Adampaleski/AmperaBattery/README.md

# Ampera BICM — Teensy 4.1

Clean restart for **Chevy Volt / Opel Ampera Gen1** BICM bench work on a **24S (4×6S)** pack.

Based on [Tom-evnut/AmperaBattery](https://github.com/Tom-evnut/AmperaBattery) documentation and lessons from prior Teensy 4.1 ports.

## Hardware

| Signal | Connection |
|---|---|
| BICM CAN | Teensy 4.1 **CAN3** — pin 30 RX, pin 31 TX @ 125 kbps |
| BICM transceiver | 3.3V SN65HVD230 (or TJA1051 / MCP2562) |
| Pack bus | K16 **X2**: pin 10 GND, 11 CAN_L, 12 CAN_H |
| Elcon CAN | Teensy 4.1 **CAN2** — pin 0 RX, pin 1 TX @ 250 kbps (29-bit) |
| Elcon transceiver | **Second** SN65HVD230 (required; CAN1 22/23 collides with OUT5/OUT6) |
| Kelly KLS8080 NPS | **Same CAN2** @ 250 kbit — IDs `0x0CF11E05` / `0x0CF11F05` (RX; see docs/KELLY_CAN.md) |
| Hub UART (ESP32) | **Serial4** pin 17 TX / 16 RX — not pins 0/1 |
| Contactors | OUT1/pin11 = main+, OUT2/pin12 = Volt AEV14012 precharge, OUT4/pin21 = main− (FET gates) |
| Termination | 120 Ω at one end of each bus |

Do **not** connect pack 5V (X2 pin 9) to Teensy I/O.

## Build / flash

```bash
cd ~/Documents/PlatformIO/Projects/ampera-bicm-teensy41
pio run -e teensy41_sniffer
pio run -e teensy41_sniffer -t upload
pio device monitor -b 115200
```

BMS build: the old `teensy41_bms` env was deleted (chief review #1: it closed Main+ on a blind precharge timer).
Vehicle builds are `teensy41_dual_a` / `teensy41_dual_b` (telemetry-only by default; every output off).

## Serial commands

| Key | Action |
|-----|---|
| `c` | Toggle candump (every frame: `ms,id,dlc,bytes...`) |
| `s` | Print CAN ID histogram |
| `r` | Reset sniffer counters |
| `k` | Toggle keep-alive TX (`0x200` @ 1 Hz) |
| `d` | Print decoded module/cell voltages |
| `b` | Print would-be balance `0x300`/`0x310` |
| `e` | Toggle dead-man (starts/aborts contactor sequence; dry-run when flag=0) |
| `p` | Print contactor state + intended vs driven pins |
| `g` | Toggle charge request (prints would-be Elcon `0x1806E5F4`) |
| `y` | Kelly CAN2 RX status (frame counts + raw; unpack FLAG=0) |
| `j` | Print one STATUS_SCHEMA v1 JSON frame on USB (Serial4 also emits ~1 Hz) |
| `h` / `?` | Key summary page |

Hub link: **Serial4** emits STATUS_SCHEMA v1 JSON @ 115200 (~1 Hz) for the teryx-ev-hub ESP32 gateway. USB stays quiet except boot note and optional `j`.

## Saturday bench (36S)

See **[`docs/BENCH.md`](docs/BENCH.md)** — flash `teensy41_k112_36s`, wiring minimum, expected caps, `b`/`e`/`p`/`g` print-only, Serial4 hub JSON. Do not flip capability flags (still 0).

## Bench validation

With BICMs powered on X2:

1. Flash `teensy41_sniffer`, open monitor — expect JSON lines with `last_rx_age_ms` &lt; 500 within a few seconds.
2. Press `S` — expect IDs in `0x460–0x47F`, `0x470–0x47F`, `0x7E0–0x7EF`.
3. Press `K` to turn keep-alive **OFF** — traffic should stop within a few seconds; `K` again to restore.
4. Press `d` — expect `modules=4 cells=24 stable=Y` after ~3 s of good traffic.

Scripts: `scripts/monitor.sh`, `scripts/bench_checklist.md`.

## Reference

- [`docs/Volt_BMS.dbc`](docs/Volt_BMS.dbc) — cell/temp scaling
- [`docs/WIRING.md`](docs/WIRING.md) — CAN2 Elcon 250k + contactor FET map
- [`docs/SAFETY.md`](docs/SAFETY.md) — capability flags stay 0
- [`docs/KELLY_CAN.md`](docs/KELLY_CAN.md) — KLS8080 NPS on shared CAN2 (not serial)
- Upstream wiring: AmperaBattery README (K16 X1 = 500k BECM, X2 = 125k BICM)

## Vehicle hub / install docs

Tablet PWA, install wiring, and status schema v1 live in a separate repo: [`Adampaleski/teryx-ev-hub`](https://github.com/Adampaleski/teryx-ev-hub) (not merged into this firmware tree).

## Factory-bus build and assumptions

- **[`docs/FACTORY_BUS.md`](docs/FACTORY_BUS.md)**: the `teensy41_factory_bus` env, its map and flags, the LOW-LIVE diagnostic, the hub JSON additions and the bench checklist (watchdog stall, temp warm-brick, Elcon 1 A test).
- **[`docs/ASSUMPTIONS.md`](docs/ASSUMPTIONS.md)**: everything assumed so far (Elcon range, M2 = 12S, temps unverified, 2 s watchdog, 3 s stale, 4.10/4.12 V, balance map unverified).
