Adampaleski/AmperaBattery/BACKLOG.md

# Backlog

## Path to first drive (crew review 2026-10-22) — the ONLY CRITICAL items; everything else is LATER
Tag `[CRITICAL sN]` = CRITICAL, checklist section N (0 gates, 2 shop, 3 buy, 4 firmware/design, 5 bench). Chief: trim CRITICAL to ≈20 that truly block first drive. Moved to LATER: brake-to-wake, phone-key lock, synthetic neutral, Snow/Mud/Sand modes, proportional (analog) regen.
- [ ] [CRITICAL s0] Gate 0 — 12 V bench (chief): flash on 12 V only; link fault < 200 ms; Kelly config readback: Boost OFF, High Pedal Disable ON, Foot_SW + 3-gear (F/N/R) behaviour, OV cutoff ≈160 V (PROPOSED value, read back and record).
- [ ] [CRITICAL s0] Gate 1 — sensors (chief): BICM cells within 10 mV of a meter; temp / ID mapping; LEM zero at 2.5 V + dead-LEM detect; pedal tracks; park contacts; e-stop NC2; brake override; clamp kill-A / kill-B test with the Kid (Low) cap engaging when unpowered.
- [ ] [CRITICAL s0] Gate 2 — one string, wheels up (chief): precharge to 95 %; e-stop; weld check; precharge timeout; turn the safety flags on one at a time. First HV power-up one string at a time (Sparky). Wheels-up bench tests on 1 string with Kelly #11 Battery_Current at 25 % of 550 A (≈138 A, ≈3C on one ~45 Ah string) — DECIDED (chief 2026-10-23; % re-based to the 550 A KLS8080 NPS by Sparky 2026-10-23, was 22 % of 600 A).
- [ ] [CRITICAL s0] Gate 3 — strings (chief): add strings one at a time; each string must be within 0.5 V of the bus before its fuse goes in (DECIDED chief 2026-10-23, supersedes the earlier 1 V figure). 2 strings for first drive, strings 3 and 4 one at a time after Gate 4; spin; regen direction; coolant flow; fan at 40 °C; 12 V alarm; HV leak detection.
- [ ] [CRITICAL s0] Gate 4 — first drive (chief): on 2 strings with Kelly #11 Battery_Current at 49 % of 550 A (≈270 A) — DECIDED (chief 2026-10-23; % re-based by Sparky 2026-10-23, was 45 % of 600 A); Kid / Low mode, 10 mph, flat ground, spotter. Then add strings 3 and 4 one at a time (0.5 V rule).
- [ ] [CRITICAL s3] Mechanic shop order 1: 1/0 HV leads + crimper (needs Adam OK, never buy).
- [ ] [CRITICAL s3] Mechanic shop order 2: bus bar + insulated standoffs + tool-to-remove cover with captive screws; 4 A6T200 bolt direct (no fuse holders), all reachable from one side; any holder at pack voltage > 160 VDC (needs Adam OK).
- [ ] [CRITICAL s3] Mechanic shop order 3: EV200 mounts + HV component plate (needs Adam OK).
- [ ] [CRITICAL s3] Mechanic shop order 4: e-stop parts: Harmony XB4/XB5 40 mm twist-release head (XB4BS8442 includes 1 NC) + 2 extra Schneider ZBE102 NC blocks + IP65 guarded box (needs Adam OK). Block 1 SOURCED/OK; block 2 pending KSI draw.
- [ ] [CRITICAL s3] Mechanic shop order 5: Kelly coolant loop + fan relay (needs Adam OK).
- [ ] [CRITICAL s3] Mechanic shop order 6: chain guard + tensioner (needs Adam OK).
- [ ] [CRITICAL s3] Mechanic shop order 7: pack tie-downs, grommets / loom, ground straps (needs Adam OK).
- [ ] [CRITICAL s3] Mechanic shop order 8: sealed Teensy enclosure + Hall pedal bracket (needs Adam OK).
- [ ] [CRITICAL s2] Measure before ordering (Adam): 1/0 lead run lengths (string → A6T200 on the bus bar → EV200 → Kelly), bus bar span + stud size, EV200 / HV plate footprint, chain line + guard clearance, tie-down points, grommet hole diameters, ground-strap runs, Teensy enclosure size, Hall pedal mounting / travel. List per Mechanic's hardware; dimensions UNVERIFIED until measured.
- [ ] [CRITICAL s4] Branch fuses (Sparky): DC-DC branch fuse 15–20 A; Elcon output fuse 1.25 × max charger current, ≥ 250 VDC rated.
- [ ] [CRITICAL s4] LEM zero offset (Sparky): store the zero-current offset; fault if the reading is > 5 A off at zero current. Zero stored by `Z` (Settings); > 5 A check = LemHealth ZERO self-test (logic done 2026-10-22, not wired).
- [ ] [CRITICAL s4] HV leak / isolation detection (Sparky): add before Gate 3.
- [ ] [CRITICAL s3] Insulated wrench for pulling the string fuses (crew 2026-10-22; needs Adam OK).
- [ ] [CRITICAL s4] E-stop latch (crew 2026-10-22): when block 3 (NC to Teensy B) reports open, drop every coil driver and latch until a key-cycle reset; releasing never closes anything. Logic + test done (include/EstopLatch.h, scripts/test_estop_latch.cpp 7/7); wire into the coil gate when BMS_CAP_CONTACTOR_DRV is enabled, then bench: press, release, unplug block 3 wire. Adam meters Kelly KSI draw (expected < 0.2 A).
- [ ] [CRITICAL s3] Insulated boots / covers on every HV terminal (Sparky): the string side of each A6T200 stays LIVE with the fuses pulled.

- [ ] [CRITICAL s2] Wire S42/S43 KEY-ON -> A:34 / B:34 (opto, 10k pull-up, LOW = key on; PROPOSED, Sparky 2026-10-22) and S41/S44 plug-in detect -> A:33 / B:33 from the ONE shared LM339 (see the next lines; LM339 DECIDED chief 06:57 #1). Key source = stock key switch output (colour UNVERIFIED). Bench: idle 3.3 V, active <0.4 V.
- [ ] [CRITICAL s2] Backprobe the stock Teryx key switch switched output (S42/S43 source, fed from the TDC-JH 12 V bus): 0 V key off, 12 V key on; record the wire colour (UNVERIFIED) in PINMAP. Fuse it with its own 1 A fuse (Sparky 2026-10-22) before tapping it to the optos.
- [ ] [CRITICAL s2] Wire the plug-in + release detect with ONE LM339 for both boards (Adam t284; LM339 re-pin DECIDED chief + Sparky 2026-10-23 06:57; wiring page "Charge plug-in + release detect"): NACS inlet proximity (S45; ~150 Ω latched or ~480 Ω button pressed = plugged, open = not plugged) -> one network: 330 Ω pull-up to the shared 5 V and 2.7k to GND -> one 10k/20k divider (S46) -> IN+ of all four channels (pins 5, 7, 9, 11). Plug: 2.5 V reference to IN1−/IN2− (pins 4 and 6, S48); OUT1 (pin 2) -> A:33 with its own 10k pull-up to A 3.3 V (S41); OUT2 (pin 1) -> B:33 with its own 10k pull-up to B 3.3 V (S44). Release: 1.40 V reference (10k/3.9k, S53) to IN3−/IN4− (pins 8 and 10); OUT3 (pin 14) -> 1k -> A:2 (S51), OUT4 (pin 13) -> 1k -> B:35 (S52), each with its own 10k pull-up + 100 nF. LM339 VCC (pin 3) from the shared 5 V (S47), GND (pin 12) to the single-point ground (S49). No hysteresis resistors: 100 nF + 20 ms debounce (DECIDED Sparky 06:57 #3). Plugged = A:33 and B:33 LOW = drive blocked on BOTH boards, like park; plugged but not latched = stop charger over CAN + open AC contactor. Firmware: set A:2 INPUT (boots as output) — later commit, no flashing.
- [ ] [CRITICAL s3] BUY — pending purchase approval (Adam), NOT owned: 1x LM339 + the network parts for ONE plug + release detect circuit: 330 Ω, 2.7k, 10k + 20k divider, 2.5 V reference (10k/10k), 1.40 V reference (10k/3.9k), 4x 10k output pull-ups, 2x 1k release series, 100 nF decoupling + 4x 100 nF at A:33/B:33/A:2/B:35. No hysteresis resistor (DECIDED Sparky 06:57 #3). Nothing is bought without Adam's OK.
- [ ] [CRITICAL s2] Bench: plug and unplug the NACS connector (latched and button pressed) and confirm drive is blocked on BOTH boards; then an open-wire test on the proximity line.
- [ ] [CRITICAL s2] Mechanic: mount the 50 Ω/100 W precharge resistor (H08) on the HV panel aluminum backplate with thermal paste, away from the loom.
- [ ] [CRITICAL s4] Firmware: read KEY-ON (A:34/B:34) and plug-in (A:33/B:33) into BmsCore wake/plugIn (plugged = no drive on both boards, like park), replacing the serial `e` dead-man (chief #4). Pins only in PINMAP so far.
- [ ] [CRITICAL s4] Precharge + weld check via Kelly CAN B+ (room DECIDED 2026-10-23: chief + Sparky + crew; replaces the isolated HV_SENSE on A:24, AMC1311 DROPPED for now; docs only, firmware NOT changed in Build 18): bus side = Kelly CAN B+, pack side = BICM cell sum. (a) Close Main+ only when Kelly B+ >= 95% of the BICM sum AND the minimum precharge time has passed; time alone never closes it. (b) A stale (>200 ms) or missing Kelly frame = precharge FAIL: mains open, fault. (c) Sequence (chief DECIDED 2026-10-23; KSI open item RESOLVED: e-stop block 2 only passes power, the Teensy drives the precharge coil separately, so KSI comes on first): 1) key on, KSI on; 2) a fresh Kelly B+ frame reads ~0 V (else Main+ welded); 3) close Main- alone, B+ still ~0 V (else Main+ welded); 4) precharge; 5) close Main+ only when B+ >= 95% of the BICM sum AND the minimum time has passed (a Main- weld shows up when Main+ closes). Second layer: key-off check (open Main+, hold KSI ~3 s; B+ still tracking the BICM sum = welded). Firmware TODO (needs chief + Sparky + Mechanic): PrechargeGate already has the 95% + min-time rule, but its bus input is HV_SENSE (HV_ANALOG_ENABLE=0 -> always FAIL today); it must take Kelly B+ with the 200 ms staleness rule. All UNVERIFIED until the bench gate below.
- [ ] [CRITICAL s4] Kelly B+ bench gate (room DECIDED 2026-10-23, all UNVERIFIED): (1) B+ is reported within ~1 s of KSI even while the Kelly low-voltage error is active; (2) frames arrive at least every 100 ms; (3) B+ within ~2% of a meter across a 0-150 V precharge ramp; (4) B+ reads ~0 with the mains open, not a held stale value. (5) the Kelly boots and sends frames on 12 V KSI with HV absent. If ANY check fails, the isolated sensor comes back: AMC1311EVM (~$50, purchase needs Adam OK). A:24 = reserved spare until then. Isolation monitoring stays its own separate CRITICAL item.
- [ ] [CRITICAL s4] Contactor coil gate-drive bench gate (crew 2026-10-23, UNVERIFIED): each contactor coil — AEV14012 precharge, EV200 main+ and EV200 main− — must pull in fully when its IRLB8721 low-side FET is driven straight from a Teensy 3.3 V pin (the IRLB8721 datasheet only rates RDS(on) at VGS 4.5 V and above). Measure coil voltage / FET drop at pull-in on 12 V. If any coil fails to pull in fully, add a gate driver or logic-level FET rated at 2.5-3.3 V (PROPOSED, no purchase without Adam's OK). IRLB8721 count owned: UNVERIFIED until Adam answers.
- [ ] [CRITICAL s2] Kelly programming check (Adam): controller model SOURCED (Adam 2026-10-23) from his purchase email = KLS8080 NPS, 168 V, 550 A, all add-ons incl. high-speed and anti-slip — no Kelly nameplate photo needed (closes chief review gap 9; Sparky re-based #7/#10/#11). READ back and confirm before writing: #60 sensor type = 4 sin/cos (motor sensor sin/cos SOURCED; setting UNVERIFIED), #7, #10, #11. Motor nameplate still OPEN for Adam: pole count (#59) and thermistor type (#63).
- [ ] [CRITICAL s5] Manual megger / insulation check HV-to-chassis on every string before its first HV power-up (chief full review gap 8): the insulation tester is not chosen; this is the minimum until isolation monitoring is fitted.
- [ ] [CRITICAL s4] Plug detect second source (chief full review gap 11): Elcon charger CAN status alive = drive blocked, so one LM339 losing 5 V (reads "unplugged") can't allow a drive-away. No new parts.
- [ ] [CRITICAL s4] Design the K02 Foot_SW "both Teensys alive" relay (chief full review gap 13): Kelly pin 11 is 40 mA max, so the series heartbeat contacts need a relay/driver; e-stop block 3 pin (B:9) is PROPOSED only.
- [ ] [CRITICAL s4] Written safety-flag flip order (chief full review gap 19): one flag at a time (CONTACTOR_DRV, KELLY_LIMIT_DRV, KELLY_RX, TEMPS_VERIFIED, CURRENT_SENSE …), each with its own bench test + key-cycle test, before TELEMETRY_ONLY goes to 0.

## CRITICAL: chief firmware review cd7027f (2026-10-22) — TODO, NOT implemented in this task
Source: /workspace/teryx/review/firmware_review_chief.md (the review lists 10 CRITICAL items; the request said 9, all are carried here).
- [x] [CRITICAL s0] Chief review #1: ContactorSeq.cpp:367 single-string env with HV_ANALOG_ENABLE=0 closes Main+ on a blind 5 s precharge timer: must fault; fence/delete `teensy41_bms` env. (env DELETED 2026-10-22; ContactorSeq.cpp:367 timer-close path still to make a fault.) DONE 2026-10-22: timer path removed; include/PrechargeGate.h (bus >= 95% of valid pack after 200 ms, else fail at 5 s -> RetryWait 30 s, 2 retries, Lockout); scripts/test_precharge_gate.cpp.
- [x] [CRITICAL s0] Chief review #2: ContactorSeq.cpp:226 + Settings.cpp:170/165: serial `U` / `I` sim inputs feed the real precharge gate / force currentValid; compile out when TELEMETRY_ONLY=0. (DONE 2026-10-22: BENCH_SIM_INPUTS=0 default, bench_30s/2x30s only, #error with TELEMETRY_ONLY=0; scripts/test_review_fixes.py.)
- [ ] [CRITICAL s0] Chief review #3: ContactorSeq.cpp:288-312: lemA/lemB/valid never set; BmsCore.h:186-189 defaults valid=true, so dead-LEM, >60 A disagree and 400 A per-sensor trip can never fire. Default valid=false. PARTLY DONE 2026-10-22 7 PM: BmsCore Inputs lemAValid/lemBValid now default false; ContactorSeq sets lemAValid/lemBValid/lemSplitValid=false explicitly (fail closed: with CURRENT_SENSE_ENABLE=1 the Low cap holds until real per-LEM health is wired); 3 checks in scripts/test_review_fixes.py. Still open: feed LemHealth per Teensy + LEM B over the link so the checks can actually fire.
- [ ] [CRITICAL s0] Chief review #4: ContactorSeq.cpp:302: key-on is serial `e` only; no KSI, e-stop NC2, park or plug-in input fed to BmsCore.
- [ ] [CRITICAL s0] Chief review #5: EstopLatch.h not called anywhere in src/.
- [ ] [CRITICAL s0] Chief review #6: Brake-overrides-throttle >0.5 s not in firmware (sim only).
- [ ] [CRITICAL s0] Chief review #7: KellyLink.h / LemHealth.h not wired (BMS_CAP_KELLY_RX 0); non-Kid modes uncapped when speed lost.
- [ ] [CRITICAL s0] Chief review #8: TEMPS_VERIFIED=0: drive has no overtemp, derate or TEMP-STALE. Verify temps, set 1 before first HV drive.
- [ ] [CRITICAL s0] Chief review #9: ThrottleTrim.cpp:76 + Config.h:213: raw ADC/1023 pedal, no travel calibration, half-scale track 2 would trip DISAGREE, no open/short detect, 4.5 V reads ~88 %.
- [ ] [CRITICAL s0] Chief review #10: ThrottleTrim.cpp:5-6: MCP4131 digipot powers up at mid-scale (50 %) until begin(), and coil gate pins float from reset until setup() (main.cpp:233-240): the 74HC4066 clamp + 100k Kelly pull-down (Gate 1) and the 10k gate pull-downs on pins 11/12/21 + pin 20 relay driver (Gate 0) MUST be bench-proven.
- [ ] Chief review should-fix (before flags go to 1): ADC re-entrancy (ThrottleTrim ISR vs CurrentSense loop analogRead); ThrottleCross 5 %/50 ms vs agreed 10 %/100 ms; `MX` clears latched throttle fault without key cycle; corrupt DriveStore drops out of Kid / loses PIN (fail to Kid/Low); no 12 V low alarm; tickDual skips enter() (partial bench logs); pin 4 = B_FAULT_OUT on B and A_THR_ALIVE on A (stated in docs/PINMAP.md); commit the BMS-settings edits (done, Build 10) — THR2 resets saved thresholds on first boot.

## Priority list (standing dev routine)

1. [x] Tesla-style restyle + live Diagram tab in tools/bms_sim.html (034a3ae).
2. [ ] Kelly power/regen cutback wiring design + simulator controls.
   - [x] 2026-10-19 7 PM: Drive tab (allowance, limiter, regen, OUT3/OUT5/OUT6 lines, three cutback curves, sliders), BmsCore kellyWhy/regenWhy, 6 Kelly cutback checks in sim_bms, docs/KELLY_CUTBACK.md.
   - [x] DECISION (Adam, 2026-10-20): hard trip at 650 A for 100 ms or 750 A instantly on LEM A + LEM B, replacing 300 A/500 ms and the 250 A derate. Kelly phase + battery limits 550 A.
   - [x] 2026-10-20 7 AM: trip in BmsCore (overcurrentA 650 / 100 ms, new instantTripA 750, logs `OC instant`); 250 A discharge derate off (maxDischargeA 0). Scenarios: 700 A trips at 110 ms, 800 A spike trips in one 10 ms step (18/18). 6 boundary checks (600 A 3 s, -640 A, 700 A 80 ms, 745 A 90 ms stay closed). Drive tab: current-trip chart with 550/650/750 lines, sliders to 800 A. Sim only; CURRENT_SENSE_ENABLE 0.
   - [x] 2026-10-20 10 AM: derates in BmsCore: LEM imbalance |A − B| > 100 A for 1 s → warn + cap at imbalancePct (50 %, PLACEHOLDER), clears under 100 A; cell sag 3.2 → 3.0 V linear ("cell sag"); heat unchanged (only with valid temps). Inputs lemSplitValid/lemA/lemB, outputs lemImbalance/lemDiffA. 9 derate checks. Drive tab: LEM split slider, what-if low-cut slider, combined low-cell + sag chart, LEM imbalance chart. Sim only.
   - [x] DECISION (Adam, 2026-10-21): cell sag is relative (weak cell vs pack average), whole-pack sag judged against load, only a low hard floor that trips if voltage stays down briefly.
   - [x] 2026-10-21 7 AM (b2ba63c): in BmsCore. Weakest cell 0.15 → 0.40 V below pack average = "cell sag" 100 → 0 % (any load). Under load (|I| > 20 A) a uniform sag skips the low cut; pack-average taper 3.10 → 3.00 V ("pack sag"). Hard floor 3.00 V for 500 ms → CELL-LOW. 3.30 V low cut only at rest, debounced 1 s (no instant fixed cut; no current reading = rest). All PLACEHOLDER in Config. Drive tab: relative-sag chart + pack-sag/rest chart. 12/12 derate checks; cell-low scenario now 1 s. Gist rev b5b0cfe8.
   - [ ] Adam/Sparky: confirm the placeholder numbers (0.15/0.40 V below avg, 3.00 V floor 500 ms, 1 s rest debounce, 20 A rest) against Volt cell data; pick the imbalance cut level (placeholder 50 %).
   - [x] 2026-10-21 10 AM: derate events. BmsCore DerateCode (low cell / pack sag / cell sag / pack hot / LEM imbalance / discharge amps), debounced events (hold 100 ms to log, 1 s full power to clear, reason changes logged; PLACEHOLDER), outputs derateCode/lastDerate/derateMinPct/derateEvents. FaultLog kinds 4/5 (DerateSet value = power %, DerateClear value = lowest %), derates capped 12/boot so faults keep room. Sim: Fault log card shows DERATE rows (amber), Drive tab shows count + last reason. 3 derate-event checks (15/15), 2 FaultLog host checks (12/12), 2 faultlog-page wasm checks (8/8). docs/FAULT_LOG.md. Firmware still doesn't write FaultLog. Commit "derates logged as events", gist rev a505e09a.
   - [x] 2026-10-21 1 PM: thresholds adjustable over serial. include/Thresholds.h: 20 keys (trip, temps, sag, LEM imbalance, derate logging), `T` list / `T<key> <v>` / `T<key> -` / `TX`, bounded, trips + temp cuts tighten-only, order rules, EEPROM 1216 after FaultLog with CRC. Applied in configureCore (role A). Fixed: P80/Z/I never started a settings line. 9 host checks (scripts/test_thresholds.cpp), docs/THRESHOLDS.md. Not bench-tested; sim page unchanged.
   - [x] 2026-10-21 4 PM (62db3e9): Simulator: same threshold table editable in bms_sim.html (wasm), so Adam can try values; dash "last derate" in the fault/trip panel. Settings tab "BMS thresholds" card: all 20 keys with value, default, allowed range, lower-only/raise-only, SET, PLACEHOLDER; type + Enter to apply, per-key Reset, Reset all (TX). Validation is the real include/Thresholds.h in wasm (sim_thr_set -> handleLine), refused edits show the firmware's reason (+ tighten-only note). Applied live into the sim BmsCore like configureCore, saved on simulated EEPROM 1216-1305 + localStorage (survives Reset/Power cycle/reload); warns if L is later moved below floorV. Faults tab + dash Faults & log: derate now, last derate (reason + lowest %), count this boot. 8 thresholds-page wasm checks, 8 UI checks (57/57). Firmware unchanged. Gist rev 036ca1aa.
   - [ ] Temperature limits: use the more conservative of Chevy's or the EV community's numbers (Adam 2026-10-21); ask Sparky.
   - [x] 2026-10-21 7 PM: docs mismatch reconciled. TERYX_MAIN_POWER_PATH.md now says 50 °C start / 55 °C cut (matches BmsCore, KELLY_CUTBACK.md, TEMPS.md; the cut can only be tightened, max 55), both PLACEHOLDER pending the conservative Chevy-vs-community pick; its stale cell-sag line updated to the 2026-10-21 relative-sag design. Docs only; 12/12 envs build, 31/31 scenarios + trip/derate/soc checks pass.
   - [ ] Derate hardware: pick CD4066 vs MCP4131 and RC values; confirm KLS low-speed and regen input pins/polarity from Adam's harness (UNVERIFIED).
3. [ ] State of charge from the split Volt LEM DHAB S/44 pair.
   - [x] 2026-10-19 10 PM: include/SocEstimator.h coulomb counter (LEM A + B sum, + = discharge), full-charge anchor from Core "at charge limit" (P<100 tagged not true 100 %), restore hook, 2 s current-loss -> unknown, low-cut drift flag, learnCapacity(); 10 SoC host checks; docs/SOC.md. No OCV table (none verified).
   - [ ] Bank capacity Ah UNVERIFIED (capAh 0 = unknown): measure with one full -> low-cut run, then learnCapacity().
   - [x] 2026-10-20 1 PM: simulator SoC readout. sim/wasm_api.cpp runs the real BmsCore::Soc on the sim's LEM A + B each 10 ms tick (anchor from Core "at charge limit", 2 s current loss -> unknown, low-cut drift flag). Cluster tab Battery gauge shows the estimate + state (unknown/anchored/counting) + Ah used, "unknown until full-charge anchor" when unanchored, and sim truth vs estimate error. Buttons: Charge to limit (anchor), LEM dropout 3 s; cell drain toggle. Capacity 180 Ah labelled SIM-ASSUMED (real capAh still UNVERIFIED). 8 socpage wasm checks. Firmware unchanged.
   - [ ] Wire into BmsApp + STATUS_SCHEMA socPct (needs CURRENT_SENSE_ENABLE + split-LEM read).
     - [x] 2026-10-23 4 PM: LEM B link frame 0x6A5 (include/LemLink.h, B sends, A decodes fail-closed, `Link::remoteLemB()`), not consumed yet. Next: SocRun uses it (kHaveLemB) and ContactorSeq lemBValid, then bench.
     - [x] 2026-10-23 7 PM: SocRun sums LEM A + LEM B (both valid + fresh or the tick is current-lost, fail closed). Next: ContactorSeq lemBValid from the link, then bench.
   - [x] Persist used Ah + anchor at power-off (ties to item 5). Store DONE 2026-10-23 10 AM; wired into SocRun 2026-10-23 1 PM (see Done notes). Remaining gap: real KEY-ON / 12 V power-loss save (needs A:34 read + a loss detect).
4. [ ] Full drive-cycle mode in the simulator.
   - [x] 2026-10-20 4 PM (10ba99e): Drive cycle card on the Cluster tab. sim/drive_cycles.js profiles (SIM PROFILES, not logged data): Trail loop 125 s, Hard launches 5x, Long climb 10 min. Plays throttle/brake/gear into the existing driver-input model on any tab, auto key-on, stops early if mains open; live step + summary (distance from toy speed model, Wh out/regen, Wh/mi, peak discharge/regen A vs 650/750 trip, lowest cell, lowest power allowed + why, SoC change). 5 drivecycle wasm checks; headless page run of Trail loop completes. Gist rev 0f905bd5.
   - [ ] Next: record a real Teryx drive (Kelly CAN speed/current) as a replayable profile; add a heat/temps-valid profile once temps are verified; cycle results into the dash trip panel.
   - Note: in the Hard launches run regen showed 0 A near full charge (BMS blocks regen near the charge ceiling, expected); trail loop regen hit 60 A.
5. [ ] Fault log that survives power-off.
   - [x] 2026-10-20 7 PM: include/FaultLog.h (header-only, not wired into firmware). 48 x 20-byte records at EEPROM 256..1215 (Settings stays at 0; Teensy 4.1 EEPROM 4284 B per installed core). Seq + CRC-16 per record, no header: torn write skipped, blank = empty. Fault set/clear edges with boot no., uptime ms, one value. Wear limits: same edge max 1/s, 24 records per boot then 'log limit reached'. 10 host checks (scripts/test_fault_log.cpp), ARM compile check. docs/FAULT_LOG.md. Flash endurance UNVERIFIED.
   - [x] 2026-10-20 10 PM: simulator Fault log card on the Faults tab. Real FaultLog.h in wasm on a simulated EEPROM that survives Reset, Power cycle and page reload (localStorage); Power cycle / Pull power mid-write (torn record skipped) / Clear log buttons; records newest first with boot, time, set/clear, value (cell V or amps). 6 faultlog-page wasm checks. Firmware unchanged. be2106d, gist rev 8c570165.
   - [x] 2026-10-21 10 PM: wired into firmware. src/FaultLogRun.{h,cpp} (role A dual only, no-ops elsewhere): EEPROM.read/update store, BmsCore fault + derate edges each loop (same value rules as the sim), `f` prints newest first, `FCLEAR` + Enter erases. No pins touched. 12/12 envs build, 31/31 scenarios, trip 6/6, derate 15/15, soc 10/10, faultlog 12/12, thresholds 9/9. docs/FAULT_LOG.md. Sim page unchanged. NOT bench-tested.
   - [x] 2026-10-22 7 AM: STATUS_SCHEMA fault-log summary. Optional `faultLog` key in every hub frame (FaultLogRun::printJson from HubStatus): available/count/slots/boot/limited/deratesDropped + `last` (kind, name, boot, sec, value, unit) or null; `available:false` off role A. Read-only, no pins, no EEPROM writes. JSON host-checked (empty/fault/derate). docs/FAULT_LOG.md. 12/12 envs, 31/31 scenarios, trip 6/6, derate 15/15, soc 10/10. Sim page unchanged.
   - [ ] Next: add `faultLog` to teryx-ev-hub docs/STATUS_SCHEMA.md + mock + dash card (hub repo, feature branch only); bench power-pull test on a Teensy (Adam, when benching).
6. [ ] Tesla-style dash on the ESP32 hub (teryx-ev-hub, never main).
   - [x] 2026-10-20 (parent chat, 43a7c0c + c76fee2): standalone tools/dash.html + sim/dash.js (Digital/Analog/Minimal/Night, "—" + amber when no source, range/Wh/mi/trip, tell-tales, seat heater buttons, cooling PROPOSED). Simulator-side only; ESP32 hub port still to do.

## Other

- [ ] TODO (current sense sign): DHAB S/44 to be mounted so discharge reads in the −420 A direction, with regen/charge on the +230 A side. Firmware must flip the sign so discharge shows positive. Not done yet; CURRENT_SENSE_ENABLE stays 0. Range unverified until we have the datasheet. If it can't be mounted that way, fall back to a ≥500 A single-range LEM (e.g. HASS 500-S).
- [x] 2026-10-21: charge mode separate from key-on (BmsCore Mode/plugIn/chargerPath/chargeStop, 5 plug scenarios, crew review pending), sim vehicle model (sim/vehicle.js: throttle/brake/grade, wheel speed, motor RPM, brake = regen up to PROPOSED 60 A, fade < ~3 mph), dash charging screen with sleep/wake.
- [ ] Pick a proximity / charger-present input pin and wire `plugIn` in ContactorSeq (crew).
- [ ] (Optional) IVT-S 1000 A integration — dual LEM A + B is the primary sensing; ISA IVT-S is optional only: decide own CAN bus vs reconfigure to 250k; parser + DHAB cross-check (sim scenario 14 models it).
- [ ] Split-LEM firmware: read LEM A on Teensy A and LEM B on Teensy B, sign flip (discharge on −420 A side), share B's reading over the A–B link, port sim lemPair() pair-imbalance and sensor-fault checks into BmsCore. Thresholds (30%, 40 A, 100 A) are placeholders.
- [ ] HV path (2026-10-20, see docs/TERYX_MAIN_POWER_PATH.md): two main contactors, used TE EV200 on pack + and pack −. Volt AEV14012s only on charger/DC-DC/precharge branches.
- [x] String fuses: 4× Mersen A6T200 200 A Class T — FINAL, bought 2026-10-20 (shop log 10/20; docs/TERYX_MAIN_POWER_PATH.md). Supersedes the 10/17 A6T150 proposal.
- [ ] Strings: 36S each, built from 24S + 18S BICM boards (no 30S).

## Safety gaps (crew 2026-10-21) — TODO, NOT BUILT
Pack protection today uses the **BICMs (cell V/temps) and LEMs (pack A) only**. The Kelly CAN is telemetry, not protection.
- [ ] **REQUIRED BEFORE FIRST DRIVE:** charge-plug interlock. No drive while plugged in, and no charging below 0 °C or with stale/unverified temps (TEMPS_VERIFIED=0 today).
- [ ] **REQUIRED BEFORE FIRST DRIVE:** contactor weld check. Bus voltage vs pack with mains commanded open at key-off and before precharge (sim has a welded-contactor toggle; firmware not built).
- [ ] **REQUIRED BEFORE FIRST DRIVE:** isolation monitoring (HV to chassis). Part not chosen.
- [ ] **REQUIRED BEFORE FIRST DRIVE:** 12 V low alarm at 11.5 V (PROPOSED). Needs a 12 V sense divider pin.
- [ ] Service disconnect (crew 2026-10-22, replaces the Volt MSD): **pull all 4 Mersen A6T200 string fuses**. Key off, e-stop pressed, wait for the Kelly caps, remove the tool-only cover (captive screws), pull fuses 1–4 with the insulated wrench, meter bus B+ to B− = 0 V, boot the string-side studs (still LIVE). Volt MSD removed from the current path. **DECIDED (room: Sparky + chief, 2026-10-23 06:11 CT): no MSD in this build.** Fuse location label for the top-down layout view: "reachable from above, tool-only cover".

## Mechanical (Mechanic 2026-10-21) — TODO
- [ ] **REQUIRED BEFORE FIRST DRIVE:** Chain guard + chain tensioner (#50 chain, 16/32T).
- [ ] **REQUIRED BEFORE FIRST DRIVE:** Pack retention / tie-downs (straps/brackets), HV cable clamps, grommets at every pass-through.
- [ ] Enclosure sealing with a breather and a drain.
- [ ] Chassis ground straps: 12 V negative to frame, Kelly case to frame.

## 2026-10-21 park / Kelly / Low cap (this commit, CREW REVIEW)
- [x] Clamp review fixes: A heartbeat pin 4 (not CS), 4066 on shared 5 V, Kelly pull-down 100k + bench curve recheck.
- [x] Park detection: ParkState.h + sim; Foot_SW NC hardware interlock documented (docs/PARK_BRAKE.md).
- [x] Kelly CAN/regen research: docs/KELLY_CAN_ROLES.md; sim analog Brake_AN regen.
- [x] Kelly ECO fail-safe Low cap (OUT3 inverted: HIGH = release); Kid + both-Teensys-dead sim.
- [ ] Next: B → A park contact bit on the link; wire ParkState into ContactorSeq (precharge gate) and Selector (Kid); bench the Foot_SW / ECO behaviour.

- [x] 2026-10-21 crew review of b629bcf: park on direct pin 32 (A needs BODY_IO_EXPANDER), Brake_AN DEFERRED (switch regen default), Low cap only on hard faults with a 1 s ramp, docs/ESTOP.md + wiring aid e-stop page fixed, WIRING.md CAN_LAYOUT_V2 map.
- [ ] Before Brake_AN: read back the Kelly config (Brake Type, Boost OFF, BRK_AD/BRK_SW, Foot Switch, Three Gears/Speed) and save it in docs/.
- [ ] E-stop block 2 (pending): Adam meters the Kelly KSI draw (expected < 0.2 A); block 2 breaks ≈0.35 A AEV14012 + KSI. Block 1 SOURCED/OK (chief 2026-10-22: 0.26 A measured break < 0.5 A @24 V; 7.6 A inrush carried < 10 A Ith).

- [ ] REQUIRED BEFORE FIRST DRIVE: firmware dead-LEM detection. 2026-10-22 1 PM: logic + host test done (include/LemHealth.h, scripts/test_lem_health.cpp 18/18, docs/LEM_HEALTH.md): RAIL (within 0.2 V of 0/Vc or Vc bad, 100 ms), RANGE (>450 A), AGREE (<15 A, ch1 vs ch2 >5 A, 500 ms), ZERO key-on self-test (>5 A), latched until key cycle; all PROPOSED. Not wired (CURRENT_SENSE_ENABLE 0); next: run in CurrentSense::tick per Teensy, B's code over the link, set lemAValid/lemBValid, ZERO before precharge. Original: Read each LEM separately and flag one reading nothing or out of range (>450 A, PROPOSED) as a hard fault that engages the 10 mph cap. Today this check runs only in the sim. (chief, 2026-10-21)
- [ ] Dead-LEM detail (Sparky): each output should sit near 2.5 V at 0 A; within about 0.2 V of 0 V or 5 V = dead or disconnected (hard fault). Key-on self-test: below about 15 A, the low-range and high-range channels must agree.

## VCU safety items (Sparky VCU compare, 2026-10-21)
- [ ] **REQUIRED BEFORE FIRST DRIVE:** two-track pedal. Today ONE pedal wiper is read by both Teensys (A pin 40, B pin 41, same signal through two dividers; docs/THROTTLE_CLAMP.md), so a pedal fault looks identical on both. Fit a dual-output Hall pedal (two independent tracks, e.g. one track ×½): Teensy A reads track 1 and Teensy B reads track 2, each on its own pin (PROPOSED: keep A pin 40 / B pin 41, no shared wiper), with a plausibility check between the tracks (PROPOSED: > 10 % for 100 ms → throttle 0 + fault). Part not chosen.
- [ ] **REQUIRED BEFORE FIRST DRIVE:** brake overrides throttle: brake and throttle both pressed > 0.5 s → throttle cut to 0 until the pedal returns to 0 (PROPOSED). Partly covered: sim brake switch cuts throttle (sim/vehicle.js); Kelly "Brake H-Pedal" option (docs/KELLY_CAN_ROLES.md) is a config check. Firmware Teensy rule not built.
- [x] Precharge timeout — COVERED: dual-string precharge (Config.h kPcDualMinMs 300 / kPcDualTimeoutMs 3000 / ONE fail → PRECHARGE-FAIL lockout until key cycle, no auto retry (chief 2026-10-22; single-string aligned to 300 ms / 3 s); ContactorSeq, BmsCore F_PRECHARGE): main never closes unless the bus ≥ 95 % of the lowest string. Bench-verify on the Kelly (docs/BENCH.md).
- [ ] Direction change only at 0 RPM with the brake on (PROPOSED). Sim refuses R above 1 mph; no firmware rule yet (Kelly F/N/R readback on CAN 0x0CF11F05 b5, docs/KELLY_CAN_ROLES.md).
- [ ] **REQUIRED BEFORE FIRST DRIVE:** Kelly CAN timeout (> 200 ms, PROPOSED) → derate + fault (KELLY-CAN-LOST). Today stale Kelly CAN only makes Park false (include/ParkState.h); BMS_CAP_KELLY_RX=0. 2026-10-22 4 PM: logic + host test done (include/KellyLink.h, scripts/test_kelly_link.cpp 18/18, docs/KELLY_LINK.md): NEVER-SEEN (no frame 2 s after KSI), LOST (either frame > 200 ms stale, not hidden by boot grace), Low cap until both fresh 1 s, latched + loss count, parkTrusted() for ParkState; all PROPOSED. Not wired; next: hook into KellyDecode when BMS_CAP_KELLY_RX=1, FaultLog edges, sim "Kelly CAN unplugged" toggle.
- [x] EV200 coil economizer — COVERED by hardware: EV200HAANA has a built-in economizer + suppression (shop log 2026-10-20 06:31; docs/ESTOP.md hold ≈0.26 A). No extra circuit.
- [ ] **REQUIRED BEFORE FIRST DRIVE:** Kelly/motor cooling. First drive (chief full review 2026-10-23): hardwire the pump to key-switched 12 V and the fan to a thermoswitch or always-on, NO Teensy logic. Firmware cooling control (after first drive, LATER) from Kelly controller + motor temps (Kelly CAN): pump on with key (COOL_PUMP pin 8), radiator fan relay at ~40 °C (RAD_FAN pin 7), PROPOSED pins reserved in Config.h, not built; Kelly derates itself at 90 °C case (SOURCED manual).
- [ ] Brake-to-wake (PROPOSED, sim Build 2): brake held at full travel ≈1 s = key on (replaces a separate On switch); e-stop NC1 and the precharge/park rule still gate it. Needs a brake-position input that works while asleep (pin/part not chosen).
- [ ] Decide: PIN to drive (UNDECIDED; sim option, off by default; uses the Kid PIN hash).
- [ ] Hall pedal spec (Sparky): track 2 at half scale (e.g. 0.5-4.5 V and 0.25-2.25 V). Both tracks go through 10k/18k dividers (4.5 V reads 2.89 V at the pin). Compare the tracks as % of travel, not raw volts.

## Build 4 (Adam's Build 2 testing, 2026-10-22) — sim/dash only, firmware unchanged
- [x] Brake-to-wake feedback: "Hold brake… waking", then "Waking — precharging"; a refusal names the reason (parking brake released / park contact fault). Root cause: every sim toast went to an undefined `dashToast`, so refusals were silent. UI test drags the dash brake slider.
- [x] Kid: entering asks no PIN (parked only); first time with no PIN set, a one-time "Set Kid exit PIN" pad (keeps firmware NO_PIN_SET rule). Leaving Kid = modal PIN pad (digits, ⌫, Cancel, Enter, keyboard, wrong-PIN shake). Old text box removed.
- [ ] Phone-as-key (PROPOSED): no Bluetooth phone key → PIN pad before any drive setting (modes, thresholds, limits); key off → drive settings locked; Night/dim stay unlocked. Sim toggle "Phone key present". Decide: BLE module + pairing, which PIN (sim reuses the Kid PIN hash), firmware mirror.
- [ ] Synthetic neutral: N = Kelly zero throttle + no regen (freewheel), no mechanical decoupling; motor still spins, so back-EMF and overspeed limits still apply. Kelly "Three Gears Switch: Forward, Neutral, Reverse" (item 90) and NTL Brk default 0 (item 45) SOURCED; "neutral = FWD and REV pins both open" UNVERIFIED, bench it on the Kelly before relying on it. Sim + dash show N; Parked = park brake + 0 RPM + N.

- [ ] Bench IRLB3813 coil drivers at the Teensy gate level: datasheet specifies RDS(on) at 4.5 V and 10 V only (VGS(th) 1.35–2.35 V, Ciss 8420 pF); confirm the EV200/AEV14012 coils pull in fully. IRLB8721 is discontinued.

## Later
- [ ] [LATER] Spare inputs IN2/IN3/IN4 (Config.h Pins, all -1 today): deferred until after first drive (chief 2026-10-22). Checked: none of chief review CRITICAL #1-#10 or the Path-to-first-drive items needs IN2-IN4 (key-on / plug-in / e-stop / park get their own pins). Needs pins freed first (no free GPIO on A).
- [ ] Odometer that survives power-down (EEPROM, wear-leveled) plus hour counter (key-on hours and drive hours). Requested by Adam; do not implement until after first drive. (LATER / after first drive)
- [ ] [LATER] Guided Install mode on the wiring page (queued right after Build 18; Adam approved 2026-10-23): a step-by-step bench guide driven by docs/PINMAP.yaml. Back and Next steps, the active wire highlighted and everything else dimmed to about 15 %, auto-zoom to that wire, a step card (gauge, color, ends, fuse, datasheet link, photo slot), inline PASS/FAIL meter checks where a test belongs, resume progress, and an exported log. Low-voltage first; high voltage only after the crew signs off on the order. Physical routing notes come from Mechanic. (LATER, not built)
- [ ] [LATER] Guided Install, queued item — Coil-driver board section: diagram of the FETs (IRLB8721 x3 on A:11/A:12/A:21, S01-S03), flyback = ONE 1N4007 (D-PRE) at the AEV14012 coil only, cathode to +12 V, no zener; EV200 coils get NO external diode (DECIDED Sparky 2026-10-23 05:41), 100 Ω gate resistors and 10k pull-downs, F-COIL; parts from docs/PARTS.yaml part id coil_driver (clickable in the wiring diagram); step-by-step perfboard/PCBWay build per Sparky; PASS/FAIL checks. Guide now in the repo: docs/guided_install/coil_driver.md (Build 19); perf-board layout docs/boards/coil_driver.layout.json (Build 20, PROPOSED). Still open: wire the guide into Guided Install mode.
- [ ] [LATER] Electric park brake actuator on the park-brake cable (crew design in progress; NO pins reserved, chief 2026-10-23). Actuator Glideforce LACT4P-12V-20 (110 lb), PROPOSED, sized after Adam's luggage-scale pull test on the park cable, which is the gate (step up if the pull is more than about 60 lb). Self-locking lead screw: bench-verify it holds with power cut. Foot pedal kept, linked in parallel via a slotted link or cable splitter. A third BTS7960 driver on Teensy B or an expander, 10 A fuse, 14 AWG; current stall detection plus a position pot on 3.3 V. Sparky's rules: apply only at about 0 mph, throttle 0 and key on; release only with key on, no fault, plug disconnected and brake pressed; it never moves on its own at key-off or on Teensy death; the park switch stays the source of truth. Key-off auto-apply DECIDED (chief 2026-10-23): it auto-applies at key-off only while still powered, with 0 mph and Kelly 0 RPM confirmed before and during the move, never on a Teensy failure, and it only chimes if those conditions are not met. Phone walk-away auto-apply is LATER (separate decision). The Build 18 sim forgot-Park light + chime is unaffected (warning only, never moves anything). (LATER/PROPOSED, not built)
- [ ] [LATER] MOTOR_FAN (Build 18 pin reservation only, no logic): 12 V fan across the air-cooled Zero 75-7R via relay coil, low-side IRLB8721 + 10k gate pull-down + 1N4007 (same style as RAD_FAN on A:7). Reserved on the MCP23017 body expander bit 14 (GPB6), PROPOSED: Teensy A has no free edge pin. Future trigger: Kelly CAN 0x0CF11F05 byte 2 motor temp (KTY into Kelly Temp pin 1); on-threshold TBD. (LATER/PROPOSED)
- [ ] [LATER] PACK_HEAT — NOT reserved in Build 18 (chief full review 2026-10-23: it adds a new HV circuit, drop it from Build 18 entirely; MCP23017 bit 15 stays free). Design notes kept for after first drive: Idea: reuse the stock Volt heater (≈360 V part, ≈15 % of rated heat at ≈140 V, UNVERIFIED); heater type/part TBD. Future logic: only while plugged in and below a set temperature, never while driving; PROPOSED hardware interlock so its 12 V coil feed exists only when plugged in. HV fuse + contactor rating TBD with Sparky. (LATER/PROPOSED)
- [ ] [LATER] BUZZER (Build 18 placeholder): real 12 V buzzer/chime for the dash master alert. No free Teensy A pin; reserved on MCP23017 bit 13 (GPB5), PROPOSED, only if Adam counts expander bits as A outputs. Today the alert chime is WebAudio on the dash only. (LATER/PROPOSED)
- [ ] [LATER] Firmware PIN to Drive (after first drive; sim-only in Build 18, firmware NOT changed): port the Build 18 gate (drive allowed = PIN to Drive off OR phone nearby now OR PIN entered this key cycle, live, never latched). Default PIN: DECIDED (Adam 2026-10-23) = 0000 with a "change your PIN" reminder, NO forced first-time setup; supersedes the firmware NO_PIN_SET rule (include/DriveProfile.h). Needs chief + Sparky + Mechanic agreement and Adam's OK to flash. (LATER, rule DECIDED)
- [ ] Creep + hill hold for Kid mode (PROPOSED): low creep torque from 0 and hold at 0 RPM on a slope (Kelly Anti-Slip item 97 SOURCED as an option, UNVERIFIED on his unit) — not built.

- [ ] [LATER] Tool-free service disconnect (Sparky), does not block first drive. Room 2026-10-23 06:11 CT: this build has no MSD; the service disconnect is pulling all 4 A6T200 string fuses with the insulated wrench under a tool-only cover.
## Done notes (appended so open-item line numbers above stay stable)
- [x] 2026-10-22 10 AM (item 3, wiring step): src/SocRun.{h,cpp} runs the real SocEstimator in firmware (role A dual only, no pins, no EEPROM): CurrentSense amps + Core "at charge limit" anchor + Settings P/L. `p` prints a SOC line. Hub frame: `socPct` now comes from SocRun (still null: LEM B not shared over the link, so the count is half the bank, and capAh 0 UNVERIFIED) plus an optional read-only `soc` object (known/state/usedAh/pct/drift/why/halfBank/capAh). 5 host checks (scripts/test_soc_run.cpp + scripts/hoststub). 12/12 envs, 31/31 scenarios, trip 6/6, derate 15/15, soc 10/10. Sim page unchanged. Still open (line 24): CURRENT_SENSE_ENABLE + LEM B over the link, then socPct goes live.
- [x] 2026-10-22 7 PM (chief #3, fail-closed step): LEM A/B validity defaults false in BmsCore and is set false explicitly in ContactorSeq until LemHealth is wired. Firmware behaviour today unchanged (CURRENT_SENSE_ENABLE 0). 11/11 envs build, 31/31 scenarios, trip 6/6, derate 15/15, soc 10/10, all host tests + wasm 88 + pinmap pass. Sim page unchanged (no gist update). Note: sim_bms prints 2 pre-existing 'kelly' check FAILs (3.375 V half, 52.5 C halfway) that also fail on the prior commit; expectations look stale vs current derate curves, needs a look next run.
- [x] 2026-10-22 10 PM (test hygiene): fixed the 2 stale sim_bms 'kelly' check FAILs flagged at 7 PM. Firmware was right; the test still assumed pre-Build-10 curves (derateLowV 0.15, derateTempC 50). Midpoints now come from the live Config (3.400 V low-cell half, 47.5 C pack-hot half) so they can't go stale again. sim_bms was not in scripts/run_all_tests.sh, so its non-zero exit was invisible; it now gates the suite. 11/11 envs build, 31/31 scenarios, kelly 6/6, trip 6/6, derate 15/15, soc 10/10, full run_all_tests green (wasm 104, ui 124, iphone 49). No firmware or sim page change (no gist update).
- [x] 2026-10-23 6 AM (git history, DECIDED Adam 05:41/05:54): commit 4535341 (sim Kelly card, pre-Build 19) is kept exactly as pushed and will NOT be rewritten — any author/message rewrite would need a force-push, which is banned. `git log --format=fuller 4535341` shows Author and Commit both `Gilfoyle <gilfoyle@box>`, 2026-10-23 05:40:28 CT, so no identity fix is needed; it was committed before Adam's explicit commit approval (approved after the fact 05:41). All later commits use `-c user.name=Gilfoyle -c user.email=gilfoyle@box`.
- [x] 2026-10-23 10 AM (item 3, persist step): include/SocStore.h, header-only, NOT wired. SoC count (usedAh, anchorPct, learned capAh, known/drift) in EEPROM 1469..1514 after DriveStore, two ping-pong slots with seq + CRC-16. Torn write -> previous count restored; blank/bad CRC/out-of-range -> stays UNKNOWN (fail closed); count going UNKNOWN writes known=0 so a stale count can't return. Wear PLACEHOLDER: force on key-off edge, else >= 0.5 Ah and >= 60 s, max 120/boot. 16 host checks (scripts/test_soc_store.cpp, in run_all_tests.sh), docs/SOC.md. No unmetered off-state Ah assumed (UNVERIFIED). 11/11 envs build, 31/31 scenarios, all host tests pass. Sim page unchanged (no gist update).
- [x] 2026-10-23 1 PM (item 3, persist wiring): src/SocRun.cpp now uses include/SocStore.h. Boot restores the newest valid count (blank / bad CRC / known=0 = stays UNKNOWN, fail closed; learned capAh restored, else 0). Saves by the PLACEHOLDER wear rules plus a forced save on BmsCore's DRIVE/CHARGE -> IDLE edge; a never-known boot writes nothing; current loss saved as known=0. `p` shows EEPROM range / restored / saves; hub `soc` object adds `restored` + `saves`. scripts/hoststub/EEPROM.h added; test_soc_run 14/14 (was 5). No pins, safety flags unchanged. 11/11 envs build, 31/31 scenarios, all host tests pass. docs/SOC.md. NOT bench-tested. Sim page unchanged (no gist update). Next for item 3: KEY-ON / power-loss save, LEM B over the link, measured capAh.
- [x] 2026-10-23 4 PM (item 3, LEM B over the link): include/LemLink.h + CAN2 frame 0x6A5 B -> A every 50 ms ([0-1] amps x10 i16 LE, [2] valid, [7] hb). B sends CurrentSense amps/valid (CURRENT_SENSE_ENABLE 0 = always valid=0). A accepts only valid + fresh heartbeat within linkMs + in range (fail closed); frozen hb, missing, NaN, saturated = no LEM B. `Link::remoteLemB()` + `REMOTE LEM B` line in the link print. NOT consumed: SocRun kHaveLemB and ContactorSeq lemBValid still false. 12 host checks (scripts/test_lem_link.cpp, in run_all_tests.sh). 11/11 envs build, 31/31 scenarios, full FAST suite green. Safety flags unchanged. docs/SOC.md. NOT bench-tested. Sim page unchanged (no gist update).
- [x] 2026-10-23 7 PM (item 3, LEM B consumed by SoC): src/SocRun.cpp drops `kHaveLemB`; bank amps = CurrentSense (LEM A) + `Link::remoteLemB()` (LEM B). Counts only when both are valid + fresh, else current-lost -> UNKNOWN after 2 s (no half-bank count). `p` line shows LEM A/B ok; hub `soc` adds `lemA`/`lemB`, `halfBank` always false. socPct still null (capAh UNVERIFIED, CURRENT_SENSE_ENABLE 0 = both invalid, behaviour unchanged). test_soc_run 17/17 (was 14). 11/11 envs build, 31/31 scenarios, full FAST suite green. docs/SOC.md. NOT bench-tested. Sim page unchanged (no gist update). Next: ContactorSeq lemBValid from the link (chief #3).
