Adampaleski/AmperaBattery/docs/TIERS.md

# CRITICAL / LATER tiers (generated by tools/build_checklist.py — do not edit)

CRITICAL = truly blocks first drive (chief, crew review 2026-10-22: gates + Mechanic hardware + Sparky). LATER = refine over time.

## 0. Path to first drive — chief's gates (in order)
- **CRITICAL** · Gate 0 — 12 V bench (chief): flash on 12 V only; link fault < 200 ms; Kelly config readback: Boost OFF, High Pedal Disable ON, Foot_SW + 3-gear (F/N/R) behaviour, OV cutoff ≈160 V (PROPOSED value, read back and record). (Chief; BACKLOG.md:5)
- **CRITICAL** · Gate 1 — sensors (chief): BICM cells within 10 mV of a meter; temp / ID mapping; LEM zero at 2.5 V + dead-LEM detect; pedal tracks; park contacts; e-stop NC2; brake override; clamp kill-A / kill-B test with the Kid (Low) cap engaging when unpowered. (Chief; BACKLOG.md:6)
- **CRITICAL** · Gate 2 — one string, wheels up (chief): precharge to 95 %; e-stop; weld check; precharge timeout; turn the safety flags on one at a time. First HV power-up one string at a time (Sparky). Wheels-up bench tests on 1 string with Kelly #11 Battery_Current at 25 % of 550 A (≈138 A, ≈3C on one ~45 Ah string) — DECIDED (chief 2026-10-23; % re-based to the 550 A KLS8080 NPS by Sparky 2026-10-23, was 22 % of 600 A). (Chief; BACKLOG.md:7)
- **CRITICAL** · Gate 3 — strings (chief): add strings one at a time; each string must be within 0.5 V of the bus before its fuse goes in (DECIDED chief 2026-10-23, supersedes the earlier 1 V figure). 2 strings for first drive, strings 3 and 4 one at a time after Gate 4; spin; regen direction; coolant flow; fan at 40 °C; 12 V alarm; HV leak detection. (Chief; BACKLOG.md:8)
- **CRITICAL** · Gate 4 — first drive (chief): on 2 strings with Kelly #11 Battery_Current at 49 % of 550 A (≈270 A) — DECIDED (chief 2026-10-23; % re-based by Sparky 2026-10-23, was 45 % of 600 A); Kid / Low mode, 10 mph, flat ground, spotter. Then add strings 3 and 4 one at a time (0.5 V rule). (Chief; BACKLOG.md:9)
- **CRITICAL** · Chief review #3: ContactorSeq.cpp:288-312: lemA/lemB/valid never set; BmsCore.h:186-189 defaults valid=true, so dead-LEM, >60 A disagree and 400 A per-sensor trip can never fire. Default valid=false. PARTLY DONE 2026-10-22 7 PM: BmsCore Inputs lemAValid/lemBValid now default false; ContactorSeq sets lemAValid/lemBValid/lemSplitValid=false explicitly (fail closed: with CURRENT_SENSE_ENABLE=1 the Low cap holds until real per-LEM health is wired); 3 checks in scripts/test_review_fixes.py. Still open: feed LemHealth per Teensy + LEM B over the link so the checks can actually fire. (Chief; BACKLOG.md:46)
- **CRITICAL** · Chief review #4: ContactorSeq.cpp:302: key-on is serial e only; no KSI, e-stop NC2, park or plug-in input fed to BmsCore. (Chief; BACKLOG.md:47)
- **CRITICAL** · Chief review #5: EstopLatch.h not called anywhere in src/. (Chief; BACKLOG.md:48)
- **CRITICAL** · Chief review #6: Brake-overrides-throttle >0.5 s not in firmware (sim only). (Chief; BACKLOG.md:49)
- **CRITICAL** · Chief review #7: KellyLink.h / LemHealth.h not wired (BMS_CAP_KELLY_RX 0); non-Kid modes uncapped when speed lost. (Chief; BACKLOG.md:50)
- **CRITICAL** · Chief review #8: TEMPS_VERIFIED=0: drive has no overtemp, derate or TEMP-STALE. Verify temps, set 1 before first HV drive. (Chief; BACKLOG.md:51)
- **CRITICAL** · Chief review #9: ThrottleTrim.cpp:76 + Config.h:213: raw ADC/1023 pedal, no travel calibration, half-scale track 2 would trip DISAGREE, no open/short detect, 4.5 V reads ~88 %. (Chief; BACKLOG.md:52)
- **CRITICAL** · Chief review #10: ThrottleTrim.cpp:5-6: MCP4131 digipot powers up at mid-scale (50 %) until begin(), and coil gate pins float from reset until setup() (main.cpp:233-240): the 74HC4066 clamp + 100k Kelly pull-down (Gate 1) and the 10k gate pull-downs on pins 11/12/21 + pin 20 relay driver (Gate 0) MUST be bench-proven. (Chief; BACKLOG.md:53)

## 1. Other first-drive prep
- **CRITICAL** · Install the e-stop: XB4/XB5 40 mm twist-release (XB4BS8442 head has 1 NC) + 2 extra ZBE102, direct (no relay): block 1 both EV200 coils (OK, 0.26 A break), block 2 precharge coil + Kelly KSI, block 3 Teensy B latch input; IP65 guarded box (Adam; shop log 2026-10-21 17:45 · docs/ESTOP.md)
- **CRITICAL** · Nothing flashed until the BICM temperature formula and the BICM ID mapping are verified on the bench (Gilfoyle; chief standing rule)
- **CRITICAL** · DC-DC TDC-JH isolation test (power off: pack ± to 12 V− open / ≥1 MΩ) before bonding 12 V− to the chassis (Adam; shop log 2026-10-15 20:46)
- **CRITICAL** · Chain guard + chain tensioner / chain line with the motor up front (#50, 16/32T) (Adam; shop log 2026-10-21 18:00 · BACKLOG Mechanical)
- **CRITICAL** · Pack mounts / cage / tie-downs, HV cable clamps, grommets at every pass-through (Adam; shop log Drivetrain tasks · BACKLOG Mechanical)
- **CRITICAL** · Charge-plug interlock. No drive while plugged in, and no charging below 0 °C or with stale/unverified temps (TEMPS_VERIFIED=0 today). (Gilfoyle; BACKLOG.md:105)
- **CRITICAL** · Contactor weld check. Bus voltage vs pack with mains commanded open at key-off and before precharge (sim has a welded-contactor toggle; firmware not built). (Gilfoyle; BACKLOG.md:106)
- **CRITICAL** · Isolation monitoring (HV to chassis). Part not chosen. (Sparky; BACKLOG.md:107)
- **CRITICAL** · 12 V low alarm at 11.5 V (PROPOSED). Needs a 12 V sense divider pin. (Gilfoyle; BACKLOG.md:108)
- **CRITICAL** · Firmware dead-LEM detection. 2026-10-22 1 PM: logic + host test done (include/LemHealth.h, scripts/test_lem_health.cpp 18/18, docs/LEM_HEALTH.md): RAIL (within 0.2 V of 0/Vc or Vc bad, 100 ms), RANGE (>450 A), AGREE (<15 A, ch1 vs ch2 >5 A, 500 ms), ZERO key-on self-test (>5 A), latched until key cycle; all PROPOSED. Not wired (CURRENT_SENSE_ENABLE 0); next: run in CurrentSense::tick per Teensy, B's code over the link, set lemAValid/lemBValid, ZERO before precharge. Original: Read each LEM separately and flag one reading nothing or out of range (>450 A, PROPOSED) as a hard fault that engages the 10 mph cap. Today this check runs only in the sim. (chief, 2026-10-21) (Gilfoyle; BACKLOG.md:128)
- **CRITICAL** · Two-track pedal. Today ONE pedal wiper is read by both Teensys (A pin 40, B pin 41, same signal through two dividers; docs/THROTTLE_CLAMP.md), so a pedal fault looks identical on both. Fit a dual-output Hall pedal (two independent tracks, e.g. one track ×½): Teensy A reads track 1 and Teensy B reads track 2, each on its own pin (PROPOSED: keep A pin 40 / B pin 41, no shared wiper), with a plausibility check between the tracks (PROPOSED: > 10 % for 100 ms → throttle 0 + fault). Part not chosen. (Gilfoyle; BACKLOG.md:132)
- **CRITICAL** · Brake overrides throttle: brake and throttle both pressed > 0.5 s → throttle cut to 0 until the pedal returns to 0 (PROPOSED). Partly covered: sim brake switch cuts throttle (sim/vehicle.js); Kelly "Brake H-Pedal" option (docs/KELLY_CAN_ROLES.md) is a config check. Firmware Teensy rule not built. (Gilfoyle; BACKLOG.md:133)
- **CRITICAL** · Kelly CAN timeout (> 200 ms, PROPOSED) → derate + fault (KELLY-CAN-LOST). Today stale Kelly CAN only makes Park false (include/ParkState.h); BMS_CAP_KELLY_RX=0. 2026-10-22 4 PM: logic + host test done (include/KellyLink.h, scripts/test_kelly_link.cpp 18/18, docs/KELLY_LINK.md): NEVER-SEEN (no frame 2 s after KSI), LOST (either frame > 200 ms stale, not hidden by boot grace), Low cap until both fresh 1 s, latched + loss count, parkTrusted() for ParkState; all PROPOSED. Not wired; next: hook into KellyDecode when BMS_CAP_KELLY_RX=1, FaultLog edges, sim "Kelly CAN unplugged" toggle. (Gilfoyle; BACKLOG.md:136)
- **CRITICAL** · Kelly/motor cooling. First drive (chief full review 2026-10-23): hardwire the pump to key-switched 12 V and the fan to a thermoswitch or always-on, NO Teensy logic. Firmware cooling control (after first drive, LATER) from Kelly controller + motor temps (Kelly CAN): pump on with key (COOL_PUMP pin 8), radiator fan relay at ~40 °C (RAD_FAN pin 7), PROPOSED pins reserved in Config.h, not built; Kelly derates itself at 90 °C case (SOURCED manual). (Gilfoyle; BACKLOG.md:138)

## 2. Shop tasks
- **LATER** · Confirm the custom axle pinions are still OEM 8T/35T (4.375) (Adam; shop log Drivetrain tasks)
- **LATER** · Custom axle: shaft, bearings, how it meets the F/R diffs (Adam; shop log Drivetrain tasks)
- **LATER** · Tape / scan the under-seat and tunnel cavities (seats down) (Adam; shop log Drivetrain tasks)
- **LATER** · Place the 36S strings under the seats (power off before any harness change) (Adam; shop log First drive)
- **LATER** · Motor temp sensor into the Kelly (Temp pin 1, KTY84/83 per manual) (Adam + Sparky; shop log Drivetrain tasks)
- **LATER** · Kelly cooling loop: reservoir/fill → pump → Kelly W3-GT2 → stock radiator → back, no thermostat; measure hose sizes (Mechanic; shop log 2026-10-20 15:44)
- **LATER** · Free + lube the 4WD and diff-lock cables; measure cable pull force (scale) and travel (Adam; shop log 2026-10-21 09:18/09:25)
- **LATER** · Mount the 2 BTS7960 H-bridges inside the sealed enclosure (Adam; shop log 2026-10-21 09:28)
- **LATER** · Dash tablet mount + vibration isolators, soft-mount, strain-relieve the charge cable (Adam; shop log Dash EV hub)
- **LATER** · Enclosure sealing with a breather and a drain (Mechanic; BACKLOG Mechanical)
- **LATER** · Chassis ground straps: 12 V− to frame, Kelly case to frame (Mechanic; BACKLOG Mechanical)
- **LATER** · Read the seat heater type (single/two-stage) (Adam; shop log 2026-10-20 15:45)
- **CRITICAL** · Measure before ordering (Adam): 1/0 lead run lengths (string → A6T200 on the bus bar → EV200 → Kelly), bus bar span + stud size, EV200 / HV plate footprint, chain line + guard clearance, tie-down points, grommet hole diameters, ground-strap runs, Teensy enclosure size, Hall pedal mounting / travel. List per Mechanic's hardware; dimensions UNVERIFIED until measured. (Mechanic; BACKLOG.md:18)
- **CRITICAL** · Wire S42/S43 KEY-ON -> A:34 / B:34 (opto, 10k pull-up, LOW = key on; PROPOSED, Sparky 2026-10-22) and S41/S44 plug-in detect -> A:33 / B:33 from the ONE shared LM339 (see the next lines; LM339 DECIDED chief 06:57 #1). Key source = stock key switch output (colour UNVERIFIED). Bench: idle 3.3 V, active <0.4 V. (Sparky; BACKLOG.md:26)
- **CRITICAL** · Backprobe the stock Teryx key switch switched output (S42/S43 source, fed from the TDC-JH 12 V bus): 0 V key off, 12 V key on; record the wire colour (UNVERIFIED) in PINMAP. Fuse it with its own 1 A fuse (Sparky 2026-10-22) before tapping it to the optos. (Sparky; BACKLOG.md:27)
- **CRITICAL** · Wire the plug-in + release detect with ONE LM339 for both boards (Adam t284; LM339 re-pin DECIDED chief + Sparky 2026-10-23 06:57; wiring page "Charge plug-in + release detect"): NACS inlet proximity (S45; ~150 Ω latched or ~480 Ω button pressed = plugged, open = not plugged) -> one network: 330 Ω pull-up to the shared 5 V and 2.7k to GND -> one 10k/20k divider (S46) -> IN+ of all four channels (pins 5, 7, 9, 11). Plug: 2.5 V reference to IN1−/IN2− (pins 4 and 6, S48); OUT1 (pin 2) -> A:33 with its own 10k pull-up to A 3.3 V (S41); OUT2 (pin 1) -> B:33 with its own 10k pull-up to B 3.3 V (S44). Release: 1.40 V reference (10k/3.9k, S53) to IN3−/IN4− (pins 8 and 10); OUT3 (pin 14) -> 1k -> A:2 (S51), OUT4 (pin 13) -> 1k -> B:35 (S52), each with its own 10k pull-up + 100 nF. LM339 VCC (pin 3) from the shared 5 V (S47), GND (pin 12) to the single-point ground (S49). No hysteresis resistors: 100 nF + 20 ms debounce (DECIDED Sparky 06:57 #3). Plugged = A:33 and B:33 LOW = drive blocked on BOTH boards, like park; plugged but not latched = stop charger over CAN + open AC contactor. Firmware: set A:2 INPUT (boots as output) — later commit, no flashing. (Sparky; BACKLOG.md:28)
- **CRITICAL** · Bench: plug and unplug the NACS connector (latched and button pressed) and confirm drive is blocked on BOTH boards; then an open-wire test on the proximity line. (Adam; BACKLOG.md:30)
- **CRITICAL** · Mechanic: mount the 50 Ω/100 W precharge resistor (H08) on the HV panel aluminum backplate with thermal paste, away from the loom. (Mechanic; BACKLOG.md:31)
- **CRITICAL** · Kelly programming check (Adam): controller model SOURCED (Adam 2026-10-23) from his purchase email = KLS8080 NPS, 168 V, 550 A, all add-ons incl. high-speed and anti-slip — no Kelly nameplate photo needed (closes chief review gap 9; Sparky re-based #7/#10/#11). READ back and confirm before writing: #60 sensor type = 4 sin/cos (motor sensor sin/cos SOURCED; setting UNVERIFIED), #7, #10, #11. Motor nameplate still OPEN for Adam: pole count (#59) and thermistor type (#63). (Sparky; BACKLOG.md:36)
- **LATER** · Service disconnect (crew 2026-10-22, replaces the Volt MSD): pull all 4 Mersen A6T200 string fuses. Key off, e-stop pressed, wait for the Kelly caps, remove the tool-only cover (captive screws), pull fuses 1–4 with the insulated wrench, meter bus B+ to B− = 0 V, boot the string-side studs (still LIVE). Volt MSD removed from the current path. DECIDED (room: Sparky + chief, 2026-10-23 06:11 CT): no MSD in this build. Fuse location label for the top-down layout view: "reachable from above, tool-only cover". (Mechanic; BACKLOG.md:109)

## 3. Buy list — needs Adam OK (never buy)
- **LATER** · 2× M4 18S BICM (VTSM#4, used Gen1 pulls, ~$50-70 ea) (Mechanic; shop log 2026-10-21 17:20)
- **LATER** · 2× SN65HVD230 transceivers for Gate 3 (need 6; the 4 owned cover the one-string bench). No purchase now. (Mechanic; shop log 2026-10-21 17:20)
- **LATER** · Throttle clamp parts: CD74HCT123E, CD74HC4066E, SN74AHCT125N, MCP4131-103E/P + 100k/10k/1 µF/100 nF (Mechanic; docs/THROTTLE_CLAMP.md BOM)
- **LATER** · E-stop: Schneider XB4 metal (or IDEC) mushroom, 2 NC blocks, guard ring, IP65 box + bracket, Deutsch connector (Mechanic; shop log 2026-10-21 17:45)
- **LATER** · REQUIRED BEFORE FIRST DRIVE — dual-output Hall throttle pedal (2 independent tracks, A reads track 1, B reads track 2). Part TBD (Mechanic; shop log 2026-10-21 20:03 · BACKLOG VCU)
- **LATER** · 3-pole parking-brake switch (2 NO + 1 NC) + 12 V SPDT relay for the Kelly ECO Low cap + FET + 1N4007 (Mechanic; docs/COMPONENTS.md)
- **LATER** · 2× Glideforce LACT4P-12V-10 actuators (-20 if cable > 30 lb) + 2× BTS7960 H-bridge modules (Mechanic; shop log 2026-10-21 09:25/09:28)
- **LATER** · Cooling: Bosch 0392022010 12 V pump (~$162), hose reducers, hose + clamps, 50/50 coolant, fan relay + fuse (Mechanic; shop log 2026-10-20 15:44/15:45)
- **LATER** · HV build: 1/0 + 3/0 tinned lugs + hydraulic crimper, copper bus bar + insulated standoffs + clear cover, 1/0 string leads, HV orange loom + clamps/grommets (Mechanic; shop log 2026-10-20 05:42)
- **LATER** · Branch fuses: charger 60-70 A ≥250 VDC, DC-DC 15-20 A; any holder at pack voltage rated > 160 VDC (string A6T200s need no holders) (Mechanic; shop log 2026-10-20 05:42)
- **LATER** · 12 V side: key switch, 12 V battery, fused distribution block, 16-20 AWG TXL, Deutsch DT pins/seals + crimper, 3 inline mini-blade holders, 3 TVS, IRLB3813 FETs (IRLB8721 discontinued), panel-mount USB extension (Mechanic; shop log 2026-10-20 05:42 / 10-19 20:04)
- **LATER** · NACS AC inlet (into the Elcon) (Mechanic; shop log 2026-10-20 05:42)
- **LATER** · Insulation tester (or borrow) + isolation monitor (part not chosen) (Mechanic; shop log 2026-10-20 05:42 · BACKLOG Safety)
- **LATER** · Dash: Android tablet 10-11" ≥8 GB, rugged case, fused 12 V → USB-C PD ~45 W, phone cradle, ESP32 enclosure + buck + fuse (Adam; shop log Dash EV hub)
- **CRITICAL** · Mechanic shop order 1: 1/0 HV leads + crimper (needs Adam OK, never buy). (Mechanic; BACKLOG.md:10)
- **CRITICAL** · Mechanic shop order 2: bus bar + insulated standoffs + tool-to-remove cover with captive screws; 4 A6T200 bolt direct (no fuse holders), all reachable from one side; any holder at pack voltage > 160 VDC (needs Adam OK). (Mechanic; BACKLOG.md:11)
- **CRITICAL** · Mechanic shop order 3: EV200 mounts + HV component plate (needs Adam OK). (Mechanic; BACKLOG.md:12)
- **CRITICAL** · Mechanic shop order 4: e-stop parts: Harmony XB4/XB5 40 mm twist-release head (XB4BS8442 includes 1 NC) + 2 extra Schneider ZBE102 NC blocks + IP65 guarded box (needs Adam OK). Block 1 SOURCED/OK; block 2 pending KSI draw. (Mechanic; BACKLOG.md:13)
- **CRITICAL** · Mechanic shop order 5: Kelly coolant loop + fan relay (needs Adam OK). (Mechanic; BACKLOG.md:14)
- **CRITICAL** · Mechanic shop order 6: chain guard + tensioner (needs Adam OK). (Mechanic; BACKLOG.md:15)
- **CRITICAL** · Mechanic shop order 7: pack tie-downs, grommets / loom, ground straps (needs Adam OK). (Mechanic; BACKLOG.md:16)
- **CRITICAL** · Mechanic shop order 8: sealed Teensy enclosure + Hall pedal bracket (needs Adam OK). (Mechanic; BACKLOG.md:17)
- **CRITICAL** · Insulated wrench for pulling the string fuses (crew 2026-10-22; needs Adam OK). (Adam; BACKLOG.md:22)
- **CRITICAL** · Insulated boots / covers on every HV terminal (Sparky): the string side of each A6T200 stays LIVE with the fuses pulled. (Sparky; BACKLOG.md:24)
- **CRITICAL** · BUY — pending purchase approval (Adam), NOT owned: 1x LM339 + the network parts for ONE plug + release detect circuit: 330 Ω, 2.7k, 10k + 20k divider, 2.5 V reference (10k/10k), 1.40 V reference (10k/3.9k), 4x 10k output pull-ups, 2x 1k release series, 100 nF decoupling + 4x 100 nF at A:33/B:33/A:2/B:35. No hysteresis resistor (DECIDED Sparky 06:57 #3). Nothing is bought without Adam's OK. (Sparky; BACKLOG.md:29)

## 4. Firmware / design TODO
- **CRITICAL** · Branch fuses (Sparky): DC-DC branch fuse 15–20 A; Elcon output fuse 1.25 × max charger current, ≥ 250 VDC rated. (Sparky; BACKLOG.md:19)
- **CRITICAL** · LEM zero offset (Sparky): store the zero-current offset; fault if the reading is > 5 A off at zero current. Zero stored by Z (Settings); > 5 A check = LemHealth ZERO self-test (logic done 2026-10-22, not wired). (Sparky; BACKLOG.md:20)
- **CRITICAL** · HV leak / isolation detection (Sparky): add before Gate 3. (Sparky; BACKLOG.md:21)
- **CRITICAL** · E-stop latch (crew 2026-10-22): when block 3 (NC to Teensy B) reports open, drop every coil driver and latch until a key-cycle reset; releasing never closes anything. Logic + test done (include/EstopLatch.h, scripts/test_estop_latch.cpp 7/7); wire into the coil gate when BMS_CAP_CONTACTOR_DRV is enabled, then bench: press, release, unplug block 3 wire. Adam meters Kelly KSI draw (expected < 0.2 A). (Adam; BACKLOG.md:23)
- **CRITICAL** · Firmware: read KEY-ON (A:34/B:34) and plug-in (A:33/B:33) into BmsCore wake/plugIn (plugged = no drive on both boards, like park), replacing the serial e dead-man (chief #4). Pins only in PINMAP so far. (Adam; BACKLOG.md:32)
- **CRITICAL** · Precharge + weld check via Kelly CAN B+ (room DECIDED 2026-10-23: chief + Sparky + crew; replaces the isolated HV_SENSE on A:24, AMC1311 DROPPED for now; docs only, firmware NOT changed in Build 18): bus side = Kelly CAN B+, pack side = BICM cell sum. (a) Close Main+ only when Kelly B+ >= 95% of the BICM sum AND the minimum precharge time has passed; time alone never closes it. (b) A stale (>200 ms) or missing Kelly frame = precharge FAIL: mains open, fault. (c) Sequence (chief DECIDED 2026-10-23; KSI open item RESOLVED: e-stop block 2 only passes power, the Teensy drives the precharge coil separately, so KSI comes on first): 1) key on, KSI on; 2) a fresh Kelly B+ frame reads ~0 V (else Main+ welded); 3) close Main- alone, B+ still ~0 V (else Main+ welded); 4) precharge; 5) close Main+ only when B+ >= 95% of the BICM sum AND the minimum time has passed (a Main- weld shows up when Main+ closes). Second layer: key-off check (open Main+, hold KSI ~3 s; B+ still tracking the BICM sum = welded). Firmware TODO (needs chief + Sparky + Mechanic): PrechargeGate already has the 95% + min-time rule, but its bus input is HV_SENSE (HV_ANALOG_ENABLE=0 -> always FAIL today); it must take Kelly B+ with the 200 ms staleness rule. All UNVERIFIED until the bench gate below. (Mechanic; BACKLOG.md:33)
- **CRITICAL** · Kelly B+ bench gate (room DECIDED 2026-10-23, all UNVERIFIED): (1) B+ is reported within ~1 s of KSI even while the Kelly low-voltage error is active; (2) frames arrive at least every 100 ms; (3) B+ within ~2% of a meter across a 0-150 V precharge ramp; (4) B+ reads ~0 with the mains open, not a held stale value. (5) the Kelly boots and sends frames on 12 V KSI with HV absent. If ANY check fails, the isolated sensor comes back: AMC1311EVM (~$50, purchase needs Adam OK). A:24 = reserved spare until then. Isolation monitoring stays its own separate CRITICAL item. (Adam; BACKLOG.md:34)
- **CRITICAL** · Contactor coil gate-drive bench gate (crew 2026-10-23, UNVERIFIED): each contactor coil — AEV14012 precharge, EV200 main+ and EV200 main− — must pull in fully when its IRLB8721 low-side FET is driven straight from a Teensy 3.3 V pin (the IRLB8721 datasheet only rates RDS(on) at VGS 4.5 V and above). Measure coil voltage / FET drop at pull-in on 12 V. If any coil fails to pull in fully, add a gate driver or logic-level FET rated at 2.5-3.3 V (PROPOSED, no purchase without Adam's OK). IRLB8721 count owned: UNVERIFIED until Adam answers. (Adam; BACKLOG.md:35)
- **CRITICAL** · Plug detect second source (chief full review gap 11): Elcon charger CAN status alive = drive blocked, so one LM339 losing 5 V (reads "unplugged") can't allow a drive-away. No new parts. (Adam; BACKLOG.md:38)
- **CRITICAL** · Design the K02 Foot_SW "both Teensys alive" relay (chief full review gap 13): Kelly pin 11 is 40 mA max, so the series heartbeat contacts need a relay/driver; e-stop block 3 pin (B:9) is PROPOSED only. (Adam; BACKLOG.md:39)
- **CRITICAL** · Written safety-flag flip order (chief full review gap 19): one flag at a time (CONTACTOR_DRV, KELLY_LIMIT_DRV, KELLY_RX, TEMPS_VERIFIED, CURRENT_SENSE …), each with its own bench test + key-cycle test, before TELEMETRY_ONLY goes to 0. (Adam; BACKLOG.md:40)
- **LATER** · Wire into BmsApp + STATUS_SCHEMA socPct (needs CURRENT_SENSE_ENABLE + split-LEM read). (Gilfoyle; BACKLOG.md:77)
- **LATER** · Persist used Ah + anchor at power-off (ties to item 5). DONE 2026-10-23 1 PM (SocStore wired into SocRun); remaining: KEY-ON / 12 V power-loss save. (Gilfoyle; BACKLOG.md:78)
- **LATER** · Next: record a real Teryx drive (Kelly CAN speed/current) as a replayable profile; add a heat/temps-valid profile once temps are verified; cycle results into the dash trip panel. (Gilfoyle; BACKLOG.md:81)
- **LATER** · TODO (current sense sign): DHAB S/44 to be mounted so discharge reads in the −420 A direction, with regen/charge on the +230 A side. Firmware must flip the sign so discharge shows positive. Not done yet; CURRENT_SENSE_ENABLE stays 0. Range unverified until we have the datasheet. If it can't be mounted that way, fall back to a ≥500 A single-range LEM (e.g. HASS 500-S). (Gilfoyle; BACKLOG.md:94)
- **LATER** · Split-LEM firmware: read LEM A on Teensy A and LEM B on Teensy B, sign flip (discharge on −420 A side), share B's reading over the A–B link, port sim lemPair() pair-imbalance and sensor-fault checks into BmsCore. Thresholds (30%, 40 A, 100 A) are placeholders. (Gilfoyle; BACKLOG.md:98)
- **LATER** · HV path (2026-10-20, see docs/TERYX_MAIN_POWER_PATH.md): two main contactors, used TE EV200 on pack + and pack −. Volt AEV14012s only on charger/DC-DC/precharge branches. (Gilfoyle; BACKLOG.md:99)
- **LATER** · Strings: 36S each, built from 24S + 18S BICM boards (no 30S). (Gilfoyle; BACKLOG.md:101)
- **LATER** · Before Brake_AN: read back the Kelly config (Brake Type, Boost OFF, BRK_AD/BRK_SW, Foot Switch, Three Gears/Speed) and save it in docs/. (Gilfoyle; BACKLOG.md:125)
- **LATER** · E-stop block 2 (pending): Adam meters the Kelly KSI draw (expected < 0.2 A); block 2 breaks ≈0.35 A AEV14012 + KSI. Block 1 SOURCED/OK (chief 2026-10-22: 0.26 A measured break < 0.5 A @24 V; 7.6 A inrush carried < 10 A Ith). (Gilfoyle; BACKLOG.md:126)
- **LATER** · Dead-LEM detail (Sparky): each output should sit near 2.5 V at 0 A; within about 0.2 V of 0 V or 5 V = dead or disconnected (hard fault). Key-on self-test: below about 15 A, the low-range and high-range channels must agree. (Sparky; BACKLOG.md:129)
- **LATER** · Direction change only at 0 RPM with the brake on (PROPOSED). Sim refuses R above 1 mph; no firmware rule yet (Kelly F/N/R readback on CAN 0x0CF11F05 b5, docs/KELLY_CAN_ROLES.md). (Gilfoyle; BACKLOG.md:135)
- **LATER** · Brake-to-wake (PROPOSED, sim Build 2): brake held at full travel ≈1 s = key on (replaces a separate On switch); e-stop NC1 and the precharge/park rule still gate it. Needs a brake-position input that works while asleep (pin/part not chosen). (Gilfoyle; BACKLOG.md:139)
- **LATER** · Decide: PIN to drive (UNDECIDED; sim option, off by default; uses the Kid PIN hash). (Gilfoyle; BACKLOG.md:140)
- **LATER** · Hall pedal spec (Sparky): track 2 at half scale (e.g. 0.5-4.5 V and 0.25-2.25 V). Both tracks go through 10k/18k dividers (4.5 V reads 2.89 V at the pin). Compare the tracks as % of travel, not raw volts. (Sparky; BACKLOG.md:141)
- **LATER** · Phone-as-key (PROPOSED): no Bluetooth phone key → PIN pad before any drive setting (modes, thresholds, limits); key off → drive settings locked; Night/dim stay unlocked. Sim toggle "Phone key present". Decide: BLE module + pairing, which PIN (sim reuses the Kid PIN hash), firmware mirror. (Gilfoyle; BACKLOG.md:146)
- **LATER** · [LATER] Spare inputs IN2/IN3/IN4 (Config.h Pins, all -1 today): deferred until after first drive (chief 2026-10-22). Checked: none of chief review CRITICAL #1-#10 or the Path-to-first-drive items needs IN2-IN4 (key-on / plug-in / e-stop / park get their own pins). Needs pins freed first (no free GPIO on A). (Gilfoyle; BACKLOG.md:152)
- **LATER** · Odometer that survives power-down (EEPROM, wear-leveled) plus hour counter (key-on hours and drive hours). Requested by Adam; do not implement until after first drive. (LATER / after first drive) (Gilfoyle; BACKLOG.md:153)
- **LATER** · [LATER] Guided Install, queued item — Coil-driver board section: diagram of the FETs (IRLB8721 x3 on A:11/A:12/A:21, S01-S03), flyback = ONE 1N4007 (D-PRE) at the AEV14012 coil only, cathode to +12 V, no zener; EV200 coils get NO external diode (DECIDED Sparky 2026-10-23 05:41), 100 Ω gate resistors and 10k pull-downs, F-COIL; parts from docs/PARTS.yaml part id coil_driver (clickable in the wiring diagram); step-by-step perfboard/PCBWay build per Sparky; PASS/FAIL checks. Guide now in the repo: docs/guided_install/coil_driver.md (Build 19); perf-board layout docs/boards/coil_driver.layout.json (Build 20, PROPOSED). Still open: wire the guide into Guided Install mode. (Gilfoyle; BACKLOG.md:155)
- **LATER** · [LATER] MOTOR_FAN (Build 18 pin reservation only, no logic): 12 V fan across the air-cooled Zero 75-7R via relay coil, low-side IRLB8721 + 10k gate pull-down + 1N4007 (same style as RAD_FAN on A:7). Reserved on the MCP23017 body expander bit 14 (GPB6), PROPOSED: Teensy A has no free edge pin. Future trigger: Kelly CAN 0x0CF11F05 byte 2 motor temp (KTY into Kelly Temp pin 1); on-threshold TBD. (LATER/PROPOSED) (Gilfoyle; BACKLOG.md:157)
- **LATER** · [LATER] PACK_HEAT — NOT reserved in Build 18 (chief full review 2026-10-23: it adds a new HV circuit, drop it from Build 18 entirely; MCP23017 bit 15 stays free). Design notes kept for after first drive: Idea: reuse the stock Volt heater (≈360 V part, ≈15 % of rated heat at ≈140 V, UNVERIFIED); heater type/part TBD. Future logic: only while plugged in and below a set temperature, never while driving; PROPOSED hardware interlock so its 12 V coil feed exists only when plugged in. HV fuse + contactor rating TBD with Sparky. (LATER/PROPOSED) (Gilfoyle; BACKLOG.md:158)
- **LATER** · [LATER] BUZZER (Build 18 placeholder): real 12 V buzzer/chime for the dash master alert. No free Teensy A pin; reserved on MCP23017 bit 13 (GPB5), PROPOSED, only if Adam counts expander bits as A outputs. Today the alert chime is WebAudio on the dash only. (LATER/PROPOSED) (Gilfoyle; BACKLOG.md:159)
- **LATER** · [LATER] Firmware PIN to Drive (after first drive; sim-only in Build 18, firmware NOT changed): port the Build 18 gate (drive allowed = PIN to Drive off OR phone nearby now OR PIN entered this key cycle, live, never latched). Default PIN: DECIDED (Adam 2026-10-23) = 0000 with a "change your PIN" reminder, NO forced first-time setup; supersedes the firmware NO_PIN_SET rule (include/DriveProfile.h). Needs chief + Sparky + Mechanic agreement and Adam's OK to flash. (LATER, rule DECIDED) (Gilfoyle; BACKLOG.md:160)
- **LATER** · Creep + hill hold for Kid mode (PROPOSED): low creep torque from 0 and hold at 0 RPM on a slope (Kelly Anti-Slip item 97 SOURCED as an option, UNVERIFIED on his unit) — not built. (Gilfoyle; BACKLOG.md:161)
- **LATER** · [LATER] Tool-free service disconnect (Sparky), does not block first drive. Room 2026-10-23 06:11 CT: this build has no MSD; the service disconnect is pulling all 4 A6T200 string fuses with the insulated wrench under a tool-only cover. (Sparky; BACKLOG.md:163)

## 5. Bench verifications
- **LATER** · Recheck the pedal curve with the 100k Kelly-side pull-down fitted (0/25/50/75/100 % × wiper, ±2 %) (Adam; docs/THROTTLE_CLAMP.md)
- **LATER** · Scope the 74HCT123 one-shot pulse width (target 3-8 ms) and check the 4066 leakage at 5 V (Sparky; docs/THROTTLE_CLAMP.md)
- **LATER** · Park interlock: brake set + throttle = 0 RPM (Kelly Foot Switch checked); photo of the parking-brake lever for switch fit (Adam; docs/PARK_BRAKE.md)
- **LATER** · Kelly ECO Low cap: relay off → full pedal stays ≤ cap RPM; confirm ECO pin on the harness (Adam; docs/DRIVE_MODES.md)
- **LATER** · Kelly CAN candump matches 0x0CF11E05 / 0x0CF11F05 layout before BMS_CAP_KELLY_RX=1 (Gilfoyle; docs/KELLY_CAN.md)
- **LATER** · BICM temps vs a thermometer on the bricks (then TEMPS_VERIFIED=1) (Adam; shop log 2026-10-15 06:08 · docs/TEMPS.md)
- **LATER** · Elcon stop/timeout test on a real string at ~1 A, V set a few volts under string total (clamp meter) (Adam; shop log 2026-10-15 06:08)
- **LATER** · Meter transceiver/DROK pin order and the Kelly input polarity before soldering the perfboards (Adam; shop log 2026-10-20 21:27)
- **LATER** · Clamp-meter the radiator fan inrush; meter the actuator pots (Adam; shop log 2026-10-21 09:28)
- **LATER** · Silent-string fault 2000 ms vs the bench 'd' max gap on first run (Gilfoyle; shop log 2026-10-17 17:21)
- **LATER** · 1 kHz ISR: maxPeriodUs < 2000 on the Teensy (Gilfoyle; docs/DRIVE_MODES.md)
- **CRITICAL** · Manual megger / insulation check HV-to-chassis on every string before its first HV power-up (chief full review gap 8): the insulation tester is not chosen; this is the minimum until isolation monitoring is fitted. (Adam; BACKLOG.md:37)
- **LATER** · Chief review should-fix (before flags go to 1): ADC re-entrancy (ThrottleTrim ISR vs CurrentSense loop analogRead); ThrottleCross 5 %/50 ms vs agreed 10 %/100 ms; MX clears latched throttle fault without key cycle; corrupt DriveStore drops out of Kid / loses PIN (fail to Kid/Low); no 12 V low alarm; tickDual skips enter() (partial bench logs); pin 4 = B_FAULT_OUT on B and A_THR_ALIVE on A (stated in docs/PINMAP.md); commit the BMS-settings edits (done, Build 10) — THR2 resets saved thresholds on first boot. (Gilfoyle; BACKLOG.md:54)
- **LATER** · Bank capacity Ah UNVERIFIED (capAh 0 = unknown): measure with one full -> low-cut run, then learnCapacity(). (Gilfoyle; BACKLOG.md:75)
- **LATER** · Next: add faultLog to teryx-ev-hub docs/STATUS_SCHEMA.md + mock + dash card (hub repo, feature branch only); bench power-pull test on a Teensy (Adam, when benching). (Gilfoyle; BACKLOG.md:88)
- **LATER** · Next: B → A park contact bit on the link; wire ParkState into ContactorSeq (precharge gate) and Selector (Kid); bench the Foot_SW / ECO behaviour. (Gilfoyle; BACKLOG.md:122)
- **LATER** · Synthetic neutral: N = Kelly zero throttle + no regen (freewheel), no mechanical decoupling; motor still spins, so back-EMF and overspeed limits still apply. Kelly "Three Gears Switch: Forward, Neutral, Reverse" (item 90) and NTL Brk default 0 (item 45) SOURCED; "neutral = FWD and REV pins both open" UNVERIFIED, bench it on the Kelly before relying on it. Sim + dash show N; Parked = park brake + 0 RPM + N. (Gilfoyle; BACKLOG.md:147)
- **LATER** · Bench IRLB3813 coil drivers at the Teensy gate level: datasheet specifies RDS(on) at 4.5 V and 10 V only (VGS(th) 1.35–2.35 V, Ciss 8420 pF); confirm the EV200/AEV14012 coils pull in fully. IRLB8721 is discontinued. (Gilfoyle; BACKLOG.md:149)
- **LATER** · [LATER] Guided Install mode on the wiring page (queued right after Build 18; Adam approved 2026-10-23): a step-by-step bench guide driven by docs/PINMAP.yaml. Back and Next steps, the active wire highlighted and everything else dimmed to about 15 %, auto-zoom to that wire, a step card (gauge, color, ends, fuse, datasheet link, photo slot), inline PASS/FAIL meter checks where a test belongs, resume progress, and an exported log. Low-voltage first; high voltage only after the crew signs off on the order. Physical routing notes come from Mechanic. (LATER, not built) (Gilfoyle; BACKLOG.md:154)
- **LATER** · [LATER] Electric park brake actuator on the park-brake cable (crew design in progress; NO pins reserved, chief 2026-10-23). Actuator Glideforce LACT4P-12V-20 (110 lb), PROPOSED, sized after Adam's luggage-scale pull test on the park cable, which is the gate (step up if the pull is more than about 60 lb). Self-locking lead screw: bench-verify it holds with power cut. Foot pedal kept, linked in parallel via a slotted link or cable splitter. A third BTS7960 driver on Teensy B or an expander, 10 A fuse, 14 AWG; current stall detection plus a position pot on 3.3 V. Sparky's rules: apply only at about 0 mph, throttle 0 and key on; release only with key on, no fault, plug disconnected and brake pressed; it never moves on its own at key-off or on Teensy death; the park switch stays the source of truth. Key-off auto-apply DECIDED (chief 2026-10-23): it auto-applies at key-off only while still powered, with 0 mph and Kelly 0 RPM confirmed before and during the move, never on a Teensy failure, and it only chimes if those conditions are not met. Phone walk-away auto-apply is LATER (separate decision). The Build 18 sim forgot-Park light + chime is unaffected (warning only, never moves anything). (LATER/PROPOSED, not built) (Gilfoyle; BACKLOG.md:156)

## 6. Decisions needed from Adam
- **LATER** · MCP23017 expander (BODY_IO_EXPANDER=1, frees pin 32 for park A) vs jumpers (Adam; docs/BODY_IO.md · Config.h)
- **LATER** · Precharge requires the parking brake (PROPOSED on) (Adam; docs/PARK_BRAKE.md)
- **LATER** · Low cap numbers: 1 s ramp, 30 % end, 10 mph; LEM disagreement 60 A / 50 % (Adam; docs/DRIVE_MODES.md)
- **LATER** · Zero 75-7R (used, sin/cos, spin test DONE) ratings (kW, torque, max RPM, voltage) for the motor model; motor nameplate pole count + thermistor OPEN (Adam; COMPONENTS.md)
- **LATER** · Push + flash OK (in the 1:1) once the bench gates pass (Adam; standing rule)
- **LATER** · Adam/Sparky: confirm the placeholder numbers (0.15/0.40 V below avg, 3.00 V floor 500 ms, 1 s rest debounce, 20 A rest) against Volt cell data; pick the imbalance cut level (placeholder 50 %). (Adam + Sparky; BACKLOG.md:66)
- **LATER** · Temperature limits: use the more conservative of Chevy's or the EV community's numbers (Adam 2026-10-21); ask Sparky. (Sparky; BACKLOG.md:70)
- **LATER** · Derate hardware: pick CD4066 vs MCP4131 and RC values; confirm KLS low-speed and regen input pins/polarity from Adam's harness (UNVERIFIED). (Adam; BACKLOG.md:72)
- **LATER** · Pick a proximity / charger-present input pin and wire plugIn in ContactorSeq (crew). (Adam; BACKLOG.md:96)
- **LATER** · (Optional) IVT-S 1000 A integration — dual LEM A + B is the primary sensing; ISA IVT-S is optional only: decide own CAN bus vs reconfigure to 250k; parser + DHAB cross-check (sim scenario 14 models it). (Adam; BACKLOG.md:97)
