Adampaleski/AmperaBattery/docs/DRIVE_MODES.md

# Drive modes = pedal-map profiles (Adam approved 2026-10-21) — CREW REVIEW before any flash

Source of truth: `include/DriveProfile.h` (firmware, wasm sim, tests); `sim/vehicle.js` mirrors it (parity-checked).
Every value is **PROPOSED** and adjustable (firmware: `MP <key> expo|cur|ramp|top|regen <v>`, RAM only; sim: Settings → Drive modes).

| Mode | Curve (expo) | Current (pedal cap) | Ramp A/s | Top mph | Regen % |
|---|---|---|---|---|---|
| High H | 0 linear | 100 % | 2000 | 49 (= Kelly 6000 RPM cap) | 100 |
| Medium M | 0.3 | 70 % | 1000 | 36 | 80 |
| Low L | 0.5 | 45 % | 600 | 22 | 60 |
| Snow | 0.8 soft | 40 % | 150 slow | 25 | 25 gentle |
| Mud | 0 (strongest the trim allows) | 90 % | 2500 fast | 30 | 20 light |
| Sand | 0 | 100 % | 3000 fast | 35 | 15 light |
| Kid | 0.7 | 20 % | 60 very soft | 10 | 30 |
| Reverse (sim) | 0.3 | 25 % | 500 | 15 (10 from Low/Kid; never above the mode's forward top) | 30 |

## Reverse cap per mode (PROPOSED, Adam request 2026-10-22, was 9 mph)
| Reverse from | Cap (mph) | Where it comes from |
|---|---|---|
| High, Medium | 15 | Kelly Max / MidSpeed Rev 31 % of 6000 = 1860 RPM ≈ 15.2 mph |
| Low, Kid | 10 | sim cap; Kid also via the Kelly ECO LowSpeed Rev 20 % = 1200 RPM ≈ 9.8 mph |
| Snow, Mud, Sand | min(15, mode top) = 15 | today all three tops are ≥ 25, so 15 |
- The gentle reverse feel is unchanged: expo 0.3, 25 % current, 500 %/s ramp, Kelly TPS Rev MAP stays 20 %.
- The sim remembers which mode you shifted into R from. Kid → R → Kid needs no PIN; reverse from Kid keeps Kid rules (10 mph cap, ECO Low cap held). R (from Kid) → any other mode still asks for the Kid PIN.
- Firmware has no separate reverse profile: the trim applies the current mode's top speed to |mph|. The 15 / 10 mph reverse caps are owned by the Kelly (docs/KELLY_SETTINGS.md #25–30). **Kelly side UNVERIFIED** until those parameters are read back from the controller.
- With no pedal, a forward gear rolling backwards downhill is held by Kelly overspeed regen at the reverse cap, so that roll-back limit also goes from about 9 to about 15 mph in the sim.
- Checks: scripts/test_controls.js (cap table per mode, full-pedal reverse speed per mode, Kid reverse with both Teensys dead, gentle launch) and scripts/test_dash_ui.py (Kid → R without the PIN).

## Firmware: reduce-only throttle trim (`src/ThrottleTrim.*`, `THROTTLE_TRIM_ENABLE=0`)
- MCP4131 as a divider in the throttle wiper: Kelly sees pedal × wiper/128, so the trim can only **lower** the pedal. Wiper rounds down.
- 1 kHz IntervalTimer: pedal ADC on pin 40 A16 (A) / 41 A17 (B), 5 ms one-pole filter, curve y=(1−e)x+e·x³, × cap, × BMS allowance (kellyPct), top-speed taper over the last 2 mph (speed from Kelly RPM 0x0CF11E05 × 0.008161 mph/RPM), ramp-limited rise, instant release, clamp ≤ filtered and ≤ raw pedal.
- Output 0 (wiper 0): contactors not Closed, any drive fault, Kid without a valid speed, trim disabled. `begin()` is the first line of `setup()`, so after a watchdog reset the wiper is written 0 before anything else.
- Kid: can't be entered until a PIN is set (`MPIN 0 <1000-9999>`, change: `MPIN <old> <new>`, not while in Kid); leaving needs `M <key> <pin>`.
- EEPROM (chief 2026-10-21, `include/DriveStore.h`): profiles + current mode + Kid PIN hash at 1318–1470 (moved 8 bytes by THR2 in Build 10; an older save reads as blank), CRC-16; boot restores the last mode (Kid stays Kid). Blank/corrupt/out-of-bounds → PROPOSED defaults, High, no PIN. The PIN is stored only as a salted, iterated FNV-1a hash and never printed (`d` shows `kidPin=set/none`). A 4-digit PIN can still be brute-forced from the EEPROM bytes (10^4 values).
- Two-Teensy clamp + cross-check (crew approved 2026-10-21): docs/THROTTLE_CLAMP.md. Pedal now on A pin 40 / B pin 41 (not 24). Pedal-direct-to-Kelly fallback documented there. HPD: KELLY_HPD.md.
- `d` prints mode, pedal, output, wiper, max ISR period and compute µs.

## Hardware Low cap: Kelly ECO (Adam's final call + crew, 2026-10-21) — fail-safe
Kid's normal limit is **10 mph forward, enforced by the Teensy** (software). One Kelly speed switch is kept as a hardware Low-only cap so Kid stays slow even if **both Teensys die**: the Kelly then holds Kid at **about 15 mph forward and 10 mph reverse** (DECIDED, Adam 2026-10-23). That backstop is 5 mph faster forward than the software cap, on purpose:
```
Kelly 12 V out (pin 11) --- relay NC contact --- Kelly ECO (pin 22, low-speed switch)
Teensy A OUT3 (pin 20) --- logic FET low-side --- relay coil (12 V) + 1N4007 flyback
```
- Relay **de-energized = NC closed = ECO at 12 V = LOW cap** (SW Level default = high-level enable, SOURCED KLS-8080N V2.11 item 93). So Teensy unpowered, reset, hung or flashing → capped.
- Teensy A must actively drive OUT3 **HIGH** to energize the relay and **release** the cap. `src/KellyLimit.cpp`: cap held (OUT3 LOW) when BMS limp **or Kid mode**. Boot writes OUT3 LOW. Pins are driven only with `BMS_CAP_KELLY_LIMIT_DRV=1` + `TELEMETRY_ONLY=0` (both still off). **Firmware semantics changed** (OUT3 was "HIGH = limp"): CREW REVIEW.
- Kelly config PROPOSED: Three Speed = 1 or 2 with ECO = low speed. **LowSpeed DECIDED (Adam 2026-10-23): Fwd 30 % of Max Speed 6000 RPM ≈ 1800 RPM ≈ 15 mph, Rev 20 % ≈ 1200 RPM ≈ 10 mph** (122.5 RPM/mph SOURCED gearing; docs/KELLY_SETTINGS.md #29/30; the SOURCED Kelly default for Rev is 30 %). Three Gears (F/N/R) shares FWD pin 12 with the high-speed switch, so use ECO + max only (SOURCED note 4).
- **UNVERIFIED:** relay part (12 V automotive SPDT, e.g. Bosch-style 30/87a — not chosen), whether Adam's harness brings ECO out, the exact ECO pin on his connector, and that ECO really caps speed on his firmware (bench: ECO 12 V → RPM ≤ cap at full pedal).
- **Limp threshold (crew 2026-10-21, `BmsCore::kellyLogic`, PROPOSED + adjustable):**
  - **Soft derates only scale current smoothly**, with no Low cap: pack hot, low-ish cells at rest, pack/cell sag, discharge amps.
  - **Hard faults engage the Kelly Low cap** (≈ 15 mph forward / 10 mph reverse at the Kelly): current sensor lost (only when `CURRENT_SENSE_ENABLE=1`), **one LEM reading nothing or out of range** (|half| > `lemRangeA` 450 A, PROPOSED), temps stale (only when `TEMPS_VERIFIED=1`), any cell < `limpCellV` 3.00 V.
  - **LEM A vs B disagreeing** by > `imbalanceA` **60 A** for 1 s (crew 2026-10-21, was 100 A) = **SOFT** `imbalancePct` 50 % derate (PROPOSED, adjustable on the Thresholds page). It never triggers the Low cap.
  - Teensy A vs B disagreeing is handled by the throttle clamp (docs/THROTTLE_CLAMP.md), not here.
  - On a hard fault, power ramps from 100 % to `limpRampPct` 30 % over `limpRampMs` 1000 ms, then ECO asserts. It releases when the fault clears.
  - Note: a cell < 3.00 V for 500 ms also trips the existing hard-floor fault (mains open), so the cap only shows its ramp start there.
  - Tests: scripts/test_limp.cpp (11) + 3 wasm checks.
- Sim: Kid engages the cap. The "Both Teensys dead" toggle uses pedal-direct, so the relay drops and the Kelly holds Low (scripts/test_controls.js: forward capped at ≤ 1800 RPM ≈ 14.7 mph, about 14.3 mph at full pedal, vs uncapped > 3600 RPM; Kid with the Teensys alive still tops out under 10 mph; Kid reverse with both dead ≤ 1200 RPM ≈ 9.8 mph). A saved old 1225 RPM Low cap setting migrates to 1800.

## Limits / UNVERIFIED (crew)
- MCP4131 powers up at mid-scale (50 %) and holds its last wiper if a Teensy hangs: covered by the two-Teensy clamp (THROTTLE_CLAMP.md); sim scenario "digipot stuck 50% + A fault".
- Wiper topology (pot across pedal signal / ground) and the Kelly throttle input range are UNVERIFIED on the harness.
- Bit-banged on LIGHT_DATA/LIGHT_CLK with own CS: future 595 light code must not shift while the ISR writes (`g_busLock`).
- "Strong low end" cannot be added by a reduce-only trim; Mud/Sand are linear. Real boost would be a Kelly throttle-curve setting.
- Current limit is a pedal cap (torque request proxy), not measured amps; regen strength is sim-only (firmware does not drive Brake_AN yet).
- Top speed needs Kelly RPM (`BMS_CAP_KELLY_RX=0` today): without it, only Kid is enforced (output 0).
- Latency: host test 0.01 µs/tick; on the Teensy, analogRead ~17 µs + bit-bang ~4 µs (estimate) — measure `maxPeriodUs` < 2000 on the bench.

Tests: `scripts/test_drive_profile.cpp` (30 checks: curves, top speeds, trim ≤ pedal over 1.4 M random steps, wiper, fault → 0, ramps, Kid PIN, bounds, latency), wasm parity + sim top speed + Kid PIN in `check_bms_sim_wasm.js`, UI checks in `test_dash_ui.py`.
