Adampaleski/AmperaBattery/docs/schematic/teryx-system.png

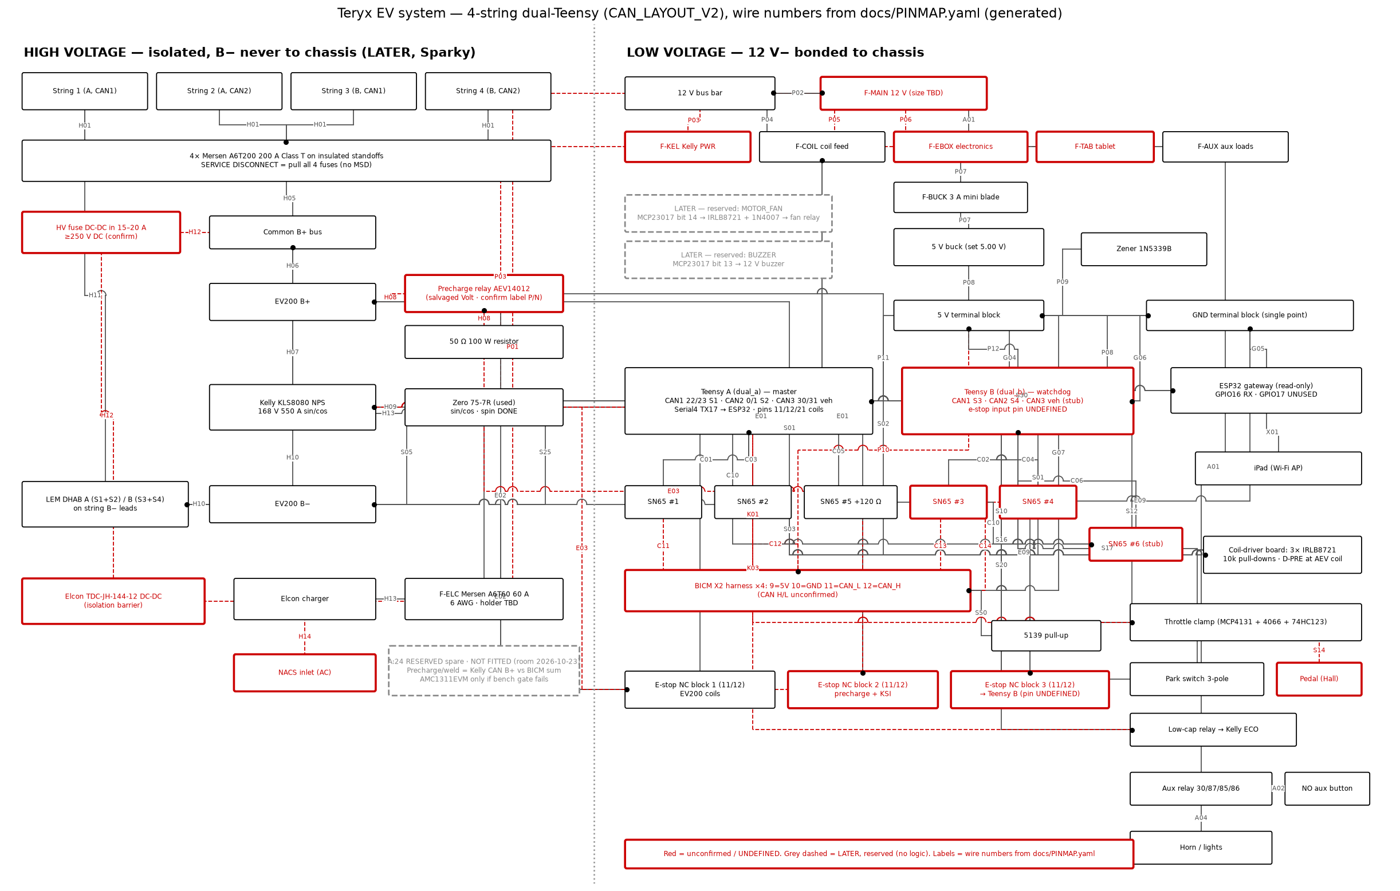
docs/schematic/teryx-system.png
