Adampaleski/AmperaBattery/docs/PARTS.md

# Teryx EV — Parts List (canonical)

Single source of truth: AmperaBattery `docs/PARTS.yaml` (this page is generated from it by `/workspace/teryx/tools_parts/build_parts.py`). Updated 2026-10-23 (America/Chicago).

## What Adam still needs to supply (no file answers these)

**Before first drive**
1. **Do you have these?** how many IRLB8721 FETs (coil driver needs 3, + 3 for Q4-Q6 outputs); DROK 5-pack bucks. _(LEMs answered 2026-10-23: 2× stock Volt DHAB S/44 owned.)_
2. **Labels**: 2nd owned M4 BICM (22880272?); precharge resistor (should read 50 Ω 100 W).
3. **Measurements**: chain length + center distance; 1/0 string-lead and 3/0 run lengths, 3/0 length on hand; Kelly coolant fitting size.
4. **Key switch** switched-output wire colour (find with a meter).
5. **'TNC' ×2** in cash's ledger: what is it?
6. **BICM M1 count**: how many 30S M1 boards are on the shelf (spares, not in the build).

_Answered 2026-10-23: Kelly = KLS8080 NPS 168 V 550 A with all add-ons (purchase email); motor = used Zero 75-7R, old-style flat-sided adapter, sin/cos sensor, bench-spun._

**LATER**: seat heater type; what park brake the Teryx has (photo); which tablet you'll use; tire sidewall size; actuator cable pull force.

_Crew decisions (not Adam): e-stop head XB4BS8442 (PROPOSED) vs XB5AS8442 — chief to confirm; pedal pick; fuse holders (F-MAIN, F-ELC, precharge, DC-DC); inlet model. DECIDED 2026-10-23: LM339, F-MAIN 150 A, F-ELC A6T60, AEV14012 coil 0.35 A, DC-DC TDC-JH-144-12, MCP4131-103E/P, CD74HCT123E._

## Active parts

| id | Part | Maker | Model | Qty | Status | Verified | Key specs | Open / conflict | PINMAP |
|---|---|---|---|---|---|---|---|---|---|
| vehicle | Base vehicle | Kawasaki | Teryx 750 4x4 (2008, KRF750A8F/B8F) | 1 | owned | yes | Final reduction 4.375:1 (35/8, front = rear) per 2008 owner's manual; 4WD engage = 12 V solenoid valve -> vacuum actuator 16172-0014 -> shift cable; diff lock = progressive lever + cable |  |  |
| motor | Traction motor | Zero Motorcycles | Zero 75-7R (used) | 1 | owned (bench-spun) | yes | Z-Force 75-7 family, R = high-temp magnets, passively air-cooled; OEM 28S (~116 V max); this build runs 36S (~148 V); Pole count UNVERIFIED (Kelly #59 assumes 8); temp sensor KTY84 UNVERIFIED; $1,004.38; Position sensor: sin/cos (Adam 2026-10-23); Shaft/sprocket adapter: old-style, plain cylinder with one flat side; Bench-spun on the Kelly before 2026-10-23 | RESOLVED: SOURCED (Adam 2026-10-23): used Zero 75-7R, old-style sprocket adapter (plain cylinder with one flat side), sin/cos position sensor (why the Kelly KLS8080 NPS was chosen); bench spin test DONE. Pole count and thermistor type still UNVERIFIED (Kelly #59 assumes 8 poles; KTY84 assumed): confirm on the bench/autotune, not a photo ask | H09 |
| controller | Motor controller | Kelly Controls | KLS8080 NPS, 168 V, 550 A (+ high-speed option, anti-slip, all add-ons) | 1 | owned | yes | Order #81746 (2025-05-03): 'KLS-8080N 144V 550A', NPS sin/cos, W3-GT2 liquid heatsink, 35-pin cable, USB cable, KLS test box; Adam 2026-10-17: '168 V version'; order listing range 72–168 V; KELLY_SETTINGS assumes KLS14601 (24–144 V nominal, 173 V max); Kelly catalog has no 550 A or 168 V/550 A SKU; PWR pin 7: 8–20 V isolated logic, ~30 mA; Firmware KELLY_MAX_V 168 V (Config.h:144) vs 173 V max in KELLY_SETTINGS; manual Rev 2.1.1 vs 2.1.0; Cost $1,407.97 all-in ($1,214.90 unit+test box) | RESOLVED: SOURCED (Adam 2026-10-23, Kelly purchase email screenshot): KLS8080 NPS, 168 V, 550 A, all add-ons incl. high-speed and anti-slip; no nameplate photo needed. Replaces KLS14551/KLS14601/KLS16xxx candidates; KELLY_SETTINGS (KLS14601 assumption) needs re-check for #7 overvoltage and #11 battery-current %. Sparky: re-check KELLY_SETTINGS #7 overvoltage and #11 battery-current % for the 168 V / 550 A unit | KELLY-J; H07; H09; H10; K01; K02; K03; P03; G02; F-KEL |
| kelly_test_box | Kelly KLS test box | Kelly Controls | KLS test box | 1 | owned | yes | $29.00 |  |  |
| kelly_prog_cable | Kelly programming USB cable | Kelly Controls | UNKNOWN (USB cable came with order #81746; CH341SER driver) | 1 | owned | no | Order #81746 lists a USB cable; Sparky lists it as NOT bought (~$19) | RESOLVED: Owned: Kelly order #81746 lists the USB cable (ledger; cash_parts_full KELLY-USB); Sparky 'not bought' is unsupported (was CONFLICT: ['owned (order #81746)', 'not bought (Sparky)']). Check it is in the Kelly box |  |
| kelly_heatsink | Kelly liquid-cooled heatsink | Kelly Controls | W3-GT2 | 1 | owned | yes | Came with order #81746 |  |  |
| axle | Custom drive axle | Perfection Driveline | UNKNOWN (custom) | 1 | owned | no | $975.35 (card stmt Nov 10); Feeds stock F/R diffs; pinions assumed OEM 8T/35T | Confirm axle pinions are still OEM 8T/35T (not recut) |  |
| sprocket_motor | Motor sprocket 16T | UNKNOWN | 50B16 (1" finished bore) | 1 | installed | yes | #50 pitch |  |  |
| sprocket_shaft | Shaft sprocket 32T + bushing | UNKNOWN | 50BTB32 + 2012 taper bushing 1-1/4" | 1 | installed | yes | 2:1 ratio; total 8.75:1 with 4.375 diffs |  |  |
| chain | Drive chain | NICHE | NICHE Gold 530 (on #50 / 50B sprockets) | 1 | owned | no | 530 and #50 share 5/8" pitch; roller width differs — fit on 50B sprockets to confirm; $53.45 eBay 09-13491-63261 | RESOLVED: Owned chain = NICHE Gold 530 (ledger receipt eBay 09-13491-63261) run on the #50 50B sprockets ('Chain is locked as 530 on the 50B 16T/32T sprockets', Mechanic memory profile:17); 'ANSI #50, not 530' (shop log:19) is the older sprocket-of-record note (was CONFLICT: ['NICHE Gold 530', 'ANSI #50 (50B)']). Length / link count and center distance not measured |  |
| chain_guard | Chain guard + tensioner | UNKNOWN | UNKNOWN (not chosen) | 1 | to-buy | no | Adam fab; CRITICAL before first drive | Choose part / fab design |  |
| tires | Tires | UNKNOWN | UNKNOWN (24 in measured) | 4 | owned | yes | 24 in measured 2026-10-21 (~49 mph @ 6000 rpm); older note said 27 in | RESOLVED: 24 in measured 2026-10-21 (shop log) supersedes 27 in 'locked' and 26x8-12/26x10-12 memory values (cash_parts_full TIERS). Tire + wheel model/size code (sidewall) — LATER |  |
| diffs | Front/rear differentials | Kawasaki | stock 2008 Teryx (8T/35T, 4.375:1) | 2 | installed | yes |  |  |  |
| pack | Traction pack (4 strings) | LG Chem (GM Chevy Volt Gen1) | 2014 Volt Gen1 modules, 36S4P (4× 36S strings) | 1 | owned | yes | Cells: 15 Ah pouches, 3P = 45 Ah groups; 6S (~22 V) and 12S (~44 V) bricks; Layout: 10×12S + 4×6S; 4 strings × 36S × 45 Ah = 180 Ah; ~148 V full @4.10 V/cell; ~24 kWh nominal; From 2 owned Volt packs (~$650 each, no receipt) | RESOLVED: cash_parts_full PACK-CELLS agrees. |  |
| bicm_m1 | Volt BICM M1 (30S) | GM | UNKNOWN GM P/N | 2 | UNVERIFIED spare (not in build) | no | 30S, 6/8/8/8 groups; NOT in the build (build = 2× M2 + 2× M3 + 4× M4); Qty 2 UNVERIFIED: no receipt (ledger) and no purchase in cash_parts_full; bench log shows an M1 (30 cells, 110.7 V) on 2026-10-14/15 | RESOLVED: M1 (30S) not used: strings are 24S (M2/M3) + 18S (M4, 12 ch used); kept as UNVERIFIED spares (Gilfoyle 2026-10-23 per crew). How many M1s are actually on the shelf (count + GM P/N label) |  |
| bicm_m2m3 | Volt BICM M2/M3 (24S) | GM | UNKNOWN GM P/N | 4 | owned | no | 2× M2 + 2× M3 owned; strings A2/B2 use 1 each, 2 spare; Per string: 1× 24S (M2/M3) + 1× M4 18S (12 of 18 ch) | RESOLVED: All 4 used: one 24S BICM (M2 or M3) per string. | X2-S1..S4 |
| bicm_m4 | Volt BICM M4 / VTSM#4 (18S) | GM | 22880272 (VTSM#4; buy-alternates 22885657 / 20955253 UNVERIFIED) | 4 | owned 2 / to-buy 2 | yes (1 unit) | ST L9763 monitor chips inside; one per string; Need 4, own 2 (1 label-confirmed) -> buy 2 used Gen1 pulls ~$50–70 ea | RESOLVED: GM P/N 22880272 read from label 2026-10-15 19:49 (shop log:275); 22885657/20955253 are unverified search alternates. Confirm 2nd owned M4 label says VTSM#4; Exact listing / part # to buy for 2 more | X2-S1..S4 |
| bicm_total | BICM count (summary) | GM | 2× M2 24S + 2× M3 24S + 4× M4 18S (22880272) | 8 | 6 owned (in-use mix) + 2 to-buy | yes | 2 BICMs per 36S string, 4 strings, 4 separate CAN buses | RESOLVED: 8 = 2× M2 + 2× M3 + 4× M4 (6 owned, 2 M4 to buy); ledger 'two TNCs + two BICMs total' superseded by cash correction 2026-10-21. | X2-S1..S4 |
| tnc | TNC (cash ledger item) | UNKNOWN | UNKNOWN | 2 | owned | no | cash ledger: 'Two TNCs + two BICMs total across whole build' (2026-10-21, later corrected for BICMs) | What is a 'TNC' here and its part #? (not in any crew doc) |  |
| lem | Hall current sensor | LEM | DHAB S/44 (stock Chevy Volt / Opel Ampera Gen1 HV pack current sensor, GM SI ref B30) | 2 | owned | yes (datasheet); GM P/N UNVERIFIED | One per string pair (A: S1+S2, B: S3+S4) on B−; Open-loop Hall, dual channel, analog ONLY (no CAN). Supply Vc 5.0 V (4.5-5.5 V), 15 mA typ / 20 mA max, 40 mA power-up inrush; abs max 8.5 V (14 V 1 min); Ch1 (LOW/fine range): -20..+20 A, Vo 2.50 V, 100 mV/A @Vc=5 V -> 0.5..4.5 V; global error ±0.25 A offset / ±0.45 A @20 A (25 °C); Ch2 (HIGH/coarse range): ASYMMETRIC -420..+230 A, Vo 3.08 V, 6.15 mV/A @Vc=5 V -> 0.497 V @-420 A .. 4.49 V @+230 A; global error ±3.5 A offset / ±8.5 A @-420 A (25 °C); Both outputs fully ratiometric (offset, gain, clamps): I = (Vout*5/Vc - Vo)/G. Output clamps 0.25 V / 4.75 V @Vc=5 V (DERIVED: Ch2 clamps ≈ -460 A / +271 A; Ch1 ≈ ±22.5 A); Load: RL >= 10 kΩ, CL 1-100 nF, Rout 1-10 Ω. Bandwidth 80 Hz (-3 dB) both channels; power-up 25 ms typ / 110 ms max; recovery after overload 25 ms; Current direction: datasheet arrow = POSITIVE primary current (Vout > Vo along arrow). Ch2 has 420 A on the NEGATIVE side, so the big (discharge) direction must flow AGAINST the arrow; Sensor connector pins (moulded A-D, datasheet): A = Ch2 high range, B = Vc +5 V, C = GND, D = Ch1 low range. GM harness: B/+5 V VT/RD (2965, 'pin 1' in SimpBMS/Vero tables), C/GND BK/GY (2963, 'pin 2'), A/high BU/YE (2962 coarse, 'pin 3'), D/low GN/BN (2961 fine, 'pin 4'); Mating connector TE 1-1456426-5 (4-way), terminals 1418850-1, seals 964972-1 (openinverter wiki); Teensy 4.1 (3.3 V ADC, NOT 5 V tolerant): divide both outputs (e.g. 10k/20k = 0.667 -> 4.75 V clamp = 3.17 V), 10-47 nF at ADC pin, measure Vc on a 3rd ADC via same divider for ratiometric correction; Teryx use: one per string pair (A: S1+S2, B: S3+S4) on B-; ~275 A each at 550 A Kelly peak -> within Ch2 discharge side ONLY if mounted with discharge against the arrow (backwards = clamps at +271 A) | RESOLVED: VERIFIED 2026-10-23 (Sparky) from LEM DHAB S/44 datasheet + SimpBMS/Vero harness tables + GM SI circuits. Ownership: Adam 2026-10-23 via chief: 2 stock Volt pack current sensors at his bench (was CONFLICT: ['owned (Sparky, COMPONENTS.md)', "ownership UNCONFIRMED (cash, shop log 'if owned')"]). GM part number UNVERIFIED: not found in GM parts catalogs (B30 appears serviced with the A28 contactor assembly — also UNVERIFIED); read the label on the sensor if ever needed (not an Adam ask); Volt Gen1 in-car orientation (discharge = against arrow / negative) is INFERRED from the -420/+230 range and builder notes, not from a GM document; bench-confirm: small known discharge must pull Ch1 below 2.50 V; Response time tr: datasheet defines it but gives no number; only BW 80 Hz (≈4-5 ms 10-90% rise, DERIVED) — fuses, not this sensor, must clear shorts; SimpBMS/Vero 'pin 1-4' numbering is harness-side order, not the moulded A-D letters; wire by letter/colour | S05; S06; S07; S25; S26; S27; H11; G09; G10 |
| teensy | Microcontroller (BMS A + B) | PJRC | Teensy 4.1 | 2 | owned | yes | 3 native CAN; 3.3 V I/O only; cut VIN/VUSB pad | RESOLVED: 2 owned: 1 receipt in ledger ($45.77) + 2nd bought 2026-10-17 (shop log:279); cash_parts_full TEENSY qty 2 owned (was CONFLICT: ['2 owned (COMPONENTS, shop log 10/17 2nd bought)', "shop-log:294 '1st Teensy' only (older)"]). 2nd Teensy receipt/price not on file | P11; P12; G04; G06; C01; C02; C03; C04; C05 |
| teensy_breakout | Teensy breakout | Treedix | UNKNOWN (Treedix Teensy breakout) | 1 | owned | no | $14.97 |  |  |
| sn65 | CAN transceiver | TI (Waveshare / WaterLong modules) | SN65HVD230 (Waveshare SN65HVD230 CAN Board) | 6 | owned 4 / to-buy 2 | yes | 3.3 V; 4 BICM buses + 2 vehicle bus |  | C01; C02; C03; C04; C05; C10; C11; C12; C13; C14 |
| mcp2515 | CAN controller module | Microchip (module) | MCP2515 | 1 | owned (not used) | yes | Bought with 2× ESP32 + LM2596 kit $54.39; current CAN_LAYOUT_V2 uses Teensy native CAN (role UNVERIFIED) | RESOLVED: Owned but NOT needed: 2 Teensys give 5 native CAN buses (cash_parts_full MCP2515-KIT). |  |
| esp32 | ESP32 gateway | Espressif (DevKit) | ESP32 DevKit (exact board UNKNOWN) | 2 | owned | partial | Serial4 from Teensy A @115200; first drive uses laptop USB instead (LATER) |  | S30; G05; X01 |
| buck_lm2596 | Buck converter | UNKNOWN | LM2596 module | 1 | owned | yes | bench power — see docs/BENCH.md §2 (BENCH_POWER, DECIDED chief 06:57 #7) |  |  |
| buck_drok | Mini buck 12->5 V | DROK | UNKNOWN (DROK mini buck, 4.5–20 V in, 3 A) | 5 | owned (5-pack, considering) | no | 1 used on the first-drive board (bms_master PS1: Teensy A + B, LEM, pedal, clamp); the rest are spares (chief 06:57 #4) | Confirm 5-pack is owned — pending Adam (chief 06:57 #4) | P07; P08; G03; F-BUCK; TB-5V |
| contactor_main | Main contactors B+ / B− | TE Connectivity (KILOVAC) | EV200HAANA (1-1618002-8) | 2 | owned | yes | 500 A carry, 12–900 VDC, 12–24 V economized coil (3.8 A inrush 130 ms, 0.13 A hold), aux NO; Open-box, eBay ecrunch $31.65 ea, bought 2026-10-20 | RESOLVED: Qty 2: ledger shows 2 bought 10/20 (cash_parts_full EV200); no file records a 3rd — Sparky's spare is unbought/optional (was CONFLICT: [2, '3 incl spare (Sparky)']). NO 3rd EV200 to buy (Adam 2026-10-23): spare role covered by owned Volt AEV14012 (aev_spare) | H06; H07; H10; E02; S01; S03 |
| precharge_relay | Precharge relay | Panasonic | AEV14012 (salvaged Volt Gen1 main) | 1 | owned | yes | Coil 0.35 A @12 V / ~0.41 A @14.0 V, 34 Ω, 4.2 W, no economizer; 120 A cont / 225 A 3 min / 450 VDC | RESOLVED: Coil 0.35 A @12 V (34 Ω, 4.2 W, NOT economized), ~0.41 A @14.0 V DC-DC; no 3 A peak (EV200 carry-over). Source: Panasonic EV relay catalog (Sparky decision 2026-10-23) (was CONFLICT: ['~0.35 A not economized (ESTOP.md:38, cutsheet)', '~3 A peak (PINMAP, Config.h:192)']). Confirm label P/N | H08; E03; S02; S08 |
| aev_spare | Spare Volt contactor (branch/spare) | Panasonic | AEV14012 | 1 | owned | partial | Volt Gen1 main contactor, 120 A cont / 225 A 3 min / 450 VDC: OK for precharge, charger or DC-DC branch, or as a spare precharge relay. NOT a main contactor (Kelly battery limit ~270 A on 2 strings, 550 A rated) |  |  |
| precharge_res | Precharge resistor | UNKNOWN | UNKNOWN (50 Ω 100 W, came with Kelly) | 1 | owned | no | Kelly input capacitance (~2 mF) UNVERIFIED | Read resistor label to confirm 50 Ω 100 W | H08 |
| fuse_a6t200 | String fuses (Class T 200 A) | Mersen | A6T200 | 4 | owned | yes | 200 A Class T, 300 VDC; bolt to bus bar on standoffs; bought 2026-10-20 $36.20 ea | No spare bought | F-S1..S4; H01; H05 |
| precharge_fuse | Precharge fuse | Littelfuse | KLKD-005 | 1 | to-buy | no | 5 A 600 VDC midget, $10.84 |  |  |
| charger_fuse | Charger branch fuse | Mersen | A6T60 | 1 | to-buy | no | 60 A 300 VDC Class T, $36.69; holder UNKNOWN; Wire 6 AWG; For Elcon HK-LF-144-46 (46 A max) | RESOLVED: Mersen A6T60 60 A (1.25 × 46 A Elcon max) on 6 AWG (Sparky decision 2026-10-23; cash buylist); PINMAP F-ELC '~40-60 A' is stale (was CONFLICT: ['60 A A6T60 (cash)', '60-70 A >=250 VDC (TIERS:68)', '~40-60 A (PINMAP F-ELC)', '1.25x46 = 57.5 A (BACKLOG:19)']). Fuse holder not chosen | F-ELC; H13 |
| dcdc_fuse | DC-DC branch fuse | Littelfuse | KLKD-020 | 1 | to-buy | no | 20 A 600 VDC midget, $10.84; holder (e.g. USM1) UNVERIFIED | Holder part | F-DCDC; H12 |
| cable_3_0 | HV main cable 3/0 | TEMCo | 3/0 welding cable (WC0263 for 10 ft add-on) | 1 | owned + to-buy | no | $137.83 owned (length UNKNOWN); +10 ft WC0263 $70.34 out of stock | Length on hand | H05; H06; H07; H10 |
| cable_1_0 | String leads 1/0 | UNKNOWN | UNKNOWN | 1 | to-buy | no | 1/0 from each A6T200 (~138 A at 550 A launch) | Run lengths (Adam measure) | H01; H11 |
| lugs | Tinned ring lugs 3/0 + 1/0 | TEMCo | 3/0 3/8" tinned 10-pk (1/0 UNKNOWN) | 1 | to-buy | no | $18.80 |  |  |
| splices | 2 AWG butt splices | TEMCo | 2 AWG butt splices | 1 | owned | yes | $12.79 |  |  |
| busbar | Bus bar, standoffs, clear cover | UNKNOWN | UNKNOWN (fab) | 1 | to-buy | no | Tool-only cover, captive screws |  |  |
| insul_wrench | Insulated wrench | UNKNOWN | UNKNOWN | 1 | to-buy | no | For pulling bolt-in string fuses |  |  |
| hv_loom | HV orange loom, clamps, grommets | UNKNOWN | UNKNOWN | 1 | to-buy | no | Clamp every ~12 in |  |  |
| coil_fet | Output FETs Q4-Q6 (LIMP/ECO relay A:20, DERATE A:2, REGEN A:3) | Infineon | CONFLICT: IRLB8721PbF (owned per Sparky) vs IRLB3813PbF (to-buy per cash; 8721 discontinued) | 3 | CONFLICT | no | Logic-level @3.3 V gate; 6 on outputs board; Contactor-coil FETs Q-B+/Q-PRE/Q-B− moved to coil_driver/cd_fet 2026-10-23 (qty 6 -> 3; do not double-buy) | **CONFLICT** IRLB8721 OWNED (Sparky); IRLB3813PBF to-buy ×2 ~$2.81 (cash). Are IRLB8721s in hand? | S20 |
| estop_head | E-stop mushroom head (1 NC incl.) | Schneider Electric (Harmony) | XB4BS8442 (PROPOSED; alternate XB5AS8442) | 1 | to-buy (PROPOSED) | no | 40 mm red twist-release, 1 NC included, ~$28.89 | RESOLVED: PROPOSED (not chief-confirmed): XB4BS8442 metal = Mechanic's pick, matches shop log; XB5AS8442 plastic = alternate (Mechanic 2026-10-23) (was CONFLICT: ['XB4BS8442', 'XB5AS8442']). chief confirm XB4BS8442 vs XB5AS8442 | ESTOP; E01; E02; E03; E09; F-COIL |
| estop_blocks | E-stop extra NC blocks | Schneider Electric | ZBE102 | 2 | to-buy | no | 1 NC each; 0.55 A @125 V DC-13; 3 NC total with head ($9.89 ea) |  | ESTOP; E01; E02; E03; E09 |
| estop_box | E-stop guarded IP65 box + guard | Schneider (guard ZBZ1604 option) | UNKNOWN | 1 | to-buy | no | Sealed, guarded box deep enough for 3 stacked ZBE102 blocks | Box model; ZBE102 qty here says 3 stacked vs estop_blocks qty 2 (+ head's built-in NC): confirm block count |  |
| isolation_tester | Insulation (megger) tester | UNKNOWN | UNKNOWN | 1 | to-buy / borrow | no | 500 V, ≥1 MΩ check before HV |  |  |
| hv_sense | Isolated HV voltage sensor | Texas Instruments | AMC1311EVM | 1 | LATER (dropped) | yes | Only if Kelly CAN B+ bench gate fails (~$50); room decision 2026-10-23 |  | S08 |
| charger | On-board charger | Elcon (TC Charger) | HK-LF-144-46 (config CAN3865) | 1 | owned | yes | Label read 2026-10-15: in 90–264 VAC 45–65 Hz 32 A; out 100–202 VDC 46 A; SN23100137B; CAN 250 kbps, IDs 0x1806E5F4 / 0x18FF50E5; 'E5' was the CAN-ID sticker, not the model; older 'HK-MF-xxx' notes are SUPERSEDED |  | CAN-V; F-ELC; C10; H13; H14 |
| dcdc | DC-DC converter HV -> 12 V | Elcon (TC Charger) | TDC-JH-144-12 (CAN5100, S/N 220301526) | 1 | owned | yes | Per 10/15 label read: in 88–195 VDC, out 14.0 V 110 A, CAN5100, S/N 220301526; Isolation input↔12 V− UNVERIFIED (test before chassis bond); Rated output amps set F-MAIN fuse and P01 gauge; 1.5 kW; out 14.0 V 110 A (sets F-MAIN ≈1.25×110 A and P01 gauge) | RESOLVED: RESOLVED: TDC-JH-144-12 per label read 2026-10-15 20:44 (shop log:236 'NOT the TDC-IY in prior notes'; also shop log:64,294; cash_parts_full DCDC); TDC-IY = stale (was CONFLICT: ['TDC-JH-144-12', 'TDC-IY']). Isolation test (HV in to 12 V−) before 12 V− chassis bond; price not on file | P01; F-MAIN; H12; F-DCDC |
| lv_battery | 12 V buffer battery | UNKNOWN | UNKNOWN | 1 | to-buy | no | Keeps contactors fed if DC-DC drops (review 2026-10-23); + post -> F-BATT 150 A (≤ 7 in) -> 12 V bus + (P13/P14, 2 AWG, PROPOSED); - post -> TB-GND/chassis (G13, 2 AWG, PROPOSED) — Sparky 2026-10-23 07:34 CT (DECIDED) |  | F-BATT; P13; P14; G13; F-AUX |
| ac_inlet | AC inlet | UNKNOWN | UNKNOWN (NACS / J3400 AC inlet, model not chosen) | 1 | LATER | no | Simple NACS: fixed resistors + diode on pilot caps Elcon ~12 A | RESOLVED: NACS AC inlet only, no J1772 (Adam 9/25 via Sparky; shop log:77,201); older 'NACS or J1772' (shop log:296) stale. Specific inlet model not chosen.. Adam: home outlet / plug types; choose NACS vs NEMA | S45; H14 |
| ac_contactor | AC contactor (BMS-controlled) + 2-pole breaker | UNKNOWN | UNKNOWN | 1 | to-buy (PROPOSED) | no | Stays CRITICAL for charging path | Pick parts after inlet choice |  |
| lm339 | Plug + latch detect quad comparator | TI (or any) | LM339 | 1 | to-buy | no | Quad comparator for NACS AC inlet (Adam chose NACS 9/25); Pinout (TI LM339 datasheet, SOURCED): 1 OUT2, 2 OUT1, 3 VCC, 4/5 IN1−/IN1+, 6/7 IN2−/IN2+, 8/9 IN3−/IN3+, 10/11 IN4−/IN4+, 12 GND, 13 OUT4, 14 OUT3; ch1 OUT1 (2) -> A:33 plug A (S41), ch2 OUT2 (1) -> B:33 plug B (S44): 2.5 V ref (S48); ch3 OUT3 (14) -> 1k -> A:2 release A (S51), ch4 OUT4 (13) -> 1k -> B:35 release B (S52): 1.40 V ref = 10k/3.9k from 5 V (S53); own 10k pull-up + 100 nF per output; No hysteresis resistors: 100 nF at each pin + 20 ms firmware debounce (DECIDED Sparky 06:57 #3); VCC 5 V pin 3, GND pin 12 (S47/S49) | RESOLVED: DECIDED 2026-10-23 (crew): LM339 replaces LM393; re-pinned + release detect on A:2/B:35 DECIDED chief + Sparky 06:57 (Build 24). Not owned: purchase pending (no purchases by Gilfoyle); Firmware must set A:2 INPUT and read plug/release with 20 ms debounce (not implemented; no flashing) | S41; S44; S46; S47; S48; S49; S51; S52; S53 |
| lv_fuses | Mini-blade fuses + holders | Nilight / VANSIHO | Amazon B0B24YYYCF / B0C15H3F9M | 1 | to-buy | no | Shop-kit list 2026-10-11 |  |  |
| deutsch | Deutsch DT kit + crimper | ALFOCI | Amazon B0DZ331GDL (217 pc) | 1 | to-buy | no | $38.99 |  |  |
| txl | TXL wire 16–20 AWG | crimpzone | UNKNOWN | 1 | to-buy | no | $15–70 |  |  |
| heat_shrink | Adhesive heat shrink 3:1 | Wirefy | Amazon B084GDLSCK | 1 | owned | yes | $14.99 |  |  |
| pedal | Dual-track Hall throttle pedal | Subaru (via EV West) recommended | UNKNOWN (not chosen): Subaru WRX/STI 2008–14 used (rec, $119) / Toyota Prius 78120-47050 ($139) | 1 | to-buy | no | Track 1 to Kelly, track 2 to Teensy | Adam pick; must fit floor/travel with return spring + hard stop | S14; S15; P20; G11 |
| digipot | Throttle clamp digipot | Microchip | MCP4131-103E/P | 2 | to-buy | no | 10 k, 7-bit, SPI, DIP-8; DECIDED 2026-10-23 (crew): firmware ThrottleTrim, perfboard U3 and wiring_data all use MCP4131; MCP41010 needs a different SPI command byte; Buy from Digikey/Mouser (Tayda does not stock it) |  | S10; B02 |
| analog_switch | Throttle clamp analog switch | TI | CD74HC4066E (cash: generic CD4066) | 2 | to-buy | no | Quad bilateral switch |  | B02; K01 |
| oneshot | Throttle clamp one-shot | TI | CD74HCT123E | 2 | to-buy | no | Dual retriggerable monostable, DIP-16; DECIDED 2026-10-23 (crew): clamp runs at 5 V (ASSUMED); HCT TTL input threshold accepts the Teensy 3.3 V alive outputs, HC at 5 V needs 3.5 V VIH and fails; Buy from Digikey/Mouser (not Tayda) |  | S11; S12 |
| buffer | Throttle clamp buffer | TI | SN74AHCT125N | 1 | to-buy | no |  |  | S10; S11 |
| io_expander | Body I/O expander | Microchip | MCP23017 | 1 | to-buy (PROPOSED) | no | LATER — footprint only on bms_master (U6, not fitted); 0x20 (A0-A2 to GND), 4.7k SDA/SCL pull-ups to 3.3 V, RESET high via 10k (DECIDED chief 06:57 #3) |  |  |
| key_switch | Key switch | Kawasaki | stock Teryx key switch | 1 | installed | no | Switched output wire colour UNKNOWN | Backprobe wire colour | S42; S43 |
| park_switch | Park-brake switch | Potter Amseco | PSW-2B (1 NO + 1 NC) placeholder | 1 | LATER | no | Sealed UTV-grade part UNKNOWN |  | S16; S17; K02; X02 |
| radiator | Radiator + fan | Kawasaki | stock Teryx radiator + fan | 1 | owned | yes | Fan always-on/thermoswitch for first drive |  |  |
| pump | 12 V coolant pump | Bosch | 0392022010 (candidate) | 1 | to-buy | no | ~$161.99, 5/8" ports | Kelly fitting + radiator neck OD (measure) |  |
| actuators | 4WD + diff-lock linear actuators | Glideforce | LACT4P-12V-10 (or -20 if pull >30 lb) | 2 | LATER | no | Cables pinned 2WD/open for first drive; Stall 7 A @12 V; alt Firgelli 4in 150 lb $149.99 | Cable pull force + travel |  |
| hbridge | Actuator H-bridge drivers | UNKNOWN | BTS7960 module (alt VNH5019) | 2 | LATER | no | 3 if e-park |  |  |
| heater | Battery coolant heater | Hotstart | CB115110-200 (deferred) | 1 | LATER | no |  |  |  |
| seat_heaters | Seat heaters | UNKNOWN | UNKNOWN | 2 | LATER | no |  | Adam: seat heater type |  |
| tablet | Dash display | UNKNOWN | CONFLICT: Surface 3 (COMPONENTS) vs iPad (schematic/gen.py:39) vs Android 10-11in to buy (TIERS:72) | 1 | LATER | no |  | **CONFLICT** Surface 3; iPad; Android tablet. | P06; F-TAB; X01 |
| contactor_upgrade | Main contactor optional upgrade | Gigavac | GX14BA | 2 | PROPOSED (optional, undecided) | no | 525 A / 10 s; $205 ea |  |  |
| ivt_s | Optional CAN current sensor | Isabellenhuette | IVT-S-1K-U3-I-CAN1-12/24 (alt CAB300, no full model) | 1 | PROPOSED (optional) | no | 1000 A, 500 kbps CAN; not owned |  |  |
| clr_diode | Throttle clamp /CLR diode D5 | UNKNOWN | 1N4148 | 1 | to-buy (PROPOSED) | no | across R5 10k with C5 1 uF |  |  |
| kelly_cutback_iface | Kelly limp/regen-inhibit interface | UNKNOWN | PC817 opto or 2N7000 + 1k | 3 | PROPOSED | no | OUT3 limp / OUT6 regen inhibit; KLS regen input UNVERIFIED |  |  |
| eco_relay | Kelly ECO Low-cap relay | UNKNOWN | UNKNOWN (12 V SPDT Bosch-style 30/87a, not chosen) + FET + 1N4007 | 1 | PROPOSED | no |  |  | S20; K03 |
| hbridge_alt | H-bridge alternative | ST | VNH5019 | 0 | alternative only | no | If BTS7960 3.3 V logic fails |  |  |
| perfboard_kit | Perfboard/bulkhead parts | various | SMBJ18A TVS; JST-XH; DT04/DT06; 120 Ω; 100 uF; 10k/18k 1%; 100 nF; 90x150 perfboard; 100 Ω/10k gate R; 1N4007; inline holders + 1 A fuses; panel micro-USB; M3 standoffs | 1 | to-buy | no | open checklist |  |  |
| tvs | TVS diode | UNKNOWN | SMBJ18A | 3 | to-buy | no | 12 V rail protection |  |  |
| can_term | CAN terminators | UNKNOWN | 120 Ω 1/4 W | 5 | to-buy | no |  | Final count | C05; C06; C10 |
| key_opto | Key-on optocoupler | Sharp | PC827 (PROPOSED) | 1 | to-buy | no | 2-ch, 1k5 LED resistor |  | S42; S43 |
| zener_5v | 5 V rail zener clamp | UNKNOWN | 1N5339B | 1 | to-buy | no |  |  | P09; TB-5V |
| usb_ext | Panel-mount USB extension | UNKNOWN | UNKNOWN | 2 | to-buy | no |  |  |  |
| ebox_enclosure | Electronics enclosure | UNKNOWN | UNKNOWN | 1 | to-buy | no |  |  |  |
| estop_guard | E-stop guard ring | Schneider Electric | ZBZ1604 | 1 | LATER | no | ~£48.48 |  |  |
| iso_monitor | Isolation monitor (on-board) | UNKNOWN | UNKNOWN (not chosen) | 1 | LATER | no |  |  |  |
| lugs_1_0 | 1/0 lugs + hydraulic crimper | UNKNOWN | UNKNOWN | 1 | to-buy | no |  |  |  |
| ac_breaker | AC 2-pole breaker | UNKNOWN | UNKNOWN | 1 | LATER (PROPOSED) | no |  |  |  |
| park_actuator | Electric park-brake actuator | Glideforce | LACT4P-12V-20 (PROPOSED) | 1 | LATER | no | 110 lb; needs 3rd BTS7960 |  |  |
| lights | Lights + relays | UNKNOWN | UNKNOWN | 1 | LATER | no | head lo/hi, tail, brake, turn, reverse, bar, work |  |  |
| rad_fan_relay | Radiator fan relay + 15 A fuse | UNKNOWN | UNKNOWN | 1 | LATER | no | stock fan reused |  |  |
| motor_fan | Motor cooling fan | UNKNOWN | UNKNOWN | 1 | LATER | no | MCP23017 bit 14 via FET + relay |  |  |
| iso_audio | Ground-loop isolator | UNKNOWN | UNKNOWN | 1 | LATER | no | $10.00 |  |  |
| bt_key | Bluetooth phone key | Walfront | Walfront BT proximity relay (or spare ESP32) | 1 | LATER | no | $17.16 |  |  |
| aux_button | Aux push button (horn / lights), normally open | Schneider Electric | ZBE101 (1 NO contact block; operator/head model not named) | 1 | LATER (PROPOSED) | no | NO contact switches only the relay coil (86); small fuse 2 A PROPOSED; Qty per aux load not fixed (horn, lights) | Button head/operator model and how many buttons (horn, lights) | A02 |
| aux_relay | Aux load relay | UNKNOWN | UNVERIFIED (12 V automotive relay 30/87/85/86, part not chosen) | 1 | LATER (PROPOSED) | no | Coil 85/86 switched by aux button; load via 30/87 through F-AUX (PROPOSED 10-15 A, size to load) | Relay model/rating once loads are chosen | A01; A02; A03; A04; F-AUX |
| fuse_main | Main 12 V fuse F-MAIN (DC-DC out, bus end: P01 -> F-MAIN -> P02) | UNKNOWN | 150 A MIDI/MEGA bolt-down fuse (exact P/N + holder not chosen) | 1 | to-buy | no | 150 A MIDI/MEGA bolt-down (DECIDED Sparky 07:34; TDC-JH-144-12 = 110 A out, SOURCED); At the DC-DC 12 V output, bus end, as drawn (DECIDED Sparky 07:34); P01 + P02 = 2 AWG 105 °C copper (DECIDED Sparky 07:34); P01 run under 5 ft (DECIDED) | Fuse P/N and holder (TBD) | F-MAIN; P01; P02 |
| coil_driver | Contactor coil-driver board (3 ch low-side: Q-B+ Main+, Q-PRE precharge, Q-B− Main−) | self-built | Perfboard build (PROPOSED; PCBWay 2-layer only after the circuit is proven, per Sparky) | 1 | to-build (PROPOSED) | no | ASSEMBLY. Children: cd_fet ×3, cd_rgate ×3, cd_rpull ×3, cd_flyback ×1, cd_board ×1, cd_term ×1; Q-B+ <- Teensy A:11 (S01) -> EV200 B+ coil −; Q-PRE <- A:12 (S02) -> AEV14012 coil −; Q-B− <- A:21 (S03) -> EV200 B− coil − (SOURCED PINMAP); LOW SIDE ONLY (DECIDED room 2026-10-23 06:11, Sparky + chief): the board switches coil − to ground only; coil + is fed off-board from F-COIL (10 A PROPOSED) through the e-stop NC blocks (E01-E03); no 12 V on the board (J-12V deleted); Grounding (DECIDED room 06:11): FET sources + pull-downs + Teensy signal ground (J-SIG.1, in the gate cable) meet at ONE star hole V22; the only other ground lead is the coil return: doubled 20 AWG solid bus on board -> J-GND.2 5.08 mm screw terminal rated ≥10 A -> TB-GND 16 AWG (G08; DECIDED Sparky 06:57 #5); no Teensy GND wire at TB-GND (G04 dropped); Loads: AEV14012 0.35 A @12 V / ~0.41 A @14 V, not economized (SOURCED Panasonic via Sparky); EV200HAANA 3.8 A inrush max 130 ms, 0.13 A hold @12 V (SOURCED TE datasheet); Replaces Q1-Q3 (MAIN+/MAIN−/PRECHG) of the perfboard/BOM.md outputs daughterboard; Q4-Q6 stay on coil_fet; Install: guided_install/coil_driver.md (draft, after Build 18) | Board size/layout not fixed (perfboard first; PCBWay later per Sparky 05:36) | S01; S02; S03; F-COIL; E01; E02; E03; G08 |
| cd_fet | Coil-driver N-FETs (TO-220, G-D-S) | Infineon | IRLB8721PbF | 3 | UNVERIFIED (asked Adam if on hand) — to-buy if not | no | Q-B+ = Teensy A:11 (S01) -> EV200 B+ coil −; Q-PRE = Teensy A:12 (S02) -> AEV14012 coil −; Q-B− = Teensy A:21 (S03) -> EV200 B− coil −; RDS(on) is only rated at VGS ≥ 4.5 V; 3.3 V gate drive must be bench-checked (coil pulls in fully from the Teensy pin) — Sparky 05:31; No heatsink needed at these currents (Sparky 05:35) | How many IRLB8721 does Adam actually have? (coil_fet CONFLICT: cash lists IRLB3813PBF to-buy, 8721 discontinued) | S01; S02; S03 |
| cd_rgate | Coil-driver gate series resistors | UNKNOWN | 100 Ω through-hole (power rating not in sources; 1/4 W PROPOSED) | 3 | to-buy (or from perfboard_kit stock) | yes | One per gate: Teensy pin -> 100 Ω -> FET gate (S01-S03) |  | S01; S02; S03 |
| cd_rpull | Coil-driver gate pull-down resistors | UNKNOWN | 10 kΩ through-hole (power rating not in sources; 1/4 W PROPOSED) | 3 | to-buy (or from perfboard_kit stock) | yes | One per FET, gate to source/GND: keeps the FET off while the Teensy boots (check: gate-GND ≈10 kΩ, chief review #10) |  | S01; S02; S03 |
| cd_flyback | Coil flyback diode — AEV14012 precharge coil only, mounted AT THE COIL | UNKNOWN | 1N4007 (plain, no zener) — DECIDED | 1 | to-buy (DECIDED) | no | DECIDED (Sparky 2026-10-23 05:41 CT, confirmed room 06:11): plain 1N4007 directly across the AEV14012 coil terminals, cathode (band) to coil +, anode to coil − / Q-PRE drain; no zener; Mounted at the coil, not on the driver board; Why no zener: IRLB8721 is only rated 30 V; the slower release is fine because Main+ carries the current and the 50 Ω precharge resistor limits a fault to ≈3 A (Sparky 05:41); EV200 B+ / B− coils: NO external diode — TE datasheet built-in economizer 'limits back EMF to 0V' (DECIDED Sparky 05:41; perfboard/BOM.md:36,54 agrees) |  | S02; E03 |
| cd_board | Coil-driver board stock | UNKNOWN | Plated-through, double-sided perfboard (size not chosen) — Sparky 05:35 | 1 | to-buy (PROPOSED) | partial (guidance only) | Coil-current paths (coil −, FET, ground return) in solid-core 18-20 AWG or solder-filled trace, not thin jumper wire; Low side only (DECIDED room 06:11): all FET sources to one star hole; coil return (doubled 20 AWG on board, J-GND.2 5.08 mm ≥10 A screw terminal, 16 AWG G08 to TB-GND; Sparky 06:57 #5) is the only ground lead besides the Teensy signal ground J-SIG.1 (G04 dropped); Standoffs in a sealed box; conformal coat or hot glue on heavy parts after the bench test; Alternative: PCBWay/JLCPCB 2-layer ≤100×100 mm, ~$5 for 5 + ~$15-30 DHL, ~$20-40 all-in, 1-2 weeks (Sparky typical figures, no live quote); ≥1 mm traces, 1 oz Cu, back ground pour, through-hole only | Board size and enclosure (shares ebox_enclosure?) |  |
| cd_term | Coil-driver off-board terminals + strain relief | UNKNOWN | UNKNOWN (screw terminals or locking JST, Sparky 05:35) | 1 | to-buy (PROPOSED) | no | Low side only (DECIDED room 06:11): J-SIG 4 pos (signal GND + 3 gates from Teensy A, S01-S03); 3 coil − outputs; J-GND coil return = 5.08 mm screw terminal rated ≥10 A taking 16 AWG to TB-GND (G08, DECIDED Sparky 06:57 #5; model UNVERIFIED); no 12 V terminal (J-12V deleted); Leads tied down; never a bare solder joint holding a wire (Sparky 05:35) | Terminal type/count once layout is fixed | S01; S02; S03; G08 |
| lv_tb | LV distribution terminal blocks — 5 V rail (TB-5V) + single-point GND (TB-GND) | UNKNOWN | UNKNOWN (type/position count not chosen; barrier or DIN terminal block PROPOSED) | 2 | UNVERIFIED (not on any cash ledger; may be in perfboard_kit stock) | no | TB-5V: Teensy A VIN, Teensy B VIN, LEM 5 V, pedal 5 V, clamp chips (SOURCED docs/PINMAP.yaml TB-5V; fed from buck_drok via F-BUCK); TB-GND: single-point ground for all LV grounds (SOURCED docs/PINMAP.yaml TB-GND; tools/schematic/gen.py 'gnd'); TB-GND = LV STAR: G03 (bms_master J-PWR.2, the ONE board link), G07, G08 (coil_driver return) — DECIDED chief 06:57 #5; Position count = rows in PINMAP TB-5V/TB-GND plus spares (PROPOSED) | Which terminal block, how many positions, already on hand? | TB-5V; TB-GND; G03; G07; G08 |
| bms_master | BMS master board (Teensy A + B, 6× SN65HVD230, 5 V buck, LEM/pedal dividers, throttle clamp, LM339 plug/release detect, MCP23017 footprint LATER) | self-built | Perfboard build (PROPOSED) | 1 | to-build (PROPOSED) | no | ASSEMBLY. Children (new parts): bm_board ×1, bm_term ×13, bm_hdr ×2, bm_res ×11, bm_cap ×3; uses existing parts: teensy, sn65, buck_drok, lv_fuses, zener_5v, can_term, oneshot, analog_switch, digipot, buffer, lm339, io_expander, clr_diode, perfboard_kit; Every pin and net from docs/PINMAP.yaml (wire ids in each net desc) + docs/THROTTLE_CLAMP.md (SOURCED); layout PROPOSED; One signal-ground star bar; each ground group joins it once (S49 single-point ground, same rule as coil_driver V22); ESP32 is off-board (J-ESP terminal); coil_driver is a separate board (J-DRV -> J-SIG, S01-S03); Build 24 (bms_master_answers.md (chief + Sparky 2026-10-23 06:57 CT, DECIDED)): LM339 ch1-4 -> A:33/B:33/A:2/B:35; release outputs via 1k + own 10k pull-up + 100 nF (S51/S52, ref S53); J-REL removed; MCP23017 U6 footprint only; LEM A/B, pedal, Kelly RTN each own star hole (G09-G12); J-PWR.2 the ONE link to TB-GND (G03) | SN65 modules: wire by SILKSCREEN (pin order varies by vendor); keep R2 '121' only at a physical bus end; CANH-CANL ≈60 Ω powered off (DECIDED Sparky 06:57 #2); Firmware must set A:2 INPUT (boots as output); plug/release not read yet — later commit, no flashing | C01; C02; C03; C04; C05; C06; C10; C11; C12; C13; C14; P07; P08; P09; P10; P11; P12; S05; S06; S07; S10; S11; S12; S14; S15; S25; S26; S27; S30; S41; S44; S45; S46; S47; S48; S49; S51; S52; S53; G03; G09; G10; G11; G12; K01 |
| bm_board | BMS master board stock | UNKNOWN | UNKNOWN (plated-through double-sided perfboard, 0.1 in; size from the layout notes) | 1 | UNVERIFIED (to-buy, PROPOSED) | no | Size: see docs/boards/bms_master.layout.json notes (fit to parts + 2-hole margin); M3 mounts at the four corners (PROPOSED) | Board stock model / whether perfboard_kit's 90x150 board is big enough |  |
| bm_term | BMS master screw terminals, 5.08 mm pitch (2/3/4 pos) | UNKNOWN | UNKNOWN (5.08 mm PCB screw terminal blocks) | 13 | UNVERIFIED (to-buy, PROPOSED) | no | 2-pos ×4 (J-PWR, J-CANV, J-PROX, J-KEL; J-REL removed Build 24), 3-pos ×5 (J-S1..J-S4, J-ESP), 4-pos ×4 (J-DRV, J-THR, J-LEMA, J-LEMB) — count from the layout | Terminal model; wire range must take 16-22 AWG | C11; C12; C13; C14; C10; S01; S02; S03; S30; K01; G09; G10; G11; G12 |
| bm_hdr | BMS master body I/O pin headers 1×8, 2.54 mm | UNKNOWN | UNKNOWN (1×8 male header, 2.54 mm) | 2 | UNVERIFIED (to-buy, PROPOSED) | no | J-BODYA = MCP23017 GPA0-7, J-BODYB = GPB0-7 (expander block in PINMAP) |  |  |
| bm_res | BMS master resistors not in perfboard_kit (100k ×3, 330 Ω, 2.7k, 20k, 3.9k, 1k ×2, 4.7k ×2) | UNKNOWN | UNKNOWN (1/4 W through-hole; 1 % metal film PROPOSED) | 11 | UNVERIFIED (to-buy, PROPOSED) | no | R1 100k (KELLY_THR to GND), RX1/RX2 100k 1% (one-shot timing), RP1 330 Ω / RP2 2.7k (PROX, S45), RD2 20k (PROX divider, S46), RL2 3.9k (release ref 1.40 V, S53 DECIDED Sparky 06:57 #1), RSA/RSB 1k (release series to A:2/B:35, S51/S52), RSDA/RSCL 4.7k (I2C, DECIDED chief 06:57 #3; LATER); 10k pull-ups RRA/RRB/RRST and 100 nF CRA/CRB come from perfboard_kit |  | S45; S46; S51; S52; S53 |
| bm_cap | BMS master capacitors not in perfboard_kit (1 µF, 100 nF C0G/film ×2) | UNKNOWN | UNKNOWN (through-hole, 5 mm lead pitch PROPOSED) | 3 | UNVERIFIED (to-buy, PROPOSED) | no | C5 1 µF (/CLR power-on reset), CX1/CX2 100 nF C0G or film (one-shot timing; X7R drifts) |  |  |
| fuse_batt | Buffer battery fuse F-BATT (battery + post -> 12 V bus +, P13/P14) | UNKNOWN | 150 A MIDI/MEGA bolt-down fuse (P/N + holder TBD) | 1 | to-buy (PROPOSED) | no | 150 A MIDI/MEGA (DECIDED Sparky 07:34); Within 7 in of the buffer battery + post (DECIDED Sparky 07:34); P13 battery + -> F-BATT, P14 F-BATT -> 12 V bus +: both 2 AWG (DECIDED); wire ids PROPOSED | Fuse P/N and holder (TBD) | F-BATT; P13; P14 |

## Superseded / dropped (do not buy)

| id | Was | Model | Why |
|---|---|---|---|
| msd | Manual service disconnect | Volt Gen1 MSD (P/N UNKNOWN) | ~350 A UNVERIFIED; now OUT of current path (pull string fuses = disconnect) |
| lm393 | Plug-detect comparator | LM393 | Dual comparator; superseded 2026-10-23 by LM339 (needs 4 channels: plug-present ×2 + release-button ×2) |
| inlet_switch | Inlet-cover microswitch | UNKNOWN (sealed roller-lever, 2 contacts) | Only for NEMA dumb inlet; to A:33/B:33 |
| x_ev11 | Precharge relay (old plan) | Mini-K / EV11 2-1904058-7 | Replaced by AEV14012 (not pack-voltage rated) |
| x_ev100 | Precharge relay alt | LEV100A4ANG (EV100) | Replaced by AEV14012 |
| x_ev200aaana | Main contactor alt | EV200AAANA / Gigavac GV200BA-1 | Replaced by EV200HAANA |
| x_a6t150 | String fuse A6T150 (superseded) | A6T150 | 150 A Class T; replaced 2026-10-20 by A6T200 (bought) |
| x_classt300 | String fuse (old) | JJN-300 / JJS-300 |  |
| x_bluesea | Class T holders | 5007100 / 5502 | Fuses bolt to bus bar |
| x_a6t600 | Bus fuse fallback | A6T600 | MSD out of path |
| x_coil_relay | E-stop coil-feed relay | Bosch-style 40 A SPDT |  |
| x_jkbms | JK BMS / DALY BMS | JK-B2A24S30P / DALY Smart BMS | Golf cart / other |
| x_mcp41010 | Throttle clamp digipot (rejected alternate) | MCP41010-I/P | Rejected 2026-10-23 (crew DECIDED): needs a different SPI command byte than firmware ThrottleTrim / perfboard U3 / wiring_data, which use MCP4131-103E/P |
| x_cd74hc123e | Throttle clamp one-shot (rejected alternate) | CD74HC123E | Rejected 2026-10-23 (crew DECIDED): HC at 5 V needs VIH 3.5 V, fails with the Teensy 3.3 V alive outputs; use CD74HCT123E (TTL threshold) |
| x_hkmf | Charger 'Elcon E5 / HK-MF-xxx' | HK-MF-xxx / 'E5' | E5 = CAN sticker; real model HK-LF-144-46 |
| x_tdc_iy | DC-DC (stale model) | TDC-IY | Label read 10/15 says TDC-JH-144-12 |
| x_misc_dropped | Other dropped/never-owned | Bussmann T30200-1C; Littelfuse JLLS150/JLLN200; IRLZ44N; Hella UP28 vac pump; Carlinkit CPC200-CCPA; Brusa NLG5x1; Eltek; SK Pang triple-CAN carrier |  |

Sources: cash ledgers `/workspace/cash-spend/teryx-spend.md`, `teryx-first-drive-buys.md`, `teryx-main-power-path.md`, `teryx/cash_models.md`; Mechanic `teryx/teryx-shop-log.md` + `parts_input_mechanic.md`; Sparky `parts_input_sparky.md`; repo docs COMPONENTS.md, cutsheets/INDEX.md, KELLY_SETTINGS.md, CONNECTIONS.md, TIERS.md, BACKLOG.md; perfboard/BOM.md. Per-part sources are in PARTS.yaml.
