Adampaleski/AmperaBattery/docs/guided_install/coil_driver.md

# Guided Install — Contactor coil-driver board (Build 19; room decisions Build 21)

Status: in the AmperaBattery repo since Build 19 (2026-10-23, Gilfoyle). Flyback decision: Sparky DECIDED 2026-10-23 05:41. Low side only + grounding: room DECIDED (Sparky + chief) 2026-10-23 06:11 CT. Build steps are still PROPOSED until Sparky signs off the board.
Part ids come from `docs/PARTS.yaml` (the one parts list; generated by `/workspace/teryx/tools_parts/build_parts.py`, never hand-edited). Wire ids come from `docs/PINMAP.yaml`. On the wiring diagram, the precharge page `drv` node opens these parts.
Labels:
- **SOURCED**: a file or datasheet says it.
- **PROPOSED**: crew suggestion, not yet decided.
- **UNVERIFIED**: unknown or unconfirmed.
- **DERIVED**: computed from sourced values.
- **DECIDED**: the crew/room made the call.

> **LOW VOLTAGE ONLY.** Everything here is 12 V coil power and 3.3 V logic. The pack stays disconnected: all 4 A6T200 string fuses pulled, nothing on B+/B−. The contactor main terminals stay unwired. Do not connect anything HV in this section.

## What it is
The board has three low-side N-FET channels (SOURCED, PINMAP S01–S03). Each FET switches one contactor coil's **−** lead to ground:

| Channel | Teensy A pin | Wire | Coil | Coil load |
|---|---|---|---|---|
| Q-B+ (Main+) | A:11 | S01 | EV200HAANA B+ | 3.8 A max inrush for 130 ms, then 0.13 A hold @12 V (SOURCED, TE datasheet) |
| Q-PRE (precharge) | A:12 | S02 | AEV14012 | 0.35 A @12 V, ~0.41 A @14 V, not economized (SOURCED, Panasonic via Sparky) |
| Q-B− (Main−) | A:21 | S03 | EV200HAANA B− | as Q-B+ |

Coil **+** does not come from this board: it switches the low side only (**DECIDED**, room 2026-10-23 06:11). F-COIL feeds coil + off-board (10 A, PROPOSED, PINMAP:177) through the e-stop NC blocks (E01 feed, E02 to both EV200 coils, E03 to the AEV14012 + Kelly KSI).

## 1. Parts pull (check off from PARTS ids)
- [ ] `coil_driver`: the assembly itself (this section)
- [ ] `cd_fet` ×3: IRLB8721PbF, TO-220, pins G-D-S
  - Owned: **UNVERIFIED**. Adam has been asked; buy if not on hand.
  - Labels: Q-B+, Q-PRE, Q-B−.
- [ ] `cd_rgate` ×3: 100 Ω gate series resistors (value **SOURCED**, S01–S03; 1/4 W through-hole **PROPOSED**). Labels: RG-B+, RG-PRE, RG-B−.
- [ ] `cd_rpull` ×3: 10 kΩ gate pull-downs (value **SOURCED**, S01–S03). Labels: RP-B+, RP-PRE, RP-B−.
- [ ] `cd_flyback` ×1: plain 1N4007, no zener (**DECIDED**, Sparky 2026-10-23 05:41 CT). Label: D-PRE. It mounts **at the AEV14012 coil terminals**, not on the board.
- [ ] `cd_board` ×1: plated-through, double-sided perfboard (**SOURCED**, Sparky 2026-10-23 05:35 CDT). Size not chosen (**UNVERIFIED**).
- [ ] `cd_term` ×1 set: screw terminals or locking JST (**PROPOSED**, Sparky 05:35). Count not fixed (**UNVERIFIED**).
- [ ] From `perfboard_kit`: M3 standoffs; solid-core 18–20 AWG for drain/coil − paths (**SOURCED**, Sparky 05:35); **16 AWG or heavier** for the coil return (sources → star → TB-GND) (**DECIDED**, room 06:11).
- [ ] Meter with Ω and diode mode; bench 12 V supply with current readout, current-limited; flashed Teensy A (`teensy`).

**Flyback (DECIDED, Sparky 2026-10-23 05:41 CT).**
- **AEV14012 (Q-PRE):** plain 1N4007 directly across the coil terminals at the coil, cathode (band) to +12 V. No zener.
  - Why: the IRLB8721 is only rated 30 V. The slower release is acceptable because Main+ already carries the current, and the 50 Ω precharge resistor limits a fault to ≈3 A.
- **EV200HAANA coils (Q-B+ / Q-B−):** **no external diode.** The TE datasheet says the built-in economizer "limits back EMF to 0V" (**SOURCED**; /workspace/teryx/perfboard/BOM.md:36,54 agrees).

## 2. Board layout
**Perfboard (default, Sparky 05:35/05:36).** Three identical channels side by side:
- Gate input → RG (100 Ω) → FET gate.
- RP (10k) from gate to the FET source.
- FET drain → coil-out terminal.
- All three FET sources join one ground bus. That bus leaves on ONE ground terminal back to TB-GND, in 16 AWG or heavier. It carries the coil return only (**DECIDED**, room 06:11).
- Keep the gate/logic side on one edge and the coil terminals on the opposite edge.

**PCBWay (alternative, only once the circuit is proven, Sparky 05:36).**
- 2-layer, ≤100×100 mm, through-hole parts only.
- Coil traces ≥1 mm at 1 oz copper, with a back-layer ground pour.
- Mounting holes and screw terminals.
- Print the layout 1:1 and check it against the real parts. Run the board house's design check before you pay.
- Cost (typical, not a live quote): ~$20–40 all-in, 1–2 weeks.

## 3. Build — step by step
1. **Board prep** (`cd_board`). Mark three channel columns: B+, PRE, B−. Mark the ground bus along one edge. Leave room for 4 M3 standoffs.
2. **FETs** (`cd_fet`, S01/S02/S03). Fit Q-B+, Q-PRE and Q-B−, flat face up, pins **G-D-S** left to right as printed on the IRLB8721 datasheet. Check the pin order before soldering (**SOURCED** /workspace/teryx/perfboard/BOM.md:33 "G-D-S").
3. **Gate resistors** (`cd_rgate`, S01–S03). Put each 100 Ω in series between that channel's gate-input terminal and the FET **G** pin, close to the pin.
4. **Pull-downs** (`cd_rpull`, S01–S03). Put each 10 kΩ between the FET **G** pin and that FET's **S** pin, on the FET side of the 100 Ω. This keeps the FET off while the Teensy boots (Sparky 05:35; chief review #10).
5. **Ground bus.** Join all three **S** pins to the star with solid-core **16 AWG or heavier** (coil return, **DECIDED** room 06:11), not thin jumper wire. Run one lead to the board's GND terminal. If 16 AWG solid will not enter the holes, lap it along the pads and solder-fill (**UNVERIFIED**, ask Sparky).
6. **Coil outputs** (`cd_term`, S01/S02/S03). Each FET **D** pin goes to its coil-out terminal with solid-core 18–20 AWG:
   - Q-B+ → EV200 B+ coil − (S01, RD/BU coil lead)
   - Q-PRE → AEV14012 coil − (S02, RD/GN)
   - Q-B− → EV200 B− coil − (S03, RD/BK) — coil-lead colors from PINMAP S01–S03 (PROPOSED)
7. **Gate inputs** (`cd_term`, S01–S03). Three gate-input terminals plus one signal-GND terminal from Teensy A:
   - Teensy A:11 → B+ input (S01)
   - A:12 → PRE input (S02)
   - A:21 → B− input (S03)
8. **Flyback diode at the coil** (`cd_flyback`, S02/E03). Fit D-PRE (1N4007) **across the AEV14012 coil terminals, at the relay**, not on this board (**DECIDED**, Sparky 05:41):
   - **Band (cathode) to coil + / +12 V terminal** (E03 feed from e-stop block 2).
   - Anode to the coil − terminal (S02 lead to the Q-PRE drain).
   - A reversed diode shorts F-COIL when Q-PRE turns on.
   - No diode on the EV200 coils.
   - Insulate the leads (heat shrink) and strain-relieve them so vibration can't break the leads at the terminals.
9. **Single-point ground.**
   - Board GND terminal (J-GND.2) → TB-GND, 16 AWG or heavier. It carries **only the coil return** from the FET sources (**DECIDED**, room 2026-10-23 06:11).
   - Teensy signal ground arrives on **J-SIG.1**, in the same cable as the three gate signals, and joins the board star (V22).
   - There is **no** Teensy GND wire at TB-GND any more: PINMAP G04 is dropped (**DECIDED**, room 06:11). On the BMS master board, Teensy A's ground goes to that board's star, and J-SIG.1 leaves from there.
10. **Coil + feed** (F-COIL, E01–E03). This is not on the board. Confirm the coil + leads come from the e-stop NC blocks fed by F-COIL. For the bench, use a current-limited 12 V supply in place of F-COIL.
11. **Strain relief and mounting.** Tie every off-board lead down; never let a bare solder joint hold a wire. Mount on standoffs in a sealed box. Conformal coat or hot glue goes on **after** the PASS checks below (Sparky 05:35).

## 4. PASS / FAIL checks (12 V bench only, pack disconnected)
| # | Check | How | PASS | FAIL → fix |
|---|---|---|---|---|
| 1 | Gate pull-down present (S01–S03) | Unpowered, meter Ω from each gate input terminal to board GND | ≈10.1 kΩ (10k + 100 Ω, DERIVED); PINMAP check "gate-GND ≈10 kΩ" | Open or 0 Ω: RP missing, wrong pad, or a solder bridge |
| 2 | D-PRE orientation (at the AEV14012 coil) | Meter diode mode across D-PRE, coil leads disconnected from the board, red on the anode (coil −), black on the band | ~0.5–0.7 V one way, OL reversed (typical silicon diode, UNVERIFIED for your meter) | Reads 0 V → shorted; reads backwards → diode reversed. Fix before applying 12 V |
| 3 | Fail-safe OFF | 12 V coil supply on, Teensy unpowered or gate inputs unplugged | All 3 coils stay OFF (no click; supply current ≈0 A) | A coil pulls in: pull-down missing or FET D-S shorted |
| 4 | Drive from the Teensy at 3.3 V | Power Teensy A, then drive A:11, A:12, A:21 HIGH one at a time (bench sketch/command per firmware, UNVERIFIED) | Each coil pulls in fully (solid click, stays in) | Chatter or weak pull-in: IRLB8721 RDS(on) is only rated at ≥4.5 V gate. Stop and report to Sparky (Sparky 05:31) |
| 5 | Coil current | Supply readout (or meter in series) per channel at 12 V | AEV14012 ≈0.35 A (≈0.41 A @14 V); EV200 ≈0.13 A hold after the 130 ms inrush (≤3.8 A peak) (SOURCED) | Far off spec: wrong coil, wrong channel, or a bad joint |
| 6 | FET temperature | Finger-touch after 1 min hold, all on | Barely warm (Sparky 05:35, no heatsink) | Hot: FET not fully on (see #4) |
| 7 | Release | Drive each gate LOW | Coil drops out | Stays in: FET shorted. PRE drops slower than the EV200s with a plain diode (expected) |
| 8 | E-stop cut | All three on, push the e-stop | All three coils drop (E02/E03 cut coil +) | Any stays in: e-stop wiring (ESTOP.md) |

## Open before this ships
- Adam: how many IRLB8721s are on hand (`cd_fet`; `coil_fet` CONFLICT vs IRLB3813PBF).
- Board size and enclosure. Terminal type and count.
- Sparky: does 16 AWG solid fit the perfboard holes (≈1.29 mm wire vs ≈1.0 mm holes on many boards)? **UNVERIFIED**.
- Diagram: done. The precharge page has a `drv` node (part `coil_driver`); clicking it opens the PROPOSED perf-board layout `tools/perfboard.html?board=coil_driver` (`docs/boards/coil_driver.layout.json`, checked by `scripts/check_boards.py`). Board size in that layout: 26 × 36 holes (PROPOSED).
- **DECIDED** (room: Sparky + chief, 2026-10-23 06:11 CT, Build 21):
  - J-12V is deleted. The board switches the low side only, and step 10 stands.
  - Keep J-SIG.1 (Teensy signal GND, in the gate cable). Drop the Teensy GND wire at TB-GND (G04). TB-GND carries only the coil return, 16 AWG+.
