Adampaleski/AmperaBattery/docs/schematic/teryx-system.pdf

HIGH VOLTAGE — isolated, B− never to chassis (LATER, Sparky) | LOW VOLTAGE — 12 V− bonded to chassis

Teryx EV system — 4-string dual-Teensy (CAN_LAYOUT_V2), wire numbers from docs/PINMAP.yaml (generated)

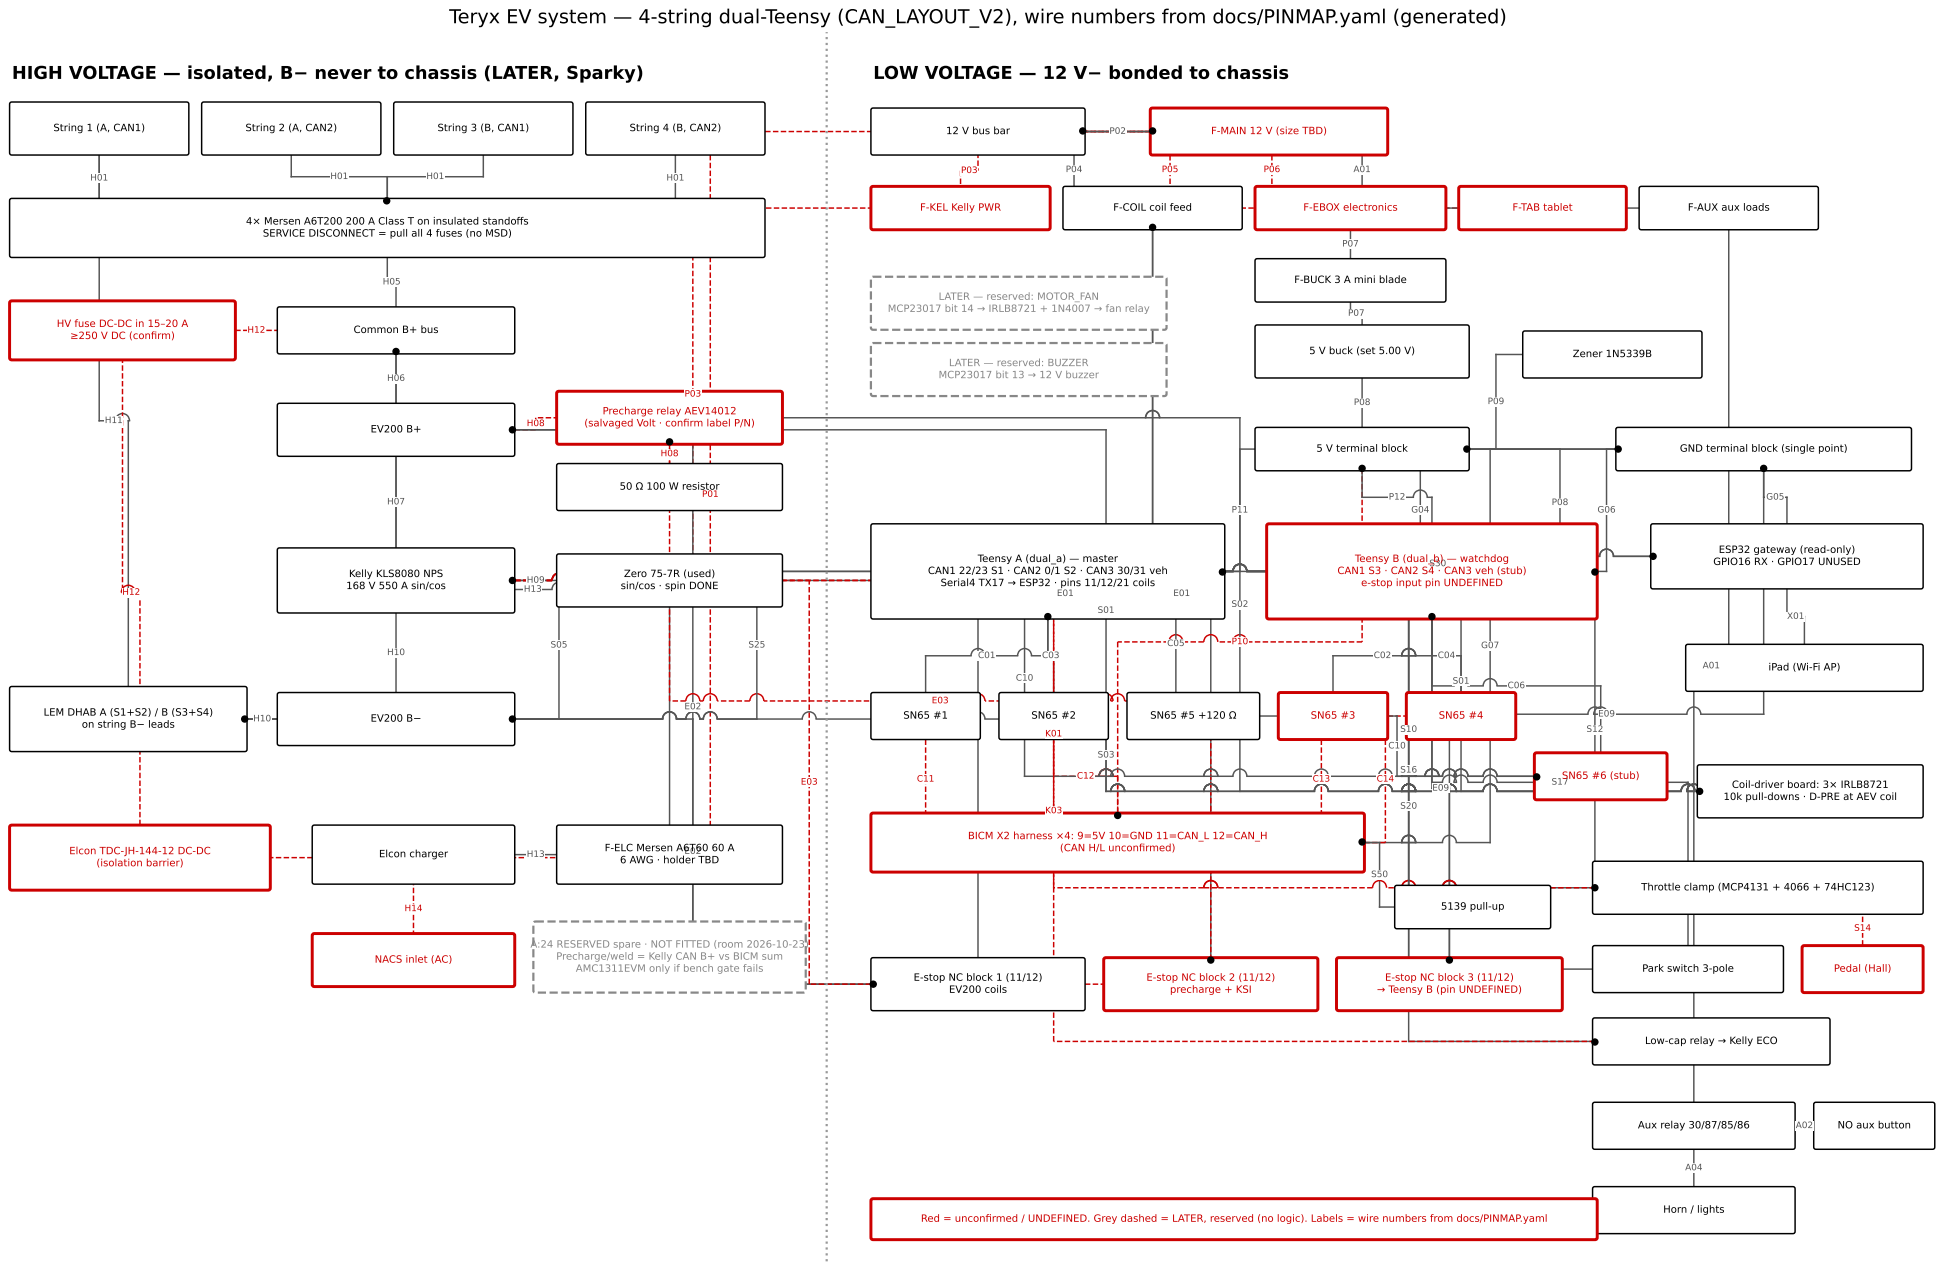
[picture p2: page 1]

4× Mersen A6T200 200 A Class T on insulated standoffs
SERVICE DISCONNECT = pull all 4 fuses (no MSD)

Precharge relay AEV14012
(salvaged Volt · confirm label P/N)

Teensy B (dual_b) — watchdog
e-stop input pin UNDEFINED

Zero 75-7R (used)
sin/cos · spin DONE

iPad (Wi-Fi AP)

Coil-driver board: 3× IRLB8721
10k pull-downs · D-PRE at AEV coil

Elcon TDC-JH-144-12 DC-DC
(isolation barrier)

A:24 RESERVED spare · NOT FITTED (room 2026-10-23)
Precharge/weld = Kelly CAN B+ vs BICM sum
AMC1311EVM only if bench gate fails

Low-cap relay → Kelly ECO

Red = unconfirmed / UNDEFINED. Grey dashed = LATER, reserved (no logic). Labels = wire numbers from docs/PINMAP.yaml
