Adampaleski/AmperaBattery/docs/PARTS.yaml

# Teryx EV — CANONICAL PARTS LIST (GENERATED — never hand-edit). Edit /workspace/teryx/tools_parts/build_parts.py and rerun; PINMAP/diagram tooling can key on parts[].id
meta:
  title: Teryx EV canonical parts list (single source of truth)
  generated: 2026-10-23 America/Chicago
  generator: /workspace/teryx/tools_parts/build_parts.py (writes AmperaBattery/docs/PARTS.yaml + PARTS.md)
  source_root: /workspace (paths relative to /workspace or /workspace/teryx)
  rules:
  - Never invent a model number; unknown = UNKNOWN
  - Conflicts list all values under 'conflict' and the field says CONFLICT
  - 'verified: yes = label/receipt/datasheet seen; partial; no'
  status_values: owned | installed | to-buy | PROPOSED | LATER | superseded | dropped | CONFLICT
  merged_inputs:
  - cash ledgers x3
  - teryx/cash_models.md
  - parts_input_sparky.md
  - parts_input_mechanic.md
  - parts_input_gilfoyle.md
  - teryx-shop-log.md
  - AmperaBattery docs (read-only)
  also_merged:
  - teryx/cash_parts_full.yaml (86 parts, 2026-10-23)
  keying: 'parts is a mapping keyed by stable snake_case id; diagram_ids = DERIVED from the explicit part: tags in the repo tooling (wiring:<page>/<node> = tools/wiring_data.js node {part:}, schem:<block>
    = tools/schematic/gen.py PART, pinmap:connector/<id> and pinmap:fuse/<id> = docs/PINMAP.yaml part:, cutsheet:<sheet> = tools/cutsheets.json id/also_parts, board:<board>[/<refdes>] = docs/boards/<board>.layout.json
    board_part/parts/offboard); pinmap_refs = docs/PINMAP.yaml wire/fuse/connector/bus ids; checked both ways by scripts/check_parts.py'
parts:
  vehicle:
    category: vehicle
    name: Base vehicle
    maker: Kawasaki
    model: Teryx 750 4x4 (2008, KRF750A8F/B8F)
    qty: 1
    status: owned
    specs:
    - Final reduction 4.375:1 (35/8, front = rear) per 2008 owner's manual
    - 4WD engage = 12 V solenoid valve -> vacuum actuator 16172-0014 -> shift cable; diff lock = progressive lever + cable
    source:
    - teryx/teryx-shop-log.md 2026-10-21 09:16/09:17/09:53
    - teryx/parts_input_mechanic.md
    - 'teryx/parts_input_gilfoyle.md #36'
    verified: 'yes'
    open_questions: []
    diagram_ids: []
    pinmap_refs: []
    superseded_by: null
    owned: 'yes'
    cost: null
    tier: null
  motor:
    category: drive
    name: Traction motor
    maker: Zero Motorcycles
    model: Zero 75-7R (used)
    qty: 1
    status: owned (bench-spun)
    specs:
    - Z-Force 75-7 family, R = high-temp magnets, passively air-cooled
    - OEM 28S (~116 V max); this build runs 36S (~148 V)
    - 'Pole count UNVERIFIED (Kelly #59 assumes 8); temp sensor KTY84 UNVERIFIED'
    - $1,004.38
    - 'Position sensor: sin/cos (Adam 2026-10-23)'
    - 'Shaft/sprocket adapter: old-style, plain cylinder with one flat side'
    - Bench-spun on the Kelly before 2026-10-23
    source:
    - teryx/teryx-shop-log.md Drivetrain (Adam 2026-08-29)
    - cash-spend/teryx-spend.md line 10
    - teryx/cash_models.md
    - AmperaBattery/docs/KELLY_SETTINGS.md
    - Adam 2026-10-23
    verified: 'yes'
    open_questions:
    - 'Pole count and thermistor type still UNVERIFIED (Kelly #59 assumes 8 poles; KTY84 assumed): confirm on the bench/autotune, not a photo ask'
    resolution: 'SOURCED (Adam 2026-10-23): used Zero 75-7R, old-style sprocket adapter (plain cylinder with one flat side), sin/cos position sensor (why the Kelly KLS8080 NPS was chosen); bench spin test
      DONE'
    diagram_ids:
    - wiring:overview/mot
    - schem:mot
    pinmap_refs:
    - H09
    superseded_by: null
    owned: 'yes'
    cost: $1,004.38
    tier: null
  controller:
    category: drive
    name: Motor controller
    maker: Kelly Controls
    model: KLS8080 NPS, 168 V, 550 A (+ high-speed option, anti-slip, all add-ons)
    qty: 1
    status: owned
    specs:
    - 'Order #81746 (2025-05-03): ''KLS-8080N 144V 550A'', NPS sin/cos, W3-GT2 liquid heatsink, 35-pin cable, USB cable, KLS test box'
    - 'Adam 2026-10-17: ''168 V version''; order listing range 72–168 V'
    - KELLY_SETTINGS assumes KLS14601 (24–144 V nominal, 173 V max); Kelly catalog has no 550 A or 168 V/550 A SKU
    - 'PWR pin 7: 8–20 V isolated logic, ~30 mA'
    - Firmware KELLY_MAX_V 168 V (Config.h:144) vs 173 V max in KELLY_SETTINGS; manual Rev 2.1.1 vs 2.1.0
    - Cost $1,407.97 all-in ($1,214.90 unit+test box)
    source:
    - cash-spend/teryx-spend.md line 26
    - teryx/teryx-shop-log.md 2026-08-29, 2026-10-17 17:43, 2026-10-20 15:40
    - AmperaBattery/docs/KELLY_SETTINGS.md
    - teryx/cash_models.md
    - teryx/parts_input_sparky.md
    - 'teryx/parts_input_gilfoyle.md #3-4'
    - Adam 2026-10-23 (Kelly purchase email screenshot)
    verified: 'yes'
    open_questions:
    - 'Sparky: re-check KELLY_SETTINGS #7 overvoltage and #11 battery-current % for the 168 V / 550 A unit'
    resolution: 'SOURCED (Adam 2026-10-23, Kelly purchase email screenshot): KLS8080 NPS, 168 V, 550 A, all add-ons incl. high-speed and anti-slip; no nameplate photo needed. Replaces KLS14551/KLS14601/KLS16xxx
      candidates; KELLY_SETTINGS (KLS14601 assumption) needs re-check for #7 overvoltage and #11 battery-current %'
    diagram_ids:
    - wiring:overview/kel
    - wiring:clamp/kt
    - wiring:enables/k
    - wiring:park/k12
    - wiring:park/fs
    - wiring:precharge/kel
    - wiring:estop/c2
    - wiring:bms/kel
    - wiring:kelly/k12
    - wiring:kelly/eco
    - schem:kel
    - pinmap:connector/KELLY-J
    - cutsheet:kelly
    pinmap_refs:
    - KELLY-J
    - H07
    - H09
    - H10
    - K01
    - K02
    - K03
    - P03
    - G02
    - F-KEL
    superseded_by: null
    owned: 'yes'
    cost: $1,407.97
    tier: null
  kelly_test_box:
    category: drive
    name: Kelly KLS test box
    maker: Kelly Controls
    model: KLS test box
    qty: 1
    status: owned
    specs:
    - $29.00
    source:
    - cash-spend/teryx-spend.md
    verified: 'yes'
    open_questions: []
    diagram_ids: []
    pinmap_refs: []
    superseded_by: null
    owned: 'yes'
    cost: $29.00
    tier: null
  kelly_prog_cable:
    category: drive
    name: Kelly programming USB cable
    maker: Kelly Controls
    model: 'UNKNOWN (USB cable came with order #81746; CH341SER driver)'
    qty: 1
    status: owned
    specs:
    - 'Order #81746 lists a USB cable; Sparky lists it as NOT bought (~$19)'
    source:
    - cash-spend/teryx-spend.md
    - teryx/parts_input_sparky.md
    - teryx/cash_parts_full.yaml
    verified: 'no'
    open_questions:
    - Check it is in the Kelly box
    resolution: 'Owned: Kelly order #81746 lists the USB cable (ledger; cash_parts_full KELLY-USB); Sparky ''not bought'' is unsupported (was CONFLICT: [''owned (order #81746)'', ''not bought (Sparky)''])'
    diagram_ids: []
    pinmap_refs: []
    superseded_by: null
    owned: 'yes'
    cost: null
    tier: null
  kelly_heatsink:
    category: cooling
    name: Kelly liquid-cooled heatsink
    maker: Kelly Controls
    model: W3-GT2
    qty: 1
    status: owned
    specs:
    - 'Came with order #81746'
    source:
    - cash-spend/teryx-spend.md
    - teryx/parts_input_mechanic.md
    verified: 'yes'
    open_questions: []
    diagram_ids: []
    pinmap_refs: []
    superseded_by: null
    owned: 'yes'
    cost: null
    tier: null
  axle:
    category: drive
    name: Custom drive axle
    maker: Perfection Driveline
    model: UNKNOWN (custom)
    qty: 1
    status: owned
    specs:
    - $975.35 (card stmt Nov 10)
    - Feeds stock F/R diffs; pinions assumed OEM 8T/35T
    source:
    - cash-spend/teryx-spend.md
    - teryx/teryx-shop-log.md
    verified: 'no'
    open_questions:
    - Confirm axle pinions are still OEM 8T/35T (not recut)
    diagram_ids: []
    pinmap_refs: []
    superseded_by: null
    owned: 'yes'
    cost: $975.35
    tier: null
  sprocket_motor:
    category: drive
    name: Motor sprocket 16T
    maker: UNKNOWN
    model: 50B16 (1" finished bore)
    qty: 1
    status: installed
    specs:
    - '#50 pitch'
    source:
    - cash-spend/teryx-spend.md line 25
    - teryx/teryx-shop-log.md
    verified: 'yes'
    open_questions: []
    diagram_ids: []
    pinmap_refs: []
    superseded_by: null
    owned: 'yes'
    cost: null
    tier: null
  sprocket_shaft:
    category: drive
    name: Shaft sprocket 32T + bushing
    maker: UNKNOWN
    model: 50BTB32 + 2012 taper bushing 1-1/4"
    qty: 1
    status: installed
    specs:
    - 2:1 ratio; total 8.75:1 with 4.375 diffs
    source:
    - cash-spend/teryx-spend.md line 25
    - teryx/teryx-shop-log.md
    verified: 'yes'
    open_questions: []
    diagram_ids: []
    pinmap_refs: []
    superseded_by: null
    owned: 'yes'
    cost: null
    tier: null
  chain:
    category: drive
    name: Drive chain
    maker: NICHE
    model: 'NICHE Gold 530 (on #50 / 50B sprockets)'
    qty: 1
    status: owned
    specs:
    - '530 and #50 share 5/8" pitch; roller width differs — fit on 50B sprockets to confirm'
    - $53.45 eBay 09-13491-63261
    source:
    - cash-spend/teryx-spend.md line 19
    - teryx/teryx-shop-log.md
    - teryx/parts_input_mechanic.md
    - teryx/cash_models.md
    - teryx/cash_parts_full.yaml
    - projects/teryx-ev/memory/by-agent/0cad8077…/profile.md:17
    verified: 'no'
    open_questions:
    - Length / link count and center distance not measured
    resolution: 'Owned chain = NICHE Gold 530 (ledger receipt eBay 09-13491-63261) run on the #50 50B sprockets (''Chain is locked as 530 on the 50B 16T/32T sprockets'', Mechanic memory profile:17); ''ANSI
      #50, not 530'' (shop log:19) is the older sprocket-of-record note (was CONFLICT: [''NICHE Gold 530'', ''ANSI #50 (50B)''])'
    diagram_ids: []
    pinmap_refs: []
    superseded_by: null
    owned: 'yes'
    cost: $53.45
    tier: null
  chain_guard:
    category: drive
    name: Chain guard + tensioner
    maker: UNKNOWN
    model: UNKNOWN (not chosen)
    qty: 1
    status: to-buy
    tier: CRITICAL
    specs:
    - Adam fab; CRITICAL before first drive
    source:
    - teryx/parts_input_mechanic.md
    - AmperaBattery/docs/TIERS.md
    verified: 'no'
    open_questions:
    - Choose part / fab design
    diagram_ids: []
    pinmap_refs: []
    superseded_by: null
    owned: 'no'
    cost: null
  tires:
    category: drive
    name: Tires
    maker: UNKNOWN
    model: UNKNOWN (24 in measured)
    qty: 4
    status: owned
    specs:
    - 24 in measured 2026-10-21 (~49 mph @ 6000 rpm); older note said 27 in
    source:
    - teryx/teryx-shop-log.md 2026-10-21 17:07
    - teryx/parts_input_mechanic.md
    verified: 'yes'
    open_questions:
    - Tire + wheel model/size code (sidewall) — LATER
    resolution: 24 in measured 2026-10-21 (shop log) supersedes 27 in 'locked' and 26x8-12/26x10-12 memory values (cash_parts_full TIERS)
    diagram_ids: []
    pinmap_refs: []
    superseded_by: null
    owned: 'yes'
    cost: null
    tier: null
  diffs:
    category: drive
    name: Front/rear differentials
    maker: Kawasaki
    model: stock 2008 Teryx (8T/35T, 4.375:1)
    qty: 2
    status: installed
    specs:
    - ''
    source:
    - teryx/teryx-shop-log.md 2026-10-21 09:53
    verified: 'yes'
    open_questions: []
    diagram_ids: []
    pinmap_refs: []
    superseded_by: null
    owned: 'yes'
    cost: null
    tier: null
  pack:
    category: battery
    name: Traction pack (4 strings)
    maker: LG Chem (GM Chevy Volt Gen1)
    model: 2014 Volt Gen1 modules, 36S4P (4× 36S strings)
    qty: 1
    status: owned
    specs:
    - 'Cells: 15 Ah pouches, 3P = 45 Ah groups; 6S (~22 V) and 12S (~44 V) bricks'
    - 'Layout: 10×12S + 4×6S; 4 strings × 36S × 45 Ah = 180 Ah'
    - ~148 V full @4.10 V/cell; ~24 kWh nominal
    - From 2 owned Volt packs (~$650 each, no receipt)
    source:
    - teryx/teryx-shop-log.md CURRENT BOM 2026-10-17
    - cash-spend/teryx-spend.md Pack layout RESOLVED 2026-10-21
    - AmperaBattery/docs/COMPONENTS.md
    - teryx/parts_input_sparky.md
    - teryx/cash_parts_full.yaml
    verified: 'yes'
    open_questions: []
    resolution: cash_parts_full PACK-CELLS agrees
    diagram_ids:
    - wiring:overview/s1
    - wiring:overview/s2
    - wiring:overview/s3
    - wiring:overview/s4
    - schem:s1
    - schem:s2
    - schem:s3
    - schem:s4
    - cutsheet:bicm
    pinmap_refs: []
    superseded_by: null
    owned: 'yes'
    cost: null
    tier: null
  bicm_m1:
    category: bms
    name: Volt BICM M1 (30S)
    maker: GM
    model: UNKNOWN GM P/N
    qty: 2
    status: UNVERIFIED spare (not in build)
    specs:
    - 30S, 6/8/8/8 groups; NOT in the build (build = 2× M2 + 2× M3 + 4× M4)
    - 'Qty 2 UNVERIFIED: no receipt (ledger) and no purchase in cash_parts_full; bench log shows an M1 (30 cells, 110.7 V) on 2026-10-14/15'
    source:
    - cash-spend/teryx-spend.md:76,79 (no M1 line; 'two BICMs total' superseded by 8-BICM correction)
    - teryx/cash_parts_full.yaml:29 (BICM-M1 qty 2 'owned', cost 0, source shop log 10/17, no receipt)
    - teryx/teryx-shop-log.md:230,249,261
    verified: 'no'
    open_questions:
    - How many M1s are actually on the shelf (count + GM P/N label)
    tier: LATER
    resolution: 'M1 (30S) not used: strings are 24S (M2/M3) + 18S (M4, 12 ch used); kept as UNVERIFIED spares (Gilfoyle 2026-10-23 per crew)'
    diagram_ids: []
    pinmap_refs: []
    superseded_by: null
    owned: 'no'
    cost: null
  bicm_m2m3:
    category: bms
    name: Volt BICM M2/M3 (24S)
    maker: GM
    model: UNKNOWN GM P/N
    qty: 4
    status: owned
    specs:
    - 2× M2 + 2× M3 owned; strings A2/B2 use 1 each, 2 spare
    - 'Per string: 1× 24S (M2/M3) + 1× M4 18S (12 of 18 ch)'
    source:
    - teryx/teryx-shop-log.md 2026-10-17 17:14
    - AmperaBattery/docs/COMPONENTS.md
    verified: 'no'
    open_questions: []
    resolution: 'All 4 used: one 24S BICM (M2 or M3) per string'
    diagram_ids:
    - cutsheet:bicm
    pinmap_refs:
    - X2-S1..S4
    superseded_by: null
    owned: 'yes'
    cost: null
    tier: null
  bicm_m4:
    category: bms
    name: Volt BICM M4 / VTSM#4 (18S)
    maker: GM
    model: 22880272 (VTSM#4; buy-alternates 22885657 / 20955253 UNVERIFIED)
    qty: 4
    status: owned 2 / to-buy 2
    tier: CRITICAL
    specs:
    - ST L9763 monitor chips inside; one per string
    - Need 4, own 2 (1 label-confirmed) -> buy 2 used Gen1 pulls ~$50–70 ea
    source:
    - teryx/teryx-shop-log.md 2026-10-16 19:49, 2026-10-17 12:31
    - AmperaBattery/docs/COMPONENTS.md
    - cash-spend/teryx-first-drive-buys.md item 15
    - teryx/teryx-shop-log.md:275
    - teryx/cash_parts_full.yaml
    verified: yes (1 unit)
    open_questions:
    - Confirm 2nd owned M4 label says VTSM#4
    - 'Exact listing / part # to buy for 2 more'
    resolution: GM P/N 22880272 read from label 2026-10-15 19:49 (shop log:275); 22885657/20955253 are unverified search alternates
    diagram_ids:
    - cutsheet:bicm
    pinmap_refs:
    - X2-S1..S4
    superseded_by: null
    owned: partial
    cost: null
  bicm_total:
    category: bms
    name: BICM count (summary)
    maker: GM
    model: 2× M2 24S + 2× M3 24S + 4× M4 18S (22880272)
    qty: 8
    status: 6 owned (in-use mix) + 2 to-buy
    specs:
    - 2 BICMs per 36S string, 4 strings, 4 separate CAN buses
    source:
    - cash-spend/teryx-spend.md BICM correction 2026-10-21
    - teryx/cash_models.md
    verified: 'yes'
    open_questions: []
    resolution: 8 = 2× M2 + 2× M3 + 4× M4 (6 owned, 2 M4 to buy); ledger 'two TNCs + two BICMs total' superseded by cash correction 2026-10-21
    diagram_ids:
    - wiring:overview/s1
    - wiring:overview/s2
    - wiring:overview/s3
    - wiring:overview/s4
    - wiring:bms/s1
    - wiring:bms/s2
    - wiring:bms/b1
    - wiring:bms/b2
    - schem:s1
    - schem:s2
    - schem:s3
    - schem:s4
    - schem:bo
    - pinmap:connector/X2-S1..S4
    - cutsheet:bicm
    pinmap_refs:
    - X2-S1..S4
    superseded_by: null
    owned: partial
    cost: null
    tier: null
  tnc:
    category: bms
    name: TNC (cash ledger item)
    maker: UNKNOWN
    model: UNKNOWN
    qty: 2
    status: owned
    specs:
    - 'cash ledger: ''Two TNCs + two BICMs total across whole build'' (2026-10-21, later corrected for BICMs)'
    source:
    - cash-spend/teryx-spend.md line 76
    - teryx/cash_models.md
    verified: 'no'
    open_questions:
    - 'What is a ''TNC'' here and its part #? (not in any crew doc)'
    diagram_ids: []
    pinmap_refs: []
    superseded_by: null
    owned: 'yes'
    cost: null
    tier: null
  lem:
    category: bms
    name: Hall current sensor
    maker: LEM
    model: DHAB S/44 (stock Chevy Volt / Opel Ampera Gen1 HV pack current sensor, GM SI ref B30)
    qty: 2
    status: owned
    specs:
    - 'One per string pair (A: S1+S2, B: S3+S4) on B−'
    - Open-loop Hall, dual channel, analog ONLY (no CAN). Supply Vc 5.0 V (4.5-5.5 V), 15 mA typ / 20 mA max, 40 mA power-up inrush; abs max 8.5 V (14 V 1 min)
    - 'Ch1 (LOW/fine range): -20..+20 A, Vo 2.50 V, 100 mV/A @Vc=5 V -> 0.5..4.5 V; global error ±0.25 A offset / ±0.45 A @20 A (25 °C)'
    - 'Ch2 (HIGH/coarse range): ASYMMETRIC -420..+230 A, Vo 3.08 V, 6.15 mV/A @Vc=5 V -> 0.497 V @-420 A .. 4.49 V @+230 A; global error ±3.5 A offset / ±8.5 A @-420 A (25 °C)'
    - 'Both outputs fully ratiometric (offset, gain, clamps): I = (Vout*5/Vc - Vo)/G. Output clamps 0.25 V / 4.75 V @Vc=5 V (DERIVED: Ch2 clamps ≈ -460 A / +271 A; Ch1 ≈ ±22.5 A)'
    - 'Load: RL >= 10 kΩ, CL 1-100 nF, Rout 1-10 Ω. Bandwidth 80 Hz (-3 dB) both channels; power-up 25 ms typ / 110 ms max; recovery after overload 25 ms'
    - 'Current direction: datasheet arrow = POSITIVE primary current (Vout > Vo along arrow). Ch2 has 420 A on the NEGATIVE side, so the big (discharge) direction must flow AGAINST the arrow'
    - 'Sensor connector pins (moulded A-D, datasheet): A = Ch2 high range, B = Vc +5 V, C = GND, D = Ch1 low range. GM harness: B/+5 V VT/RD (2965, ''pin 1'' in SimpBMS/Vero tables), C/GND BK/GY (2963,
      ''pin 2''), A/high BU/YE (2962 coarse, ''pin 3''), D/low GN/BN (2961 fine, ''pin 4'')'
    - Mating connector TE 1-1456426-5 (4-way), terminals 1418850-1, seals 964972-1 (openinverter wiki)
    - 'Teensy 4.1 (3.3 V ADC, NOT 5 V tolerant): divide both outputs (e.g. 10k/20k = 0.667 -> 4.75 V clamp = 3.17 V), 10-47 nF at ADC pin, measure Vc on a 3rd ADC via same divider for ratiometric correction'
    - 'Teryx use: one per string pair (A: S1+S2, B: S3+S4) on B-; ~275 A each at 550 A Kelly peak -> within Ch2 discharge side ONLY if mounted with discharge against the arrow (backwards = clamps at +271
      A)'
    source:
    - AmperaBattery/docs/cutsheets/INDEX.md
    - teryx/parts_input_sparky.md
    - teryx/cash_models.md
    - teryx/teryx-shop-log.md 2026-10-20 05:42
    - 'teryx/parts_input_gilfoyle.md #11'
    - http://www.thunderstruck-ev.com/images/companies/1/Display-Sensor/DHAB-S-44.pdf (LEM DHAB S/44 datasheet 091120/0)
    - 'https://communityarchive.victronenergy.com/storage/attachments/simp-bms-setup-manual-v025.pdf (SimpBMS manual: Volt Gen1 DHAB S/44 harness pins/colours)'
    - 'https://www.fuel2electric.com/files/vendor953/attachments/697/Vero%20BMS%20V2%20Setup%20Manual%20V0.19.pdf (Vero BMS V2 manual: same harness table, 20 A changeover)'
    - 'https://tis-volt.by/volt2/sm/part69.htm (GM SI connector X359/X360: ckts 2961 fine GN/BN, 2962 coarse BU/YE, 2965 5 V ref VT/RD, 2963 low ref BK/GY) + part85.htm (B30 HV pack current sensor, rear
      of A28 contactor assy)'
    - 'https://leafdriveblog.wordpress.com/2020/06/03/volt-ampera-bms/ (Volt/Ampera BMS teardown: DHAB S-44 in Gen1 pack)'
    - https://openinverter.org/wiki/Connector_Part_Numbers (DHAB mating connector TE 1-1456426-5, terminals 1418850-1, seals 964972-1)
    - Adam 2026-10-23 via chief (2 stock Volt sensors owned, on bench)
    verified: yes (datasheet); GM P/N UNVERIFIED
    open_questions:
    - 'GM part number UNVERIFIED: not found in GM parts catalogs (B30 appears serviced with the A28 contactor assembly — also UNVERIFIED); read the label on the sensor if ever needed (not an Adam ask)'
    - 'Volt Gen1 in-car orientation (discharge = against arrow / negative) is INFERRED from the -420/+230 range and builder notes, not from a GM document; bench-confirm: small known discharge must pull
      Ch1 below 2.50 V'
    - 'Response time tr: datasheet defines it but gives no number; only BW 80 Hz (≈4-5 ms 10-90% rise, DERIVED) — fuses, not this sensor, must clear shorts'
    - SimpBMS/Vero 'pin 1-4' numbering is harness-side order, not the moulded A-D letters; wire by letter/colour
    resolution: 'VERIFIED 2026-10-23 (Sparky) from LEM DHAB S/44 datasheet + SimpBMS/Vero harness tables + GM SI circuits. Ownership: Adam 2026-10-23 via chief: 2 stock Volt pack current sensors at his
      bench (was CONFLICT: [''owned (Sparky, COMPONENTS.md)'', "ownership UNCONFIRMED (cash, shop log ''if owned'')"])'
    note: stock Volt, at Adam's bench
    diagram_ids:
    - wiring:overview/lem
    - wiring:bms/lem
    - schem:lem
    - cutsheet:dhab
    pinmap_refs:
    - S05
    - S06
    - S07
    - S25
    - S26
    - S27
    - H11
    - G09
    - G10
    superseded_by: null
    owned: 'yes'
    cost: null
    tier: null
  teensy:
    category: bms
    name: Microcontroller (BMS A + B)
    maker: PJRC
    model: Teensy 4.1
    qty: 2
    status: owned
    specs:
    - 3 native CAN; 3.3 V I/O only; cut VIN/VUSB pad
    source:
    - cash $45.77 (teryx-spend.md); 2nd bought 2026-10-17
    - teryx/teryx-shop-log.md
    - AmperaBattery/docs/COMPONENTS.md
    - teryx/parts_input_gilfoyle.md conflict 11
    - teryx/cash_parts_full.yaml
    verified: 'yes'
    open_questions:
    - 2nd Teensy receipt/price not on file
    resolution: '2 owned: 1 receipt in ledger ($45.77) + 2nd bought 2026-10-17 (shop log:279); cash_parts_full TEENSY qty 2 owned (was CONFLICT: [''2 owned (COMPONENTS, shop log 10/17 2nd bought)'', "shop-log:294
      ''1st Teensy'' only (older)"])'
    diagram_ids:
    - wiring:overview/ta
    - wiring:overview/tb
    - wiring:overview/can
    - wiring:overview/en
    - wiring:clamp/ta
    - wiring:clamp/tb
    - wiring:enables/ta
    - wiring:enables/tb
    - wiring:enables/bf
    - wiring:park/a
    - wiring:park/b
    - wiring:precharge/hvs
    - wiring:estop/tb
    - wiring:bms/ta
    - wiring:bms/tb
    - wiring:kelly/a
    - wiring:gateway/ta
    - wiring:plug/a
    - wiring:plug/b
    - wiring:plug/a2
    - wiring:plug/b35
    - schem:ta
    - schem:tb
    - schem:hvs
    - cutsheet:teensy
    - board:bms_master/TA
    - board:bms_master/TB
    pinmap_refs:
    - P11
    - P12
    - G04
    - G06
    - C01
    - C02
    - C03
    - C04
    - C05
    superseded_by: null
    owned: 'yes'
    cost: null
    tier: null
  teensy_breakout:
    category: bms
    name: Teensy breakout
    maker: Treedix
    model: UNKNOWN (Treedix Teensy breakout)
    qty: 1
    status: owned
    specs:
    - $14.97
    source:
    - cash-spend/teryx-spend.md
    verified: 'no'
    open_questions: []
    diagram_ids: []
    pinmap_refs: []
    superseded_by: null
    owned: 'yes'
    cost: $14.97
    tier: null
  sn65:
    category: bms
    name: CAN transceiver
    maker: TI (Waveshare / WaterLong modules)
    model: SN65HVD230 (Waveshare SN65HVD230 CAN Board)
    qty: 6
    status: owned 4 / to-buy 2
    tier: CRITICAL
    specs:
    - 3.3 V; 4 BICM buses + 2 vehicle bus
    source:
    - cash-spend/teryx-spend.md lines 15-16
    - cash-spend/teryx-first-drive-buys.md item 2
    - AmperaBattery/docs/COMPONENTS.md
    - teryx/teryx-shop-log.md 2026-10-21 17:20
    verified: 'yes'
    open_questions: []
    diagram_ids:
    - wiring:overview/xc
    - wiring:bms/a1
    - wiring:bms/a2
    - wiring:bms/veh
    - schem:x1
    - schem:x2
    - schem:x3
    - schem:x4
    - schem:x5
    - schem:x6
    - cutsheet:sn65
    - board:bms_master/SN2
    - board:bms_master/SN1
    - board:bms_master/SN5
    - board:bms_master/SN3
    - board:bms_master/SN4
    - board:bms_master/SN6
    pinmap_refs:
    - C01
    - C02
    - C03
    - C04
    - C05
    - C10
    - C11
    - C12
    - C13
    - C14
    superseded_by: null
    owned: partial
    cost: null
  mcp2515:
    category: bms
    name: CAN controller module
    maker: Microchip (module)
    model: MCP2515
    qty: 1
    status: owned (not used)
    specs:
    - Bought with 2× ESP32 + LM2596 kit $54.39; current CAN_LAYOUT_V2 uses Teensy native CAN (role UNVERIFIED)
    source:
    - cash-spend/teryx-spend.md
    - cash-spend/teryx-first-drive-buys.md
    verified: 'yes'
    open_questions: []
    resolution: 'Owned but NOT needed: 2 Teensys give 5 native CAN buses (cash_parts_full MCP2515-KIT)'
    diagram_ids: []
    pinmap_refs: []
    superseded_by: null
    owned: 'yes'
    cost: $54.39
    tier: null
  esp32:
    category: bms
    name: ESP32 gateway
    maker: Espressif (DevKit)
    model: ESP32 DevKit (exact board UNKNOWN)
    qty: 2
    status: owned
    tier: LATER
    specs:
    - Serial4 from Teensy A @115200; first drive uses laptop USB instead (LATER)
    source:
    - cash-spend/teryx-spend.md
    - teryx/teryx-shop-log.md
    - AmperaBattery/docs/COMPONENTS.md
    verified: partial
    open_questions: []
    diagram_ids:
    - wiring:overview/esp
    - wiring:gateway/esp
    - schem:esp
    - board:bms_master/ESP32
    pinmap_refs:
    - S30
    - G05
    - X01
    superseded_by: null
    owned: 'yes'
    cost: null
  buck_lm2596:
    category: lv
    name: Buck converter
    maker: UNKNOWN
    model: LM2596 module
    qty: 1
    status: owned
    specs:
    - 'bench power — see docs/BENCH.md §2 (BENCH_POWER, DECIDED chief 06:57 #7)'
    source:
    - cash-spend/teryx-spend.md
    - AmperaBattery/docs/BENCH.md
    verified: 'yes'
    open_questions: []
    diagram_ids: []
    pinmap_refs: []
    superseded_by: null
    owned: 'yes'
    cost: null
    tier: null
  buck_drok:
    category: lv
    name: Mini buck 12->5 V
    maker: DROK
    model: UNKNOWN (DROK mini buck, 4.5–20 V in, 3 A)
    qty: 5
    status: owned (5-pack, considering)
    specs:
    - '1 used on the first-drive board (bms_master PS1: Teensy A + B, LEM, pedal, clamp); the rest are spares (chief 06:57 #4)'
    source:
    - teryx/teryx-shop-log.md 2026-10-19 19:25/20:04
    - teryx/perfboard/BOM.md
    - bms_master_answers.md (chief + Sparky 2026-10-23 06:57 CT, DECIDED)
    verified: 'no'
    open_questions:
    - 'Confirm 5-pack is owned — pending Adam (chief 06:57 #4)'
    diagram_ids:
    - wiring:gateway/buck
    - wiring:power12/buck
    - schem:conv
    - board:bms_master/PS1
    pinmap_refs:
    - P07
    - P08
    - G03
    - F-BUCK
    - TB-5V
    superseded_by: null
    owned: 'yes'
    cost: null
    tier: null
  contactor_main:
    category: hv
    name: Main contactors B+ / B−
    maker: TE Connectivity (KILOVAC)
    model: EV200HAANA (1-1618002-8)
    qty: 2
    status: owned
    specs:
    - 500 A carry, 12–900 VDC, 12–24 V economized coil (3.8 A inrush 130 ms, 0.13 A hold), aux NO
    - Open-box, eBay ecrunch $31.65 ea, bought 2026-10-20
    source:
    - cash-spend/teryx-spend.md line 68
    - AmperaBattery/docs/cutsheets/INDEX.md
    - teryx/teryx-shop-log.md
    - teryx/parts_input_sparky.md
    - Adam 2026-10-23 via chief
    verified: 'yes'
    open_questions:
    - 'NO 3rd EV200 to buy (Adam 2026-10-23): spare role covered by owned Volt AEV14012 (aev_spare)'
    resolution: 'Qty 2: ledger shows 2 bought 10/20 (cash_parts_full EV200); no file records a 3rd — Sparky''s spare is unbought/optional (was CONFLICT: [2, ''3 incl spare (Sparky)''])'
    diagram_ids:
    - wiring:overview/evp
    - wiring:overview/evn
    - wiring:precharge/evp
    - wiring:precharge/evn
    - wiring:precharge/cevn
    - wiring:precharge/cevp
    - wiring:estop/c3
    - wiring:estop/c4
    - schem:evp
    - schem:evn
    - cutsheet:ev200
    pinmap_refs:
    - H06
    - H07
    - H10
    - E02
    - S01
    - S03
    superseded_by: null
    owned: 'yes'
    cost: $31.65
    tier: null
  precharge_relay:
    category: hv
    name: Precharge relay
    maker: Panasonic
    model: AEV14012 (salvaged Volt Gen1 main)
    qty: 1
    status: owned
    specs:
    - Coil 0.35 A @12 V / ~0.41 A @14.0 V, 34 Ω, 4.2 W, no economizer
    - 120 A cont / 225 A 3 min / 450 VDC
    source:
    - AmperaBattery/docs/cutsheets/INDEX.md
    - cash-spend/teryx-spend.md
    - teryx/parts_input_sparky.md
    - Panasonic EV relay catalog via Sparky 2026-10-23
    - crew decision 2026-10-23
    verified: 'yes'
    open_questions:
    - Confirm label P/N
    resolution: 'Coil 0.35 A @12 V (34 Ω, 4.2 W, NOT economized), ~0.41 A @14.0 V DC-DC; no 3 A peak (EV200 carry-over). Source: Panasonic EV relay catalog (Sparky decision 2026-10-23) (was CONFLICT: [''~0.35
      A not economized (ESTOP.md:38, cutsheet)'', ''~3 A peak (PINMAP, Config.h:192)''])'
    diagram_ids:
    - wiring:overview/pre
    - wiring:precharge/pre
    - wiring:precharge/cpre
    - wiring:estop/c1
    - schem:pre
    - cutsheet:aev
    pinmap_refs:
    - H08
    - E03
    - S02
    - S08
    superseded_by: null
    owned: 'yes'
    cost: null
    tier: null
  aev_spare:
    category: hv
    name: Spare Volt contactor (branch/spare)
    maker: Panasonic
    model: AEV14012
    qty: 1
    status: owned
    specs:
    - 'Volt Gen1 main contactor, 120 A cont / 225 A 3 min / 450 VDC: OK for precharge, charger or DC-DC branch, or as a spare precharge relay. NOT a main contactor (Kelly battery limit ~270 A on 2 strings,
      550 A rated)'
    source:
    - AmperaBattery/docs/COMPONENTS.md
    - cash-spend/teryx-spend.md:21,70; teryx-main-power-path.md:23,98; Adam 2026-10-23
    verified: partial
    open_questions: []
    diagram_ids:
    - cutsheet:aev
    pinmap_refs: []
    superseded_by: null
    owned: 'yes'
    cost: null
    tier: null
  precharge_res:
    category: hv
    name: Precharge resistor
    maker: UNKNOWN
    model: UNKNOWN (50 Ω 100 W, came with Kelly)
    qty: 1
    status: owned
    specs:
    - Kelly input capacitance (~2 mF) UNVERIFIED
    source:
    - cash-spend/teryx-spend.md
    - teryx/teryx-shop-log.md
    - teryx/parts_input_mechanic.md
    verified: 'no'
    open_questions:
    - Read resistor label to confirm 50 Ω 100 W
    diagram_ids:
    - wiring:overview/pre
    - wiring:precharge/pre
    - schem:pres
    pinmap_refs:
    - H08
    superseded_by: null
    owned: 'yes'
    cost: null
    tier: null
  fuse_a6t200:
    category: hv
    name: String fuses (Class T 200 A)
    maker: Mersen
    model: A6T200
    qty: 4
    status: owned
    specs:
    - 200 A Class T, 300 VDC; bolt to bus bar on standoffs; bought 2026-10-20 $36.20 ea
    source:
    - cash-spend/teryx-spend.md line 69
    - AmperaBattery/docs/cutsheets/INDEX.md
    - teryx/parts_input_sparky.md
    verified: 'yes'
    open_questions:
    - No spare bought
    diagram_ids:
    - wiring:overview/f
    - schem:f
    - pinmap:fuse/F-S1..S4
    - cutsheet:a6t
    pinmap_refs:
    - F-S1..S4
    - H01
    - H05
    superseded_by: null
    owned: 'yes'
    cost: $36.20
    tier: null
  precharge_fuse:
    category: hv
    name: Precharge fuse
    maker: Littelfuse
    model: KLKD-005
    qty: 1
    status: to-buy
    tier: CRITICAL
    specs:
    - 5 A 600 VDC midget, $10.84
    source:
    - cash-spend/teryx-first-drive-buys.md item 11
    verified: 'no'
    open_questions: []
    diagram_ids: []
    pinmap_refs: []
    superseded_by: null
    owned: 'no'
    cost: $10.84
  charger_fuse:
    category: hv
    name: Charger branch fuse
    maker: Mersen
    model: A6T60
    qty: 1
    status: to-buy
    tier: CRITICAL
    specs:
    - 60 A 300 VDC Class T, $36.69; holder UNKNOWN
    - Wire 6 AWG
    - For Elcon HK-LF-144-46 (46 A max)
    source:
    - cash-spend/teryx-first-drive-buys.md item 12
    - Sparky 2026-10-23
    - crew decision 2026-10-23
    verified: 'no'
    open_questions:
    - Fuse holder not chosen
    resolution: 'Mersen A6T60 60 A (1.25 × 46 A Elcon max) on 6 AWG (Sparky decision 2026-10-23; cash buylist); PINMAP F-ELC ''~40-60 A'' is stale (was CONFLICT: [''60 A A6T60 (cash)'', ''60-70 A >=250
      VDC (TIERS:68)'', ''~40-60 A (PINMAP F-ELC)'', ''1.25x46 = 57.5 A (BACKLOG:19)''])'
    diagram_ids:
    - schem:fel
    - pinmap:fuse/F-ELC
    pinmap_refs:
    - F-ELC
    - H13
    superseded_by: null
    owned: 'no'
    cost: $36.69
  dcdc_fuse:
    category: hv
    name: DC-DC branch fuse
    maker: Littelfuse
    model: KLKD-020
    qty: 1
    status: to-buy
    tier: CRITICAL
    specs:
    - 20 A 600 VDC midget, $10.84; holder (e.g. USM1) UNVERIFIED
    source:
    - cash-spend/teryx-first-drive-buys.md item 13
    verified: 'no'
    open_questions:
    - Holder part
    diagram_ids:
    - schem:fdi
    - pinmap:fuse/F-DCDC
    pinmap_refs:
    - F-DCDC
    - H12
    superseded_by: null
    owned: 'no'
    cost: $10.84
  msd:
    category: superseded
    name: Manual service disconnect
    maker: GM
    model: Volt Gen1 MSD (P/N UNKNOWN)
    qty: 1
    status: dropped 2026-10-22 (pull 4× A6T200 = service disconnect)
    specs:
    - ~350 A UNVERIFIED; now OUT of current path (pull string fuses = disconnect)
    source:
    - cash-spend/teryx-spend.md
    - teryx/parts_input_mechanic.md
    - AmperaBattery/docs/TIERS.md
    verified: 'no'
    open_questions: []
    diagram_ids: []
    pinmap_refs: []
    superseded_by: fuse_a6t200
    owned: 'no'
    cost: null
    tier: null
  cable_3_0:
    category: hv
    name: HV main cable 3/0
    maker: TEMCo
    model: 3/0 welding cable (WC0263 for 10 ft add-on)
    qty: 1
    status: owned + to-buy
    specs:
    - $137.83 owned (length UNKNOWN); +10 ft WC0263 $70.34 out of stock
    source:
    - cash-spend/teryx-spend.md
    - cash-spend/teryx-first-drive-buys.md
    verified: 'no'
    open_questions:
    - Length on hand
    diagram_ids: []
    pinmap_refs:
    - H05
    - H06
    - H07
    - H10
    superseded_by: null
    owned: 'yes'
    cost: $137.83
    tier: null
  cable_1_0:
    category: hv
    name: String leads 1/0
    maker: UNKNOWN
    model: UNKNOWN
    qty: 1
    status: to-buy
    tier: CRITICAL
    specs:
    - 1/0 from each A6T200 (~138 A at 550 A launch)
    source:
    - AmperaBattery/BACKLOG.md
    - teryx/parts_input_mechanic.md
    verified: 'no'
    open_questions:
    - Run lengths (Adam measure)
    diagram_ids: []
    pinmap_refs:
    - H01
    - H11
    superseded_by: null
    owned: 'no'
    cost: null
  lugs:
    category: hv
    name: Tinned ring lugs 3/0 + 1/0
    maker: TEMCo
    model: 3/0 3/8" tinned 10-pk (1/0 UNKNOWN)
    qty: 1
    status: to-buy
    tier: CRITICAL
    specs:
    - $18.80
    source:
    - cash-spend/teryx-first-drive-buys.md item 9
    - teryx/parts_input_mechanic.md
    verified: 'no'
    open_questions: []
    diagram_ids: []
    pinmap_refs: []
    superseded_by: null
    owned: 'no'
    cost: $18.80
  splices:
    category: hv
    name: 2 AWG butt splices
    maker: TEMCo
    model: 2 AWG butt splices
    qty: 1
    status: owned
    specs:
    - $12.79
    source:
    - cash-spend/teryx-spend.md
    verified: 'yes'
    open_questions: []
    diagram_ids: []
    pinmap_refs: []
    superseded_by: null
    owned: 'yes'
    cost: $12.79
    tier: null
  busbar:
    category: hv
    name: Bus bar, standoffs, clear cover
    maker: UNKNOWN
    model: UNKNOWN (fab)
    qty: 1
    status: to-buy
    tier: CRITICAL
    specs:
    - Tool-only cover, captive screws
    source:
    - teryx/parts_input_mechanic.md
    - AmperaBattery/BACKLOG.md
    verified: 'no'
    open_questions: []
    diagram_ids:
    - wiring:overview/bus
    - wiring:overview/pnl
    - wiring:precharge/bus
    - schem:bus
    pinmap_refs: []
    superseded_by: null
    owned: 'no'
    cost: null
  insul_wrench:
    category: hv
    name: Insulated wrench
    maker: UNKNOWN
    model: UNKNOWN
    qty: 1
    status: to-buy
    specs:
    - For pulling bolt-in string fuses
    source:
    - teryx/parts_input_mechanic.md
    - cash-spend/teryx-first-drive-buys.md
    verified: 'no'
    open_questions: []
    diagram_ids: []
    pinmap_refs: []
    superseded_by: null
    owned: 'no'
    cost: null
    tier: null
  hv_loom:
    category: hv
    name: HV orange loom, clamps, grommets
    maker: UNKNOWN
    model: UNKNOWN
    qty: 1
    status: to-buy
    tier: CRITICAL
    specs:
    - Clamp every ~12 in
    source:
    - teryx/parts_input_mechanic.md
    verified: 'no'
    open_questions: []
    diagram_ids: []
    pinmap_refs: []
    superseded_by: null
    owned: 'no'
    cost: null
  coil_fet:
    category: hv
    name: Output FETs Q4-Q6 (LIMP/ECO relay A:20, DERATE A:2, REGEN A:3)
    maker: Infineon
    model: 'CONFLICT: IRLB8721PbF (owned per Sparky) vs IRLB3813PbF (to-buy per cash; 8721 discontinued)'
    qty: 3
    status: CONFLICT
    specs:
    - Logic-level @3.3 V gate; 6 on outputs board
    - Contactor-coil FETs Q-B+/Q-PRE/Q-B− moved to coil_driver/cd_fet 2026-10-23 (qty 6 -> 3; do not double-buy)
    source:
    - teryx/parts_input_sparky.md
    - cash-spend/teryx-first-drive-buys.md item 10
    - AmperaBattery/docs/cutsheets/INDEX.md
    - teryx/perfboard/BOM.md
    - teryx/parts_input_gilfoyle.md conflict 1
    verified: 'no'
    conflict:
      field: model/status
      values:
      - IRLB8721 OWNED (Sparky)
      - IRLB3813PBF to-buy ×2 ~$2.81 (cash)
    open_questions:
    - Are IRLB8721s in hand?
    diagram_ids:
    - wiring:kelly/fet
    - cutsheet:irlb3813
    pinmap_refs:
    - S20
    superseded_by: null
    owned: CONFLICT
    cost: null
    tier: null
  estop_head:
    category: safety
    name: E-stop mushroom head (1 NC incl.)
    maker: Schneider Electric (Harmony)
    model: XB4BS8442 (PROPOSED; alternate XB5AS8442)
    qty: 1
    status: to-buy (PROPOSED)
    tier: CRITICAL
    specs:
    - 40 mm red twist-release, 1 NC included, ~$28.89
    source:
    - cash-spend/teryx-first-drive-buys.md item 4a
    - AmperaBattery/docs/TIERS.md
    - teryx/cash_models.md
    - 'teryx/parts_input_gilfoyle.md #22 (ESTOP.md:7 picks XB4BS8442; PINMAP lists XB5AS8442 first)'
    - Mechanic pick 2026-10-23 (PROPOSED)
    verified: 'no'
    open_questions:
    - chief confirm XB4BS8442 vs XB5AS8442
    resolution: 'PROPOSED (not chief-confirmed): XB4BS8442 metal = Mechanic''s pick, matches shop log; XB5AS8442 plastic = alternate (Mechanic 2026-10-23) (was CONFLICT: [''XB4BS8442'', ''XB5AS8442''])'
    diagram_ids:
    - wiring:overview/es
    - wiring:estop/es
    - pinmap:connector/ESTOP
    - cutsheet:estop
    pinmap_refs:
    - ESTOP
    - E01
    - E02
    - E03
    - E09
    - F-COIL
    superseded_by: null
    owned: 'no'
    cost: $28.89
  estop_blocks:
    category: safety
    name: E-stop extra NC blocks
    maker: Schneider Electric
    model: ZBE102
    qty: 2
    status: to-buy
    tier: CRITICAL
    specs:
    - 1 NC each; 0.55 A @125 V DC-13; 3 NC total with head ($9.89 ea)
    source:
    - cash-spend/teryx-first-drive-buys.md final e-stop
    - AmperaBattery/docs/cutsheets/INDEX.md
    - teryx/parts_input_mechanic.md
    verified: 'no'
    open_questions: []
    diagram_ids:
    - wiring:overview/es
    - wiring:estop/es
    - wiring:estop/nc1
    - wiring:estop/nc2
    - wiring:estop/nc3
    - schem:es1
    - schem:es2
    - schem:es3
    - pinmap:connector/ESTOP
    - cutsheet:estop
    pinmap_refs:
    - ESTOP
    - E01
    - E02
    - E03
    - E09
    superseded_by: null
    owned: 'no'
    cost: $9.89
  estop_box:
    category: safety
    name: E-stop guarded IP65 box + guard
    maker: Schneider (guard ZBZ1604 option)
    model: UNKNOWN
    qty: 1
    status: to-buy
    specs:
    - Sealed, guarded box deep enough for 3 stacked ZBE102 blocks
    source:
    - teryx/parts_input_mechanic.md
    - cash-spend/teryx-first-drive-buys.md
    - Mechanic 2026-10-23
    verified: 'no'
    open_questions:
    - 'Box model; ZBE102 qty here says 3 stacked vs estop_blocks qty 2 (+ head''s built-in NC): confirm block count'
    diagram_ids: []
    pinmap_refs: []
    superseded_by: null
    owned: 'no'
    cost: null
    tier: null
  isolation_tester:
    category: safety
    name: Insulation (megger) tester
    maker: UNKNOWN
    model: UNKNOWN
    qty: 1
    status: to-buy / borrow
    specs:
    - 500 V, ≥1 MΩ check before HV
    source:
    - cash-spend/teryx-main-power-path.md
    - AmperaBattery/docs/TIERS.md
    verified: 'no'
    open_questions: []
    diagram_ids: []
    pinmap_refs: []
    superseded_by: null
    owned: 'no'
    cost: null
    tier: null
  hv_sense:
    category: safety
    name: Isolated HV voltage sensor
    maker: Texas Instruments
    model: AMC1311EVM
    qty: 1
    status: LATER (dropped)
    tier: LATER
    specs:
    - Only if Kelly CAN B+ bench gate fails (~$50); room decision 2026-10-23
    source:
    - AmperaBattery/docs/CONNECTIONS.md
    - room 2026-10-23
    verified: 'yes'
    open_questions: []
    diagram_ids: []
    pinmap_refs:
    - S08
    superseded_by: Kelly CAN B+ readback (if bench gate passes)
    owned: 'no'
    cost: null
  charger:
    category: charging
    name: On-board charger
    maker: Elcon (TC Charger)
    model: HK-LF-144-46 (config CAN3865)
    qty: 1
    status: owned
    specs:
    - 'Label read 2026-10-15: in 90–264 VAC 45–65 Hz 32 A; out 100–202 VDC 46 A; SN23100137B'
    - CAN 250 kbps, IDs 0x1806E5F4 / 0x18FF50E5
    - '''E5'' was the CAN-ID sticker, not the model; older ''HK-MF-xxx'' notes are SUPERSEDED'
    source:
    - teryx/teryx-shop-log.md 2026-10-15 20:44
    - cash-spend/teryx-spend.md line 11
    - teryx/cash_models.md
    verified: 'yes'
    open_questions: []
    diagram_ids:
    - wiring:overview/elc
    - wiring:bms/elc
    - schem:elc
    - cutsheet:elcon
    pinmap_refs:
    - CAN-V
    - F-ELC
    - C10
    - H13
    - H14
    superseded_by: null
    owned: 'yes'
    cost: null
    tier: null
  dcdc:
    category: charging
    name: DC-DC converter HV -> 12 V
    maker: Elcon (TC Charger)
    model: TDC-JH-144-12 (CAN5100, S/N 220301526)
    qty: 1
    status: owned
    specs:
    - 'Per 10/15 label read: in 88–195 VDC, out 14.0 V 110 A, CAN5100, S/N 220301526'
    - Isolation input↔12 V− UNVERIFIED (test before chassis bond)
    - Rated output amps set F-MAIN fuse and P01 gauge
    - 1.5 kW; out 14.0 V 110 A (sets F-MAIN ≈1.25×110 A and P01 gauge)
    source:
    - teryx/teryx-shop-log.md 2026-10-15 20:44
    - cash-spend/teryx-spend.md line 28
    - teryx/parts_input_sparky.md
    - teryx/cash_models.md
    - AmperaBattery/docs/CONNECTIONS.md
    - teryx/teryx-shop-log.md:236
    - teryx/cash_parts_full.yaml
    - crew decision 2026-10-23
    verified: 'yes'
    open_questions:
    - Isolation test (HV in to 12 V−) before 12 V− chassis bond; price not on file
    resolution: 'RESOLVED: TDC-JH-144-12 per label read 2026-10-15 20:44 (shop log:236 ''NOT the TDC-IY in prior notes''; also shop log:64,294; cash_parts_full DCDC); TDC-IY = stale (was CONFLICT: [''TDC-JH-144-12'',
      ''TDC-IY''])'
    diagram_ids:
    - wiring:overview/dcdc
    - wiring:power12/dcdc
    - schem:dcdc
    - cutsheet:dcdc
    pinmap_refs:
    - P01
    - F-MAIN
    - H12
    - F-DCDC
    superseded_by: null
    owned: 'yes'
    cost: null
    tier: null
  lv_battery:
    category: lv
    name: 12 V buffer battery
    maker: UNKNOWN
    model: UNKNOWN
    qty: 1
    status: to-buy
    tier: CRITICAL
    specs:
    - Keeps contactors fed if DC-DC drops (review 2026-10-23)
    - + post -> F-BATT 150 A (≤ 7 in) -> 12 V bus + (P13/P14, 2 AWG, PROPOSED); - post -> TB-GND/chassis (G13, 2 AWG, PROPOSED) — Sparky 2026-10-23 07:34 CT (DECIDED)
    source:
    - cash-spend/teryx-main-power-path.md
    - teryx/review/full_program_review_chief.md
    - Sparky 2026-10-23 07:34 CT (DECIDED)
    verified: 'no'
    open_questions: []
    diagram_ids: []
    pinmap_refs:
    - F-BATT
    - P13
    - P14
    - G13
    - F-AUX
    superseded_by: null
    owned: 'no'
    cost: null
  ac_inlet:
    category: charging
    name: AC inlet
    maker: UNKNOWN
    model: UNKNOWN (NACS / J3400 AC inlet, model not chosen)
    qty: 1
    status: LATER
    specs:
    - 'Simple NACS: fixed resistors + diode on pilot caps Elcon ~12 A'
    source:
    - teryx/teryx-shop-log.md
    - teryx/parts_input_sparky.md
    - AmperaBattery/BACKLOG.md
    verified: 'no'
    open_questions:
    - 'Adam: home outlet / plug types; choose NACS vs NEMA'
    tier: LATER
    resolution: NACS AC inlet only, no J1772 (Adam 9/25 via Sparky; shop log:77,201); older 'NACS or J1772' (shop log:296) stale. Specific inlet model not chosen.
    diagram_ids:
    - wiring:overview/nacs
    - wiring:plug/prox
    - schem:inlet
    pinmap_refs:
    - S45
    - H14
    superseded_by: null
    owned: 'no'
    cost: null
  ac_contactor:
    category: charging
    name: AC contactor (BMS-controlled) + 2-pole breaker
    maker: UNKNOWN
    model: UNKNOWN
    qty: 1
    status: to-buy (PROPOSED)
    specs:
    - Stays CRITICAL for charging path
    source:
    - teryx/parts_input_sparky.md
    verified: 'no'
    open_questions:
    - Pick parts after inlet choice
    diagram_ids: []
    pinmap_refs: []
    superseded_by: null
    owned: 'no'
    cost: null
    tier: null
  lm393:
    category: superseded
    name: Plug-detect comparator
    maker: TI (or any)
    model: LM393
    qty: 1
    status: superseded
    tier: null
    specs:
    - 'Dual comparator; superseded 2026-10-23 by LM339 (needs 4 channels: plug-present ×2 + release-button ×2)'
    source:
    - AmperaBattery/BACKLOG.md
    - AmperaBattery/docs/CONNECTIONS.md
    - crew decision 2026-10-23
    verified: 'no'
    open_questions: []
    diagram_ids: []
    pinmap_refs:
    - S41
    - S44
    - S46
    - S47
    - S48
    - S49
    superseded_by: lm339
    owned: 'no'
    cost: null
  lm339:
    category: charging
    name: Plug + latch detect quad comparator
    maker: TI (or any)
    model: LM339
    qty: 1
    status: to-buy
    specs:
    - Quad comparator for NACS AC inlet (Adam chose NACS 9/25)
    - 'Pinout (TI LM339 datasheet, SOURCED): 1 OUT2, 2 OUT1, 3 VCC, 4/5 IN1−/IN1+, 6/7 IN2−/IN2+, 8/9 IN3−/IN3+, 10/11 IN4−/IN4+, 12 GND, 13 OUT4, 14 OUT3'
    - 'ch1 OUT1 (2) -> A:33 plug A (S41), ch2 OUT2 (1) -> B:33 plug B (S44): 2.5 V ref (S48)'
    - 'ch3 OUT3 (14) -> 1k -> A:2 release A (S51), ch4 OUT4 (13) -> 1k -> B:35 release B (S52): 1.40 V ref = 10k/3.9k from 5 V (S53); own 10k pull-up + 100 nF per output'
    - 'No hysteresis resistors: 100 nF at each pin + 20 ms firmware debounce (DECIDED Sparky 06:57 #3); VCC 5 V pin 3, GND pin 12 (S47/S49)'
    source:
    - teryx/teryx-shop-log.md:77,201 (NACS 9/25)
    - teryx/parts_input_sparky.md
    - crew decision 2026-10-23
    - bms_master_answers.md (chief + Sparky 2026-10-23 06:57 CT, DECIDED)
    verified: 'no'
    open_questions:
    - 'Not owned: purchase pending (no purchases by Gilfoyle)'
    - Firmware must set A:2 INPUT and read plug/release with 20 ms debounce (not implemented; no flashing)
    resolution: 'DECIDED 2026-10-23 (crew): LM339 replaces LM393; re-pinned + release detect on A:2/B:35 DECIDED chief + Sparky 06:57 (Build 24)'
    diagram_ids:
    - wiring:plug/lm1
    - wiring:plug/lm2
    - wiring:plug/lm3
    - wiring:plug/lm4
    - board:bms_master/U5
    pinmap_refs:
    - S41
    - S44
    - S46
    - S47
    - S48
    - S49
    - S51
    - S52
    - S53
    superseded_by: null
    owned: 'no'
    cost: null
    tier: null
  inlet_switch:
    category: superseded
    name: Inlet-cover microswitch
    maker: UNKNOWN
    model: UNKNOWN (sealed roller-lever, 2 contacts)
    qty: 1
    status: dropped (NEMA-only path; inlet is NACS)
    specs:
    - Only for NEMA dumb inlet; to A:33/B:33
    source:
    - teryx/parts_input_mechanic.md
    verified: 'no'
    open_questions: []
    superseded_by: ac_inlet
    diagram_ids: []
    pinmap_refs: []
    owned: 'no'
    cost: null
    tier: null
  lv_fuses:
    category: lv
    name: Mini-blade fuses + holders
    maker: Nilight / VANSIHO
    model: Amazon B0B24YYYCF / B0C15H3F9M
    qty: 1
    status: to-buy
    specs:
    - Shop-kit list 2026-10-11
    source:
    - teryx/teryx-shop-log.md
    verified: 'no'
    open_questions: []
    diagram_ids:
    - wiring:estop/f
    - wiring:aux/f12
    - wiring:power12/fk
    - wiring:power12/fd
    - wiring:power12/fe
    - wiring:power12/ft
    - wiring:power12/f3
    - wiring:power12/f1
    - schem:fkel
    - schem:fdrv
    - schem:fesp
    - schem:ftab
    - schem:faux
    - schem:fbx
    - pinmap:fuse/F-COIL
    - pinmap:fuse/F-KEL
    - pinmap:fuse/F-EBOX
    - pinmap:fuse/F-BUCK
    - pinmap:fuse/F-BICM
    - pinmap:fuse/F-TAB
    - pinmap:fuse/F-AUX
    - board:bms_master/F-BUCK
    - board:bms_master/F-BICM
    pinmap_refs: []
    superseded_by: null
    owned: 'no'
    cost: null
    tier: null
  deutsch:
    category: lv
    name: Deutsch DT kit + crimper
    maker: ALFOCI
    model: Amazon B0DZ331GDL (217 pc)
    qty: 1
    status: to-buy
    specs:
    - $38.99
    source:
    - teryx/teryx-shop-log.md
    verified: 'no'
    open_questions: []
    diagram_ids:
    - pinmap:connector/EBOX-DT
    pinmap_refs: []
    superseded_by: null
    owned: 'no'
    cost: $38.99
    tier: null
  txl:
    category: lv
    name: TXL wire 16–20 AWG
    maker: crimpzone
    model: UNKNOWN
    qty: 1
    status: to-buy
    specs:
    - $15–70
    source:
    - teryx/teryx-shop-log.md
    - cash-spend/teryx-first-drive-buys.md
    verified: 'no'
    open_questions: []
    diagram_ids: []
    pinmap_refs: []
    superseded_by: null
    owned: 'no'
    cost: null
    tier: null
  heat_shrink:
    category: lv
    name: Adhesive heat shrink 3:1
    maker: Wirefy
    model: Amazon B084GDLSCK
    qty: 1
    status: owned
    specs:
    - $14.99
    source:
    - teryx/teryx-shop-log.md
    - teryx/parts_input_mechanic.md
    verified: 'yes'
    open_questions: []
    diagram_ids: []
    pinmap_refs: []
    superseded_by: null
    owned: 'yes'
    cost: $14.99
    tier: null
  pedal:
    category: controls
    name: Dual-track Hall throttle pedal
    maker: Subaru (via EV West) recommended
    model: 'UNKNOWN (not chosen): Subaru WRX/STI 2008–14 used (rec, $119) / Toyota Prius 78120-47050 ($139)'
    qty: 1
    status: to-buy
    tier: CRITICAL
    specs:
    - Track 1 to Kelly, track 2 to Teensy
    source:
    - cash-spend/teryx-first-drive-buys.md item 3a/3b
    - teryx/parts_input_mechanic.md
    verified: 'no'
    open_questions:
    - Adam pick; must fit floor/travel with return spring + hard stop
    diagram_ids:
    - wiring:overview/ped
    - wiring:clamp/ped
    - schem:ped
    - cutsheet:pedal
    pinmap_refs:
    - S14
    - S15
    - P20
    - G11
    superseded_by: null
    owned: 'no'
    cost: null
  digipot:
    category: controls
    name: Throttle clamp digipot
    maker: Microchip
    model: MCP4131-103E/P
    qty: 2
    status: to-buy
    tier: CRITICAL
    specs:
    - 10 k, 7-bit, SPI, DIP-8
    - 'DECIDED 2026-10-23 (crew): firmware ThrottleTrim, perfboard U3 and wiring_data all use MCP4131; MCP41010 needs a different SPI command byte'
    - Buy from Digikey/Mouser (Tayda does not stock it)
    source:
    - AmperaBattery/docs/COMPONENTS.md
    - AmperaBattery/docs/cutsheets/INDEX.md
    - cash-spend/teryx-first-drive-buys.md item 1a
    - crew decision 2026-10-23
    verified: 'no'
    open_questions: []
    diagram_ids:
    - wiring:overview/clamp
    - wiring:clamp/u3
    - schem:clamp
    - cutsheet:mcp4131
    - board:bms_master/U3
    pinmap_refs:
    - S10
    - B02
    superseded_by: null
    owned: 'no'
    cost: null
  analog_switch:
    category: controls
    name: Throttle clamp analog switch
    maker: TI
    model: 'CD74HC4066E (cash: generic CD4066)'
    qty: 2
    status: to-buy
    tier: CRITICAL
    specs:
    - Quad bilateral switch
    source:
    - AmperaBattery/docs/cutsheets/INDEX.md
    - cash-spend/teryx-first-drive-buys.md item 1b
    verified: 'no'
    open_questions: []
    diagram_ids:
    - wiring:overview/clamp
    - wiring:clamp/u2a
    - wiring:clamp/u2b
    - wiring:enables/sw
    - schem:clamp
    - cutsheet:hc4066
    - board:bms_master/U2
    pinmap_refs:
    - B02
    - K01
    superseded_by: null
    owned: 'no'
    cost: null
  oneshot:
    category: controls
    name: Throttle clamp one-shot
    maker: TI
    model: CD74HCT123E
    qty: 2
    status: to-buy
    tier: CRITICAL
    specs:
    - Dual retriggerable monostable, DIP-16
    - 'DECIDED 2026-10-23 (crew): clamp runs at 5 V (ASSUMED); HCT TTL input threshold accepts the Teensy 3.3 V alive outputs, HC at 5 V needs 3.5 V VIH and fails'
    - Buy from Digikey/Mouser (not Tayda)
    source:
    - AmperaBattery/docs/cutsheets/INDEX.md
    - cash-spend/teryx-first-drive-buys.md item 1c
    - crew decision 2026-10-23
    verified: 'no'
    open_questions: []
    diagram_ids:
    - wiring:overview/clamp
    - wiring:clamp/u1
    - wiring:enables/q1
    - wiring:enables/q2
    - schem:clamp
    - cutsheet:hct123
    - board:bms_master/U1
    pinmap_refs:
    - S11
    - S12
    superseded_by: null
    owned: 'no'
    cost: null
  buffer:
    category: controls
    name: Throttle clamp buffer
    maker: TI
    model: SN74AHCT125N
    qty: 1
    status: to-buy
    tier: CRITICAL
    specs:
    - ''
    source:
    - AmperaBattery/docs/cutsheets/INDEX.md
    - AmperaBattery/docs/COMPONENTS.md
    verified: 'no'
    open_questions: []
    diagram_ids:
    - wiring:overview/clamp
    - wiring:clamp/u4
    - schem:clamp
    - cutsheet:ahct125
    - board:bms_master/U4
    pinmap_refs:
    - S10
    - S11
    superseded_by: null
    owned: 'no'
    cost: null
  io_expander:
    category: controls
    name: Body I/O expander
    maker: Microchip
    model: MCP23017
    qty: 1
    status: to-buy (PROPOSED)
    tier: LATER
    specs:
    - 'LATER — footprint only on bms_master (U6, not fitted); 0x20 (A0-A2 to GND), 4.7k SDA/SCL pull-ups to 3.3 V, RESET high via 10k (DECIDED chief 06:57 #3)'
    source:
    - AmperaBattery/docs/cutsheets/INDEX.md
    - bms_master_answers.md (chief + Sparky 2026-10-23 06:57 CT, DECIDED)
    verified: 'no'
    open_questions: []
    diagram_ids:
    - wiring:power12/buzz
    - schem:lbuz
    - cutsheet:mcp23017
    - board:bms_master/U6
    pinmap_refs: []
    superseded_by: null
    owned: 'no'
    cost: null
  key_switch:
    category: controls
    name: Key switch
    maker: Kawasaki
    model: stock Teryx key switch
    qty: 1
    status: installed
    specs:
    - Switched output wire colour UNKNOWN
    source:
    - AmperaBattery/docs/CONNECTIONS.md
    - teryx/parts_input_mechanic.md
    verified: 'no'
    open_questions:
    - Backprobe wire colour
    diagram_ids: []
    pinmap_refs:
    - S42
    - S43
    superseded_by: null
    owned: 'yes'
    cost: null
    tier: null
  park_switch:
    category: controls
    name: Park-brake switch
    maker: Potter Amseco
    model: PSW-2B (1 NO + 1 NC) placeholder
    qty: 1
    status: LATER
    tier: LATER
    specs:
    - Sealed UTV-grade part UNKNOWN
    source:
    - cash-spend/teryx-first-drive-buys.md item 6
    verified: 'no'
    open_questions: []
    diagram_ids:
    - wiring:overview/pk
    - wiring:park/sw
    - wiring:park/sw3
    - schem:pk
    pinmap_refs:
    - S16
    - S17
    - K02
    - X02
    superseded_by: null
    owned: 'no'
    cost: null
  radiator:
    category: cooling
    name: Radiator + fan
    maker: Kawasaki
    model: stock Teryx radiator + fan
    qty: 1
    status: owned
    specs:
    - Fan always-on/thermoswitch for first drive
    source:
    - teryx/parts_input_mechanic.md
    verified: 'yes'
    open_questions: []
    diagram_ids: []
    pinmap_refs: []
    superseded_by: null
    owned: 'yes'
    cost: null
    tier: null
  pump:
    category: cooling
    name: 12 V coolant pump
    maker: Bosch
    model: 0392022010 (candidate)
    qty: 1
    status: to-buy
    tier: CRITICAL
    specs:
    - ~$161.99, 5/8" ports
    source:
    - teryx/teryx-shop-log.md
    - teryx/parts_input_mechanic.md
    verified: 'no'
    open_questions:
    - Kelly fitting + radiator neck OD (measure)
    diagram_ids: []
    pinmap_refs: []
    superseded_by: null
    owned: 'no'
    cost: $161.99
  actuators:
    category: body
    name: 4WD + diff-lock linear actuators
    maker: Glideforce
    model: LACT4P-12V-10 (or -20 if pull >30 lb)
    qty: 2
    status: LATER
    tier: LATER
    specs:
    - Cables pinned 2WD/open for first drive
    - Stall 7 A @12 V; alt Firgelli 4in 150 lb $149.99
    source:
    - teryx/teryx-shop-log.md
    - teryx/parts_input_mechanic.md
    - 'teryx/parts_input_gilfoyle.md #19'
    verified: 'no'
    open_questions:
    - Cable pull force + travel
    diagram_ids: []
    pinmap_refs: []
    superseded_by: null
    owned: 'no'
    cost: $149.99
  hbridge:
    category: body
    name: Actuator H-bridge drivers
    maker: UNKNOWN
    model: BTS7960 module (alt VNH5019)
    qty: 2
    status: LATER
    tier: LATER
    specs:
    - 3 if e-park
    source:
    - teryx/teryx-shop-log.md
    - teryx/parts_input_mechanic.md
    verified: 'no'
    open_questions: []
    diagram_ids: []
    pinmap_refs: []
    superseded_by: null
    owned: 'no'
    cost: null
  heater:
    category: body
    name: Battery coolant heater
    maker: Hotstart
    model: CB115110-200 (deferred)
    qty: 1
    status: LATER
    tier: LATER
    specs:
    - ''
    source:
    - teryx/teryx-shop-log.md
    verified: 'no'
    open_questions: []
    diagram_ids: []
    pinmap_refs: []
    superseded_by: null
    owned: 'no'
    cost: null
  seat_heaters:
    category: body
    name: Seat heaters
    maker: UNKNOWN
    model: UNKNOWN
    qty: 2
    status: LATER
    tier: LATER
    specs:
    - ''
    source:
    - AmperaBattery/docs/COMPONENTS.md
    - teryx/parts_input_mechanic.md
    verified: 'no'
    open_questions:
    - 'Adam: seat heater type'
    diagram_ids: []
    pinmap_refs: []
    superseded_by: null
    owned: 'no'
    cost: null
  tablet:
    category: body
    name: Dash display
    maker: UNKNOWN
    model: 'CONFLICT: Surface 3 (COMPONENTS) vs iPad (schematic/gen.py:39) vs Android 10-11in to buy (TIERS:72)'
    qty: 1
    status: LATER
    tier: LATER
    specs:
    - ''
    source:
    - AmperaBattery/docs/COMPONENTS.md
    - teryx/teryx-shop-log.md
    - teryx/parts_input_gilfoyle.md conflict 9
    verified: 'no'
    open_questions: []
    conflict:
      field: model
      values:
      - Surface 3
      - iPad
      - Android tablet
    diagram_ids:
    - wiring:overview/head
    - wiring:gateway/ipad
    - schem:tab
    pinmap_refs:
    - P06
    - F-TAB
    - X01
    superseded_by: null
    owned: 'no'
    cost: null
  x_ev11:
    category: superseded
    name: Precharge relay (old plan)
    maker: TE
    model: Mini-K / EV11 2-1904058-7
    qty: 0
    status: superseded
    specs:
    - Replaced by AEV14012 (not pack-voltage rated)
    source:
    - teryx/parts_input_sparky.md
    - teryx/teryx-shop-log.md
    verified: 'yes'
    open_questions: []
    diagram_ids: []
    pinmap_refs: []
    superseded_by: precharge_relay
    owned: 'no'
    cost: null
    tier: null
  x_ev100:
    category: superseded
    name: Precharge relay alt
    maker: TE
    model: LEV100A4ANG (EV100)
    qty: 0
    status: superseded
    specs:
    - Replaced by AEV14012
    source:
    - teryx/parts_input_sparky.md
    - teryx/teryx-shop-log.md
    verified: 'yes'
    open_questions: []
    diagram_ids: []
    pinmap_refs: []
    superseded_by: precharge_relay
    owned: 'no'
    cost: null
    tier: null
  x_ev200aaana:
    category: superseded
    name: Main contactor alt
    maker: TE
    model: EV200AAANA / Gigavac GV200BA-1
    qty: 0
    status: superseded
    specs:
    - Replaced by EV200HAANA
    source:
    - teryx/teryx-shop-log.md
    verified: 'yes'
    open_questions: []
    diagram_ids: []
    pinmap_refs: []
    superseded_by: contactor_main
    owned: 'no'
    cost: null
    tier: null
  x_a6t150:
    category: superseded
    name: String fuse A6T150 (superseded)
    maker: Mersen
    model: A6T150
    qty: 0
    status: superseded
    specs:
    - 150 A Class T; replaced 2026-10-20 by A6T200 (bought)
    source:
    - teryx/parts_input_sparky.md
    - teryx/teryx-shop-log.md
    - teryx/teryx-shop-log.md:302,331
    verified: 'yes'
    open_questions: []
    diagram_ids: []
    pinmap_refs: []
    superseded_by: fuse_a6t200
    owned: 'no'
    cost: null
    tier: null
  x_classt300:
    category: superseded
    name: String fuse (old)
    maker: Bussmann
    model: JJN-300 / JJS-300
    qty: 0
    status: dropped
    specs:
    - ''
    source:
    - cash-spend/teryx-main-power-path.md
    verified: 'yes'
    open_questions: []
    diagram_ids: []
    pinmap_refs: []
    superseded_by: fuse_a6t200
    owned: 'no'
    cost: null
    tier: null
  x_bluesea:
    category: superseded
    name: Class T holders
    maker: Blue Sea
    model: 5007100 / 5502
    qty: 0
    status: dropped
    specs:
    - Fuses bolt to bus bar
    source:
    - cash-spend/teryx-first-drive-buys.md
    verified: 'yes'
    open_questions: []
    diagram_ids: []
    pinmap_refs: []
    superseded_by: busbar
    owned: 'no'
    cost: null
    tier: null
  x_a6t600:
    category: superseded
    name: Bus fuse fallback
    maker: Mersen
    model: A6T600
    qty: 0
    status: dropped
    specs:
    - MSD out of path
    source:
    - cash-spend/teryx-first-drive-buys.md
    verified: 'yes'
    open_questions: []
    diagram_ids: []
    pinmap_refs: []
    superseded_by: fuse_a6t200
    owned: 'no'
    cost: null
    tier: null
  x_coil_relay:
    category: superseded
    name: E-stop coil-feed relay
    maker: UNKNOWN
    model: Bosch-style 40 A SPDT
    qty: 0
    status: dropped
    specs:
    - ''
    source:
    - cash-spend/teryx-first-drive-buys.md
    verified: 'yes'
    open_questions: []
    diagram_ids: []
    pinmap_refs: []
    superseded_by: estop_blocks
    owned: 'no'
    cost: null
    tier: null
  x_jkbms:
    category: superseded
    name: JK BMS / DALY BMS
    maker: JK / DALY
    model: JK-B2A24S30P / DALY Smart BMS
    qty: 0
    status: not Teryx
    specs:
    - Golf cart / other
    source:
    - cash-spend/teryx-spend.md
    - AmperaBattery/docs/COMPONENTS.md
    verified: 'yes'
    open_questions: []
    diagram_ids: []
    pinmap_refs: []
    superseded_by: null
    owned: 'no'
    cost: null
    tier: null
  x_mcp41010:
    category: superseded
    name: Throttle clamp digipot (rejected alternate)
    maker: Microchip
    model: MCP41010-I/P
    qty: 0
    status: rejected
    specs:
    - 'Rejected 2026-10-23 (crew DECIDED): needs a different SPI command byte than firmware ThrottleTrim / perfboard U3 / wiring_data, which use MCP4131-103E/P'
    source:
    - cash-spend/teryx-first-drive-buys.md item 1a
    - crew decision 2026-10-23
    verified: 'yes'
    open_questions: []
    diagram_ids: []
    pinmap_refs: []
    superseded_by: digipot
    owned: 'no'
    cost: null
    tier: null
  x_cd74hc123e:
    category: superseded
    name: Throttle clamp one-shot (rejected alternate)
    maker: TI
    model: CD74HC123E
    qty: 0
    status: rejected
    specs:
    - 'Rejected 2026-10-23 (crew DECIDED): HC at 5 V needs VIH 3.5 V, fails with the Teensy 3.3 V alive outputs; use CD74HCT123E (TTL threshold)'
    source:
    - cash-spend/teryx-first-drive-buys.md item 1c
    - crew decision 2026-10-23
    verified: 'yes'
    open_questions: []
    diagram_ids: []
    pinmap_refs: []
    superseded_by: oneshot
    owned: 'no'
    cost: null
    tier: null
  x_hkmf:
    category: superseded
    name: Charger 'Elcon E5 / HK-MF-xxx'
    maker: Elcon
    model: HK-MF-xxx / 'E5'
    qty: 0
    status: superseded
    specs:
    - E5 = CAN sticker; real model HK-LF-144-46
    source:
    - teryx/teryx-shop-log.md
    - teryx/cash_models.md
    verified: 'yes'
    open_questions: []
    diagram_ids: []
    pinmap_refs: []
    superseded_by: charger
    owned: 'no'
    cost: null
    tier: null
  contactor_upgrade:
    category: hv
    name: Main contactor optional upgrade
    maker: Gigavac
    model: GX14BA
    qty: 2
    status: PROPOSED (optional, undecided)
    specs:
    - 525 A / 10 s; $205 ea
    source:
    - 'teryx/parts_input_gilfoyle.md #7'
    - AmperaBattery/docs/TERYX_MAIN_POWER_PATH.md:34,40
    verified: 'no'
    open_questions: []
    diagram_ids: []
    pinmap_refs: []
    superseded_by: null
    owned: 'no'
    cost: null
    tier: null
  ivt_s:
    category: bms
    name: Optional CAN current sensor
    maker: Isabellenhuette
    model: IVT-S-1K-U3-I-CAN1-12/24 (alt CAB300, no full model)
    qty: 1
    status: PROPOSED (optional)
    tier: LATER
    specs:
    - 1000 A, 500 kbps CAN; not owned
    source:
    - 'teryx/parts_input_gilfoyle.md #12'
    verified: 'no'
    open_questions: []
    diagram_ids: []
    pinmap_refs: []
    superseded_by: null
    owned: 'no'
    cost: null
  clr_diode:
    category: controls
    name: Throttle clamp /CLR diode D5
    maker: UNKNOWN
    model: 1N4148
    qty: 1
    status: to-buy (PROPOSED)
    tier: CRITICAL
    specs:
    - across R5 10k with C5 1 uF
    source:
    - 'teryx/parts_input_gilfoyle.md #15'
    verified: 'no'
    open_questions: []
    diagram_ids:
    - wiring:clamp/clr
    - board:bms_master/D5
    pinmap_refs: []
    superseded_by: null
    owned: 'no'
    cost: null
  kelly_cutback_iface:
    category: controls
    name: Kelly limp/regen-inhibit interface
    maker: UNKNOWN
    model: PC817 opto or 2N7000 + 1k
    qty: 3
    status: PROPOSED
    tier: LATER
    specs:
    - OUT3 limp / OUT6 regen inhibit; KLS regen input UNVERIFIED
    source:
    - 'teryx/parts_input_gilfoyle.md #16'
    verified: 'no'
    open_questions: []
    diagram_ids: []
    pinmap_refs: []
    superseded_by: null
    owned: 'no'
    cost: null
  eco_relay:
    category: controls
    name: Kelly ECO Low-cap relay
    maker: UNKNOWN
    model: UNKNOWN (12 V SPDT Bosch-style 30/87a, not chosen) + FET + 1N4007
    qty: 1
    status: PROPOSED
    tier: LATER
    specs:
    - ''
    source:
    - 'teryx/parts_input_gilfoyle.md #23'
    - AmperaBattery/docs/COMPONENTS.md
    verified: 'no'
    open_questions: []
    diagram_ids:
    - wiring:overview/low
    - wiring:kelly/nc
    - wiring:kelly/coil
    - schem:low
    pinmap_refs:
    - S20
    - K03
    superseded_by: null
    owned: 'no'
    cost: null
  hbridge_alt:
    category: body
    name: H-bridge alternative
    maker: ST
    model: VNH5019
    qty: 0
    status: alternative only
    tier: LATER
    specs:
    - If BTS7960 3.3 V logic fails
    source:
    - 'teryx/parts_input_gilfoyle.md #21'
    verified: 'no'
    open_questions: []
    diagram_ids: []
    pinmap_refs: []
    superseded_by: null
    owned: 'no'
    cost: null
  perfboard_kit:
    category: lv
    name: Perfboard/bulkhead parts
    maker: various
    model: SMBJ18A TVS; JST-XH; DT04/DT06; 120 Ω; 100 uF; 10k/18k 1%; 100 nF; 90x150 perfboard; 100 Ω/10k gate R; 1N4007; inline holders + 1 A fuses; panel micro-USB; M3 standoffs
    qty: 1
    status: to-buy
    tier: CRITICAL
    specs:
    - open checklist
    source:
    - 'teryx/parts_input_gilfoyle.md #18'
    - teryx/perfboard/BOM.md
    verified: 'no'
    open_questions: []
    diagram_ids:
    - board:bms_master/R4
    - board:bms_master/R6
    - board:bms_master/R5
    - board:bms_master/CD1
    - board:bms_master/CD2
    - board:bms_master/CD3
    - board:bms_master/CD4
    - board:bms_master/RA14T
    - board:bms_master/RA14B
    - board:bms_master/CA14
    - board:bms_master/RA15T
    - board:bms_master/RA15B
    - board:bms_master/CA15
    - board:bms_master/RA25T
    - board:bms_master/RA25B
    - board:bms_master/CA25
    - board:bms_master/RA40T
    - board:bms_master/RA40B
    - board:bms_master/CA40
    - board:bms_master/RB14T
    - board:bms_master/RB14B
    - board:bms_master/CB14
    - board:bms_master/RB15T
    - board:bms_master/RB15B
    - board:bms_master/CB15
    - board:bms_master/RB25T
    - board:bms_master/RB25B
    - board:bms_master/CB25
    - board:bms_master/RB41T
    - board:bms_master/RB41B
    - board:bms_master/CB41
    - board:bms_master/RD1
    - board:bms_master/RR1
    - board:bms_master/RR2
    - board:bms_master/RL1
    - board:bms_master/RUA
    - board:bms_master/RUB
    - board:bms_master/CUA
    - board:bms_master/CUB
    - board:bms_master/CD5
    - board:bms_master/RRA
    - board:bms_master/RRB
    - board:bms_master/CRA
    - board:bms_master/CRB
    - board:bms_master/RRST
    - board:bms_master/CD6
    pinmap_refs: []
    superseded_by: null
    owned: 'no'
    cost: null
  tvs:
    category: lv
    name: TVS diode
    maker: UNKNOWN
    model: SMBJ18A
    qty: 3
    status: to-buy
    specs:
    - 12 V rail protection
    source:
    - teryx/perfboard/BOM.md
    - 'teryx/parts_input_gilfoyle.md #18'
    verified: 'no'
    open_questions: []
    diagram_ids: []
    pinmap_refs: []
    superseded_by: null
    owned: 'no'
    cost: null
    tier: null
  x_tdc_iy:
    category: superseded
    name: DC-DC (stale model)
    maker: Elcon
    model: TDC-IY
    qty: 0
    status: superseded
    specs:
    - Label read 10/15 says TDC-JH-144-12
    source:
    - teryx/teryx-shop-log.md:236
    - teryx/cash_parts_full.yaml
    verified: 'yes'
    open_questions: []
    diagram_ids: []
    pinmap_refs: []
    superseded_by: dcdc
    owned: 'no'
    cost: null
    tier: null
  can_term:
    category: bms
    name: CAN terminators
    maker: UNKNOWN
    model: 120 Ω 1/4 W
    qty: 5
    status: to-buy
    tier: CRITICAL
    specs:
    - ''
    source:
    - teryx/cash_parts_full.yaml
    verified: 'no'
    open_questions:
    - Final count
    diagram_ids:
    - board:bms_master/RT1
    - board:bms_master/RT2
    - board:bms_master/RT5
    - board:bms_master/RT3
    - board:bms_master/RT4
    pinmap_refs:
    - C05
    - C06
    - C10
    superseded_by: null
    owned: 'no'
    cost: null
  key_opto:
    category: controls
    name: Key-on optocoupler
    maker: Sharp
    model: PC827 (PROPOSED)
    qty: 1
    status: to-buy
    tier: CRITICAL
    specs:
    - 2-ch, 1k5 LED resistor
    source:
    - teryx/cash_parts_full.yaml
    - PINMAP S42/S43
    verified: 'no'
    open_questions: []
    diagram_ids: []
    pinmap_refs:
    - S42
    - S43
    superseded_by: null
    owned: 'no'
    cost: null
  zener_5v:
    category: lv
    name: 5 V rail zener clamp
    maker: UNKNOWN
    model: 1N5339B
    qty: 1
    status: to-buy
    specs:
    - ''
    source:
    - teryx/cash_parts_full.yaml
    verified: 'no'
    open_questions: []
    diagram_ids:
    - wiring:power12/z
    - schem:z
    - board:bms_master/Z1
    pinmap_refs:
    - P09
    - TB-5V
    superseded_by: null
    owned: 'no'
    cost: null
    tier: null
  usb_ext:
    category: lv
    name: Panel-mount USB extension
    maker: UNKNOWN
    model: UNKNOWN
    qty: 2
    status: to-buy
    specs:
    - ''
    source:
    - teryx/cash_parts_full.yaml
    verified: 'no'
    open_questions: []
    diagram_ids: []
    pinmap_refs: []
    superseded_by: null
    owned: 'no'
    cost: null
    tier: null
  ebox_enclosure:
    category: lv
    name: Electronics enclosure
    maker: UNKNOWN
    model: UNKNOWN
    qty: 1
    status: to-buy
    tier: CRITICAL
    specs:
    - ''
    source:
    - teryx/cash_parts_full.yaml
    verified: 'no'
    open_questions: []
    diagram_ids: []
    pinmap_refs: []
    superseded_by: null
    owned: 'no'
    cost: null
  estop_guard:
    category: safety
    name: E-stop guard ring
    maker: Schneider Electric
    model: ZBZ1604
    qty: 1
    status: LATER
    tier: LATER
    specs:
    - ~£48.48
    source:
    - teryx/cash_parts_full.yaml
    - cash-spend/teryx-first-drive-buys.md
    verified: 'no'
    open_questions: []
    diagram_ids: []
    pinmap_refs: []
    superseded_by: null
    owned: 'no'
    cost: null
  iso_monitor:
    category: safety
    name: Isolation monitor (on-board)
    maker: UNKNOWN
    model: UNKNOWN (not chosen)
    qty: 1
    status: LATER
    tier: LATER
    specs:
    - ''
    source:
    - teryx/cash_parts_full.yaml
    verified: 'no'
    open_questions: []
    diagram_ids: []
    pinmap_refs: []
    superseded_by: null
    owned: 'no'
    cost: null
  lugs_1_0:
    category: hv
    name: 1/0 lugs + hydraulic crimper
    maker: UNKNOWN
    model: UNKNOWN
    qty: 1
    status: to-buy
    tier: CRITICAL
    specs:
    - ''
    source:
    - teryx/cash_parts_full.yaml
    - AmperaBattery/docs/TIERS.md
    verified: 'no'
    open_questions: []
    diagram_ids: []
    pinmap_refs: []
    superseded_by: null
    owned: 'no'
    cost: null
  ac_breaker:
    category: charging
    name: AC 2-pole breaker
    maker: UNKNOWN
    model: UNKNOWN
    qty: 1
    status: LATER (PROPOSED)
    tier: LATER
    specs:
    - ''
    source:
    - teryx/cash_parts_full.yaml
    - teryx/parts_input_sparky.md
    verified: 'no'
    open_questions: []
    diagram_ids: []
    pinmap_refs: []
    superseded_by: null
    owned: 'no'
    cost: null
  park_actuator:
    category: body
    name: Electric park-brake actuator
    maker: Glideforce
    model: LACT4P-12V-20 (PROPOSED)
    qty: 1
    status: LATER
    tier: LATER
    specs:
    - 110 lb; needs 3rd BTS7960
    source:
    - teryx/cash_parts_full.yaml
    - teryx/parts_input_sparky.md
    verified: 'no'
    open_questions: []
    diagram_ids: []
    pinmap_refs: []
    superseded_by: null
    owned: 'no'
    cost: null
  lights:
    category: body
    name: Lights + relays
    maker: UNKNOWN
    model: UNKNOWN
    qty: 1
    status: LATER
    tier: LATER
    specs:
    - head lo/hi, tail, brake, turn, reverse, bar, work
    source:
    - teryx/cash_parts_full.yaml
    verified: 'no'
    open_questions: []
    diagram_ids: []
    pinmap_refs: []
    superseded_by: null
    owned: 'no'
    cost: null
  rad_fan_relay:
    category: cooling
    name: Radiator fan relay + 15 A fuse
    maker: UNKNOWN
    model: UNKNOWN
    qty: 1
    status: LATER
    tier: LATER
    specs:
    - stock fan reused
    source:
    - teryx/cash_parts_full.yaml
    verified: 'no'
    open_questions: []
    diagram_ids: []
    pinmap_refs: []
    superseded_by: null
    owned: 'no'
    cost: null
  motor_fan:
    category: cooling
    name: Motor cooling fan
    maker: UNKNOWN
    model: UNKNOWN
    qty: 1
    status: LATER
    tier: LATER
    specs:
    - MCP23017 bit 14 via FET + relay
    source:
    - teryx/cash_parts_full.yaml
    verified: 'no'
    open_questions: []
    diagram_ids:
    - wiring:power12/mfan
    - schem:lfan
    pinmap_refs: []
    superseded_by: null
    owned: 'no'
    cost: null
  iso_audio:
    category: body
    name: Ground-loop isolator
    maker: UNKNOWN
    model: UNKNOWN
    qty: 1
    status: LATER
    tier: LATER
    specs:
    - $10.00
    source:
    - teryx/cash_parts_full.yaml
    verified: 'no'
    open_questions: []
    diagram_ids: []
    pinmap_refs: []
    superseded_by: null
    owned: 'no'
    cost: $10.00
  bt_key:
    category: controls
    name: Bluetooth phone key
    maker: Walfront
    model: Walfront BT proximity relay (or spare ESP32)
    qty: 1
    status: LATER
    tier: LATER
    specs:
    - $17.16
    source:
    - teryx/cash_parts_full.yaml
    - cash-spend/teryx-first-drive-buys.md
    verified: 'no'
    open_questions: []
    diagram_ids: []
    pinmap_refs: []
    superseded_by: null
    owned: 'no'
    cost: $17.16
  x_misc_dropped:
    category: superseded
    name: Other dropped/never-owned
    maker: various
    model: Bussmann T30200-1C; Littelfuse JLLS150/JLLN200; IRLZ44N; Hella UP28 vac pump; Carlinkit CPC200-CCPA; Brusa NLG5x1; Eltek; SK Pang triple-CAN carrier
    qty: 0
    status: dropped
    specs:
    - ''
    source:
    - teryx/cash_parts_full.yaml
    verified: 'yes'
    open_questions: []
    diagram_ids: []
    pinmap_refs: []
    superseded_by: null
    owned: 'no'
    cost: null
    tier: null
  aux_button:
    category: body
    name: Aux push button (horn / lights), normally open
    maker: Schneider Electric
    model: ZBE101 (1 NO contact block; operator/head model not named)
    qty: 1
    status: LATER (PROPOSED)
    tier: LATER
    specs:
    - NO contact switches only the relay coil (86); small fuse 2 A PROPOSED
    - Qty per aux load not fixed (horn, lights)
    source:
    - AmperaBattery/docs/PINMAP.yaml:284 (A02 'NO push button (ZBE101) -> relay 86')
    - AmperaBattery/tools/wiring_data.js:154 (aux/btn)
    - AmperaBattery/tools/schematic/gen.py:56 (auxb)
    - Adam 2026-10-22
    verified: 'no'
    open_questions:
    - Button head/operator model and how many buttons (horn, lights)
    diagram_ids:
    - wiring:aux/btn
    - schem:auxb
    pinmap_refs:
    - A02
    superseded_by: null
    owned: 'no'
    cost: null
  aux_relay:
    category: body
    name: Aux load relay
    maker: UNKNOWN
    model: UNVERIFIED (12 V automotive relay 30/87/85/86, part not chosen)
    qty: 1
    status: LATER (PROPOSED)
    tier: LATER
    specs:
    - Coil 85/86 switched by aux button; load via 30/87 through F-AUX (PROPOSED 10-15 A, size to load)
    source:
    - AmperaBattery/docs/PINMAP.yaml:183,283-286 (F-AUX, A01-A04)
    - AmperaBattery/tools/wiring_data.js:154 (aux/rly)
    - AmperaBattery/tools/schematic/gen.py:56 (rly)
    - Adam 2026-10-22
    verified: 'no'
    open_questions:
    - Relay model/rating once loads are chosen
    diagram_ids:
    - wiring:aux/rly
    - schem:rly
    pinmap_refs:
    - A01
    - A02
    - A03
    - A04
    - F-AUX
    superseded_by: null
    owned: 'no'
    cost: null
  fuse_main:
    category: lv
    name: 'Main 12 V fuse F-MAIN (DC-DC out, bus end: P01 -> F-MAIN -> P02)'
    maker: UNKNOWN
    model: 150 A MIDI/MEGA bolt-down fuse (exact P/N + holder not chosen)
    qty: 1
    status: to-buy
    tier: CRITICAL
    specs:
    - 150 A MIDI/MEGA bolt-down (DECIDED Sparky 07:34; TDC-JH-144-12 = 110 A out, SOURCED)
    - At the DC-DC 12 V output, bus end, as drawn (DECIDED Sparky 07:34)
    - P01 + P02 = 2 AWG 105 °C copper (DECIDED Sparky 07:34); P01 run under 5 ft (DECIDED)
    source:
    - Sparky 2026-10-23
    - crew decision 2026-10-23
    - Sparky 2026-10-23 07:34 CT (DECIDED)
    verified: 'no'
    open_questions:
    - Fuse P/N and holder (TBD)
    diagram_ids:
    - wiring:power12/fm
    - schem:fmain
    - pinmap:fuse/F-MAIN
    pinmap_refs:
    - F-MAIN
    - P01
    - P02
    superseded_by: null
    owned: 'no'
    cost: null
  coil_driver:
    category: controls
    name: 'Contactor coil-driver board (3 ch low-side: Q-B+ Main+, Q-PRE precharge, Q-B− Main−)'
    maker: self-built
    model: Perfboard build (PROPOSED; PCBWay 2-layer only after the circuit is proven, per Sparky)
    qty: 1
    status: to-build (PROPOSED)
    tier: CRITICAL
    specs:
    - 'ASSEMBLY. Children: cd_fet ×3, cd_rgate ×3, cd_rpull ×3, cd_flyback ×1, cd_board ×1, cd_term ×1'
    - Q-B+ <- Teensy A:11 (S01) -> EV200 B+ coil −; Q-PRE <- A:12 (S02) -> AEV14012 coil −; Q-B− <- A:21 (S03) -> EV200 B− coil − (SOURCED PINMAP)
    - 'LOW SIDE ONLY (DECIDED room 2026-10-23 06:11, Sparky + chief): the board switches coil − to ground only; coil + is fed off-board from F-COIL (10 A PROPOSED) through the e-stop NC blocks (E01-E03);
      no 12 V on the board (J-12V deleted)'
    - 'Grounding (DECIDED room 06:11): FET sources + pull-downs + Teensy signal ground (J-SIG.1, in the gate cable) meet at ONE star hole V22; the only other ground lead is the coil return: doubled 20 AWG
      solid bus on board -> J-GND.2 5.08 mm screw terminal rated ≥10 A -> TB-GND 16 AWG (G08; DECIDED Sparky 06:57 #5); no Teensy GND wire at TB-GND (G04 dropped)'
    - 'Loads: AEV14012 0.35 A @12 V / ~0.41 A @14 V, not economized (SOURCED Panasonic via Sparky); EV200HAANA 3.8 A inrush max 130 ms, 0.13 A hold @12 V (SOURCED TE datasheet)'
    - Replaces Q1-Q3 (MAIN+/MAIN−/PRECHG) of the perfboard/BOM.md outputs daughterboard; Q4-Q6 stay on coil_fet
    - 'Install: guided_install/coil_driver.md (draft, after Build 18)'
    source:
    - Adam 2026-10-23 05:37 (coil-driver board request)
    - 'AmperaBattery/docs/PINMAP.yaml:234-236 (S01-S03: Teensy A:11/12/21 via 100 Ω, 10k pull-down, FET drain -> coil −, fuse F-COIL)'
    - AmperaBattery/docs/PINMAP.yaml:177 (F-COIL 10 A PROPOSED, Sparky 2026-10-22)
    - Sparky chat 2026-10-23 05:31/05:35/05:36 CDT (coil FET, perfboard, PCBWay answers to Adam)
    - teryx/perfboard/BOM.md
    verified: 'no'
    open_questions:
    - Board size/layout not fixed (perfboard first; PCBWay later per Sparky 05:36)
    children:
    - id: cd_fet
      qty: 3
      refdes: Q-B+, Q-PRE, Q-B−
    - id: cd_rgate
      qty: 3
      refdes: RG-B+, RG-PRE, RG-B−
    - id: cd_rpull
      qty: 3
      refdes: RP-B+, RP-PRE, RP-B−
    - id: cd_flyback
      qty: 1
      refdes: D-PRE (at the AEV14012 coil)
    - id: cd_board
      qty: 1
      refdes: board
    - id: cd_term
      qty: 1
      refdes: I/O terminals
    diagram_ids:
    - wiring:precharge/drv
    - schem:drv
    pinmap_refs:
    - S01
    - S02
    - S03
    - F-COIL
    - E01
    - E02
    - E03
    - G08
    superseded_by: null
    owned: 'no'
    cost: null
  cd_fet:
    category: controls
    name: Coil-driver N-FETs (TO-220, G-D-S)
    maker: Infineon
    model: IRLB8721PbF
    qty: 3
    status: UNVERIFIED (asked Adam if on hand) — to-buy if not
    tier: CRITICAL
    specs:
    - Q-B+ = Teensy A:11 (S01) -> EV200 B+ coil −
    - Q-PRE = Teensy A:12 (S02) -> AEV14012 coil −
    - Q-B− = Teensy A:21 (S03) -> EV200 B− coil −
    - RDS(on) is only rated at VGS ≥ 4.5 V; 3.3 V gate drive must be bench-checked (coil pulls in fully from the Teensy pin) — Sparky 05:31
    - No heatsink needed at these currents (Sparky 05:35)
    source:
    - 'AmperaBattery/docs/PINMAP.yaml:234-236 (S01-S03: Teensy A:11/12/21 via 100 Ω, 10k pull-down, FET drain -> coil −, fuse F-COIL)'
    - Sparky chat 2026-10-23 05:31 CDT ('use the IRLB8721s Adam already owns')
    - teryx/perfboard/BOM.md
    verified: 'no'
    open_questions:
    - 'How many IRLB8721 does Adam actually have? (coil_fet CONFLICT: cash lists IRLB3813PBF to-buy, 8721 discontinued)'
    parent: coil_driver
    diagram_ids:
    - cutsheet:irlb8721
    - board:coil_driver/Q-B+
    - board:coil_driver/Q-PRE
    - board:coil_driver/Q-B−
    pinmap_refs:
    - S01
    - S02
    - S03
    superseded_by: null
    owned: 'no'
    cost: null
  cd_rgate:
    category: controls
    name: Coil-driver gate series resistors
    maker: UNKNOWN
    model: 100 Ω through-hole (power rating not in sources; 1/4 W PROPOSED)
    qty: 3
    status: to-buy (or from perfboard_kit stock)
    tier: CRITICAL
    specs:
    - 'One per gate: Teensy pin -> 100 Ω -> FET gate (S01-S03)'
    source:
    - 'AmperaBattery/docs/PINMAP.yaml:234-236 (S01-S03: Teensy A:11/12/21 via 100 Ω, 10k pull-down, FET drain -> coil −, fuse F-COIL)'
    - Sparky chat 2026-10-23 05:31/05:35/05:36 CDT (coil FET, perfboard, PCBWay answers to Adam)
    - teryx/perfboard/BOM.md
    verified: 'yes'
    open_questions: []
    parent: coil_driver
    diagram_ids:
    - board:coil_driver/RG-B+
    - board:coil_driver/RG-PRE
    - board:coil_driver/RG-B−
    pinmap_refs:
    - S01
    - S02
    - S03
    superseded_by: null
    owned: 'no'
    cost: null
  cd_rpull:
    category: controls
    name: Coil-driver gate pull-down resistors
    maker: UNKNOWN
    model: 10 kΩ through-hole (power rating not in sources; 1/4 W PROPOSED)
    qty: 3
    status: to-buy (or from perfboard_kit stock)
    tier: CRITICAL
    specs:
    - 'One per FET, gate to source/GND: keeps the FET off while the Teensy boots (check: gate-GND ≈10 kΩ, chief review #10)'
    source:
    - 'AmperaBattery/docs/PINMAP.yaml:234-236 (S01-S03: Teensy A:11/12/21 via 100 Ω, 10k pull-down, FET drain -> coil −, fuse F-COIL)'
    - Sparky chat 2026-10-23 05:31/05:35/05:36 CDT (coil FET, perfboard, PCBWay answers to Adam)
    - teryx/perfboard/BOM.md
    verified: 'yes'
    open_questions: []
    parent: coil_driver
    diagram_ids:
    - board:coil_driver/RP-B+
    - board:coil_driver/RP-PRE
    - board:coil_driver/RP-B−
    pinmap_refs:
    - S01
    - S02
    - S03
    superseded_by: null
    owned: 'no'
    cost: null
  cd_flyback:
    category: controls
    name: Coil flyback diode — AEV14012 precharge coil only, mounted AT THE COIL
    maker: UNKNOWN
    model: 1N4007 (plain, no zener) — DECIDED
    qty: 1
    status: to-buy (DECIDED)
    tier: CRITICAL
    specs:
    - 'DECIDED (Sparky 2026-10-23 05:41 CT, confirmed room 06:11): plain 1N4007 directly across the AEV14012 coil terminals, cathode (band) to coil +, anode to coil − / Q-PRE drain; no zener'
    - Mounted at the coil, not on the driver board
    - 'Why no zener: IRLB8721 is only rated 30 V; the slower release is fine because Main+ carries the current and the 50 Ω precharge resistor limits a fault to ≈3 A (Sparky 05:41)'
    - 'EV200 B+ / B− coils: NO external diode — TE datasheet built-in economizer ''limits back EMF to 0V'' (DECIDED Sparky 05:41; perfboard/BOM.md:36,54 agrees)'
    source:
    - Sparky decision 2026-10-23 05:41 CT (flyback DECIDED)
    - teryx/perfboard/BOM.md:36,54 (D3 1N4007 PRECHG only)
    - 'TE KILOVAC EV200 datasheet (eveurope.eu/wp-content/uploads/2024/03/EV200HAANA_TE.pdf): ''Built-in coil economizer … limits back EMF to 0V''; inrush 3.8 A max / 130 ms, hold 0.13 A @12 V'
    verified: 'no'
    open_questions: []
    parent: coil_driver
    diagram_ids:
    - wiring:precharge/cpre
    - schem:drv
    - board:coil_driver/D-PRE
    pinmap_refs:
    - S02
    - E03
    superseded_by: null
    owned: 'no'
    cost: null
  cd_board:
    category: controls
    name: Coil-driver board stock
    maker: UNKNOWN
    model: Plated-through, double-sided perfboard (size not chosen) — Sparky 05:35
    qty: 1
    status: to-buy (PROPOSED)
    tier: CRITICAL
    specs:
    - Coil-current paths (coil −, FET, ground return) in solid-core 18-20 AWG or solder-filled trace, not thin jumper wire
    - 'Low side only (DECIDED room 06:11): all FET sources to one star hole; coil return (doubled 20 AWG on board, J-GND.2 5.08 mm ≥10 A screw terminal, 16 AWG G08 to TB-GND; Sparky 06:57 #5) is the only
      ground lead besides the Teensy signal ground J-SIG.1 (G04 dropped)'
    - Standoffs in a sealed box; conformal coat or hot glue on heavy parts after the bench test
    - 'Alternative: PCBWay/JLCPCB 2-layer ≤100×100 mm, ~$5 for 5 + ~$15-30 DHL, ~$20-40 all-in, 1-2 weeks (Sparky typical figures, no live quote); ≥1 mm traces, 1 oz Cu, back ground pour, through-hole only'
    source:
    - Sparky chat 2026-10-23 05:31/05:35/05:36 CDT (coil FET, perfboard, PCBWay answers to Adam)
    verified: partial (guidance only)
    open_questions:
    - Board size and enclosure (shares ebox_enclosure?)
    parent: coil_driver
    diagram_ids:
    - board:coil_driver
    pinmap_refs: []
    superseded_by: null
    owned: 'no'
    cost: null
  cd_term:
    category: controls
    name: Coil-driver off-board terminals + strain relief
    maker: UNKNOWN
    model: UNKNOWN (screw terminals or locking JST, Sparky 05:35)
    qty: 1
    status: to-buy (PROPOSED)
    tier: CRITICAL
    specs:
    - 'Low side only (DECIDED room 06:11): J-SIG 4 pos (signal GND + 3 gates from Teensy A, S01-S03); 3 coil − outputs; J-GND coil return = 5.08 mm screw terminal rated ≥10 A taking 16 AWG to TB-GND (G08,
      DECIDED Sparky 06:57 #5; model UNVERIFIED); no 12 V terminal (J-12V deleted)'
    - Leads tied down; never a bare solder joint holding a wire (Sparky 05:35)
    source:
    - Sparky chat 2026-10-23 05:31/05:35/05:36 CDT (coil FET, perfboard, PCBWay answers to Adam)
    - 'AmperaBattery/docs/PINMAP.yaml:234-236 (S01-S03: Teensy A:11/12/21 via 100 Ω, 10k pull-down, FET drain -> coil −, fuse F-COIL)'
    verified: 'no'
    open_questions:
    - Terminal type/count once layout is fixed
    parent: coil_driver
    diagram_ids:
    - board:coil_driver/J-B+
    - board:coil_driver/J-PRE
    - board:coil_driver/J-B−
    - board:coil_driver/J-SIG
    - board:coil_driver/J-GND
    pinmap_refs:
    - S01
    - S02
    - S03
    - G08
    superseded_by: null
    owned: 'no'
    cost: null
  lv_tb:
    category: lv
    name: LV distribution terminal blocks — 5 V rail (TB-5V) + single-point GND (TB-GND)
    maker: UNKNOWN
    model: UNKNOWN (type/position count not chosen; barrier or DIN terminal block PROPOSED)
    qty: 2
    status: UNVERIFIED (not on any cash ledger; may be in perfboard_kit stock)
    tier: CRITICAL
    specs:
    - 'TB-5V: Teensy A VIN, Teensy B VIN, LEM 5 V, pedal 5 V, clamp chips (SOURCED docs/PINMAP.yaml TB-5V; fed from buck_drok via F-BUCK)'
    - 'TB-GND: single-point ground for all LV grounds (SOURCED docs/PINMAP.yaml TB-GND; tools/schematic/gen.py ''gnd'')'
    - 'TB-GND = LV STAR: G03 (bms_master J-PWR.2, the ONE board link), G07, G08 (coil_driver return) — DECIDED chief 06:57 #5'
    - Position count = rows in PINMAP TB-5V/TB-GND plus spares (PROPOSED)
    source:
    - AmperaBattery/docs/PINMAP.yaml connectors TB-5V / TB-GND
    - tools/schematic/gen.py N['gnd']
    verified: 'no'
    open_questions:
    - Which terminal block, how many positions, already on hand?
    diagram_ids:
    - schem:gnd
    - pinmap:connector/TB-5V
    - pinmap:connector/TB-GND
    pinmap_refs:
    - TB-5V
    - TB-GND
    - G03
    - G07
    - G08
    superseded_by: null
    owned: 'no'
    cost: null
  bms_master:
    category: controls
    name: BMS master board (Teensy A + B, 6× SN65HVD230, 5 V buck, LEM/pedal dividers, throttle clamp, LM339 plug/release detect, MCP23017 footprint LATER)
    maker: self-built
    model: Perfboard build (PROPOSED)
    qty: 1
    status: to-build (PROPOSED)
    tier: CRITICAL
    specs:
    - 'ASSEMBLY. Children (new parts): bm_board ×1, bm_term ×13, bm_hdr ×2, bm_res ×11, bm_cap ×3; uses existing parts: teensy, sn65, buck_drok, lv_fuses, zener_5v, can_term, oneshot, analog_switch, digipot,
      buffer, lm339, io_expander, clr_diode, perfboard_kit'
    - Every pin and net from docs/PINMAP.yaml (wire ids in each net desc) + docs/THROTTLE_CLAMP.md (SOURCED); layout PROPOSED
    - One signal-ground star bar; each ground group joins it once (S49 single-point ground, same rule as coil_driver V22)
    - ESP32 is off-board (J-ESP terminal); coil_driver is a separate board (J-DRV -> J-SIG, S01-S03)
    - 'Build 24 (bms_master_answers.md (chief + Sparky 2026-10-23 06:57 CT, DECIDED)): LM339 ch1-4 -> A:33/B:33/A:2/B:35; release outputs via 1k + own 10k pull-up + 100 nF (S51/S52, ref S53); J-REL removed;
      MCP23017 U6 footprint only; LEM A/B, pedal, Kelly RTN each own star hole (G09-G12); J-PWR.2 the ONE link to TB-GND (G03)'
    source:
    - Adam 2026-10-23 06:11 (BMS master board task)
    - AmperaBattery/docs/boards/bms_master.layout.json (PROPOSED, Gilfoyle Build 21; tools/boards/gen_bms_master.py)
    - AmperaBattery/docs/PINMAP.yaml
    - AmperaBattery/docs/THROTTLE_CLAMP.md
    - bms_master_answers.md (chief + Sparky 2026-10-23 06:57 CT, DECIDED)
    verified: 'no'
    open_questions:
    - 'SN65 modules: wire by SILKSCREEN (pin order varies by vendor); keep R2 ''121'' only at a physical bus end; CANH-CANL ≈60 Ω powered off (DECIDED Sparky 06:57 #2)'
    - Firmware must set A:2 INPUT (boots as output); plug/release not read yet — later commit, no flashing
    children:
    - id: bm_board
      qty: 1
      refdes: board
    - id: bm_term
      qty: 13
      refdes: J-PWR, J-S1..J-S4, J-CANV, J-DRV, J-ESP, J-PROX, J-KEL, J-THR, J-LEMA, J-LEMB
    - id: bm_hdr
      qty: 2
      refdes: J-BODYA, J-BODYB
    - id: bm_res
      qty: 11
      refdes: R1, RX1, RX2, RP1, RP2, RD2, RL2, RSA, RSB, RSDA, RSCL
    - id: bm_cap
      qty: 3
      refdes: C5, CX1, CX2
    uses:
    - teensy
    - sn65
    - buck_drok
    - lv_fuses
    - zener_5v
    - can_term
    - oneshot
    - analog_switch
    - digipot
    - buffer
    - lm339
    - io_expander
    - clr_diode
    - perfboard_kit
    diagram_ids: []
    pinmap_refs:
    - C01
    - C02
    - C03
    - C04
    - C05
    - C06
    - C10
    - C11
    - C12
    - C13
    - C14
    - P07
    - P08
    - P09
    - P10
    - P11
    - P12
    - S05
    - S06
    - S07
    - S10
    - S11
    - S12
    - S14
    - S15
    - S25
    - S26
    - S27
    - S30
    - S41
    - S44
    - S45
    - S46
    - S47
    - S48
    - S49
    - S51
    - S52
    - S53
    - G03
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
    superseded_by: null
    owned: 'no'
    cost: null
  bm_board:
    category: controls
    name: BMS master board stock
    maker: UNKNOWN
    model: UNKNOWN (plated-through double-sided perfboard, 0.1 in; size from the layout notes)
    qty: 1
    status: UNVERIFIED (to-buy, PROPOSED)
    tier: CRITICAL
    specs:
    - 'Size: see docs/boards/bms_master.layout.json notes (fit to parts + 2-hole margin)'
    - M3 mounts at the four corners (PROPOSED)
    source:
    - AmperaBattery/docs/boards/bms_master.layout.json (PROPOSED, Gilfoyle Build 21; tools/boards/gen_bms_master.py)
    verified: 'no'
    open_questions:
    - Board stock model / whether perfboard_kit's 90x150 board is big enough
    parent: bms_master
    diagram_ids:
    - board:bms_master
    pinmap_refs: []
    superseded_by: null
    owned: 'no'
    cost: null
  bm_term:
    category: controls
    name: BMS master screw terminals, 5.08 mm pitch (2/3/4 pos)
    maker: UNKNOWN
    model: UNKNOWN (5.08 mm PCB screw terminal blocks)
    qty: 13
    status: UNVERIFIED (to-buy, PROPOSED)
    tier: CRITICAL
    specs:
    - 2-pos ×4 (J-PWR, J-CANV, J-PROX, J-KEL; J-REL removed Build 24), 3-pos ×5 (J-S1..J-S4, J-ESP), 4-pos ×4 (J-DRV, J-THR, J-LEMA, J-LEMB) — count from the layout
    source:
    - AmperaBattery/docs/boards/bms_master.layout.json (PROPOSED, Gilfoyle Build 21; tools/boards/gen_bms_master.py)
    verified: 'no'
    open_questions:
    - Terminal model; wire range must take 16-22 AWG
    parent: bms_master
    diagram_ids:
    - board:bms_master/J-PWR
    - board:bms_master/J-S2
    - board:bms_master/J-S1
    - board:bms_master/J-S3
    - board:bms_master/J-S4
    - board:bms_master/J-CANV
    - board:bms_master/J-DRV
    - board:bms_master/J-ESP
    - board:bms_master/J-PROX
    - board:bms_master/J-KEL
    - board:bms_master/J-THR
    - board:bms_master/J-LEMA
    - board:bms_master/J-LEMB
    pinmap_refs:
    - C11
    - C12
    - C13
    - C14
    - C10
    - S01
    - S02
    - S03
    - S30
    - K01
    - G09
    - G10
    - G11
    - G12
    superseded_by: null
    owned: 'no'
    cost: null
  bm_hdr:
    category: controls
    name: BMS master body I/O pin headers 1×8, 2.54 mm
    maker: UNKNOWN
    model: UNKNOWN (1×8 male header, 2.54 mm)
    qty: 2
    status: UNVERIFIED (to-buy, PROPOSED)
    tier: LATER
    specs:
    - J-BODYA = MCP23017 GPA0-7, J-BODYB = GPB0-7 (expander block in PINMAP)
    source:
    - AmperaBattery/docs/boards/bms_master.layout.json (PROPOSED, Gilfoyle Build 21; tools/boards/gen_bms_master.py)
    verified: 'no'
    open_questions: []
    parent: bms_master
    diagram_ids:
    - board:bms_master/J-BODYB
    - board:bms_master/J-BODYA
    pinmap_refs: []
    superseded_by: null
    owned: 'no'
    cost: null
  bm_res:
    category: controls
    name: BMS master resistors not in perfboard_kit (100k ×3, 330 Ω, 2.7k, 20k, 3.9k, 1k ×2, 4.7k ×2)
    maker: UNKNOWN
    model: UNKNOWN (1/4 W through-hole; 1 % metal film PROPOSED)
    qty: 11
    status: UNVERIFIED (to-buy, PROPOSED)
    tier: CRITICAL
    specs:
    - 'R1 100k (KELLY_THR to GND), RX1/RX2 100k 1% (one-shot timing), RP1 330 Ω / RP2 2.7k (PROX, S45), RD2 20k (PROX divider, S46), RL2 3.9k (release ref 1.40 V, S53 DECIDED Sparky 06:57 #1), RSA/RSB 1k
      (release series to A:2/B:35, S51/S52), RSDA/RSCL 4.7k (I2C, DECIDED chief 06:57 #3; LATER)'
    - 10k pull-ups RRA/RRB/RRST and 100 nF CRA/CRB come from perfboard_kit
    source:
    - AmperaBattery/docs/boards/bms_master.layout.json (PROPOSED, Gilfoyle Build 21; tools/boards/gen_bms_master.py)
    - AmperaBattery/docs/THROTTLE_CLAMP.md
    - AmperaBattery/docs/PINMAP.yaml S45/S46
    verified: 'no'
    open_questions: []
    parent: bms_master
    diagram_ids:
    - board:bms_master/R1
    - board:bms_master/RX1
    - board:bms_master/RX2
    - board:bms_master/RP1
    - board:bms_master/RP2
    - board:bms_master/RD2
    - board:bms_master/RL2
    - board:bms_master/RSA
    - board:bms_master/RSB
    - board:bms_master/RSDA
    - board:bms_master/RSCL
    pinmap_refs:
    - S45
    - S46
    - S51
    - S52
    - S53
    superseded_by: null
    owned: 'no'
    cost: null
  bm_cap:
    category: controls
    name: BMS master capacitors not in perfboard_kit (1 µF, 100 nF C0G/film ×2)
    maker: UNKNOWN
    model: UNKNOWN (through-hole, 5 mm lead pitch PROPOSED)
    qty: 3
    status: UNVERIFIED (to-buy, PROPOSED)
    tier: CRITICAL
    specs:
    - C5 1 µF (/CLR power-on reset), CX1/CX2 100 nF C0G or film (one-shot timing; X7R drifts)
    source:
    - AmperaBattery/docs/boards/bms_master.layout.json (PROPOSED, Gilfoyle Build 21; tools/boards/gen_bms_master.py)
    - AmperaBattery/docs/THROTTLE_CLAMP.md
    verified: 'no'
    open_questions: []
    parent: bms_master
    diagram_ids:
    - board:bms_master/C5
    - board:bms_master/CX1
    - board:bms_master/CX2
    pinmap_refs: []
    superseded_by: null
    owned: 'no'
    cost: null
  fuse_batt:
    category: lv
    name: Buffer battery fuse F-BATT (battery + post -> 12 V bus +, P13/P14)
    maker: UNKNOWN
    model: 150 A MIDI/MEGA bolt-down fuse (P/N + holder TBD)
    qty: 1
    status: to-buy (PROPOSED)
    tier: CRITICAL
    specs:
    - 150 A MIDI/MEGA (DECIDED Sparky 07:34)
    - Within 7 in of the buffer battery + post (DECIDED Sparky 07:34)
    - 'P13 battery + -> F-BATT, P14 F-BATT -> 12 V bus +: both 2 AWG (DECIDED); wire ids PROPOSED'
    source:
    - Sparky 2026-10-23 07:34 CT (DECIDED)
    - AmperaBattery/docs/PINMAP.yaml F-BATT, P13, P14
    verified: 'no'
    open_questions:
    - Fuse P/N and holder (TBD)
    diagram_ids:
    - pinmap:fuse/F-BATT
    pinmap_refs:
    - F-BATT
    - P13
    - P14
    superseded_by: null
    owned: 'no'
    cost: null
