Adampaleski/AmperaBattery/docs/PINMAP.yaml

# Teryx EV MASTER PIN MAP — single source of truth.
# Generated from this file: docs/PINMAP.md, docs/CONNECTIONS.md, checklist.html "Connections" tab,
# wire numbers on tools/wiring.html and tools/schematic/gen.py. Edit HERE, then run tools/build_pinmap.py.
# Checked against firmware by scripts/test_pinmap.py (fails on any mismatch).
#
# status: SOURCED (cite file:line or doc) | ASSUMED | PROPOSED | UNVERIFIED | UNDEFINED (no pin/part chosen yet)
# tier:   CRITICAL (needed for first drive) | LATER
# step (build order): 1 12 V + grounds · 2 Teensys · 3 CAN · 4 BICMs · 5 ESP32 gateway
#                     6 safety I/O + Kelly low voltage · 7 HV (LATER, Sparky present) · 8 body/aux (LATER)
# kind: wire (you crimp it) | board (on a perfboard/daughterboard) | factory (existing harness) | none (wireless / software line)
meta:
  repo_commit_basis: "cd7027f + Build 10 BMS settings"
  firmware_pins: include/Config.h namespace Pins (lines 157-271)
  can_map: include/FlexCanCompat.h:41-60 (CAN_LAYOUT_V2=1, default when DUAL_STRING=1)
  boards: {A: "Teensy 4.1 A, env teensy41_dual_a (TEENSY_ROLE=0) — BMS master, contactors, throttle",
           B: "Teensy 4.1 B, env teensy41_dual_b (TEENSY_ROLE=1) — watchdog, can only open/cap",
           E: "ESP32 DevKit gateway (teryx-ev-hub firmware/esp32-gateway), read-only"}

colors:   # PROPOSED colour code (not in any doc except the factory BICM harness)
  status: PROPOSED
  "+12V unswitched": RD
  "+12V switched/fused feed": RD/WH
  "12V coil feed (after e-stop)": RD/YE
  GND: BK
  "+5V": OR
  "+3V3": OR/WH
  CAN-H: YE
  CAN-L: GN
  "analog signal": BU
  "digital input": BU/BK
  "heartbeat / enable": VT
  "UART": WH
  HV+: "orange HV cable, RED tape"
  HV-: "orange HV cable, BLACK tape"
gauges:   # PROPOSED gauge scheme
  status: PROPOSED
  signal / CAN / UART: "22 AWG (CAN = twisted pair, ~1 twist per inch)"
  "5 V / 3.3 V logic power": "20 AWG"
  "12 V coil feeds, relay coils, KSI": "18 AWG"
  "12 V branch to Kelly PWR / electronics box": "16 AWG"
  "12 V main (DC-DC out)": "TBD (Sparky sizes it) — DC-DC TDC-JH-144-12 = 110 A out (SOURCED crew 2026-10-23); 10 AWG ≤30 A, 8 AWG ≤40 A, 6 AWG ≤60 A (Sparky)"
  HV: "1/0 AWG string leads from each A6T200 (~138 A at a 550 A launch); 3/0 owned TEMCo for pack-to-Kelly mains (crew 2026-10-22)"

buses:
  - {id: CAN-A1, board: A, ctrl: CAN1, tx: 22, rx: 23, bitrate: 125000, frame: 11-bit, nodes: "Teensy A + String 1 BICMs (M2 24S + M4 c1-12)", ids: "0x460-0x47E BICM reports; 0x200/0x300/0x310 keep-alive/balance (TX only if flags)", term: "120 Ω at Teensy transceiver + BICM end (BICM-end built-in UNVERIFIED: meter ~60 Ω powered off) SN65HVD230 module: wire by silkscreen (pin order varies by vendor); keep the onboard 120 Ω (usually R2 marked 121) only on the module at a physical bus end, remove it elsewhere; check powered off CANH-CANL ≈60 Ω (DECIDED Sparky 06:57 #2).", transceiver: "SN65HVD230 #1", src: "include/FlexCanCompat.h:43; include/Config.h:9; include/StringConfig.h:11-15", status: SOURCED}
  - {id: CAN-A2, board: A, ctrl: CAN2, tx: 1, rx: 0, bitrate: 125000, frame: 11-bit, nodes: "Teensy A + String 2 BICMs (M3 24S + M4)", ids: "same factory IDs as string 1 (own bus)", term: "120 Ω both ends (as CAN-A1) SN65HVD230 module: wire by silkscreen (pin order varies by vendor); keep the onboard 120 Ω (usually R2 marked 121) only on the module at a physical bus end, remove it elsewhere; check powered off CANH-CANL ≈60 Ω (DECIDED Sparky 06:57 #2).", transceiver: "SN65HVD230 #2", src: "include/FlexCanCompat.h:44", status: SOURCED}
  - {id: CAN-B1, board: B, ctrl: CAN1, tx: 22, rx: 23, bitrate: 125000, frame: 11-bit, nodes: "Teensy B + String 3 BICMs", ids: "factory IDs", term: "120 Ω both ends SN65HVD230 module: wire by silkscreen (pin order varies by vendor); keep the onboard 120 Ω (usually R2 marked 121) only on the module at a physical bus end, remove it elsewhere; check powered off CANH-CANL ≈60 Ω (DECIDED Sparky 06:57 #2).", transceiver: "SN65HVD230 #3", src: "include/FlexCanCompat.h:43", status: SOURCED}
  - {id: CAN-B2, board: B, ctrl: CAN2, tx: 1, rx: 0, bitrate: 125000, frame: 11-bit, nodes: "Teensy B + String 4 BICMs", ids: "factory IDs", term: "120 Ω both ends SN65HVD230 module: wire by silkscreen (pin order varies by vendor); keep the onboard 120 Ω (usually R2 marked 121) only on the module at a physical bus end, remove it elsewhere; check powered off CANH-CANL ≈60 Ω (DECIDED Sparky 06:57 #2).", transceiver: "SN65HVD230 #4", src: "include/FlexCanCompat.h:44", status: SOURCED}
  - {id: CAN-V, board: "A+B", ctrl: CAN3, tx: 31, rx: 30, bitrate: 250000, frame: "29-bit (Kelly/Elcon) + 11-bit (A-B link)", nodes: "Teensy A (end, 120 Ω) · Teensy B (stub, no 120 Ω) · Kelly · Elcon (far end 120 Ω, built-in UNVERIFIED)", ids: "Kelly 0x0CF11E05/0x0CF11F05 (include/KellyLink.h:4); Elcon 0x1806E5F4 / 0x18FF50E5 (Config.h:88, StringConfig.h:81); link 0x6A0-0x6A4 B->A, 0x6A8-0x6AA A->B (StringConfig.h:83-93)", term: "120 Ω at Teensy A and at the far end only SN65HVD230 module: wire by silkscreen (pin order varies by vendor); keep the onboard 120 Ω (usually R2 marked 121) only on the module at a physical bus end, remove it elsewhere; check powered off CANH-CANL ≈60 Ω (DECIDED Sparky 06:57 #2).", transceiver: "SN65HVD230 #5 (A), #6 (B) — 4 owned cover the one-string bench; 2 extra on the buy list for Gate 3 (no purchase now)", src: "include/FlexCanCompat.h:45", status: SOURCED}

# Every pin firmware names. test_pinmap.py: each 'const' must equal include/Config.h Pins::<const>,
# and every Pins:: constant must appear here. 'shares' marks an intentional reuse on the same board.
pins:
  A:
    - {pin: 0,  const: null,        use: "CAN2 RX -> SN65 #2 (string 2)", wire: C03, status: SOURCED, src: "FlexCanCompat.h:44"}
    - {pin: 1,  const: null,        use: "CAN2 TX -> SN65 #2", wire: C03, status: SOURCED, src: "FlexCanCompat.h:44"}
    - {pin: 2,  const: OUT5,        use: "RELEASE-BUTTON detect A (reuses the OUT5 spare): LM339 ch3 OUT3 (pin 14) via 1k series, own 10k pull-up to A 3.3 V + 100 nF. LOW = plugged and latched, HIGH = release pressed or unplugged. FIRMWARE MUST set A:2 to INPUT — it boots as an output (pinMode LOW, BmsApp.cpp); the 1k series limits the fight until then. Firmware change = later commit, no flashing now", wire: S51, status: PROPOSED, tier: CRITICAL, src: "Config.h:180; Sparky 2026-10-23 06:57 #1/#3 DECIDED (bms_master_answers.md)"}
    - {pin: 3,  const: OUT6,        use: "OUT6 spare output", wire: null, status: SOURCED, src: "Config.h:181"}
    - {pin: 4,  const: A_THR_ALIVE, use: "A throttle heartbeat 1 kHz -> U4 -> U1 B1", wire: S11, status: SOURCED, src: "Config.h:256"}
    - {pin: 5,  const: SEAT_DRV,    use: "seat heater driver PWM (OUT7)", wire: null, status: PROPOSED, tier: LATER, src: "Config.h:210", shares: OUT7}
    - {pin: 5,  const: OUT7,        use: "alias of SEAT_DRV", wire: null, status: SOURCED, src: "Config.h:187", shares: SEAT_DRV}
    - {pin: 6,  const: SEAT_PAS,    use: "seat heater passenger PWM (OUT8)", wire: null, status: PROPOSED, tier: LATER, src: "Config.h:211", shares: OUT8}
    - {pin: 6,  const: OUT8,        use: "alias of SEAT_PAS", wire: null, status: SOURCED, src: "Config.h:188", shares: SEAT_PAS}
    - {pin: 7,  const: RAD_FAN,     use: "radiator fan relay coil (OUT9)", wire: null, status: PROPOSED, tier: LATER, src: "Config.h:212", shares: OUT9}
    - {pin: 7,  const: OUT9,        use: "alias of RAD_FAN", wire: null, status: PROPOSED, src: "Config.h:212", shares: RAD_FAN}
    - {pin: 8,  const: COOL_PUMP,   use: "coolant pump PWM (OUT10)", wire: null, status: PROPOSED, tier: LATER, src: "Config.h:213", shares: OUT10}
    - {pin: 8,  const: OUT10,       use: "alias of COOL_PUMP", wire: null, status: PROPOSED, src: "Config.h:213", shares: COOL_PUMP}
    - {pin: 9,  const: ACT4WD_IN1,  use: "4WD actuator H-bridge IN1", wire: null, status: PROPOSED, tier: LATER, src: "Config.h:214"}
    - {pin: 10, const: ACT4WD_IN2,  use: "4WD actuator H-bridge IN2", wire: null, status: PROPOSED, tier: LATER, src: "Config.h:215"}
    - {pin: 11, const: MAIN_POS,    use: "EV200 B+ coil FET gate (OUT1)", wire: S01, status: SOURCED, src: "Config.h:193", shares: OUT1}
    - {pin: 11, const: OUT1,        use: "alias of MAIN_POS", wire: S01, status: SOURCED, src: "Config.h:174", shares: MAIN_POS}
    - {pin: 12, const: PRECHARGE,   use: "precharge relay coil FET gate (OUT2)", wire: S02, status: SOURCED, src: "Config.h:194", shares: OUT2}
    - {pin: 12, const: OUT2,        use: "alias of PRECHARGE", wire: S02, status: SOURCED, src: "Config.h:175", shares: PRECHARGE}
    - {pin: 13, const: LED,         use: "on-board LED (no wire)", wire: null, status: SOURCED, src: "Config.h:166"}
    - {pin: 14, const: CUR_LO,      use: "LEM A DHAB pin 4 (ch1 ±20 A) via 10k/18k + 100 nF", wire: S05, status: SOURCED, src: "Config.h:198"}
    - {pin: 15, const: CUR_HI,      use: "LEM A DHAB pin 3 (ch2 -420..+230 A) via 10k/18k + 100 nF", wire: S06, status: SOURCED, src: "Config.h:199"}
    - {pin: 16, const: null,        use: "Serial4 RX4 — UNCONNECTED ON PURPOSE: the gateway is receive-only (Teensy TX17 -> ESP32 GPIO16; ESP32 GPIO17 unused). Never wire anything else here.", wire: null, status: SOURCED, src: "src/HubStatus.cpp:12; GATEWAY.md:5,18"}
    - {pin: 17, const: null,        use: "Serial4 TX4 -> ESP32 GPIO16 (hub UART 115200)", wire: S30, status: SOURCED, src: "src/HubStatus.cpp:12"}
    - {pin: 18, const: I2C_SDA,     use: "MCP23017 SDA (body expander, LATER: footprint only; 4.7k pull-up to 3.3 V when fitted, chief 06:57 #3)", wire: null, status: PROPOSED, tier: LATER, src: "Config.h:245"}
    - {pin: 19, const: I2C_SCL,     use: "MCP23017 SCL (LATER: footprint only; 4.7k pull-up to 3.3 V when fitted)", wire: null, status: PROPOSED, tier: LATER, src: "Config.h:246"}
    - {pin: 20, const: OUT3,        use: "Kelly Low-cap relay FET gate: HIGH = release cap, LOW/dead = capped", wire: S20, status: SOURCED, src: "Config.h:176; docs/DRIVE_MODES.md"}
    - {pin: 21, const: MAIN_NEG,    use: "EV200 B- coil FET gate (OUT4)", wire: S03, status: SOURCED, src: "Config.h:195", shares: OUT4}
    - {pin: 21, const: OUT4,        use: "alias of MAIN_NEG", wire: S03, status: SOURCED, src: "Config.h:177", shares: MAIN_NEG}
    - {pin: 22, const: CAN1_TX,     use: "CAN1 TX -> SN65 #1 (string 1)", wire: C01, status: SOURCED, src: "Config.h:185"}
    - {pin: 23, const: CAN1_RX,     use: "CAN1 RX", wire: C01, status: SOURCED, src: "Config.h:186"}
    - {pin: 24, const: HV_SENSE,    use: "RESERVED spare (room DECIDED 2026-10-23: chief + Sparky + crew). Isolated HV_SENSE / AMC1311 DROPPED for now: precharge + weld check use Kelly CAN B+ (bus side) vs the BICM sum (pack side), see BACKLOG CRITICAL. Comes back as AMC1311EVM (~$50, Adam OK) only if the Kelly B+ bench gate fails. Never a plain 60.6:1 divider (bonds pack negative to Teensy ground/chassis). HV_ANALOG_ENABLE=0", wire: null, status: PROPOSED, tier: LATER, src: "Config.h:196; room 2026-10-23"}
    - {pin: 25, const: CUR_VC,      use: "LEM A 5 V supply sense (ratiometric) via divider", wire: S07, status: SOURCED, src: "Config.h:200"}
    - {pin: 26, const: IS_4WD,      use: "BTS7960 #1 current sense", wire: null, status: PROPOSED, tier: LATER, src: "Config.h:229"}
    - {pin: 27, const: IS_DIFF,     use: "BTS7960 #2 current sense", wire: null, status: PROPOSED, tier: LATER, src: "Config.h:230"}
    - {pin: 28, const: ACTDIF_IN1,  use: "diff-lock H-bridge IN1", wire: null, status: PROPOSED, tier: LATER, src: "Config.h:216"}
    - {pin: 29, const: ACTDIF_IN2,  use: "diff-lock H-bridge IN2", wire: null, status: PROPOSED, tier: LATER, src: "Config.h:217"}
    - {pin: 30, const: null,        use: "CAN3 RX vehicle bus -> SN65 #5", wire: C05, status: SOURCED, src: "FlexCanCompat.h:45"}
    - {pin: 31, const: null,        use: "CAN3 TX vehicle bus", wire: C05, status: SOURCED, src: "FlexCanCompat.h:45"}
    - {pin: 32, const: PARK_IN_A,   use: "park brake contact 1 (direct GPIO, 10k pull-up, LOW = set)", wire: S16, status: SOURCED, src: "Config.h:260 (BODY_IO_EXPANDER=1)"}
    - {pin: 33, const: null,        use: "CHARGE PLUG-IN detect: LM339 ch1 OUT1 (pin 2, open collector) of the ONE shared LM339 on the NACS proximity line (DECIDED re-pin chief 06:57; LM339 NOT OWNED, pending purchase approval), own 10k pull-up to A 3.3 V + 100 nF, LOW = plugged. Plugged = drive blocked on both boards (like park). Feeds BmsCore plugIn (chief #4); firmware read + 20 ms debounce = later commit", wire: S41, status: PROPOSED, tier: CRITICAL, src: "Config.h:254; chief 2026-10-23 06:57 #1 DECIDED (bms_master_answers.md)"}
    - {pin: 34, const: LIGHT_OE,    use: "spare (retired 595 /OE; nothing drives it)", wire: null, status: SOURCED, src: "Config.h:244", shares: IN1}
    - {pin: 34, const: IN1,         use: "KEY-ON input (12 V key via opto, 10k pull-up, LOW = key on; Sparky 2026-10-22) — reuses IN1 spare (no other free GPIO on A). Firmware read = later commit (chief #4 KSI)", wire: S42, status: PROPOSED, tier: CRITICAL, src: "Config.h:170", shares: LIGHT_OE}
    - {pin: -1, const: IN2,         use: "IN2 retired (was 16 = Serial4 RX): no free GPIO on A; DEFERRED until after first drive (chief 2026-10-22; not on the pre-drive CRITICAL list)", wire: null, status: PROPOSED, tier: LATER, src: "Config.h:171", shares: "IN3, IN4, LIGHT_LATCH (all -1 = unassigned)"}
    - {pin: -1, const: IN3,         use: "IN3 retired (was 18 = I2C SDA); DEFERRED until after first drive (chief 2026-10-22; not on the pre-drive CRITICAL list)", wire: null, status: PROPOSED, tier: LATER, src: "Config.h:172", shares: "-1"}
    - {pin: -1, const: IN4,         use: "IN4 retired (was 19 = I2C SCL); DEFERRED until after first drive (chief 2026-10-22; not on the pre-drive CRITICAL list)", wire: null, status: PROPOSED, tier: LATER, src: "Config.h:173", shares: "-1"}
    - {pin: 35, const: LIGHT_DATA,  use: "bit-bang DATA -> U4 -> MCP4131 SDI (shared with lights)", wire: S10, status: PROPOSED, src: "Config.h:234"}
    - {pin: 36, const: LIGHT_CLK,   use: "bit-bang CLK -> U4 -> MCP4131 SCK", wire: S10, status: PROPOSED, src: "Config.h:235"}
    - {pin: 37, const: ACT_EN,      use: "both BTS7960 enables", wire: null, status: PROPOSED, tier: LATER, src: "Config.h:228"}
    - {pin: 38, const: THR_CS,      use: "MCP4131 /CS -> U4", wire: S10, status: PROPOSED, src: "Config.h:252"}
    - {pin: 39, const: POS_DIFF,    use: "diff actuator pot wiper", wire: null, status: PROPOSED, tier: LATER, src: "Config.h:219"}
    - {pin: 40, const: PEDAL_IN_A,  use: "throttle pedal wiper (10k/18k + 100 nF)", wire: S14, status: SOURCED, src: "Config.h:222"}
    - {pin: 41, const: POS_4WD,     use: "4WD actuator pot wiper", wire: null, status: PROPOSED, tier: LATER, src: "Config.h:218"}
    - {pin: -1, const: LIGHT_LATCH, use: "retired (lights on MCP23017)", wire: null, status: SOURCED, src: "Config.h:243"}
  B:
    - {pin: 0,  const: null,        use: "CAN2 RX -> SN65 #4 (string 4)", wire: C04, status: SOURCED, src: "FlexCanCompat.h:44"}
    - {pin: 1,  const: null,        use: "CAN2 TX", wire: C04, status: SOURCED, src: "FlexCanCompat.h:44"}
    - {pin: 2,  const: OUT5,        use: "OUT5 pinMode LOW, no wire", wire: null, status: SOURCED, src: "Config.h:180"}
    - {pin: 3,  const: OUT6,        use: "OUT6 pinMode LOW, no wire", wire: null, status: SOURCED, src: "Config.h:181"}
    - {pin: 4,  const: B_FAULT_OUT, use: "B fault out HIGH=healthy (B_FAULT_PIN_ENABLE=0, disabled)", wire: null, status: UNVERIFIED, tier: LATER, src: "Config.h:184"}
    - {pin: 5,  const: OUT7,        use: "pinMode LOW, no wire", wire: null, status: SOURCED, src: "Config.h:187"}
    - {pin: 6,  const: OUT8,        use: "pinMode LOW, no wire", wire: null, status: SOURCED, src: "Config.h:188"}
    - {pin: 7,  const: B_THR_ALIVE, use: "B throttle heartbeat 1 kHz -> U1 B2", wire: S12, status: SOURCED, src: "Config.h:225"}
    - {pin: 11, const: OUT1,        use: "pinMode LOW; B never drives a coil (watchdog can only open)", wire: null, status: SOURCED, src: "Config.h:174"}
    - {pin: 12, const: OUT2,        use: "pinMode LOW, no wire", wire: null, status: SOURCED, src: "Config.h:175"}
    - {pin: 13, const: LED,         use: "on-board LED", wire: null, status: SOURCED, src: "Config.h:166"}
    - {pin: 14, const: CUR_LO,      use: "LEM B DHAB pin 4", wire: S25, status: SOURCED, src: "Config.h:198"}
    - {pin: 15, const: CUR_HI,      use: "LEM B DHAB pin 3", wire: S26, status: SOURCED, src: "Config.h:199"}
    - {pin: 16, const: null,        use: "Serial4 RX (not wired on B)", wire: null, status: ASSUMED, src: "HubStatus.cpp:12"}
    - {pin: 17, const: null,        use: "Serial4 TX (not wired on B; gateway listens to A only)", wire: null, status: ASSUMED, src: "HubStatus.cpp:12"}
    - {pin: 20, const: OUT3,        use: "pinMode LOW, no wire", wire: null, status: SOURCED, src: "Config.h:176"}
    - {pin: 21, const: OUT4,        use: "pinMode LOW, no wire", wire: null, status: SOURCED, src: "Config.h:177"}
    - {pin: 22, const: CAN1_TX,     use: "CAN1 TX -> SN65 #3 (string 3)", wire: C02, status: SOURCED, src: "Config.h:185"}
    - {pin: 23, const: CAN1_RX,     use: "CAN1 RX", wire: C02, status: SOURCED, src: "Config.h:186"}
    - {pin: 24, const: HV_SENSE,    use: "optional HV sense (no wire)", wire: null, status: UNVERIFIED, tier: LATER, src: "Config.h:196"}
    - {pin: 25, const: CUR_VC,      use: "LEM B 5 V supply sense", wire: S27, status: SOURCED, src: "Config.h:200"}
    - {pin: 30, const: null,        use: "CAN3 RX vehicle bus -> SN65 #6 (stub)", wire: C06, status: SOURCED, src: "FlexCanCompat.h:45"}
    - {pin: 31, const: null,        use: "CAN3 TX vehicle bus", wire: C06, status: SOURCED, src: "FlexCanCompat.h:45"}
    - {pin: 32, const: PARK_IN_B,   use: "park brake contact 2 (10k pull-up, LOW = set)", wire: S17, status: SOURCED, src: "Config.h:264"}
    - {pin: 40, const: ST_4WD_B,    use: "OPTIONAL stock 4WD indicator (not read yet)", wire: null, status: PROPOSED, tier: LATER, src: "Config.h:223"}
    - {pin: 41, const: PEDAL_IN_B,  use: "throttle pedal wiper (own 10k/18k + 100 nF)", wire: S15, status: SOURCED, src: "Config.h:224"}
    - {pin: 9,  const: null,        use: "E-STOP block 3 latch input, 10k pull-up, LOW = released/closed (pin free on B; no firmware const yet — EstopLatch.h not wired, chief #5)", wire: E09, status: PROPOSED, src: "crew 2026-10-22; docs/ESTOP.md"}
    - {pin: 26, const: null,        use: "12 V LOW ALARM sense (A12) via 47k/10k + 100 nF (pin free on B; no firmware const yet; A has no free analog pin)", wire: S40, status: PROPOSED, src: "crew 2026-10-22"}
    - {pin: 33, const: null,        use: "CHARGE PLUG-IN mirror: LM339 ch2 OUT2 (pin 1) of the same LM339, own 10k pull-up to B 3.3 V + 100 nF, LOW = plugged. Plugged = drive blocked on B too (like park). B:33 free per this map (Config.h spare list 33-39). Firmware read + 20 ms debounce = later commit", wire: S44, status: PROPOSED, tier: CRITICAL, src: "Adam 2026-10-22; chief 2026-10-23 06:57 #1 DECIDED (bms_master_answers.md)"}
    - {pin: 35, const: null,        use: "RELEASE-BUTTON detect B: LM339 ch4 OUT4 (pin 13) via 1k series, own 10k pull-up to B 3.3 V + 100 nF. LOW = plugged and latched (~1.0 V at IN+), HIGH = release button pressed (~1.8 V) or unplugged. B:35 free on B (Config.h B spare list 33-39; LIGHT_DATA 35 is an A-only role). Firmware read + 20 ms debounce = later commit", wire: S52, status: PROPOSED, tier: CRITICAL, src: "Sparky 2026-10-23 06:57 #1/#3 DECIDED (bms_master_answers.md)"}
    - {pin: 34, const: IN1,         use: "KEY-ON mirror (own opto channel, 10k pull-up, LOW = key on) — reuses IN1 spare, pin 34 free on B. Firmware read = later commit", wire: S43, status: PROPOSED, tier: CRITICAL, src: "Config.h:170"}
  E:
    - {pin: GPIO16, const: null, use: "UART2 RX <- Teensy A pin 17 (3.3 V to 3.3 V, NO level shifter; TX-only gateway by design, DECIDED chief 06:57 #2)", wire: S30, status: SOURCED, src: "teryx-ev-hub firmware/esp32-gateway/docs/GATEWAY.md:17"}
    - {pin: GPIO4, const: null, use: "spare, read-only role (gateway never drives it today)", wire: null, status: ASSUMED, tier: LATER, src: "teryx-ev-hub cursor/schema-sync firmware/esp32-gateway/src/main.cpp:36 (only GPIO16 used); output-safe per ESP32-WROOM strapping/flash rules"}
    - {pin: GPIO13, const: null, use: "spare, read-only role (gateway never drives it today)", wire: null, status: ASSUMED, tier: LATER, src: "teryx-ev-hub cursor/schema-sync firmware/esp32-gateway/src/main.cpp:36 (only GPIO16 used); output-safe per ESP32-WROOM strapping/flash rules"}
    - {pin: GPIO14, const: null, use: "spare, read-only role (gateway never drives it today) — outputs PWM briefly at boot", wire: null, status: ASSUMED, tier: LATER, src: "teryx-ev-hub cursor/schema-sync firmware/esp32-gateway/src/main.cpp:36 (only GPIO16 used); output-safe per ESP32-WROOM strapping/flash rules"}
    - {pin: GPIO18, const: null, use: "spare, read-only role (gateway never drives it today)", wire: null, status: ASSUMED, tier: LATER, src: "teryx-ev-hub cursor/schema-sync firmware/esp32-gateway/src/main.cpp:36 (only GPIO16 used); output-safe per ESP32-WROOM strapping/flash rules"}
    - {pin: GPIO19, const: null, use: "spare, read-only role (gateway never drives it today)", wire: null, status: ASSUMED, tier: LATER, src: "teryx-ev-hub cursor/schema-sync firmware/esp32-gateway/src/main.cpp:36 (only GPIO16 used); output-safe per ESP32-WROOM strapping/flash rules"}
    - {pin: GPIO21, const: null, use: "spare, read-only role (gateway never drives it today)", wire: null, status: ASSUMED, tier: LATER, src: "teryx-ev-hub cursor/schema-sync firmware/esp32-gateway/src/main.cpp:36 (only GPIO16 used); output-safe per ESP32-WROOM strapping/flash rules"}
    - {pin: GPIO22, const: null, use: "spare, read-only role (gateway never drives it today)", wire: null, status: ASSUMED, tier: LATER, src: "teryx-ev-hub cursor/schema-sync firmware/esp32-gateway/src/main.cpp:36 (only GPIO16 used); output-safe per ESP32-WROOM strapping/flash rules"}
    - {pin: GPIO23, const: null, use: "spare, read-only role (gateway never drives it today)", wire: null, status: ASSUMED, tier: LATER, src: "teryx-ev-hub cursor/schema-sync firmware/esp32-gateway/src/main.cpp:36 (only GPIO16 used); output-safe per ESP32-WROOM strapping/flash rules"}
    - {pin: GPIO25, const: null, use: "spare, read-only role (gateway never drives it today)", wire: null, status: ASSUMED, tier: LATER, src: "teryx-ev-hub cursor/schema-sync firmware/esp32-gateway/src/main.cpp:36 (only GPIO16 used); output-safe per ESP32-WROOM strapping/flash rules"}
    - {pin: GPIO26, const: null, use: "spare, read-only role (gateway never drives it today)", wire: null, status: ASSUMED, tier: LATER, src: "teryx-ev-hub cursor/schema-sync firmware/esp32-gateway/src/main.cpp:36 (only GPIO16 used); output-safe per ESP32-WROOM strapping/flash rules"}
    - {pin: GPIO27, const: null, use: "spare, read-only role (gateway never drives it today)", wire: null, status: ASSUMED, tier: LATER, src: "teryx-ev-hub cursor/schema-sync firmware/esp32-gateway/src/main.cpp:36 (only GPIO16 used); output-safe per ESP32-WROOM strapping/flash rules"}
    - {pin: GPIO32, const: null, use: "spare, read-only role (gateway never drives it today)", wire: null, status: ASSUMED, tier: LATER, src: "teryx-ev-hub cursor/schema-sync firmware/esp32-gateway/src/main.cpp:36 (only GPIO16 used); output-safe per ESP32-WROOM strapping/flash rules"}
    - {pin: GPIO33, const: null, use: "spare, read-only role (gateway never drives it today)", wire: null, status: ASSUMED, tier: LATER, src: "teryx-ev-hub cursor/schema-sync firmware/esp32-gateway/src/main.cpp:36 (only GPIO16 used); output-safe per ESP32-WROOM strapping/flash rules"}
    - {pin: GPIO17, const: null, use: "UART2 TX — UNUSED, leave unconnected (gateway is RX-only, TX pin = -1)", wire: null, status: SOURCED, src: "GATEWAY.md:5,18"}
    - {pin: GND,  const: null, use: "common LV ground with Teensy A", wire: G05, status: SOURCED, src: "GATEWAY.md:19"}
    - {pin: 5V/VIN, const: null, use: "5 V from fused buck on VIN — power only, no logic at 5 V (DECIDED chief 06:57 #2) (never Teensy 3.3 V)", wire: P08, status: SOURCED, src: "GATEWAY.md:20"}

# MCP23017 body expander on Wire (A:18/19, BODY_IO_EXPANDER=1). bit = Config.h ExpBits:: (names only, no logic).
expander:   # MCP23017 = LATER, FOOTPRINT ONLY on bms_master (not fitted; DECIDED chief 06:57 #3). When fitted: address 0x20 (A0-A2 to GND), 4.7k SDA/SCL pull-ups to 3.3 V, RESET high through 10k
  - {bits: "0-8", const: null, use: "9 light outputs (HEAD_LO, HEAD_HI, TAIL, BRAKE, TURN_L, TURN_R, REVERSE, BAR, WORK) via FETs", status: PROPOSED, tier: LATER, src: "docs/BODY_IO.md:31,60"}
  - {bits: "9-12", const: null, use: "free (stock 4WD switch input moves here; bit not assigned yet)", status: UNDEFINED, tier: LATER, src: "docs/BODY_IO.md:60"}
  - {bits: 13, const: BUZZER, use: "LATER — reserved: 12 V buzzer for the dash master alert (no logic; only if Adam counts expander bits as A outputs)", status: PROPOSED, tier: LATER, src: "BACKLOG.md BUZZER (Build 18)"}
  - {bits: 14, const: MOTOR_FAN, use: "LATER — reserved: 12 V motor fan relay via low-side IRLB8721 + 10k pull-down + 1N4007; future trigger Kelly CAN 0x0CF11F05 byte 2 (motor temp, UNVERIFIED) (no logic)", status: PROPOSED, tier: LATER, src: "BACKLOG.md MOTOR_FAN (Build 18)"}
  - {bits: 15, const: null, use: "free — PACK_HEAT NOT reserved (chief full review 2026-10-23: new HV circuit, dropped from Build 18)", status: SOURCED, tier: LATER, src: "review/full_program_review_chief.md"}

connectors:  # part: id in docs/PARTS.yaml (null = no catalogued part; reported by scripts/check_parts.py)
  - {id: X2-S1..S4, part: bicm_total, what: "Volt BICM harness K16 X2 (one per string)", pins: "9 = 5 V (705 GY/RD) · 10 = GND (470 BK/VT) · 11 = CAN_L (6434 L-BU/YE) · 12 = CAN_H (6435 WH/YE)", status: SOURCED, src: "tools/wiring_data.js bms page; tools/schematic/gen.py 'bo' (CAN H/L UNVERIFIED: swap if no cells)"}
  - {id: KELLY-J, part: controller, what: "Kelly KLS-8080N signal connector", pins: "3 throttle · 7 KSI/PWR · 11 12 V out · 15 Foot_SW · 22 ECO · 2 Brake_AN · throttle RTN pin number UNVERIFIED (G12)", status: UNVERIFIED, src: "KLS-8080N V2.11 / HC V2.14 manuals via docs/ESTOP.md:18, wiring_data.js CONFLICTS; Adam's harness unread"}
  - {id: ESTOP, part: [estop_head, estop_blocks], what: "XB5AS8442 (or XB4BS8442) head + 2x ZBE102 = 3 NC blocks", pins: "each block: terminals 11 (in) / 12 (out), NC", status: SOURCED, src: "docs/ESTOP.md; se.com XB5AS8442 page (1 NC in head)"}
  - {id: EBOX-DT, part: deutsch, what: "Electronics box Deutsch DT harness connector", pins: "UNDEFINED — pin-out not assigned yet", status: UNDEFINED, src: "tools/schematic/gen.py 'dt'"}
  - {id: TB-5V, part: lv_tb, what: "5 V terminal block", pins: "Teensy A VIN, Teensy B VIN, transceivers? (SN65 run on 3.3 V from each Teensy), LEM 5 V, pedal 5 V, clamp chips", status: PROPOSED, src: "tools/wiring_data.js power12/clamp"}
  - {id: TB-GND, part: lv_tb, what: "GND terminal block (single point)", pins: "LV STAR (DECIDED chief 06:57 #5): G03 buck return, G07 BICM GND (stays), G08 coil_driver dedicated 16 AWG return, G13 buffer battery - 2 AWG (Sparky 07:34 DECIDED: TB-GND/chassis; a 2 AWG lug needs a stud, OPEN), plus EXACTLY ONE link from the bms_master board star (J-PWR.2, = G03 path; no loop). Nothing else lands here", status: SOURCED, src: "tools/schematic/gen.py 'gnd'"}

fuses:
  - {id: F-MAIN, part: fuse_main, where: "DC-DC 12 V out, bus end (DC-DC -> P01 -> F-MAIN -> P02 -> 12 V bus +), as drawn", rating: "150 A MIDI/MEGA bolt-down (TDC-JH-144-12 = 110 A out, SOURCED); holder + P/N TBD", status: PROPOSED, src: "Sparky 07:34 DECIDED (rating + position); Sparky 2026-10-22"}
  - {id: F-BATT, part: fuse_batt, where: "12 V buffer battery + post, within 7 in of the post (P13 -> F-BATT -> P14 -> 12 V bus +)", rating: "150 A MIDI/MEGA bolt-down; holder + P/N TBD", status: PROPOSED, src: "Sparky 07:34 DECIDED"}
  - {id: F-COIL, part: lv_fuses, where: "12 V coil feed -> e-stop blocks 1+2", rating: "10 A", status: PROPOSED, src: "Sparky 2026-10-22"}
  - {id: F-KEL, part: lv_fuses, where: "Kelly PWR logic", rating: "2 A", status: PROPOSED, src: "Sparky 2026-10-22"}
  - {id: F-EBOX, part: lv_fuses, where: "electronics box 12 V", rating: "5 A (F-BUCK 3 A after it)", status: PROPOSED, src: "Sparky 2026-10-22"}
  - {id: F-BUCK, part: lv_fuses, where: "12 V -> 5 V buck", rating: "3 A mini blade", status: SOURCED, src: "gen.py fbx"}
  - {id: F-BICM, part: lv_fuses, where: "5 V -> BICM 705 feed", rating: "1 A (resize after measuring BICM draw)", status: UNVERIFIED, src: "gen.py f705"}
  - {id: F-TAB, part: lv_fuses, where: "tablet USB-C PD feed", rating: UNDEFINED, status: UNVERIFIED, src: "gen.py ftab"}
  - {id: F-AUX, part: lv_fuses, where: "each aux load (horn, lights) via relay 30", rating: "size to load, PROPOSED 10-15 A", status: PROPOSED, src: "Adam 10/22 NO aux buttons through relay/fuse"}
  - {id: F-S1..S4, part: fuse_a6t200, where: "string fuses on bus bar (service disconnect)", rating: "Mersen A6T200 200 A Class T", status: SOURCED, src: "docs/WIRING.md:66-69"}
  - {id: F-DCDC, part: dcdc_fuse, where: "HV in to DC-DC", rating: "15-20 A >=250 V DC (confirm label)", status: UNVERIFIED, src: "gen.py fdi"}
  - {id: F-ELC, part: charger_fuse, where: "Elcon HK-LF-144-46 out (46 A max) -> pack", rating: "Mersen A6T60, 60 A Class T, on 6 AWG; fuse holder TBD", status: SOURCED, src: "crew 2026-10-23"}

# Physical connections. dia: lines on tools/wiring.html that this wire number labels ("page|from|to|label").
# schem: lines on tools/schematic/gen.py ("from|to"). check: what to meter after crimping.
wires:
# ---- step 1: 12 V + grounds
  - {id: P01, step: 1, kind: wire, from: "DC-DC TDC-JH-144-12:+12V out", to: "F-MAIN:in", signal: "+12V main", voltage: "12-14 V", color: RD, awg: 2, fuse: F-MAIN, label: "P01 12V MAIN", tier: CRITICAL, status: UNVERIFIED, src: "gen.py; wiring_data power12; 2 AWG = Sparky 07:34 DECIDED (run under 5 ft)", check: "continuity end-to-end <1 Ω; NOT to chassis (>1 MΩ)", dia: ["overview|dcdc|b12|12 V", "power12|dcdc|fm|"], schem: ["dcdc|fmain"]}
  - {id: P02, step: 1, kind: wire, from: "F-MAIN:out", to: "12V bus bar:+", signal: "+12V main", voltage: "12-14 V", color: RD, awg: 2, fuse: F-MAIN, label: "P02 12V BUS", tier: CRITICAL, status: PROPOSED, src: "gen.py; 2 AWG = Sparky 07:34 DECIDED", check: "continuity <1 Ω", dia: ["power12|fm|b12|"], schem: ["fmain|b12"]}
  - {id: P13, step: 1, kind: wire, from: "12 V buffer battery:+ post", to: "F-BATT:in (≤ 7 in from the post)", signal: "+12V battery", voltage: "12-14 V", color: RD, awg: 2, fuse: F-BATT, label: "P13 BATT+", tier: CRITICAL, status: PROPOSED, src: "Sparky 07:34 DECIDED; id PROPOSED Gilfoyle (P10-P12 taken)", check: "<1 Ω; fuse ≤ 7 in from the post (tape it); NOT to chassis", dia: [], schem: []}
  - {id: P14, step: 1, kind: wire, from: "F-BATT:out", to: "12V bus bar:+", signal: "+12V battery", voltage: "12-14 V", color: RD, awg: 2, fuse: F-BATT, label: "P14 BATT BUS", tier: CRITICAL, status: PROPOSED, src: "Sparky 07:34 DECIDED; id PROPOSED Gilfoyle", check: "continuity <1 Ω battery + to bus +; fuse pulled = open", dia: [], schem: []}
  - {id: G01, step: 1, kind: wire, from: "12V bus bar:-", to: "frame ground strap", signal: GND, voltage: 0 V, color: BK, awg: "strap", fuse: none, label: "G01 12V- CHASSIS", tier: CRITICAL, status: PROPOSED, src: "wiring_data power12 net (Mechanic)", check: "12V- to frame <0.5 Ω", dia: [], schem: []}
  - {id: G02, step: 1, kind: wire, from: "Kelly case", to: "frame", signal: GND, voltage: 0 V, color: BK, awg: strap, fuse: none, label: "G02 KELLY CASE", tier: CRITICAL, status: PROPOSED, src: "wiring_data power12", check: "<0.5 Ω", dia: [], schem: []}
  - {id: P03, step: 1, kind: wire, from: "12V bus bar:+", to: "F-KEL:in -> Kelly PWR", signal: "+12V", voltage: 12 V, color: RD/WH, awg: 16, fuse: F-KEL, label: "P03 KELLY PWR", tier: CRITICAL, status: UNVERIFIED, src: "gen.py fkel", check: "continuity; fuse rating written on label", dia: ["power12|b12|fk|"], schem: ["b12|fkel", "fkel|kel"]}
  - {id: P04, step: 1, kind: wire, from: "12V bus bar:+", to: "F-COIL:in", signal: "+12V coil feed", voltage: 12 V, color: RD/WH, awg: 18, fuse: F-COIL, label: "P04 COIL FEED", tier: CRITICAL, status: PROPOSED, src: "docs/ESTOP.md", check: "continuity", dia: ["power12|b12|fd|"], schem: ["b12|fdrv"]}
  - {id: P05, step: 1, kind: wire, from: "12V bus bar:+", to: "F-EBOX:in (electronics box)", signal: "+12V", voltage: 12 V, color: RD/WH, awg: 16, fuse: F-EBOX, label: "P05 EBOX 12V", tier: CRITICAL, status: UNVERIFIED, src: "gen.py fesp", check: "continuity", dia: ["power12|b12|fe|"], schem: ["b12|fesp"]}
  - {id: P06, step: 1, kind: wire, from: "12V bus bar:+", to: "F-TAB -> tablet USB-C PD", signal: "+12V", voltage: 12 V, color: RD/WH, awg: 18, fuse: F-TAB, label: "P06 TABLET", tier: LATER, status: UNVERIFIED, src: "gen.py ftab", check: "continuity", dia: ["power12|b12|ft|"], schem: ["b12|ftab"]}
  - {id: P07, step: 1, kind: wire, from: "F-EBOX:out", to: "F-BUCK 3 A -> 5 V buck IN+", signal: "+12V", voltage: 12 V, color: RD/WH, awg: 18, fuse: F-BUCK, label: "P07 BUCK IN", tier: CRITICAL, status: SOURCED, src: "gen.py fbx", check: "continuity; buck output set 5.00 V BEFORE connecting loads", dia: ["power12|fe|f3|", "power12|f3|buck|"], schem: ["fesp|fbx", "fbx|conv"]}
  - {id: P08, step: 1, kind: wire, from: "5 V buck OUT+", to: "TB-5V", signal: "+5V", voltage: "5.00 V", color: OR, awg: 20, fuse: F-BUCK, label: "P08 5V", tier: CRITICAL, status: PROPOSED, src: "gen.py conv/v5", check: "power on with nothing else connected: 4.95-5.05 V", dia: ["power12|buck|v5|", "overview|b12|ta|5 V", "gateway|buck|esp|5 V"], schem: ["conv|v5", "v5|esp"]}
  - {id: P09, step: 1, kind: board, from: "Zener 1N5339B cathode", to: "TB-5V (anode to TB-GND)", signal: "5 V clamp", voltage: 5 V, color: "—", awg: "lead", fuse: none, label: "P09 ZENER", tier: CRITICAL, status: SOURCED, src: "gen.py z", check: "diode test: band end on +5V", dia: ["power12|z|v5|"], schem: ["z|v5"]}
  - {id: G03, step: 1, kind: wire, from: "5 V buck OUT- (on the bms_master board star) via J-PWR.2", to: "TB-GND", signal: GND, voltage: 0 V, color: BK, awg: 20, fuse: none, label: "G03 BUCK GND", tier: CRITICAL, status: PROPOSED, src: "gen.py gnd; chief 06:57 #5 DECIDED: the ONE link board star -> TB-GND (no loop)", check: "<0.5 Ω to 12V-; with G03 lifted, board star to TB-GND reads open (no second path)", dia: [], schem: []}
  - {id: P10, step: 4, kind: wire, from: "TB-5V", to: "F-BICM 1 A -> BICM X2 pin 9 (705 GY/RD) x4 strings", signal: "+5V BICM", voltage: 5 V, color: "GY/RD (factory)", awg: factory, fuse: F-BICM, label: "P10 BICM 5V", tier: CRITICAL, status: UNVERIFIED, src: "gen.py f705; wiring_data bms", check: "NEVER to Teensy I/O; 5 V at X2 pin 9", dia: ["power12|v5|f1|"], schem: ["v5|bo"]}
# ---- step 2: Teensys
  - {id: P11, step: 2, kind: wire, from: "TB-5V", to: "Teensy A:VIN (VIN/VUSB pad CUT)", signal: "+5V", voltage: 5 V, color: OR, awg: 20, fuse: F-BUCK, label: "P11 TA VIN", tier: CRITICAL, status: SOURCED, src: "gen.py teensy; wiring_data power12", check: "before plugging USB: VIN/VUSB pad cut (meter open between VIN and VUSB)", dia: [], schem: ["v5|ta"]}
  - {id: P12, step: 2, kind: wire, from: "TB-5V", to: "Teensy B:VIN (VIN/VUSB pad CUT)", signal: "+5V", voltage: 5 V, color: OR, awg: 20, fuse: F-BUCK, label: "P12 TB VIN", tier: CRITICAL, status: SOURCED, src: "as P11", check: "as P11", dia: [], schem: ["v5|tb"]}
  - {id: G04, step: 2, kind: board, from: "Teensy A:GND", to: "bms_master board star (signal ground) — NO wire to TB-GND (G04 to TB-GND dropped: DECIDED room Sparky + chief 2026-10-23 06:11). Teensy signal GND reaches coil_driver on J-SIG.1 in the gate cable; coil_driver J-GND -> TB-GND carries only the coil return (16 AWG+)", signal: GND, voltage: 0 V, color: "—", awg: board, fuse: none, label: "G04 TA GND STAR", tier: CRITICAL, status: PROPOSED, src: "room decision 2026-10-23 06:11 CT; docs/boards/bms_master.layout.json (Build 21)", check: "<0.5 Ω Teensy A GND pin to the bms_master star; no Teensy GND wire lands at TB-GND", dia: [], schem: ["gnd|ta"]}
  - {id: G06, step: 2, kind: board, from: "Teensy B:GND", to: "bms_master board star (signal ground) — same as G04 (PROPOSED Gilfoyle Build 21 for consistency with the 06:11 room decision; no separate wire to TB-GND)", signal: GND, voltage: 0 V, color: "—", awg: board, fuse: none, label: "G06 TB GND STAR", tier: CRITICAL, status: PROPOSED, src: "docs/boards/bms_master.layout.json (Build 21); consistency with G04", check: "<0.5 Ω Teensy B GND pin to the bms_master star", dia: [], schem: ["gnd|tb"]}
# ---- step 3: CAN
  - {id: C01, step: 3, kind: board, from: "Teensy A:22 TX / 23 RX + 3V3 + GND", to: "SN65HVD230 #1 TXD/RXD/VCC/GND", signal: "CAN logic", voltage: 3.3 V, color: "—", awg: board, fuse: none, label: "C01 A-CAN1", tier: CRITICAL, status: SOURCED, src: "Config.h:174-175", check: "TX->TXD, RX->RXD (NOT crossed for SN65); 3.3 V at VCC", dia: ["bms|ta|a1|"], schem: ["ta|x1"]}
  - {id: C03, step: 3, kind: board, from: "Teensy A:1 TX / 0 RX + 3V3 + GND", to: "SN65HVD230 #2", signal: "CAN logic", voltage: 3.3 V, color: "—", awg: board, fuse: none, label: "C03 A-CAN2", tier: CRITICAL, status: SOURCED, src: "FlexCanCompat.h:44", check: "as C01", dia: ["bms|ta|a2|"], schem: ["ta|x2"]}
  - {id: C02, step: 3, kind: board, from: "Teensy B:22/23", to: "SN65HVD230 #3", signal: "CAN logic", voltage: 3.3 V, color: "—", awg: board, fuse: none, label: "C02 B-CAN1", tier: CRITICAL, status: SOURCED, src: "Config.h:174-175", check: "as C01", dia: ["bms|tb|b1|"], schem: ["tb|x3"]}
  - {id: C04, step: 3, kind: board, from: "Teensy B:1/0", to: "SN65HVD230 #4", signal: "CAN logic", voltage: 3.3 V, color: "—", awg: board, fuse: none, label: "C04 B-CAN2", tier: CRITICAL, status: SOURCED, src: "FlexCanCompat.h:44", check: "as C01", dia: ["bms|tb|b2|"], schem: ["tb|x4"]}
  - {id: C05, step: 3, kind: board, from: "Teensy A:31 TX / 30 RX", to: "SN65HVD230 #5 + 120 Ω", signal: "CAN logic", voltage: 3.3 V, color: "—", awg: board, fuse: none, label: "C05 A-CAN3", tier: CRITICAL, status: SOURCED, src: "FlexCanCompat.h:45", check: "as C01", dia: ["bms|ta|veh|"], schem: ["ta|x5"]}
  - {id: C06, step: 3, kind: board, from: "Teensy B:31/30", to: "SN65HVD230 #6 (no 120 Ω)", signal: "CAN logic", voltage: 3.3 V, color: "—", awg: board, fuse: none, label: "C06 B-CAN3", tier: CRITICAL, status: SOURCED, src: "FlexCanCompat.h:45", check: "as C01", dia: ["bms|tb|veh|"], schem: ["tb|x6"]}
  - {id: C10, step: 3, kind: wire, from: "SN65 #5 CANH/CANL (A)", to: "SN65 #6 CANH/CANL (B) -> Kelly -> Elcon (daisy chain)", signal: "CAN-V 250k", voltage: "CAN", color: "YE (H) / GN (L) twisted", awg: 22, fuse: none, label: "C10 VEH CAN", tier: CRITICAL, status: PROPOSED, src: "FlexCanCompat.h:45; wiring_data bms", check: "power OFF: CANH-CANL ≈ 60 Ω (two 120 Ω ends); 120 Ω = one end missing; open = none", dia: ["overview|ta|tb|CAN3 link", "enables|ta|link|", "enables|tb|link|", "bms|veh|kel|", "bms|veh|elc|"], schem: ["x5|x6", "x6|kel"]}
# ---- step 4: BICMs
  - {id: C11, step: 4, kind: wire, from: "SN65 #1 CANH/CANL", to: "String 1 X2 pin 12 CAN_H (6435 WH/YE) / pin 11 CAN_L (6434 L-BU/YE)", signal: "CAN-A1 125k", voltage: CAN, color: "YE/GN -> factory WH/YE, L-BU/YE", awg: 22, fuse: none, label: "C11 S1 CAN", tier: CRITICAL, status: UNVERIFIED, src: "wiring_data bms net (H/L unconfirmed: swap if no cells)", check: "power OFF ≈60 Ω; power on: cells appear on console", dia: ["bms|a1|s1|"], schem: ["x1|bo"]}
  - {id: C12, step: 4, kind: wire, from: "SN65 #2 CANH/CANL", to: "String 2 X2 pins 12/11", signal: "CAN-A2 125k", voltage: CAN, color: "YE/GN", awg: 22, fuse: none, label: "C12 S2 CAN", tier: CRITICAL, status: UNVERIFIED, src: "as C11", check: "as C11", dia: ["bms|a2|s2|"], schem: ["x2|bo"]}
  - {id: C13, step: 4, kind: wire, from: "SN65 #3 CANH/CANL", to: "String 3 X2 pins 12/11", signal: "CAN-B1 125k", voltage: CAN, color: "YE/GN", awg: 22, fuse: none, label: "C13 S3 CAN", tier: CRITICAL, status: UNVERIFIED, src: "as C11", check: "as C11", dia: [], schem: ["x3|bo"]}
  - {id: C14, step: 4, kind: wire, from: "SN65 #4 CANH/CANL", to: "String 4 X2 pins 12/11", signal: "CAN-B2 125k", voltage: CAN, color: "YE/GN", awg: 22, fuse: none, label: "C14 S4 CAN", tier: CRITICAL, status: UNVERIFIED, src: "as C11", check: "as C11", dia: [], schem: ["x4|bo"]}
  - {id: G07, step: 4, kind: wire, from: "X2 pin 10 GND (470 BK/VT) x4", to: "TB-GND", signal: GND, voltage: 0 V, color: "BK/VT (factory)", awg: factory, fuse: none, label: "G07 BICM GND", tier: CRITICAL, status: SOURCED, src: "gen.py bo", check: "<0.5 Ω", dia: [], schem: ["gnd|bo"]}
  - {id: G13, step: 1, kind: wire, from: "12 V buffer battery:- post", to: "TB-GND / chassis (LV star)", signal: GND, voltage: 0 V, color: BK, awg: 2, fuse: none, label: "G13 BATT-", tier: CRITICAL, status: PROPOSED, src: "Sparky 07:34 DECIDED; id PROPOSED Gilfoyle (G series = grounds)", check: "<0.5 Ω battery - to chassis/TB-GND; lug torqued", dia: [], schem: []}
  - {id: G08, step: 4, kind: wire, from: "coil_driver J-GND.2 (5.08 mm screw terminal rated ≥10 A; on-board doubled 20 AWG solid bus to it)", to: "TB-GND", signal: "GND (coil return: <1 A continuous, 7.6 A for 130 ms)", voltage: 0 V, color: BK, awg: 16, fuse: none, label: "G08 COIL RET", tier: CRITICAL, status: PROPOSED, src: "chief 06:57 #5 + Sparky 06:57 #5 DECIDED (bms_master_answers.md); id G08 PROPOSED Gilfoyle Build 24", check: "<0.1 Ω J-GND.2 to TB-GND; terminal torque; no other ground on this wire", dia: [], schem: []}
  - {id: G09, step: 6, kind: wire, from: "LEM A DHAB pin C GND (GM harness BK/GY, circuit 2963)", to: "bms_master J-LEMA.2 -> own hole on the master star bar (no daisy-chain)", signal: GND, voltage: 0 V, color: "BK/GY (GM ckt 2963)", awg: factory, fuse: none, label: "G09 LEMA GND", tier: CRITICAL, status: SOURCED, src: "pin C = LEM DHAB datasheet via Sparky 07:34 (SOURCED); BK/GY ckt 2963 GM harness; own star hole = Sparky 06:57 #4 DECIDED; id PROPOSED Gilfoyle Build 24", check: "<0.5 Ω LEM A GND to board star; not shared with any other sensor wire", dia: [], schem: []}
  - {id: G10, step: 6, kind: wire, from: "LEM B DHAB pin C GND (GM harness BK/GY, circuit 2963)", to: "bms_master J-LEMB.2 -> own hole on the master star bar", signal: GND, voltage: 0 V, color: "BK/GY (GM ckt 2963)", awg: factory, fuse: none, label: "G10 LEMB GND", tier: CRITICAL, status: SOURCED, src: "pin C = LEM DHAB datasheet via Sparky 07:34 (SOURCED); BK/GY ckt 2963 GM harness; own star hole = Sparky 06:57 #4 DECIDED; id PROPOSED Gilfoyle Build 24", check: "as G09", dia: [], schem: []}
  - {id: G11, step: 6, kind: wire, from: "Pedal GND (pedal not chosen, S14 UNVERIFIED)", to: "bms_master J-THR.2 -> own board-star hole", signal: GND, voltage: 0 V, color: BK, awg: 22, fuse: none, label: "G11 PEDAL GND", tier: CRITICAL, status: PROPOSED, src: "Sparky 06:57 #4 DECIDED; id PROPOSED Gilfoyle Build 24", check: "as G09", dia: [], schem: []}
  - {id: G12, step: 6, kind: wire, from: "Kelly KLS-8080N throttle RTN (KELLY-J pin number UNVERIFIED)", to: "bms_master J-KEL.2 -> own board-star hole", signal: "GND (throttle return)", voltage: 0 V, color: BK, awg: 22, fuse: none, label: "G12 KELLY RTN", tier: CRITICAL, status: PROPOSED, src: "Sparky 06:57 #4 DECIDED; id PROPOSED Gilfoyle Build 24", check: "as G09; Kelly RTN to board star <0.5 Ω", dia: [], schem: []}
  - {id: S50, step: 4, kind: wire, from: "BICM 5139 fault loop", to: "pull-up few kΩ -> 5 V", signal: "fault loop", voltage: 5 V, color: factory, awg: factory, fuse: none, label: "S50 5139 PULLUP", tier: LATER, status: SOURCED, src: "gen.py pu", check: "5 V idle", dia: [], schem: ["pu|bo"]}
  - {id: S51, step: 6, kind: board, from: "LM339 ch3 OUT3 (pin 14, open collector) -> 1k series", to: "Teensy A:2 with its own 10k pull-up to A 3.3 V + 100 nF (firmware must set A:2 INPUT; boots as output)", signal: "release-button detect A: LOW = plugged + latched, HIGH = pressed or unplugged", voltage: "3.3 V pin (A rail)", color: BU/YE, awg: 22, fuse: "none (1k series)", label: "S51 REL A2", tier: CRITICAL, status: PROPOSED, src: "Adam t284 2026-10-22 (one comparator for both boards); Sparky 2026-10-22 (network values); chief 2026-10-23 06:57 #1 DECIDED (bms_master_answers.md): LM393 -> LM339 re-pin; Sparky 2026-10-23 06:57 #1/#3 DECIDED (bms_master_answers.md); LM339 pinout SOURCED from the TI LM339 datasheet (1 OUT2, 2 OUT1, 3 VCC, 4/5 IN1−/+, 6/7 IN2−/+, 8/9 IN3−/+, 10/11 IN4−/+, 12 GND, 13 OUT4, 14 OUT3); id S51 PROPOSED Gilfoyle Build 24 (S50 taken)", check: "plugged latched (~150 Ω): <0.4 V at A:2; button pressed (~480 Ω): 3.3 V; unplugged: 3.3 V. Plugged but not latched (prox plugged, release HIGH) = stop charger over CAN + open AC contactor", dia: ["plug|lm3|a2|OUT3 14"], schem: []}
  - {id: S52, step: 6, kind: board, from: "LM339 ch4 OUT4 (pin 13, open collector) -> 1k series", to: "Teensy B:35 with its own 10k pull-up to B 3.3 V + 100 nF", signal: "release-button detect B (mirror)", voltage: "3.3 V pin (B rail)", color: BU/YE, awg: 22, fuse: "none (1k series)", label: "S52 REL B35", tier: CRITICAL, status: PROPOSED, src: "Adam t284 2026-10-22 (one comparator for both boards); Sparky 2026-10-22 (network values); chief 2026-10-23 06:57 #1 DECIDED (bms_master_answers.md): LM393 -> LM339 re-pin; Sparky 2026-10-23 06:57 #1/#3 DECIDED (bms_master_answers.md); LM339 pinout SOURCED from the TI LM339 datasheet (1 OUT2, 2 OUT1, 3 VCC, 4/5 IN1−/+, 6/7 IN2−/+, 8/9 IN3−/+, 10/11 IN4−/+, 12 GND, 13 OUT4, 14 OUT3); id PROPOSED Gilfoyle Build 24", check: "as S51 at B:35; with B powered off, A:2 must still read correctly (separate pull-ups)", dia: ["plug|lm4|b35|OUT4 13"], schem: []}
  - {id: S53, step: 6, kind: board, from: "1.40 V release reference: 10k from the shared 5 V over 3.9k to GND (no hysteresis resistors)", to: "LM339 IN3− / IN4− (pins 8 and 10 tied; ch3/ch4 release A/B)", signal: "1.40 V threshold (latched ≈1.0 V below, pressed ≈1.8 V above)", voltage: "1.40 V (calculated)", color: BU, awg: 22, fuse: none, label: "S53 REL REF", tier: CRITICAL, status: PROPOSED, src: "Adam t284 2026-10-22 (one comparator for both boards); Sparky 2026-10-22 (network values); chief 2026-10-23 06:57 #1 DECIDED (bms_master_answers.md): LM393 -> LM339 re-pin; Sparky 2026-10-23 06:57 #1/#3 DECIDED (bms_master_answers.md); LM339 pinout SOURCED from the TI LM339 datasheet (1 OUT2, 2 OUT1, 3 VCC, 4/5 IN1−/+, 6/7 IN2−/+, 8/9 IN3−/+, 10/11 IN4−/+, 12 GND, 13 OUT4, 14 OUT3); id PROPOSED Gilfoyle Build 24", check: "1.40 V ±0.03 on pins 8/10 (calculated 5 × 3.9/13.9 = 1.403 V)", dia: ["plug|rref|lm3|IN− 8", "plug|rref|lm4|IN− 10"], schem: []}
# ---- step 5: ESP32 gateway
  - {id: S30, step: 5, kind: wire, from: "Teensy A:17 (Serial4 TX)", to: "ESP32:GPIO16 (UART2 RX)", signal: "UART 115200 8N1", voltage: 3.3 V, color: WH, awg: 22, fuse: none, label: "S30 TA17-ESP16", tier: LATER, status: SOURCED, src: "GATEWAY.md:17; HubStatus.cpp:12; chief 06:57 #2 DECIDED: 3.3 V -> 3.3 V, no level shifter, TX-only by design; ESP32 5 V on VIN = power only", check: "continuity; Teensy pin 16 and ESP32 GPIO17 stay UNCONNECTED", dia: ["overview|ta|esp|UART", "gateway|ta|esp|pin 17 → GPIO16"], schem: ["ta|esp"]}
  - {id: G05, step: 5, kind: wire, from: "Teensy A:GND", to: "ESP32:GND", signal: GND, voltage: 0 V, color: BK, awg: 22, fuse: none, label: "G05 TA-ESP GND", tier: LATER, status: SOURCED, src: "GATEWAY.md:19", check: "<0.5 Ω", dia: ["gateway|ta|esp|GND"], schem: ["gnd|esp"]}
  - {id: X01, step: 5, kind: none, from: "ESP32 Wi-Fi AP 192.168.4.1", to: "iPad / head unit", signal: "Wi-Fi (no wire)", voltage: "—", color: "—", awg: "—", fuse: none, label: "X01 WIFI", tier: LATER, status: SOURCED, src: "GATEWAY.md", check: "iPad joins AP, dash shows live data", dia: ["overview|esp|head|Wi-Fi", "gateway|esp|ipad|Wi-Fi"], schem: ["esp|tab"]}
# ---- step 6: safety I/O + Kelly low voltage
  - {id: E01, step: 6, kind: wire, from: "F-COIL:out", to: "E-stop block 1:11 + block 2:11 (jumper)", signal: "+12V coil feed", voltage: 12 V, color: RD/WH, awg: 18, fuse: F-COIL, label: "E01 ESTOP FEED", tier: CRITICAL, status: PROPOSED, src: "docs/ESTOP.md:112-113", check: "12 V at both terminal 11s", dia: ["overview|es|b12|coil feeds", "estop|f|es|"], schem: ["fdrv|es1", "fdrv|es2"]}
  - {id: E02, step: 6, kind: wire, from: "E-stop block 1:12", to: "EV200 B+ coil + AND EV200 B- coil + (high sides)", signal: "12V coil (cut)", voltage: 12 V, color: RD/YE, awg: 18, fuse: F-COIL, label: "E02 BLK1 MAIN COILS", tier: CRITICAL, status: SOURCED, src: "docs/ESTOP.md:112 (0.26 A break measured, OK)", check: "button released: 11-12 closed (<1 Ω); pushed: open", dia: ["estop|es|nc1|", "estop|nc1|c3|", "estop|nc1|c4|"], schem: ["es1|evp", "es1|evn"]}
  - {id: E03, step: 6, kind: wire, from: "E-stop block 2:12", to: "precharge relay coil + AND Kelly KSI/PWR pin 7", signal: "12V coil + KSI (cut)", voltage: 12 V, color: RD/YE, awg: 18, fuse: F-COIL, label: "E03 BLK2 PRE+KSI", tier: CRITICAL, status: UNVERIFIED, src: "docs/ESTOP.md:113 (KSI draw: Adam meters; Kelly pin 7 from manual)", check: "as E02; meter KSI current < 0.2 A", dia: ["estop|es|nc2|", "estop|nc2|c1|", "estop|nc2|c2|"], schem: ["es2|pre", "es2|kel"]}
  - {id: E09, step: 6, kind: wire, from: "E-stop block 3:11 -> TB-GND; block 3:12", to: "Teensy B:9 (10k pull-up) — free on B per this map", signal: "e-stop sense (latch, never the cut)", voltage: 3.3 V, color: BU/BK, awg: 22, fuse: none, label: "E09 BLK3 TB-ESTOP", tier: CRITICAL, status: PROPOSED, src: "crew 2026-10-22; docs/ESTOP.md; EstopLatch.h not wired (chief review #5)", check: "released: pin reads LOW (closed to GND); pushed: HIGH", dia: ["estop|es|nc3|", "estop|nc3|tb|"], schem: ["es3|tb", "gnd|es3"]}
  - {id: S01, step: 6, kind: board, from: "Teensy A:11 via 100 Ω (10k pull-down to GND)", to: "FET Q-B+ gate; drain -> EV200 B+ coil - (no external diode: EV200 economizer clamps, DECIDED Sparky 2026-10-23 05:41)", signal: "coil drive", voltage: 3.3 V gate / 12 V coil, color: "RD/BU (coil lead)", awg: "18 (coil lead)", fuse: F-COIL, label: "S01 TA11 MAIN+", tier: CRITICAL, status: PROPOSED, src: "Config.h:182; wiring_data precharge net", check: "Gate 0: 10k gate pull-down present (meter gate-GND ≈10 kΩ) — chief review #10", dia: ["precharge|drv|cevp|"], schem: ["ta|drv", "drv|evp"]}
  - {id: S02, step: 6, kind: board, from: "Teensy A:12 via 100 Ω (10k pull-down)", to: "FET Q-PRE gate; drain -> AEV14012 precharge coil - (D-PRE 1N4007 across the coil AT the relay, cathode to coil + (DECIDED chief 06:57 #6), no zener: DECIDED Sparky 2026-10-23 05:41)", signal: "coil drive", voltage: "3.3 / 12 V", color: "RD/GN", awg: 18, fuse: F-COIL, label: "S02 TA12 PRE", tier: CRITICAL, status: PROPOSED, src: "Config.h:183", check: "as S01", dia: ["precharge|drv|cpre|"], schem: ["drv|pre"]}
  - {id: S03, step: 6, kind: board, from: "Teensy A:21 via 100 Ω (10k pull-down)", to: "FET Q-B- gate; drain -> EV200 B- coil - (no external diode: EV200 economizer clamps, DECIDED Sparky 2026-10-23 05:41)", signal: "coil drive", voltage: "3.3 / 12 V", color: "RD/BK", awg: 18, fuse: F-COIL, label: "S03 TA21 MAIN-", tier: CRITICAL, status: PROPOSED, src: "Config.h:184", check: "as S01", dia: ["precharge|drv|cevn|"], schem: ["drv|evn"]}
  - {id: S05, step: 6, kind: wire, from: "LEM A DHAB pin 4 (ch1)", to: "10k/18k + 100 nF -> Teensy A:14", signal: "LEM A low range", voltage: "0-5 V -> 0-3.2 V", color: BU, awg: 22, fuse: none, label: "S05 LEMA CH1", tier: CRITICAL, status: SOURCED, src: "Config.h:187", check: "no current: ≈2.5 V at DHAB, ≈1.6 V at pin", dia: ["overview|lem|f|B− clamp"], schem: ["lem|ta"]}
  - {id: S06, step: 6, kind: wire, from: "LEM A DHAB pin 3 (ch2)", to: "10k/18k + 100 nF -> Teensy A:15", signal: "LEM A high range", voltage: "0-5 V -> 0-3.2 V", color: BU/WH, awg: 22, fuse: none, label: "S06 LEMA CH2", tier: CRITICAL, status: SOURCED, src: "Config.h:188", check: "as S05", dia: [], schem: []}
  - {id: S07, step: 6, kind: wire, from: "TB-5V -> LEM A 5 V; sense via 10k/18k 1 % divider", to: "Teensy A:25", signal: "LEM supply ref", voltage: "5 V -> 3.2 V", color: OR, awg: 22, fuse: F-BUCK, label: "S07 LEMA VC", tier: CRITICAL, status: SOURCED, src: "Config.h:189; divider 10k/18k 1 % (same ratio as the LEM outputs) DECIDED Sparky 06:57 #6", check: "≈3.2 V at pin 25", dia: [], schem: []}
  - {id: S25, step: 6, kind: wire, from: "LEM B DHAB pin 4", to: "divider -> Teensy B:14", signal: "LEM B low", voltage: "0-3.2 V", color: BU, awg: 22, fuse: none, label: "S25 LEMB CH1", tier: CRITICAL, status: SOURCED, src: "Config.h:187", check: "as S05", dia: [], schem: ["lem|tb"]}
  - {id: S26, step: 6, kind: wire, from: "LEM B DHAB pin 3", to: "divider -> Teensy B:15", signal: "LEM B high", voltage: "0-3.2 V", color: BU/WH, awg: 22, fuse: none, label: "S26 LEMB CH2", tier: CRITICAL, status: SOURCED, src: "Config.h:188", check: "as S05", dia: [], schem: []}
  - {id: S27, step: 6, kind: wire, from: "LEM B 5 V sense via 10k/18k 1 % divider", to: "Teensy B:25", signal: "LEM supply ref", voltage: "3.2 V", color: OR, awg: 22, fuse: F-BUCK, label: "S27 LEMB VC", tier: CRITICAL, status: SOURCED, src: "Config.h:189; divider 10k/18k 1 % (same ratio as the LEM outputs) DECIDED Sparky 06:57 #6", check: "≈3.2 V", dia: [], schem: []}
  - {id: S14, step: 6, kind: wire, from: "Pedal wiper (Hall, 0-5 V ASSUMED)", to: "10k/18k + 100 nF -> Teensy A:40 and MCP4131 P0A", signal: "throttle", voltage: "0-5 V -> 0-3.2 V", color: BU, awg: 22, fuse: none, label: "S14 PEDAL A", tier: CRITICAL, status: UNVERIFIED, src: "Config.h:215; docs/THROTTLE_CLAMP.md (pedal not chosen; chief review #9 calibration)", check: "pedal up / down voltages logged; ≈88 % max reading (chief #9)", dia: ["overview|ped|clamp|wiper", "clamp|ped|u3|P0A", "clamp|ped|da|"], schem: ["ped|clamp"]}
  - {id: S15, step: 6, kind: wire, from: "Pedal track 2", to: "own 10k/18k + 100 nF -> Teensy B:41 (A17); A reads track 1 on pin 40", signal: "throttle B", voltage: "0-3.2 V", color: BU/WH, awg: 22, fuse: none, label: "S15 PEDAL B", tier: CRITICAL, status: PROPOSED, src: "crew 2026-10-22 (track 2 on B:41); Config.h PEDAL_IN_B", check: "as S14", dia: ["clamp|ped|db|"], schem: []}
  - {id: P20, step: 6, kind: wire, from: "TB-5V", to: "pedal 5 V + U1..U4 VCC (shared rail)", signal: "+5V", voltage: 5 V, color: OR, awg: 20, fuse: F-BUCK, label: "P20 5V CLAMP", tier: CRITICAL, status: PROPOSED, src: "docs/THROTTLE_CLAMP.md", check: "5 V at each chip VCC pin", dia: ["clamp|v5|ped|"], schem: []}
  - {id: S10, step: 6, kind: board, from: "Teensy A:35 DATA / 36 CLK / 38 CS", to: "U4 74AHCT125 -> U3 MCP4131 SDI/SCK/CS", signal: "bit-bang SPI", voltage: "3.3 -> 5 V", color: "—", awg: board, fuse: none, label: "S10 TA SPI", tier: CRITICAL, status: PROPOSED, src: "Config.h:221-236", check: "continuity per pin", dia: ["overview|ta|clamp|SPI+alive", "clamp|ta|u4|35/36/38", "clamp|u4|u3|SDI/SCK/CS"], schem: ["ta|clamp"]}
  - {id: S11, step: 6, kind: board, from: "Teensy A:4 (R6 10k pull-down)", to: "U4 buffer -> U1 B1", signal: "A alive 1 kHz", voltage: "3.3 -> 5 V", color: VT, awg: 22, fuse: none, label: "S11 TA4 ALIVE", tier: CRITICAL, status: PROPOSED, src: "Config.h:243", check: "R6 ≈10 kΩ pin 4 to GND", dia: ["clamp|ta|r6|", "clamp|ta|u4|pin 4", "clamp|u4|u1|→B1", "enables|ta|q1|"], schem: []}
  - {id: S12, step: 6, kind: board, from: "Teensy B:7 (R4 10k pull-down)", to: "U1 B2", signal: "B alive 1 kHz", voltage: 3.3 V, color: VT/WH, awg: 22, fuse: none, label: "S12 TB7 ALIVE", tier: CRITICAL, status: PROPOSED, src: "Config.h:218", check: "R4 ≈10 kΩ", dia: ["overview|tb|en|pin 7", "clamp|tb|u1|pin 7→B2", "clamp|tb|r4|", "enables|tb|q2|"], schem: ["tb|clamp"]}
  - {id: B01, step: 6, kind: board, from: "U1 /CLR (R5 10k -> 5 V, C5 1 µF, 1N4148)", to: "U1 /CLR1 /CLR2", signal: "power-on clear", voltage: 5 V, color: "—", awg: board, fuse: none, label: "B01 U1 CLR", tier: CRITICAL, status: PROPOSED, src: "docs/THROTTLE_CLAMP.md", check: "continuity", dia: ["clamp|clr|u1|"], schem: []}
  - {id: B02, step: 6, kind: board, from: "U3 P0W", to: "U2a -> U2b (series 4066)", signal: throttle, voltage: "0-5 V", color: "—", awg: board, fuse: none, label: "B02 WIPER-4066", tier: CRITICAL, status: PROPOSED, src: "docs/THROTTLE_CLAMP.md", check: "Gate 1 clamp test: digipot powers up mid-scale — output must be 0 V with either Teensy off (chief #10)", dia: ["clamp|u3|u2a|P0W", "clamp|u2a|u2b|series", "enables|q1|sw|", "enables|q2|sw|"], schem: []}
  - {id: B03, step: 6, kind: board, from: "U1 Q1 / Q2", to: "U2a ctl / U2b ctl", signal: "enables", voltage: 5 V, color: "—", awg: board, fuse: none, label: "B03 Q-CTL", tier: CRITICAL, status: PROPOSED, src: "docs/THROTTLE_CLAMP.md", check: "continuity", dia: ["clamp|u1|u2a|Q1", "clamp|u1|u2b|Q2"], schem: []}
  - {id: K01, step: 6, kind: wire, from: "U2b out (R1 100k to GND — the ONLY pull-down)", to: "Kelly throttle input (pin 3)", signal: throttle, voltage: "0-5 V", color: BU/WH, awg: "22 shielded", fuse: none, label: "K01 KELLY THR", tier: CRITICAL, status: UNVERIFIED, src: "docs/THROTTLE_CLAMP.md; docs/KELLY_SETTINGS.md (100k, crew 2026-10-22); Kelly pin from manual", check: "Gate 1: pin 3 < 0.2 V with both 4066s open; full pedal voltage at pin 3 at full pedal. 10k pull-down = PROPOSED bench option only if pin 3 floats, after confirming pedal + digipot still reach full voltage through the 4066 under that load", dia: ["clamp|u2b|kt|", "clamp|kt|r1|", "enables|sw|k|"], schem: ["clamp|kel"]}
  - {id: S16, step: 6, kind: wire, from: "Park switch pole 1 (NO) -> GND", to: "Teensy A:32 (10k pull-up 3V3 + 100 nF)", signal: "park A, LOW = set", voltage: 3.3 V, color: BU/BK, awg: 22, fuse: none, label: "S16 PARK A", tier: CRITICAL, status: PROPOSED, src: "Config.h:249; docs/PARK_BRAKE.md (switch fit UNVERIFIED)", check: "brake set: pin 0 V; released: 3.3 V", dia: ["overview|pk|ta|pin 32", "park|sw|a|pole 1 → GND"], schem: ["pk|ta"]}
  - {id: S17, step: 6, kind: wire, from: "Park switch pole 2 (NO) -> GND", to: "Teensy B:32", signal: "park B", voltage: 3.3 V, color: BU/RD, awg: 22, fuse: none, label: "S17 PARK B", tier: CRITICAL, status: PROPOSED, src: "Config.h:253", check: "as S16", dia: ["park|sw|b|pole 2 → GND"], schem: ["pk|tb"]}
  - {id: K02, step: 6, kind: wire, from: "Kelly pin 11 (12 V out)", to: "Park pole 3 (NC) -> contact closed only while BOTH Teensys are alive (series heartbeat contacts) -> Kelly pin 15 Foot_SW", signal: "foot switch enable", voltage: 12 V, color: RD/WH -> RD/YE, awg: 20, fuse: none, label: "K02 FOOTSW PARK", tier: CRITICAL, status: UNVERIFIED, src: "docs/PARK_BRAKE.md; docs/KELLY_SETTINGS.md:64 (Sparky)", check: "brake set: open; either Teensy dead: open; both alive + released: <1 Ω", dia: ["park|k12|sw3|", "park|sw3|fs|"], schem: []}
  - {id: X02, step: 6, kind: none, from: "Teensy A/B park inputs", to: "software Parked logic", signal: "software (no wire)", voltage: "—", color: "—", awg: "—", fuse: none, label: "X02 SW PARK", tier: CRITICAL, status: SOURCED, src: "docs/PARK_BRAKE.md", check: "console shows parked", dia: ["park|a|sws|", "park|b|sws|"], schem: []}
  - {id: S20, step: 6, kind: board, from: "Teensy A:20 (100 Ω, 10k pull-down)", to: "low-side FET -> Low-cap relay coil 85 (86 = vehicle 12 V bus via F-COIL, 1N4007) — coil NEVER on Kelly pin 11 (40 mA max)", signal: "Low-cap release", voltage: "3.3 V / 12 V", color: "—", awg: board, fuse: F-COIL, label: "S20 TA20 LOWCAP", tier: CRITICAL, status: PROPOSED, src: "Config.h:167; docs/DRIVE_MODES.md; docs/KELLY_SETTINGS.md:71", check: "Teensy off: relay de-energised (NC closed)", dia: ["kelly|a|fet|gate", "kelly|fet|coil|"], schem: ["ta|low"]}
  - {id: K03, step: 6, kind: wire, from: "Kelly pin 11 12 V -> relay 30; relay 87a (NC)", to: "Kelly pin 22 ECO", signal: "Low cap (fail-safe: relay NC, dead Teensy = Low)", voltage: 12 V, color: "RD/WH -> RD/VT", awg: 20, fuse: none, label: "K03 ECO LOWCAP", tier: CRITICAL, status: UNVERIFIED, src: "docs/DRIVE_MODES.md; docs/KELLY_SETTINGS.md:67; Kelly pin 22 from manual", check: "relay off: Kelly pin 22 = 12 V", dia: ["overview|low|kel|ECO 22", "kelly|k12|nc|", "kelly|nc|eco|"], schem: ["low|kel"]}
  - {id: S40, step: 6, kind: wire, from: "12V bus via divider (PROPOSED 47k/10k + 100 nF)", to: "Teensy B:26 (A12) — free on B per this map", signal: "12 V sense", voltage: "≤3.3 V", color: BU, awg: 22, fuse: "PROPOSED 1 A", label: "S40 12V SENSE", tier: CRITICAL, status: PROPOSED, src: "crew 2026-10-22; wiring_data power12", check: "13.8 V in -> ≈2.4 V at pin", dia: [], schem: []}
  - {id: S41, step: 6, kind: wire, from: "LM339 ch1 OUT1 (pin 2, open collector) — the ONE shared LM339 (DECIDED re-pin; NOT OWNED: pending purchase approval)", to: "Teensy A:33 with its own 10k pull-up to Teensy A 3.3 V + 100 nF, LOW = plugged", signal: "plug-in detect A (drive blocked on A when plugged, like park)", voltage: "3.3 V pin (A rail)", color: BU/GN, awg: 22, fuse: "none (signal; 5 V feed already fused)", label: "S41 PLUG A33", tier: CRITICAL, status: PROPOSED, src: "Adam t284 2026-10-22 (one comparator for both boards); Sparky 2026-10-22 (network values); chief 2026-10-23 06:57 #1 DECIDED (bms_master_answers.md): LM393 -> LM339 re-pin; Sparky 2026-10-23 06:57 #1/#3 DECIDED (bms_master_answers.md); LM339 pinout SOURCED from the TI LM339 datasheet (1 OUT2, 2 OUT1, 3 VCC, 4/5 IN1−/+, 6/7 IN2−/+, 8/9 IN3−/+, 10/11 IN4−/+, 12 GND, 13 OUT4, 14 OUT3); chief review #4 (in.plugIn never set)", check: "unplugged (prox open): 3.3 V at A:33; plugged latched (~150 Ω) and button pressed (~480 Ω): <0.4 V; bench: plug/unplug confirms drive block on A, open-wire test", dia: ["plug|lm1|a|OUT1 2"], schem: []}
  - {id: S44, step: 6, kind: wire, from: "LM339 ch2 OUT2 (pin 1, open collector) — same chip as S41", to: "Teensy B:33 with its own 10k pull-up to Teensy B 3.3 V + 100 nF, LOW = plugged", signal: "plug-in detect B mirror (drive blocked on B when plugged, like park)", voltage: "3.3 V pin (B rail)", color: BU/GN, awg: 22, fuse: "none (signal; 5 V feed already fused)", label: "S44 PLUG B33", tier: CRITICAL, status: PROPOSED, src: "Adam t284 2026-10-22 (one comparator for both boards); Sparky 2026-10-22 (network values); chief 2026-10-23 06:57 #1 DECIDED (bms_master_answers.md): LM393 -> LM339 re-pin; Sparky 2026-10-23 06:57 #1/#3 DECIDED (bms_master_answers.md); LM339 pinout SOURCED from the TI LM339 datasheet (1 OUT2, 2 OUT1, 3 VCC, 4/5 IN1−/+, 6/7 IN2−/+, 8/9 IN3−/+, 10/11 IN4−/+, 12 GND, 13 OUT4, 14 OUT3)", check: "as S41 at B:33; with B powered off, A:33 must still read correctly (separate pull-ups)", dia: ["plug|lm2|b|OUT2 1"], schem: []}
  - {id: S45, step: 6, kind: wire, from: "NACS inlet PROXIMITY pin (SOURCED Adam 2026-10-22: ~150 Ω latched / ~480 Ω button pressed = plugged, open = not plugged; plug side returns to inlet PE)", to: "proximity node: 330 Ω pull-up to the shared 5 V + 2.7k to GND (Sparky; same values as the J1772 vehicle side)", signal: "plug proximity (one network for both boards)", voltage: "0–5 V (open ≈4.4 V, 480 Ω ≈2.8 V, 150 Ω ≈1.5 V, calculated)", color: BU/GN, awg: 22, fuse: "none (330 Ω limits it to 15 mA)", label: "S45 PROX NET", tier: CRITICAL, status: PROPOSED, src: "Adam t284 2026-10-22 (one comparator for both boards); Sparky 2026-10-22 (network values); chief 2026-10-23 06:57 #1 DECIDED (bms_master_answers.md): LM393 -> LM339 re-pin; Sparky 2026-10-23 06:57 #1/#3 DECIDED (bms_master_answers.md); LM339 pinout SOURCED from the TI LM339 datasheet (1 OUT2, 2 OUT1, 3 VCC, 4/5 IN1−/+, 6/7 IN2−/+, 8/9 IN3−/+, 10/11 IN4−/+, 12 GND, 13 OUT4, 14 OUT3)", check: "unplugged ≈4.4 V at the node; plugged latched ≈1.5 V, button pressed ≈2.8 V (calculated, UNVERIFIED until metered). Inlet PE to the single-point ground is UNVERIFIED", dia: ["plug|prox|net|proximity"], schem: []}
  - {id: S46, step: 6, kind: wire, from: "proximity node -> 10k (top) / 20k (to GND) divider", to: "LM339 IN+ of ALL FOUR channels (pins 5, 7, 9, 11 tied: ch1/ch2 plug A/B, ch3/ch4 release A/B) — one divider feeds all", signal: "divided proximity (×2/3, keeps it inside the LM339 input range at 5 V)", voltage: "≤3 V (open ≈2.9 V, 480 Ω ≈1.8 V, 150 Ω ≈1.0 V, calculated)", color: BU/GN, awg: 22, fuse: none, label: "S46 PROX DIV", tier: CRITICAL, status: PROPOSED, src: "Adam t284 2026-10-22 (one comparator for both boards); Sparky 2026-10-22 (network values); chief 2026-10-23 06:57 #1 DECIDED (bms_master_answers.md): LM393 -> LM339 re-pin; Sparky 2026-10-23 06:57 #1/#3 DECIDED (bms_master_answers.md); LM339 pinout SOURCED from the TI LM339 datasheet (1 OUT2, 2 OUT1, 3 VCC, 4/5 IN1−/+, 6/7 IN2−/+, 8/9 IN3−/+, 10/11 IN4−/+, 12 GND, 13 OUT4, 14 OUT3)", check: "unplugged ≈2.9 V on pins 5/7/9/11, plugged ≤1.9 V (2.5 V switch point ≈3.75 V at the node)", dia: ["plug|net|div|", "plug|div|lm1|IN+ 5", "plug|div|lm2|IN+ 7", "plug|div|lm3|IN+ 9", "plug|div|lm4|IN+ 11"], schem: []}
  - {id: S47, step: 6, kind: wire, from: "shared 5 V rail (5 V terminal block, same rail as the throttle clamp chips)", to: "LM339 VCC pin 3 (+ 100 nF to GND pin 12), the 330 Ω proximity pull-up and both reference dividers", signal: "LM339 + proximity supply", voltage: "5 V", color: OR, awg: 22, fuse: "5 V rail (3 A mini blade upstream)", label: "S47 LM339 5V", tier: CRITICAL, status: PROPOSED, src: "Adam t284 2026-10-22 (one comparator for both boards); Sparky 2026-10-22 (network values); chief 2026-10-23 06:57 #1 DECIDED (bms_master_answers.md): LM393 -> LM339 re-pin; Sparky 2026-10-23 06:57 #1/#3 DECIDED (bms_master_answers.md); LM339 pinout SOURCED from the TI LM339 datasheet (1 OUT2, 2 OUT1, 3 VCC, 4/5 IN1−/+, 6/7 IN2−/+, 8/9 IN3−/+, 10/11 IN4−/+, 12 GND, 13 OUT4, 14 OUT3)", check: "5.0 V between pin 3 and pin 12", dia: ["plug|v5|net|330 Ω", "plug|v5|lm1|VCC 3"], schem: []}
  - {id: S48, step: 6, kind: wire, from: "2.5 V plug reference (10k/10k from the shared 5 V). NO hysteresis resistors: 100 nF at each Teensy pin + 20 ms firmware debounce (DECIDED Sparky 06:57 #3)", to: "LM339 IN1− / IN2− (pins 4 and 6 tied; ch1/ch2 plug A/B)", signal: "2.5 V threshold", voltage: "2.5 V", color: BU, awg: 22, fuse: none, label: "S48 LM339 REF", tier: CRITICAL, status: PROPOSED, src: "Adam t284 2026-10-22 (one comparator for both boards); Sparky 2026-10-22 (network values); chief 2026-10-23 06:57 #1 DECIDED (bms_master_answers.md): LM393 -> LM339 re-pin; Sparky 2026-10-23 06:57 #1/#3 DECIDED (bms_master_answers.md); LM339 pinout SOURCED from the TI LM339 datasheet (1 OUT2, 2 OUT1, 3 VCC, 4/5 IN1−/+, 6/7 IN2−/+, 8/9 IN3−/+, 10/11 IN4−/+, 12 GND, 13 OUT4, 14 OUT3)", check: "2.50 V on pins 4/6", dia: ["plug|ref|lm1|IN− 4", "plug|ref|lm2|IN− 6"], schem: []}
  - {id: S49, step: 6, kind: wire, from: "LM339 GND pin 12 (also the 2.7k, 20k and both reference bottoms)", to: "single-point ground (bms_master board star, same as the Teensy A/B grounds)", signal: "LM339 ground", voltage: "0 V", color: BK, awg: 22, fuse: none, label: "S49 LM339 GND", tier: CRITICAL, status: PROPOSED, src: "Adam t284 2026-10-22 (one comparator for both boards); Sparky 2026-10-22 (network values); chief 2026-10-23 06:57 #1 DECIDED (bms_master_answers.md): LM393 -> LM339 re-pin; Sparky 2026-10-23 06:57 #1/#3 DECIDED (bms_master_answers.md); LM339 pinout SOURCED from the TI LM339 datasheet (1 OUT2, 2 OUT1, 3 VCC, 4/5 IN1−/+, 6/7 IN2−/+, 8/9 IN3−/+, 10/11 IN4−/+, 12 GND, 13 OUT4, 14 OUT3)", check: "<0.1 Ω pin 12 to the single-point ground", dia: ["plug|lm2|gnd|GND 12"], schem: []}
  - {id: S42, step: 6, kind: wire, from: "Stock Teryx key switch SWITCHED output (SOURCED Adam 2026-10-22; wire colour UNVERIFIED — Adam backprobes: 0 V key off, 12 V key on), fed from the TDC-JH 12 V bus, through its OWN 1 A fuse (Sparky 2026-10-22) -> opto ch1 LED (PROPOSED PC827 + 1k5)", to: "opto ch1 transistor -> Teensy A:34 (10k pull-up 3V3 + 100 nF), LOW = key on", signal: "KEY-ON A", voltage: "12 V in / 3.3 V pin", color: BU/YE, awg: 22, fuse: "own 1 A fuse (Sparky 2026-10-22, PROPOSED)", label: "S42 KEY A34", tier: CRITICAL, status: PROPOSED, src: "Adam 2026-10-22 (stock key switch source); Sparky 2026-10-22; chief review #4 (key-on is serial e only)", check: "BEFORE wiring: backprobe key switch output 0 V key off / 12 V key on (record colour). Then key off: 3.3 V at A:34; key on: <0.4 V", dia: [], schem: []}
  - {id: S43, step: 6, kind: wire, from: "Same stock key switch switched output (after the S42 fuse) -> opto ch2 LED (PROPOSED PC827 + 1k5)", to: "opto ch2 transistor -> Teensy B:34 (10k pull-up 3V3 + 100 nF), LOW = key on", signal: "KEY-ON B", voltage: "12 V in / 3.3 V pin", color: BU/YE, awg: 22, fuse: "shares S42 fuse", label: "S43 KEY B34", tier: CRITICAL, status: PROPOSED, src: "Sparky 2026-10-22", check: "as S42 at B:34", dia: [], schem: []}
# ---- step 7: HV (LATER, Sparky present, pack fuses OUT)
  - {id: H01, step: 7, kind: wire, from: "String 1..4 B+", to: "A6T200 fuse 1..4 (bus bar, insulated standoffs)", signal: HV+, voltage: "≤147.6 V", color: "OR HV, RED tape", awg: "1/0 (each A6T200 string lead, ~138 A at a 550 A launch)", fuse: F-S1..S4, label: "H01-H04 STRING n B+", tier: LATER, status: PROPOSED, src: "docs/WIRING.md:66-69; crew 2026-10-22", check: "torque to cut sheet; fuses OUT until first HV power-up", dia: ["overview|s1|f|HV", "overview|s2|f|", "overview|s3|f|", "overview|s4|f|"], schem: ["s1|f", "s2|f", "s3|f", "s4|f"]}
  - {id: H05, step: 7, kind: wire, from: "4 fuses", to: "common B+ bus", signal: HV+, voltage: HV, color: "OR HV, RED tape", awg: "1/0 (string side of each fuse)", fuse: F-S1..S4, label: "H05 FUSE-BUS", tier: LATER, status: PROPOSED, src: "wiring_data overview net", check: "torque", dia: ["overview|f|bus|string leads 1/0; pack-to-Kelly mains 3/0"], schem: ["f|bus"]}
  - {id: H06, step: 7, kind: wire, from: "common B+ bus (NO MSD — service = pull 4 fuses)", to: "EV200 B+ line", signal: HV+, voltage: HV, color: "OR HV, RED tape", awg: "3/0 owned TEMCo (pack-to-Kelly main)", fuse: F-S1..S4, label: "H06 BUS-EV200", tier: LATER, status: SOURCED, src: "wiring_data overview net (MSD removed 2026-10-22)", check: "torque", dia: ["overview|bus|evp|", "precharge|bus|evp|"], schem: ["bus|evp"]}
  - {id: H07, step: 7, kind: wire, from: "EV200 B+ load", to: "Kelly B+", signal: HV+, voltage: HV, color: "OR HV, RED tape", awg: "3/0 owned TEMCo (pack-to-Kelly main)", fuse: none, label: "H07 EV200-KELLY+", tier: LATER, status: SOURCED, src: "wiring_data", check: "torque", dia: ["overview|evp|kel|B+", "precharge|evp|kel|"], schem: ["evp|kel"]}
  - {id: H08, step: 7, kind: wire, from: "precharge relay + 50 Ω 100 W", to: "across EV200 B+", signal: HV precharge, voltage: HV, color: "OR HV", awg: "14 HV", fuse: none, label: "H08 PRECHARGE", tier: LATER, status: UNVERIFIED, src: "wiring_data precharge net; precharge contactor = salvaged AEV14012, 0.35 A at 12 V coil (34 Ω, 4.2 W, no economizer; ≈0.41 A at 14.0 V; coil allowed 10-16 V; SOURCED Panasonic EV relay catalog, crew 2026-10-23) — crew 2026-10-22/23; https://industry.panasonic.com/ac/cdn/e/control/relay/vehicle/catalog/mech_eng_ev.pdf", check: "resistor ≈50 Ω. MOUNT (Mechanic 2026-10-22): 50 Ω/100 W resistor on the HV panel aluminum backplate with thermal paste, away from the loom", dia: ["overview|pre|evp|across", "precharge|pre|evp|across"], schem: ["pre|evp", "pres|pre"]}
  - {id: H09, step: 7, kind: wire, from: "Kelly U/V/W + Sin/Cos", to: "Zero 75-7R", signal: "motor", voltage: HV, color: "OR HV", awg: "match bus", fuse: none, label: "H09 MOTOR", tier: LATER, status: SOURCED, src: "wiring_data", check: "phase order per Kelly autotune", dia: ["overview|kel|mot|U/V/W + Sin/Cos"], schem: ["kel|mot"]}
  - {id: H10, step: 7, kind: wire, from: "Kelly B-", to: "EV200 B- -> LEM A/B -> string B-", signal: HV-, voltage: HV, color: "OR HV, BLACK tape", awg: "3/0 owned TEMCo (pack-to-Kelly main)", fuse: none, label: "H10 KELLY-EV200-", tier: LATER, status: SOURCED, src: "wiring_data", check: "B- NEVER to chassis (>1 MΩ)", dia: ["overview|kel|evn|B−", "precharge|kel|evn|"], schem: ["kel|evn", "evn|lem"]}
  - {id: H11, step: 7, kind: wire, from: "String B- leads", to: "through LEM A (S1+S2) / LEM B (S3+S4)", signal: HV-, voltage: HV, color: "OR HV, BLACK tape", awg: "1/0", fuse: none, label: "H11 B- LEM", tier: LATER, status: SOURCED, src: "wiring_data overview", check: "LEM arrow direction = discharge", dia: [], schem: ["lem|s1"]}
  - {id: H12, step: 7, kind: wire, from: "HV bus", to: "F-DCDC -> DC-DC HV in", signal: HV, voltage: HV, color: "OR HV", awg: "14 HV", fuse: F-DCDC, label: "H12 DCDC IN", tier: LATER, status: UNVERIFIED, src: "gen.py fdi", check: "fuse rating vs label", dia: ["overview|dcdc|bus|HV fuse 15–20 A"], schem: ["bus|fdi", "fdi|dcdc"]}
  - {id: H13, step: 7, kind: wire, from: "Elcon out", to: "F-ELC -> pack bus", signal: HV, voltage: HV, color: "OR HV", awg: "6 HV (SOURCED crew 2026-10-23)", fuse: F-ELC, label: "H13 ELCON OUT", tier: LATER, status: SOURCED, src: "crew 2026-10-23: Elcon HK-LF-144-46 46 A max out, F-ELC Mersen A6T60 60 A on 6 AWG (holder TBD)", check: "fuse A6T60 fitted; holder TBD", dia: ["overview|elc|bus|HV fuse A6T60 60 A"], schem: ["elc|fel", "fel|bus"]}
  - {id: H14, step: 7, kind: wire, from: "NACS inlet (AC)", to: "Elcon AC in", signal: "AC 240 V", voltage: AC, color: "per AC code", awg: "per charger", fuse: none, label: "H14 AC IN", tier: LATER, status: UNVERIFIED, src: "wiring_data", check: "—", dia: ["overview|nacs|elc|AC"], schem: ["inlet|elc"]}
  - {id: S08, step: 7, kind: wire, from: "NOT FITTED (room DECIDED 2026-10-23): isolated HV sensor dropped for now; precharge uses Kelly CAN B+. Only if the Kelly B+ bench gate fails: AMC1311EVM isolated output (never a plain 60.6:1 divider)", to: "Teensy A:24 (reserved spare, HV_ANALOG_ENABLE=0)", signal: "HV sense (isolated, not fitted)", voltage: "≤3.3 V", color: BU, awg: 22, fuse: "PROPOSED 0.5 A HV-rated", label: "S08 RESERVED", tier: LATER, status: PROPOSED, src: "room 2026-10-23 (DROP isolated sense); Sparky 2026-10-23 (never a plain divider); Config.h:196", check: "Not fitted: A:24 unconnected. If ever fitted: HV side to Teensy GND open (≥ 1 MΩ, power off) before connecting", dia: [], schem: []}
# ---- step 8: body / aux (LATER) — NO buttons, through relay + fuse (Adam 10/22)
  - {id: A01, step: 8, kind: wire, from: "12V bus (switched) -> F-AUX", to: "aux relay 30", signal: "+12V load", voltage: 12 V, color: RD/WH, awg: "14 (size to load)", fuse: F-AUX, label: "A01 AUX FEED", tier: LATER, status: PROPOSED, src: "Adam 2026-10-22 (NO contacts, relay/fuse >1 A)", check: "fuse rating on label", dia: ["aux|f12|rly|30"], schem: ["b12|faux", "faux|rly"]}
  - {id: A02, step: 8, kind: wire, from: "12V switched (small fuse)", to: "NO push button (ZBE101) -> relay 86", signal: "button", voltage: 12 V, color: RD/WH, awg: 20, fuse: "PROPOSED 2 A", label: "A02 AUX BTN", tier: LATER, status: PROPOSED, src: "Adam 2026-10-22", check: "pressed: 12 V at 86; released: 0 V", dia: ["aux|f12|btn|", "aux|btn|rly|86"], schem: ["auxb|rly"]}
  - {id: A03, step: 8, kind: wire, from: "relay 85", to: "GND", signal: GND, voltage: 0 V, color: BK, awg: 20, fuse: none, label: "A03 RELAY GND", tier: LATER, status: PROPOSED, src: "standard automotive relay", check: "<0.5 Ω", dia: ["aux|rly|gnd|85"], schem: []}
  - {id: A04, step: 8, kind: wire, from: "relay 87", to: "horn / lights +", signal: "+12V load", voltage: 12 V, color: "RD/GN", awg: "14 (size to load)", fuse: F-AUX, label: "A04 AUX LOAD", tier: LATER, status: PROPOSED, src: "Adam 2026-10-22", check: "load works only while pressed", dia: ["aux|rly|load|87"], schem: ["rly|load"]}
  - {id: A05, step: 8, kind: wire, from: "load -", to: "GND", signal: GND, voltage: 0 V, color: BK, awg: 14, fuse: none, label: "A05 LOAD GND", tier: LATER, status: PROPOSED, src: "standard", check: "<0.5 Ω", dia: ["aux|load|gnd|"], schem: []}

conflicts:   # pin / doc conflicts found while building this map (see docs/PINMAP.md); RESOLVED = crew decision 2026-10-22
  - "DECIDED (Sparky 06:57 #1): release-button detect on A:2 (OUT5 spare) and B:35 (B spare), LM339 ch3/ch4, 1k series + own 10k pull-up + 100 nF each. FIRMWARE GAP: A:2 boots as an output (pinMode LOW in BmsApp.cpp) — firmware must set it INPUT; nothing reads plug, key or release yet (later commit; no flashing now)."
  - "DECIDED (Sparky 06:57 #1): plugged but NOT latched (plug channel LOW, release channel HIGH) = stop the charger over CAN and open the AC contactor. Firmware logic = later commit."
  - "DECIDED (Sparky 06:57 #2): SN65HVD230 modules are wired by silkscreen (pin order varies by vendor). Keep the onboard 120 Ω (usually R2 marked 121) only on the module at a physical bus end. Check powered off: CANH-CANL ≈60 Ω."
  - "DECIDED (chief 06:57 #5 / Sparky #4): TB-GND = LV star (G03, G07, G08). The bms_master board star reaches TB-GND by exactly one link (J-PWR.2). LEM A, LEM B, pedal and Kelly RTN each get their own wire to the board star (G09-G12, ids PROPOSED), no daisy-chain."
  - "NO FREE TEENSY A OUTPUT (Build 18 audit): edge pins 0-41 all used, 42-47 = SD card, 48-54 = bottom pads (no PSRAM fitted, UNVERIFIED, needs fine soldering). MOTOR_FAN / BUZZER reserved on MCP23017 bits 14 / 13 instead (PROPOSED). Other options for Adam: a second MCP23017 on the same Wire bus (addr 0x21), Teensy B spare outputs over the A-B link, or the bottom pads."
  - "DECIDED (room: chief + Sparky + crew, 2026-10-23): A:24 HV_SENSE is a reserved spare. Precharge + weld check use Kelly CAN B+ vs the BICM sum (BACKLOG CRITICAL, bench gate UNVERIFIED). If the bench gate fails, AMC1311EVM returns on A:24 (isolated, never a plain divider)."
  - "PROPOSED (Sparky 2026-10-22): KEY-ON on pin 34 (IN1 spare) on A and B — no free GPIO on A; IN2-IN4 deferred. LIGHT_OE (retired) also names 34; nothing drives it. Firmware does not read key-on or plug-in yet (later commit, chief #4)."
  - "AUDIT 2026-10-22 (chief): NO free analog pin on A. 14/15 LEM, 16/17 Serial4 (HubStatus owns both), 18/19 I2C (MCP23017), 20/21 OUT3/OUT4, 22/23 CAN1, 24 HV_SENSE, 25 CUR_VC, 26/27 IS_4WD/IS_DIFF, 38 THR_CS (digipot), 39 POS_DIFF, 40 PEDAL_IN_A, 41 POS_4WD. The rough-regex candidates A:23/26/27/38/39 are all in use. B has unassigned analog pins in the map (18, 19, 27, 38, 39; firmware role-gating UNVERIFIED), but the same threshold is needed on both boards, so proximity uses ONE LM339 comparator (re-pinned from the LM393, DECIDED chief 06:57 #1; ch1/ch2 2.5 V plug, ch3/ch4 1.40 V release, one network) into A:33 and B:33 (PROPOSED, Adam t284 replaces the per-board pair)."
  - "RESOLVED (Adam 2026-10-22): plug-in detect B mirror = S44 on B:33 (free per this map and Config.h B spare list)."
  - "RESOLVED: IN1/IN2 were Serial4 17/16 — IN1 moved to pin 34 (free on A and B), IN2 retired (-1). A pin 16 (RX4) stays unconnected on purpose: the gateway is receive-only (TX17 -> ESP32 GPIO16)."
  - "RESOLVED: IN3/IN4 were I2C 18/19 — retired (-1); 18/19 are only I2C_SDA/I2C_SCL now. No other free GPIO exists on A (33 reserved charge detect)."
  - "INTENDED (not a conflict): A uses pins 4/40 (A_THR_ALIVE, PEDAL_IN_A), B uses 7/41 (B_THR_ALIVE, PEDAL_IN_B). Pin 7 = RAD_FAN on A, 41 = POS_4WD on A, 4 = B_FAULT_OUT on B, 40 = ST_4WD_B on B — different boards; label harness wires TA/TB."
  - "RESOLVED (PROPOSED pins, free on B per this map): e-stop block 3 -> B pin 9; 12 V low alarm -> B pin 26 (A12). No firmware const yet."
  - "ESP32 GPIO17: teryx-ev-hub firmware/esp32-gateway/docs/PINMAP.md says GPIO17 TX <- Teensy RX 16 (crossed pair); GATEWAY.md:18 says leave unconnected (RX-only). This map follows GATEWAY.md. Hub PINMAP.md is stale (other repo, not edited)."
  - "FIXED: src/HubStatus.cpp:14 and include/Config.h:37 stale CAN comments corrected to CAN_LAYOUT_V2."
  - "FIXED: old wiring overview drew park on 'pin 18'; park is pin 32 on A and B."
  - "RESOLVED: precharge contactor = salvaged AEV14012, 0.35 A at 12 V coil (34 Ω, 4.2 W, no economizer; ≈0.41 A at 14.0 V; coil allowed 10-16 V; SOURCED Panasonic EV relay catalog, crew 2026-10-23); the earlier coil figure was the EV200 inrush. TE EV11 dropped."
  - "RESOLVED: HV gauge — string leads from each A6T200 = 1/0 (~138 A at a 550 A launch); pack-to-Kelly mains = owned 3/0."
  - "RESOLVED: SN65HVD230 — 4 owned enough for the one-string bench; 2 extra on the buy list for Gate 3 (no purchase now)."
  - "RESOLVED: PEDAL_IN_B = B pin 41, pedal track 2 via 10k/18k; A reads track 1 on pin 40."
  - "Kelly pin 3: ONE pull-down, the existing 100k (R1). Sparky's 10k NOT added — PROPOSED bench option only if pin 3 floats, after a full-voltage check through the 4066s."
  - "RESOLVED: DC-DC = Elcon TDC-JH-144-12, 110 A out (SOURCED crew 2026-10-23). F-MAIN = 150 A MIDI/MEGA at the DC-DC output, P01/P02 = 2 AWG (Sparky 07:34 DECIDED)."
  - "RESOLVED (Sparky 07:34 DECIDED): 12 V buffer battery: + -> F-BATT 150 A MIDI/MEGA (≤ 7 in from the post) -> 12 V bus + (P13/P14, 2 AWG); - -> TB-GND/chassis (G13, 2 AWG). Wire ids PROPOSED (P10-P12 already used). F-BATT holder + P/N TBD."
  - "RESOLVED (Sparky 07:34 DECIDED): LEM DHAB GND = pin C (SOURCED, LEM datasheet via Sparky), GM harness BK/GY circuit 2963 -> master star bar (G09/G10)."
