Adampaleski/AmperaBattery/include/LemHealth.h

#pragma once
// Dead-LEM / LEM-health checker (chief + Sparky 2026-10-21/22, CRITICAL before first drive).
// Pure C++ (no Arduino), host-tested by scripts/test_lem_health.cpp. One instance per LEM DHAB S/44
// (LEM A on Teensy A, LEM B on Teensy B). Uses BmsCore::dhabAmps maths, so pin volts in = same as CurrentSense.
// NOT wired into firmware yet: CURRENT_SENSE_ENABLE=0, split-LEM read not built. Report-only until then;
// a hard fault here is meant to engage the 10 mph (Kid/Low) cap, never to close anything.
//
// Checks (thresholds PROPOSED, from Sparky's notes; confirm on the bench):
//   RAIL   any output (ch1, ch2) within railV (0.2 V) of 0 V or of Vc, or Vc outside 4.5-5.5 V
//          -> dead / disconnected. Datasheet (BmsCore.h notes) says a live output clamps at 0.25 / 4.75 V,
//          so a working sensor never sits inside the 0.2 V rail band.
//   RANGE  |I| > rangeA (450 A) -> out of range.
//   AGREE  |I_ch2| < agreeBelowA (15 A) and |I_ch1 - I_ch2| > agreeTolA (5 A): low and high channels disagree.
//          ch2 is 6.15 mV/A, so 5 A = ~31 mV at the sensor (~20 mV at the pin): PLACEHOLDER, bench it.
//   ZERO   key-on self-test with mains open (no current can flow): |I| > zeroTolA (5 A) -> zero offset bad.
//          The stored zero itself comes from 'Z' (CurrentSense::calibrateZero, EEPROM Settings).
// Each live check must hold for holdMs (100 ms; AGREE 500 ms) before it latches. Latched until reset()
// at a key cycle, and reset() is refused while the condition is still present.
#include <cstdint>
#include <cmath>
#include "BmsCore.h"

namespace LemHealth {
enum Code : uint8_t { OK = 0, RAIL = 1, RANGE = 2, AGREE = 3, ZERO = 4 };
inline const char *name(uint8_t c) {
    switch (c) { case RAIL: return "LEM dead/disconnected"; case RANGE: return "LEM out of range";
                 case AGREE: return "LEM channels disagree"; case ZERO: return "LEM zero offset"; default: return "ok"; }
}
struct Limits {               // all PROPOSED
    float railV = 0.20f;      // sensor-side volts from 0 V / Vc
    float rangeA = 450.0f;
    float agreeBelowA = 15.0f;
    float agreeTolA = 5.0f;
    float zeroTolA = 5.0f;
    uint32_t holdMs = 100;
    uint32_t agreeHoldMs = 500;
};
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
