Adampaleski/AmperaBattery/(commit log)

2026-05-23 Add Teensy 4.1 BICM sniffer firmware for 24S/4x6S pack.
    PlatformIO project with FlexCAN_T4 on CAN3, BICM keep-alive, full-frame
    logging, 6-cell decode, and optional gated BMS GPIO env.
2026-05-23 Improve bench UX for single-BICM testing and uploads.
    Use teensy-cli uploader, add teensy41_1bicm env (6 cells), slower JSON,
    auto ID/cell reports every 10s, and lowercase serial commands without Enter.
2026-05-23 Add K112 24S sub-pack profile for single BICM on CAN.
    Decode cells 1-24 from Volt-style IDs 0x460-0x473, default teensy41_k112_24s
    build env, and document one physical K112 vs multiple CAN addresses.
2026-05-23 Accumulate burst 0x460/0x470 frames for single K112 24S decode.
    One K112 on X1 daisy chain repeats cell IDs within 0x4E0–0x500 bursts
    instead of using 0x461+; append all frame pairs into cells 1–24.
2026-05-23 Add 36S dual-BICM profile and document monitor-only limits.
    Refactor K112 decode for multiple CAN streams (0x460/470 + 0x461/471),
    add teensy41_k112_36s build, and clarify that balance/charge are not implemented.
2026-05-24 Decode second BICM via sparse 0x46D-0x47E and print block sums.
    Add BicmSparseMap for cells 25-36, 48S probe env, and pack voltage totals for bench check.
2026-08-30 Add K112 36S balance TX behind a compile-time flag.
    Pack 0x300/0x310 from the K112 6S+12S+6S burst plus sparse 12S map, not VoltBMSV2's 4-module loop. BMS_CAP_BALANCE_TX stays 0 so default builds remain monitor-only.
2026-09-02 Add Brusa NLG5 CAN and precharge/contactor sequence; flags stay 0.
    Brusa 0x618 TX / 0x610-0x614 RX on CAN2 pins 0/1 at 500 kbit, gated by BMS_CAP_CHARGE_TX. VoltBMSV2 OUT1/2/4 coil map with a real precharge SM, gated by BMS_CAP_CONTACTOR_DRV. Serial e/p/g dry-run. TELEMETRY_ONLY stays 1 on k112_36s.
2026-09-02 Retarget charger CAN from Brusa NLG5 to shop Elcon; flags stay 0.
    Elcon 0x1806E5F4 TX / 0x18FF50E5 RX on CAN2 pins 0/1 at 250 kbit 29-bit, gated by BMS_CAP_CHARGE_TX. Sticker E5 is the node ID, not voltage. Winding unread. Serial g prints 0x1806E5F4. Brusa Mode C left ifdef-dead. TELEMETRY_ONLY stays 1 on k112_36s.
2026-09-15 Harden print-only dry-runs and add Saturday bench flash guide.
    Make b/e/p/g unmistakably FLAG=0 / DRIVE=OFF / PRINT-ONLY; refuse runtime flag enables; document teensy41_k112_36s monitor bring-up.
2026-09-25 Add Kelly KLS8080 NPS CAN2 RX hooks (flag off) and ingest docs.
    Listen-only decode stub on shared Elcon CAN2 (0x0CF11E05 / 0x0CF11F05);
    BMS_CAP_KELLY_RX stays 0. Serial y prints counts+raw. Balance/charge/contactor
    caps unchanged at 0. Documents Serial4 hub UART vs CAN2 pin split.
2026-10-02 Emit STATUS_SCHEMA v1 JSON on Teensy Serial4 for ESP32 hub.
    HubStatus prints one schema-v1 line ~1 Hz on Serial4 (TX17/RX16 @ 115200).
    Live BMS cell/pack fields when stable; charge/drive/energy/aux stay null with
    wired:false while caps remain 0. USB gets a boot note and optional j one-shot.
    BmsApp skips pinMode on IN1/IN2 so Serial4 owns those pins. Docs updated.
    [BmsApp.cpp, HubStatus.cpp, HubStatus.h, main.cpp]
2026-10-14 Bench: teensy41_bench_30s env (1 BICM, 30 cells); auto-reinit CAN after 5 stuck keep-alives
2026-10-14 Bench: teensy41_bench_2x30s env (two 30S sections, one BICM each); per-section voltages, no pack total
2026-10-14 teensy41_factory_bus: up to 4 factory-strapped Volt BICMs on one CAN3 bus
    Tom's VoltBMS ID layout (M1 30ch, M2/M3 24ch, M4 18ch; 3 vs 4 cells/frame),
    compile-time channel->pack-cell map in include/FactoryCellMap.h (default M1 =
    cells 1-30, others unwired). Unwired = not-present ('-' / null), wired out of
    range (<0.5/>4.3 V) or stale >3 s = alarm, module with no frames = absent.
    Per-module voltages; pack total only if FACTORY_SERIES_STRING. TELEMETRY_ONLY=1,
    caps unchanged; other envs compile to identical objects.
2026-10-15 Safety fixes (all BMS_CAP_* stay 0, TELEMETRY_ONLY=1)
    - charge: default-refuse gate (fresh cells, stable, no alarm, TEMPS_VERIFIED);
    explicit Elcon stop on refusal; 4.10 V setpoint, 4.12 V latched fault
    - charge V from series-string cells (factory FACTORY_STRING_CELLS, K112 36),
    static_assert vs ELCON_MIN_V/MAX_V; bench maps => charge impossible
    - balance off on factory build: no verified factory balance map
    - K112 decode: 3 s stale timeout per cell
    - WDOG3 hardware watchdog ~2 s fed from loop; reset cause print; coil pins LOW first
    - factory decode: read-only 0x7E0+ temp raw + UNVERIFIED guesses
2026-10-15 LOW-LIVE diag, hub JSON fields, help page, docs, warning cleanup (flags unchanged)
    - Elcon range knobs documented; loud static_assert with fix instructions
    - per-module expected live cells (map-derived or FACTORY_EXPECT_LIVE_Mn),
    report-only LOW-LIVE line naming missing frames; example M2 12S map
    - JSON: modules live/expected/lowLive, temps raw (unverified), charge
    refuseReason/stringCells/faultLatched, lastReset
    - h/? key page, clearer refusal/unknown-key messages
    - fix printCellRange OOB on 30S build; drop unused-function warnings
    - docs/ASSUMPTIONS.md, docs/FACTORY_BUS.md, README links
2026-10-16 Elcon nameplate: HK-LF-144-46 100-202 V / 46 A; guard current <= 8 A for 120 V
2026-10-17 Factory map: decode every circuit on M1-M4 (96 slots), per-circuit reporting/empty status, 'M4 18S' labels, per-board V + cell count; flags unchanged (BMS_CAP 0, TELEMETRY_ONLY 1), charge still refus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
2026-10-17 Dual-string 36S 4P (roles A/B): CAN1 string 2, per-string monitor+faults, CAN2 link 0x6A0-0x6A8, EEPROM V/L/W settings, print-only balance plan + precharge retry SM; OUT5/6 moved to pins 2/3; flags u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
2026-10-17 docs: DUAL_STRING.md (pin map, link IDs, string config, serial commands, precharge)
2026-10-17 tools/cells.html: parse STRING/REMOTE lines and keep the M1-M4 board view
2026-10-19 Factory BICM bleed map (Tom VoltBMSV2 0x300/0x310 + 0x200 trigger) + print-only odd/even planner on 'b'; host test cross-checks Tom's encoder; TX still OFF (BMS_CAP 0, FACTORY_BALANCE_MAP_VERIFIED 0,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
2026-10-19 BmsCore: pure-logic BMS core (contactor SM, weld detect, charge taper/limit %, Kelly limit requests, DHAB S/44 current model, fault log) + BmsSim plant/scenarios + PC runner (13/13 pass). No firmware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
2026-10-19 Contactor SM on BmsCore (dual role A): NEG+precharge first (Tom VoltBMSV2 1192-1218), 95%/300ms/3s/2 retries/lockout, weld detect (bus live 2 s after open), latched faults clear only key-off, timesta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
2026-10-19 Elcon charge control via BmsCore: P<pct> charge limit in EEPROM (default 80% = 3.95 V, 100% = 4.10 V, 7.5 mV/%; 42S clamped to KELLY_MAX_V/42 = 4.00 V), linear taper over last 50 mV to 1 A (Tom curre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
2026-10-19 Kelly limits via digital outputs (KLS CAN is broadcast-only: 0x0CF11E05/0x0CF11F05, no command frames): OUT3 limp -> KLS low-speed input, OUT5 PWM derate = kellyPct (throttle hardware TBD), OUT6 rege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
2026-10-19 Current sense: factory Volt gen1 LEM DHAB S/44 on A0 (ch1 +-20 A) / A1 (ch2 -420..+230 A) + 5 V sense A11, 10k/18k dividers + 100 nF, 16x oversample + IIR, ratiometric BmsCore::dhabAmps, 'Z' zero-cal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
2026-10-19 Interactive simulator: tools/bms_sim.html (single file, opens from file://) runs BmsCore/BmsSim compiled to wasm32 (sim/wasm_api.cpp, embedded base64). Per-cell sliders for M2/M3 24S + M4 18S x2, sil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
2026-10-19 Layout fix (Adam 10/19 06:22): each string = 24S board + M4 c1-12 (0x46C+0x46D) = 36S; M4 top 0x46E empty by design (never fault, never planned, shown 'empty by design'). Full charge 4.10 V x 36 = 14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
2026-10-19 bms_sim.html: Tesla-style restyle (tabs Pack/Diagram/Faults/Scenarios, big numbers, touch targets, drag-to-set cell bars, mobile layout) + live SVG Diagram of the 36S 4P layout (2 Teensy, CAN3/CAN1 p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
2026-10-19 Diagram: Teensys = BMS brain, Volt BICM labels, Elcon DC-DC, ESP32 hub + Surface 3 (Linux) head unit; transceivers/ESP32/tablet owned; docs/COMPONENTS.md. No JK BMS. 13/13
2026-10-19 Diagram: UNVERIFIED badges (Kelly pinout, EV200 coils, DHAB pins/range, EV11 vs EV100, SN65HVD230 pins, wire gauges); DHAB mounting arrow + note; BACKLOG TODO for current sign. 13/13
2026-10-19 Current sensing: IVT-S 1000 A main sensor (not owned, 500k CAN unverified), DHAB pinout/role/saturation, Kelly peak 550 A, orange DHAB note fix, scenario 14 DHAB saturation vs IVT. 14/14
2026-10-19 Split-LEM layout: LEM A (S1+S2, Teensy A) + LEM B (S3+S4, Teensy B), I=A+B; IVT-S optional; sim pair-imbalance + sensor-fault checks; scenario 14 -> 275 A/LEM + 3 new LEM scenarios. 17/17
2026-10-20 Kelly cutback: Drive tab in bms_sim.html (allowance, limiter, regen, OUT3/OUT5/OUT6 print-only lines, low-cell/heat/current curves, sliders); BmsCore kellyWhy/regenWhy; serial y prints limiter; docs/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
2026-10-20 Bench bleed test build (teensy41_bench_bleed): 'bleed M C' bleeds ONE cell 10 s via Tom's 0x300/0x310 + 0x200 @200 ms; guards (>=3.70 V, all fresh, low cutoff, one at a time), x abort, auto all-off; 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
2026-10-20 SoC: header-only BmsCore::Soc coulomb counter on split-LEM sum (+ = discharge); full anchor from Core 'at charge limit' (P<100 tagged), restore hook, 2 s current loss -> unknown, low-cut drift flag, 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
2026-10-20 docs: Teryx main power path checklist
2026-10-20 docs: 2026-10-20 power-path facts (650/750 A trips, EV200 mains, A6T200 fuses, 36S, dual LEM); archive superseded notes
2026-10-20 docs: string fuses bought (4x A6T200)
2026-10-20 Current trip per Adam 2026-10-20: 650 A for 100 ms or 750 A instant (instantTripA) on LEM A+B, replaces 300 A/500 ms; 250 A Kelly discharge derate off (maxDischargeA 0). Scenarios 700 A + 800 A spike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
2026-10-20 Derates per Adam 2026-10-20: LEM imbalance |A-B| > 100 A for 1 s -> warn + cap (imbalancePct 50, PLACEHOLDER), cell sag 3.2 -> 3.0 V ('cell sag'); sag blocked by 3.30 V instant low cut (decision flag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
2026-10-20 sim: cluster tab, driver inputs + 12V loads (PROPOSED pins), settings tab (sim-only, localStorage), fault banner, header key, UX fixes; labels: A6T200 200 A owned, EV200HAANA x2 owned, AEV14012 prech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
2026-10-20 sim: SoC readout on Cluster tab from the real BmsCore::Soc on LEM A+B (wasm, sim only): full-charge anchor from Core 'at charge limit', 2 s current loss -> unknown, low-cut drift flag; 'unknown until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
2026-10-20 dash: standalone tools/dash.html + shared sim/dash.js (Digital/Analog/Minimal/Night, localStorage), source layer sim/HTTP/WS, '—' + amber when no source; Wh/mi instant + trip/last-5-mi, trip kWh used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
2026-10-20 dash: Tesla-style driver/passenger seat heater buttons (tap Off/Low/Med/High, hold off; PWM 33/66/100% PROPOSED, ~4-5 A/seat 10 A fuse ESTIMATE), 12 V load total in status (aux12v.loadA ESTIMATE); co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
2026-10-20 sim: drive-cycle mode on Cluster tab (sim/drive_cycles.js: Trail loop 125 s, Hard launches 5x, Long climb 10 min; SIM PROFILES, not logged data). Plays throttle/brake/gear into the driver-input model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
2026-10-21 faultlog: include/FaultLog.h power-off fault log (not wired): 48x20 B records at EEPROM 256..1215 (Settings at 0 untouched), seq+CRC16 per record (torn write skipped, blank=empty), set/clear edges w/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
2026-10-21 sim: Fault log card on Faults tab (real FaultLog.h in wasm on simulated 4284 B EEPROM; survives Reset, Power cycle, page reload via localStorage). Power cycle / Pull power mid-write (torn record skip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
2026-10-21 bms: relative cell sag (Adam 2026-10-21): cell-sag cut on weakest cell vs pack average (0.15->0.40 V below avg), whole-pack sag judged vs load (|I|>20 A: pack-avg taper 3.10->3.00 V 'pack sag', no lo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
2026-10-21 sim+bms: charge mode separate from key-on, vehicle model + brake regen, dash charging screen (Adam 2026-10-21)
    BmsCore: Inputs.plugIn wakes in CHARGE without key (B-, pre, B+, then chargerPath = AEV14012 charger
    branch); drive locked while plugged (kelly 0, no regen); key-on while plugged refused until key cycle;
    chargeStop; 0-10 C charge reduced to 50% (PLACEHOLDER); fault clear needs key off + unplugged.
    Firmware never sets plugIn/chargeStop (no pin) -> live behaviour unchanged. CREW REVIEW.
    sim/vehicle.js: ASSUMED vehicle params, throttle/brake%/grade, wheel speed, motor RPM, regen-first brake
    up to PROPOSED 60 A, fade < ~3 mph, lift-off regen option (off). Dash: regen A on power bar, cha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
2026-10-21 body I/O (Adam 2026-10-21): lights page, 2WD/4WD + progressive diff lock via 2 pot-feedback linear actuators (Mechanic plan; 2008 Teryx vacuum 4WD sourced), Pins:: reservations (seats 5/6, fan 7, pum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
2026-10-21 sim: cold-boot key-on scenario (mains close in 2.0 s, DRIVE, 54 mph at 60 % throttle) - 'contactors never closed' was the test clicking a hidden Key button, not a 983f263 regression; header key label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
2026-10-21 pins: lights 595s bit-banged (DATA 35, CLK 36, LATCH 32, /OE 34 pull-up; chief), MCP4131 shares DATA/CLK with CS 38, SPI1 dropped; BTS7960 shared EN 37 (10k pull-down), IS sense A12/A13 (26/27) via 1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
2026-10-21 dash: Tesla-style home (cluster + limiter + quick-button dock), full menu (11 sections), pinned collapsible SIMULATOR panel (sim + dash.html?src=sim only). Ledger/label specs: 16/32 = 2.0:1 SOURCED c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
2026-10-21 vehicle: 'gearbox' -> 'Diff ratio' 4.375:1 SOURCED (2008 Teryx owner's manual, 35/8, front = rear); total 16/32 x 4.375 = 8.75; tire 27in still ASSUMED. vehMigrate maps saved 'gearbox' to diffRatio. 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
2026-10-21 vehicle: tire 27 -> 24 in SOURCED (Adam, stock tires); saved 27 default migrates to 24. 8.75:1 on 24 in = 122.5 RPM/mph: 55 mph = 6740 RPM, above the PROPOSED 6000 RPM High cap -> top speed ~49 mph (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
2026-10-21 derates logged as events (Adam 2026-10-21): BmsCore DerateCode + debounced DERATE/cleared log (100 ms / 1 s PLACEHOLDER, reason changes logged), FaultLog kinds 4/5 with power %, derates capped 12/boo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
2026-10-21 dash: quick-button bar pinned on every page (moved out of the menu stage; usable over every section and split view) + Split view: two panes, each picks Cluster or any menu section (default left Clust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
2026-10-21 docs: zero-spare-pin fix PROPOSED (MCP23017 on Wire 18/19 replacing unused IN3/IN4 -> frees 32/34/40; alt Teensy B lights, alt pin 24); perfboard placement v3 (J9A/J9B, dual back to 78 wide; body 80x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
2026-10-21 thresholds adjustable over serial (Adam 2026-10-21): include/Thresholds.h 20 keys (trip/temps/sag/LEM imbalance/derate log), T list, T<key> <v>, T<key> -, TX; bounded, 650/750 A + temp cuts tighten-o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
2026-10-21 sim: BMS thresholds card (Settings tab) editable in the browser (Adam 2026-10-21): real include/Thresholds.h in wasm (sim_thr_set builds the serial T<key> <v> line -> handleLine; same bounds, tighten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
2026-10-21 BICM temps per string (UNVERIFIED decode, TEMPS_VERIFIED=0 kept): StringMon 0x7Ex, link 0x6A3 B->A, BmsCore fold S1-S4 + F_TEMP_STALE, 3 sim scenarios, top-speed vs pack V note [CREW REVIEW]
2026-10-21 Drive modes as PROPOSED pedal-map profiles (H/M/L/Snow/Mud/Sand/Kid): DriveProfile.h, reduce-only MCP4131 trim 1 kHz + 5 ms filter (THROTTLE_TRIM_ENABLE=0), Kid PIN, sim/dash selector + editor, tests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
2026-10-21 Link B->A 50 ms (timeout 200 ms kept, A->B 100 ms); drive profiles + mode + hashed Kid PIN in EEPROM with CRC (boot restores last mode, Kid stays Kid, PIN never printed); Kelly HPD doc. Clamp + pedal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
2026-10-21 Two-Teensy throttle clamp + cross-check (crew approved): HCT123 alive one-shots (A = MCP4131 CS, B = pin 7) AND 4066 series clamp, pedal A pin 40 / B pin 41 (stock 4WD switch -> B pin 40), A->B trim/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
2026-10-21 Clamp review fixes (A heartbeat pin 4 not CS + static_assert, 4066 on shared 5 V, Kelly pull-down 100k + bench curve step); park detection (ParkState.h, A/B pin 18 dual contacts, Foot_SW NC hardware 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
2026-10-21 Wiring aid tools/wiring.html: overview + 8 sub-schematics (clamp, enables, park, precharge/MSD, e-stop, BMS/CAN V2, Kelly Low cap, 12 V), pan/zoom, print, netlists, PROPOSED colour code, conflicts li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
2026-10-21 Crew review of b629bcf: park contacts on direct pin 32 A/B (A needs BODY_IO_EXPANDER=1; 18/19 = MCP23017 I2C) + clash asserts; Brake_AN DEFERRED (default Kelly switch regen at fixed BRK_SW level); Lo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
2026-10-21 Crew correction to f1c51a9: LEM A/B disagreement > 60 A (was 100) = SOFT 50 % derate, never the Low cap; hard Low cap = one LEM reading nothing or out of range (> 450 A PROPOSED); sim LEM-B-lost togg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
2026-10-22 Docs: reconcile heat derate 50/55 °C and relative cell sag in TERYX_MAIN_POWER_PATH.md; BACKLOG
2026-10-22 BACKLOG: LEM rail and self-test detail
2026-10-22 Checklist page: tools/build_checklist.py + checklist.html from BACKLOG + shop log; 8 VCU safety items in BACKLOG; Checklist links in sim/dash/wiring headers
2026-10-22 BACKLOG: brake-overrides-throttle REQUIRED; dual-track pedal A=track 1, B=track 2; regen checklist
2026-10-22 BACKLOG: A6T200 final (close fuse item, A6T150 superseded); Kelly CAN timeout + cooling REQUIRED; creep/hill hold -> Later; dual Hall pedal on buy list; regen checklist
2026-10-22 BACKLOG: Hall pedal half-scale track spec
2026-10-22 Build label: tools/BUILD_NUMBER + tools/publish_gist.sh; label in sim/dash/wiring/checklist headers + About; tools/build_wiring.py
2026-10-22 Build 2 fixes: grade physics (overspeed regen + 6000 RPM guard, tests), visible park set/release, brake-to-wake + optional PIN-to-drive (PROPOSED), false CELL-COUNT/BAD from stuck cell drag fixed (+t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
2026-10-22 BACKLOG: brake-to-wake / PIN-to-drive items above Later (picked up by the checklist on the next publish)
2026-10-22 BACKLOG: Hall pedal spec (d678dd1) was under Later by append order; moved above so the checklist shows it
2026-10-22 Fault log wired into firmware (role A): EEPROM store, fault + derate edges each loop, f print / FCLEAR erase; no pins. 12/12 envs, 31/31 scenarios
2026-10-22 Build 3: wiring install guide (mount/wire/torque/test per sub-page), cut sheets + Parts panel (links verified, no copies: no redistribution licence), CRITICAL/LATER tiers (default Critical only) on c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
2026-10-22 Hub frame: optional faultLog summary (count, boot, last record) from the saved fault log; read-only. 12/12 envs, 31/31 scenarios
2026-10-22 Build 4: brake-to-wake feedback + refusal reasons (dashToast was undefined, refusals silent), Kid enter no PIN / leave via modal PIN pad, phone-as-key drive-settings lock (PROPOSED, sim toggle), synt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
2026-10-22 SoC wired into firmware (role A, read-only): SocRun runs SocEstimator on CurrentSense + Core charge-limit anchor; 'p' prints SOC; hub socPct from SocRun (null: LEM A only = half bank, capAh UNVERIFIE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
2026-10-22 Checklist: chief's Path to first drive gates 0-4, CRITICAL trimmed to 20 tagged items (gates, Mechanic shop order 1-8 + measurements, Sparky fuses/MSD/LEM offset/leak detect/boots, DC-DC isolation); 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
2026-10-22 E-stop final spec: XB4/XB5 + 3x ZBE102 direct (block 1 EV200 coils, block 2 precharge + KSI, block 3 Teensy B latch); EstopLatch.h + host test 7/7 (not wired, flags unchanged); Volt MSD removed, serv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
2026-10-22 E-stop block 1 SOURCED/OK (chief: 0.13 A measured hold per EV200 -> 0.26 A break < 0.5 A @24 V; inrush carried < 10 A Ith); block 2 pending KSI; BOM: XB4BS8442 has 1 NC, buy 2 ZBE102
2026-10-22 Dash: fit-to-screen viewport (1280 landscape / 820 portrait design width on small screens), pinch-zoom + pan allowed, body scrollable, portrait dock wraps seat buttons
2026-10-22 Shared sticky top tab bar (Sim/Dash/Wiring/Checklist + build label) on all 4 pages; Sim<->Dash open in named tabs so sim keeps running; dash bar outside scaled area, thumb-sized via --tnk
2026-10-22 Dead-LEM detection logic: include/LemHealth.h (RAIL/RANGE/AGREE/ZERO, latched, PROPOSED thresholds) + host test 18/18 + docs/LEM_HEALTH.md; not wired, CURRENT_SENSE_ENABLE 0
2026-10-22 Kelly CAN link watchdog logic: include/KellyLink.h (NEVER-SEEN/LOST, Low cap, 1 s recover, PROPOSED) + host test 18/18 + docs/KELLY_LINK.md; not wired, BMS_CAP_KELLY_RX 0
2026-10-22 BMS settings vs SimpBMS/ENNOID/LG (Build 10): derateTempC 40, derateLowV 0.20 (3.50->3.30 V), lemTripA 400 per LEM (PROPOSED), THR2 23 keys (EEPROM 1216-1317, DriveStore moves to 1318); docs/BMS_SETT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
2026-10-22 PINMAP.yaml single source: generated PINMAP.md/CONNECTIONS.md, test_pinmap (994 checks), wire numbers on every wiring line, gateway+aux pages, connection checklist by build step
2026-10-22 PINMAP crew decisions 2026-10-22: IN1->34 (IN2-4 retired, off Serial4/I2C), 4/40 vs 7/41 intended, e-stop 3 -> B9, 12V alarm -> B26, AEV14012 precharge, 1/0 string leads + 3/0 mains, SN65 Gate 3 buy,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
2026-10-22 Chief review #1: delete teensy41_bms env (blind precharge timer); test_review_fixes.py guards it
2026-10-22 Chief review fix #3: coil/PWM drivers LOW and digipot bus idle (CS high) as the first statement of setup(); wiper 0 before EEPROM/Serial; host test both roles
2026-10-22 Build check: all 11 PlatformIO envs compile (teensy 6.0.0); sizes in docs/BUILD_CHECK.md
2026-10-22 safeOutputsFirst: OUT9/OUT10 (pins 7/8 fan relay, pump) latched LOW at startup (chief approved); host test extended
2026-10-22 Chief review CRITICAL #1: single-string precharge never closes Main+ on a timer; PrechargeGate (bus within 95% of valid pack) else precharge-fail -> RetryWait/Lockout; host tests; all 11 pio envs bui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
2026-10-22 PINMAP (Sparky): charge plug-in detect A:33 -> CRITICAL wire S41; KEY-ON on IN1 pin 34 A (S42) + B mirror (S43), CRITICAL, PROPOSED; BACKLOG + checklist. Firmware read later.
2026-10-22 PINMAP: S42/S43 key-on source = stock key switch output (own fuse TBD, colour UNVERIFIED, backprobe step); S41 = NACS proximity; S44 B:33 plug mirror; plug blocks drive both boards; precharge resisto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
2026-10-22 PINMAP: analog-pin audit (none free on A); proximity plug-detect via PROPOSED 2.5 V LM393 per board into A:33/B:33 (buy list, needs approval); key-on fuse 1 A; bench plug/unplug + open-wire step
2026-10-23 Chief #3: LEM A/B validity fails closed (default false in BmsCore Inputs, explicit false in ContactorSeq until LemHealth wired); 3 review checks
2026-10-23 sim/dash: plain-words block reasons pop-up, brake wake, phone key, PIN to Drive (PROPOSED), Kid bypass, e-stop sim input; UI checks
2026-10-23 dash: in-page sim engine for iPhone (auto when no Sim tab answers, ?engine=page|tab|auto), touch PIN pad via engine, tap-to-explain warning lights; touch/safe-area/44px fixes on all pages; scripts/te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
2026-10-23 PINMAP/wiring: ONE LM393 plug-detect for both boards (Adam t284): single 330R/2.7k network + 10k/20k divider to both halves, outputs pulled up to each board's own 3.3 V into A:33/B:33, VCC shared 5 V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
2026-10-23 docs: DASH.md block reasons, brake wake, phone key, PIN to Drive, iPhone in-page engine (?engine=); ESTOP.md pop-up note
2026-10-23 sim: per-mode reverse cap (PROPOSED, Adam 2026-10-22): 15 mph H/M/Snow/Mud/Sand, 10 mph L/Kid; Kid->R keeps Kid rules without PIN; dash shows reverse cap
2026-10-23 tests: reverse cap per mode, Kelly 1860/1200 RPM caps, gentle reverse launch, Kid->R without PIN
2026-10-23 sim: Kid hardware backstop = Kelly LowSpeed Fwd 30% ≈ 15 mph / Rev 20% ≈ 10 mph (DECIDED Adam 2026-10-23); software Kid cap stays 10 mph; migrate saved 1225 RPM; tests [re-commit: Build 17 local comm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
2026-10-23 docs: DRIVE_MODES LowSpeed DECIDED (Adam 2026-10-23): Fwd 30% ≈ 15 mph, Rev 20% ≈ 10 mph; Teensys-dead Kid backstop stated; conflict flag removed [re-commit]
2026-10-23 security: PIN to Drive evaluated live (!pinToDrive || phone nearby now || PIN this key cycle), never latched; every action opens the PIN pad while locked; phone-leaves warn/lock at stop or Park; 5 wr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
2026-10-23 move: kelly-settings -> docs/KELLY_SETTINGS.md (Sparky's 168 V/550 A edits kept: #7 158 V, #10 100%, #11 25/49/75%; motor sin/cos SOURCED, #60 UNVERIFIED for Adam's programming check, motor nameplate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
2026-10-23 tiers/BACKLOG: every first-drive item CRITICAL (57 CRITICAL / 79 LATER); Kelly B+ precharge/weld + bench gate (room DECIDED); coil gate-drive 3.3 V bench gate; Kelly programming check replaces namepl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
2026-10-23 pins/HV/docs: MOTOR_FAN=MCP23017 b14, BUZZER=b13 (LATER, PROPOSED); A:24 reserved spare (Kelly CAN B+ precharge, room DECIDED); AEV14012 coil 0.35 A @12 V SOURCED; F-ELC Mersen A6T60 60 A on 6 AWG; D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
2026-10-23 sim Kelly card: #11 battery current 25/49/75% (138/270/413 A), 550 A = controller rating; speed cap computed live from vehicle.js (24" tires, ~49 mph) — pre-Build 19 fix
2026-10-23 parts: canonical PARTS list moves into the repo (docs/PARTS.yaml + PARTS.md, generated by teryx/tools_parts/build_parts.py; /workspace/teryx/PARTS.yaml is now a symlink here). Includes cd_flyback DEC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
2026-10-23 parts: explicit part ids everywhere, no text matching
    - wiring_data.js: 113 nodes carry {part:id|[ids]}; click -> window.PARTS (parts.js) + cut sheet by part id
    - precharge page: new drv coil-driver node + AEV14012/EV200 coil nodes (S01-S03 lines); D-PRE 1N4007 at the AEV14012 coil, EV200 no external diode (Sparky DECIDED 05:41)
    - PINMAP.yaml: connectors/fuses get part: (TB-5V/TB-GND null = gap); S01-S03 dia keys on the new coil lines; HV across/kel-evn lines relabelled H08/H10 (were S02/S03)
    - gen.py: PART dict, drawio blocks as UserObject part=...; stale EV11 CONFLICT label removed
    - cutsheets.json keyed by part id (+also_parts, old regex kept as kw for check_cutsheets)
    - PINMAP.md Connect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
2026-10-23 scripts/check_parts.py: fail on a dangling part id in either direction
    Forward: every part: tag (wiring_data.js nodes, gen.py PART, PINMAP connectors/fuses, cutsheets id/also_parts)
    must exist in docs/PARTS.yaml and be listed in that part's diagram_ids. Reverse: every diagram_id exists and
    carries the part; pinmap_refs, parent/children, id-shaped superseded_by resolve; tools/parts.json == PARTS.yaml.
    Warns on tags to superseded parts and part: null gaps; reports conflict count. Wired into run_all_tests.sh.
2026-10-23 docs: point at docs/PARTS.yaml; diagram/components.json retired
    The out-of-repo /workspace/teryx/diagram/components.json and the drifted schematic gen.py copies
    (/workspace/teryx/schematic/gen.py, .cash_build/gen.py) were moved to /workspace/teryx/_retired/ (not deleted).
2026-10-23 docs/guided_install/coil_driver.md: coil-driver build guide into the repo
    D-PRE 1N4007 at the AEV14012 coil (band to +12 V), EV200 coils no external diode (Sparky DECIDED 05:41).
    Part ids reference docs/PARTS.yaml.
2026-10-23 flyback: S01-S03 rows and BACKLOG carry Sparky's DECIDED rule
    Checked: PARTS cd_flyback is DECIDED (1N4007 at the AEV14012 coil, cathode to +12 V, no zener), EV200s no
    external diode, repo coil_driver.md has no open-for-Sparky flag. Missing pieces fixed: PINMAP S01/S02/S03
    'to' now state the diode rule per channel; BACKLOG guided-install item no longer says 'flyback diodes'.
2026-10-23 hv_sense: schem:hvs and wiring:precharge/hvs are the A:24 reserved spare, not fitted (tag teensy)
    check_parts now fails when a drawn schematic block is missing from gen.py PART
    (guards against tags silently dropping, as nearly happened to lfan/lbuz here).
2026-10-23 parts: lv_tb terminal blocks for PINMAP TB-5V / TB-GND (clears the 2 GAP warnings)
    New part via build_parts.py (UNVERIFIED, model UNKNOWN); schem:gnd tagged lv_tb.
    check_parts: 0 errors, 0 warnings.
2026-10-23 cutsheets: real Infineon IRLB8721PbF datasheet as cutsheet:irlb8721 (cd_fet); IRLB3813 sheet kept as cutsheet:irlb3813 (coil_fet)
    SOURCED: infineon.com IRLB8721 datasheet, curl 200 + part number on p.1, sha256 8a313aecdd1e7725 (2026-10-23).
    The old 'irlb' sheet was the IRLB3813 document keyed to the coil-driver FET.
2026-10-23 Perf-board designer: tools/perfboard.html (0.1 in grid, drag/rotate/snap, wires, localStorage + Export JSON, PARTS/net check), coil_driver layout PROPOSED, check_boards.py, wiring drv node -> layout,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
2026-10-23 bms_master perf-board layout (PROPOSED, Build 21): 2x Teensy 4.1, 6x SN65, CAN3 A<->B link, buck+fuse, LEM dividers, clamp, LM339, MCP23017, J-DRV S01-S03, J-ESP; one star bar; PathFinder router; PAR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
2026-10-23 Build 22: perfboard designer — window/crossing select, stretch, attached wire ends + Detach, Auto-size
2026-10-23 Build 24: apply bms_master answers 06:57 (chief + Sparky DECIDED)
    - PINMAP: LM339 re-pin (S41/S44/S46-S49), release detect A:2/B:35 (S51/S52, ref S53),
    separate star wires G09-G12, coil return G08, TB-GND = LV star, SN65 silkscreen rule,
    S02 'cathode to coil +', MCP23017 LATER footprint only
    - bms_master: release 1k + 10k + 100 nF to TA.2/TB.35, J-REL removed, own star holes for
    LEM A/B, pedal, Kelly RTN, RRST 10k, U6 footprint only; rerouted (star col 18)
    - coil_driver: doubled 20 AWG on-board return, J-GND 5.08 mm >=10 A screw terminal, G08
    - PARTS (build_parts.py), BACKLOG LM393->LM339, wiring plug page, BENCH_POWER -> docs/BENCH.md
    - layout: COIL-RET = G08; LEM/KELLY/PEDAL runs car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
2026-10-23 PINMAP/PARTS: Sparky 07:34 DECIDED — F-MAIN 150 A at DC-DC out, P01/P02 2 AWG, F-BATT + battery wires (P13/P14/G13 PROPOSED), DHAB GND pin C (G09/G10)
    - PINMAP: F-MAIN 150 A MIDI/MEGA at the DC-DC output (bus end); P01/P02 awg 2; new F-BATT fuse row;
    P13 batt+ -> F-BATT, P14 F-BATT -> 12 V bus +, G13 batt- -> TB-GND/chassis (2 AWG, PROPOSED ids; P10-P12 taken);
    G09/G10 = LEM DHAB pin C (SOURCED via Sparky), GM BK/GY ckt 2963 -> master star bar.
    - build_parts.py: fuse_main specs closed; new fuse_batt (holder + P/N TBD); lv_battery refs F-BATT/P13/P14/G13.
    - Layout: F-MAIN moved to the DC-DC out, F-BATT block + P13/P14/G13 runs; rules fmain_max_in (PROPOSED 7 in from DC-DC out),
    fbatt_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
2026-10-23 Build 25: perf-board designer (t312) — selection filter, collision reject + under-body flags, board edges/corners, row/col headers insert/delete, undo/redo, Install mode (layout steps; bms_master ord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
2026-10-23 SocStore: SoC count survives power-off (EEPROM 1469..1514, ping-pong + CRC, fail closed), not wired; 16 host checks
2026-10-23 layout: merge Adam's 2026-10-23 block moves; front motor + chain + driveshaft keepouts; reroute
    - Take only x/y of Adam's moved blocks (S1-S4, motor, kelly, dcdc, charger, inlet);
    keep current text/labels and fbatt/P13/P14/G13 (his export predates them).
    - fmain moved to the new DC-DC out (P01 1.5 in; F-MAIN 1.5 in, F-BATT 1.0 in).
    - chain keepout moved from the rear (x92-106) to the motor rear face, 6x10 in
    PROPOSED (Adam SOURCED: chain is motor sprocket -> driveshaft, up front).
    - new driveshaft (solid, spinning) keepout from the chain to x95, y27-31 PROPOSED:
    cross at ~90 deg only, clamp/standoff >= 2 in.
    - Manhattan reroute of all runs touching moved blocks; 0 HV/LV loom/crossing w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
2026-10-23 Build 26: layout layers (z), sealed HV housings, packs as 3 x 12S cube modules
    - z layer field: Kelly high, motor mid, chain + driveshaft keep-outs low (Adam 2026-10-23).
    Different layers -> INFO, same layer still warns; new same-layer block overlap rule;
    stacked blocks drawn semi-transparent with 'stacked above ...' tag.
    - sealed:true (DECIDED Adam 2026-10-23) on kelly, dcdc, hv_box and the pack modules:
    sealed HV in the cab and HV runs in the cab (conduit/loom between sealed housings) -> INFO.
    - Each 36S string = 3 x 12S modules (docs/PACK_LAYOUT.md example; allocation not decided),
    12 in cube placeholders (ASSUMED placeholder, Adam 12:26). One per seat; the rest on the
    centrelin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
2026-10-23 SocRun: SoC count saved + restored via SocStore (fail closed, forced save on DRIVE/CHARGE->IDLE); 14 host checks
2026-10-24 SocRun: count LEM A + LEM B (link 0x6A5), both valid or current-lost (fail closed); 17 host checks
2026-10-24 Pages: absolute githack nav links (per-file sha broke relative links), dash sim quick panel by default, wiring sub-tab pills no-shrink, damped wheel zoom
2026-10-24 Pages: keep relative nav links (same gist revision url), publish prints revision githack links
2026-10-24 Pages: wheel zoom ~6% per mouse notch (clamped, deltaMode-aware, trackpad pinch via ctrlKey)
